ItzXyers/Rocketry/Ejection System T5/Models/check_report_v4.txt

== T5 v4 spring-piston ejector check report ==
Stations (module z -> Phoenix station): bulkhead bottom z -3.5 -> 174.5, aft face z 0 -> 171.0, flange top z 14 -> 157.0, piston top cocked z 61.0 -> 110.0, RBF pin z 64.5 -> 106.5
PASS all printed solids and hardware valid
PASS rod/base overlap is only the M5 self-tap engagement (6.6 mm3, z 9.7-11.0)
PASS interference, flight cocked (pin in): none
PASS interference, flight fired: none
PASS interference, bench cocking (stand, tool held by lock pin): none
PASS interference, bench cocked (stand, RBF pin): none
PASS install tool slides through piston notches at the fired position: yes
PASS tool prongs reach the flange key notches when the face is on the cocked piston (31.4 mm3 in notches)
PASS piston running radius 19.25 <= 19.50
PASS static radii: bulkhead 19.85, flange 18.25 <= 19.85
PASS piston skirt L/D = 0.47 (>= 0.45, anti-cocking; v4 lowered from 0.5 for the 10 mm skirt)
PASS spring length cocked 45.00 (= 45), end of stroke 85.00 (<= free 85)
NOTE spring guidance: the M5 rod does NOT guide a 15.5 OD spring (its ID is far larger than 5); only the seats capture the ends (3 + 3 mm). L/D free 5.5, cocked 2.9: stable for ground ends clamped in seats below ~5.2 free. Bench-check for bowing; a printed guide sleeve over the rod is the fix.
PASS rod top clears piston underside when cocked by 3.5 mm
Stroke stop: Kevlar tether, taut at 41.5 mm (stroke 40 + 1.5). Cut to length on the bench (README).
PASS line loop path (base holes, piston through-holes, face groove) is open: clear
PASS all four line holes are straight Ø3.0 through-holes (a stiff leader goes straight through each): yes
PASS face groove 1.5 deep x 3.0 wide joins the two piston holes; the line stays 1.00 mm below the face (RBF pin / tool face never touch it): open
PASS line to spring coils (spring OD 15.5), line against the inboard hole edge: 2.25 mm (>= 2.0)
PASS line to spring coils (spring OD 16.0), line against the inboard hole edge: 2.00 mm (>= 2.0)
PASS spring pocket in the base: Ø16.5 x 3.0 deep (piston: Ø16.5 x 3.0); floor over the M5 head pocket 1.30 mm (>= 1.2)
PASS plastic web between line hole (incl. 0.6 edge round) and spring seat/counterbore: 1.15 mm (>= 1.0)
PASS coil on run +1's straight part (hole -> knot), 5.8 mm from the hole, ends clear of the hole mouth and the knot: the nichrome carries no line load
PASS chamber run +1 clears the M2 heads by 0.90 mm (>= 0.5, nearest nterm2)
PASS chamber run -1 clears the M2 heads by 5.26 mm (>= 0.5, nearest nterm2)
PASS coil (OD 2.0 x 5.0 along the line) to nearest plastic: 2.10 mm (>= 2.0)
PASS coil to nearest steel: 1.07 mm (>= 0.5, nearest nterm2)
PASS coil to the nichrome terminal heads: 1.11, 1.07 mm (>= 1.0: a turn touching a head would short part of the coil)
PASS pole 1 to pole 2 (terminal heads + 0.5 mm wrap allowance, tails): 4.21 mm (>= 2.0, the full burn voltage sits across it)
PASS M2 x 6 nterm1: pilot open 0.5 mm past the tip (z 12.0), so the head seats (0.000 mm3 in the way)
PASS M2 x 6 nterm2: pilot open 0.5 mm past the tip (z 12.0), so the head seats (0.000 mm3 in the way)
PASS M2 x 8 eterm1: pilot open 0.5 mm past the tip (z 10.0), so the head seats (0.000 mm3 in the way)
PASS M2 x 8 eterm2: pilot open 0.5 mm past the tip (z 10.0), so the head seats (0.000 mm3 in the way)
PASS nichrome tail 1 (1.6 mm, from 0.5 mm past its head) to plastic 1.81 mm (>= 1.0), to other steel 3.63 mm (>= 0.5, nearest rod)
PASS nichrome tail 2 (1.3 mm, from 0.5 mm past its head) to plastic 1.28 mm (>= 1.0), to other steel 3.74 mm (>= 0.5, nearest rod)
Coil centre (7.40, -4.10); pocket 9.2 x 6.2 mm, 2.8 mm deep into the ceiling; nichrome terminals at (6.55, 0.71) and (6.20, -9.55)
PASS nichrome terminal heads bear on solid ceiling beside the pocket (62%, 64%; >= 50%)
PASS cut at the coil: the free end pays out 41.3 mm more than a full stroke needs before it even leaves the piston (>= 10)
PASS knot room at (0.0, -11.5): to M2 heads 3.10 mm (>= 0.5), to the coil 6.47 mm (>= 2.0), to the chamber wall 0.70 mm (>= 0.3)
Line tension (each leg of the loop): 26.4 N at F_max 52.7 N, 105 N at 4x proof. A knot keeps ~50% of line strength, so the line must break at >= 211 N (21 kg): 0.4-0.5 mm Dyneema; 0.3 mm only if 7.3 measures F_max < ~30 N.
PASS all M2 heads inside the chamber wall
PASS M2 heads clear of each other (>= 0.3 mm): yes
PASS M2 heads clear of the line holes: yes
PASS e-bay terminal heads end at z 0.0 (flush with the aft face, station 171.0), nothing aft of them (0.000 mm3): lugs go on from the e-bay side
PASS e-bay terminal heads bear fully on their pillars (100%, 100%)
PASS chamber open to r 6.25 round the axis (8 mm socket reaches the M5 head): 0.000 mm3 in the way
PASS tether knot room: pillars 3.0 mm from the tether hole edge (>= 2.0)
PASS tether hole open through base and piston
PASS RBF pin clears the cocked piston by 1.50 mm and sits in its path (blocks within 1.5 mm of travel)
PASS after the line takes load (piston +0.7 mm) the RBF pin still goes in with 0.80 mm clear (>= 0.5)
PASS bench lock pin holds the tool face at 0.04 mm from the nominal cocked piston top (|d| <= 0.2)
PASS harness passes the piston flat with 2.35 mm radial gap even 25 deg off the +/-y groove (>= harness 1.5 + 0.3)
PASS RBF pin bending at proof (211 N, span 40): 419 MPa vs 1000 MPa yield (need 1.5x)
PASS T1 coupon engagement at mid-flank: male 35%, female 49%, both 0.0%
PASS T1 base/bulkhead engagement at mid-flank: male 35%, female 49%, both 0.0%
PASS T1 base/stand engagement at mid-flank: male 35%, female 49%, both 0.0%
PASS nothing crosses the e-bay plane: aft-most part at station 174.5 (e-bay / bench joint at 181)
NOTE stack bulkhead-bottom -> piston top = 64.5 mm vs DESIGN 7.8 budget 61 mm (8 bulkhead + 45 spring + 8 piston): +3.5 mm
Masses (PETG solid): base 9.9 g, piston 11.7 g, flight bulkhead 6.8 g; + M5x40 bolt ~7 g, spring (15.5 OD, weigh it), 4x M2 ~1 g
RESULT: ALL PASS (0 FAIL)
