ItzXyers/Rocketry/Ejection System T4/Models/check_report.txt

== T4 CO2 ejector check report ==
Key stations (module frame, z=0 aft face): cartridge base 11.00, seat 63.77, tip 77.00, stop 80.00, cap underside 125.00, cap top 137.00
Needle protrusion below striker face: 5.50 mm (set with the M3 set screw)
PASS all 25 solids valid
PASS interference, stroke 4, cocked: none
PASS interference, stroke 4, fired: none
PASS needle penetrates cartridge at end of stroke (overlap 5.53 mm3)
PASS stroke 4: free run before contact 1.5 mm, cross-hole u=52.50
PASS interference, stroke 7, cocked: none
PASS interference, stroke 7, fired: none
PASS stroke 7: free run before contact 4.5 mm, cross-hole u=49.50
PASS interference, stroke 10, cocked: none
PASS interference, stroke 10, fired: none
PASS stroke 10: free run before contact 7.5 mm, cross-hole u=46.50
PASS thread coupon T1 male/female mesh without overlap (0.000 mm3)
PASS thread coupon T2 male/female mesh without overlap (0.000 mm3)
PASS thread coupon T3 male/female mesh without overlap (0.000 mm3)
PASS T1 coupon thread engagement at mid-flank: male 35%, female 49%, both 0.0%
PASS T2 coupon thread engagement at mid-flank: male 35%, female 45%, both 0.0%
PASS T3 coupon thread engagement at mid-flank: male 35%, female 45%, both 0.0%
PASS T1 body/base thread engagement at mid-flank: male 35%, female 48%, both 0.0%
PASS T1 body/bulkhead thread engagement at mid-flank: male 35%, female 48%, both 0.0%
PASS T2 body/head thread engagement at mid-flank: male 35%, female 46%, both 0.0%
PASS T3 cap/head thread engagement at mid-flank: male 35%, female 45%, both 0.0%
PASS install_tool clears module: yes
PASS cocking_tool clears module: yes
PASS flight bulkhead clears module: yes
PASS install tool fits airframe bore (OD 38.6 < ID 40.0)
PASS module max OD 36.5 fits airframe ID 40.0
PASS install-tool tabs reach into flange notches (tab volume below flange top 33.6 mm3)
PASS line clamp at x=+9.2 has solid material under its washer (98% of annulus)
PASS line clamp at x=-9.2 has solid material under its washer (98% of annulus)
PASS jam nut clears cartridge tip at end of stroke (1.22 mm)
PASS hex-key path from tail top to needle socket is open
PASS release relief slots open through the cap
PASS tail passage through cap is open
PASS needle path head plenum open
PASS cross-hole for stroke 4 is through
PASS cross-hole for stroke 7 is through
PASS cross-hole for stroke 10 is through
PASS vent port open from plenum to outside
PASS cartridge seats on head seat edge (gap 0.009 mm, modelled 0.02 low)
PASS cartridge body radial clearance 0.40 mm
PASS vent area 245 mm2 = 35x a 3.0 mm pierce hole (need >= 20x)
Spring envelope: OD <= 16.0, ID >= 6.6, cavity fired 35.0, cocked 31@s=4, 28@s=7, 25@s=10 (minus spacers/washers)
PASS spring bore (16.6) > spring OD max (16.0) + 0.4
PASS body wall at T2 root = 3.10 mm
PASS head skirt over T2 tap = 2.20 mm
PASS head wall over T3 tap = 2.20 mm
PASS head wall at striker bore = 4.70 mm
PASS body floor under nut = 2.80 mm
PASS tail web between cross-holes = 1.40 mm
Printed masses (PETG, solid): body 23.6 g, head 36.8 g, cap 5.2 g, striker 3.9 g
Module length (aft face -> cap top 137.0, -> tail top cocked 149.0)
Module loaded mass est: printed 69 g + cartridge 28 g + hardware ~6 g + spring ~3-8 g = ~108 g
Cocking screw: M3 x 24 (or longer)
RESULT: ALL PASS (0 FAIL)
