ItzXyers/Rocketry/Electronics/Avionics/avionics_bay_schematic_phoenix40.html

Phoenix ABS 40-43 · Avionics bay

# E-bay schematic, rev G

Date

2026-10-19

Matches

harness as soldered 2026-10-19 · D9aft v11

Firmware

0.2.3+ (internal-flash log, no SW2, no deploy)

Replaces

avionics_wiring.md (2026-08-08)

This is every electrical part on the e-bay harness as soldered on 2026-10-19, and how it connects. The bay is a logging altimeter and fires nothing, because D9aft deploys on the motor ejection charge (no burn wire). There is no power switch: the bay is on whenever the battery's JST-PH lead (J1) is plugged in. The log is written to the Nano's internal flash, so there is no microSD reader, and the Wi-Fi AP comes up at boot, so there is no SW2 button. A divider on A7 reads the battery voltage (only while Wi-Fi is off: A7 is on ADC2, which the radio shares), and the firmware logs it, prints it, and shows it on the pad's Wi-Fi page. The battery charges off the vehicle through J1. Numbered markers point to seven open items, listed below the drawing.

battery and 5 V power path signal / local supply Qwiic cable (4 wires) through the airframe wall resistor with its real 5-band colours, read from the bunched end 1open item, see below

Every ground symbol is the same net: board GND is the battery's negative lead. Nothing switches the battery: the bay runs whenever J1 is plugged in, and the R11/R12 divider alone draws about 0.2 mA, so unplug J1 for transport and storage. The 3V3 rail comes from the Nano's on-board regulator and feeds U4 and U5.

## Open items before first power-up

1. 1

### Buzzer type must match the firmware

  buzzer.cpp holds D9 high or low with no tone generation, so it needs an active buzzer that oscillates on its own. The sled v7/v8 notes describe the module as "KY-006-style", and a KY-006 is usually a passive transducer. Driven with DC it only clicks.
  Check: put 5 V across the module's + and − pins. A steady tone means it is active and fine. A single click means it is passive. In that case, swap in an active module or change buzzer.cpp to drive a 2–4 kHz LEDC tone on D9. If you go the tone route with a plain piezo, also fit a ~1 kΩ resistor across BZ1 (+ to −): otherwise the piezo can't discharge when Q1 turns off, and it plays quietly. Confirm the module pinout too: some KY boards leave the middle pin unconnected.
2. 2

### VIN is 1 V under the Nano's spec

  Carried over as BOM item O1. U2's fixed 5 V feeds VIN, which is rated 6–21 V. Community testing says it runs, but there is no margin. C1 covers the brownout case the August notes required before using the Wi-Fi interface near a loaded vehicle, and with the AP up from every boot that case is now routine.
  If the board resets on flash writes or Wi-Fi bursts, suspect this before the sensor wiring.
3. 3

### The BMP388's first reading after power-up is stale

  On the real board (2026-10-19 bench), the first pressure read after sensors_init() came back as 77 945 Pa and every later read was about 103 556 Pa. Averaged into the 50-sample pad baseline, one such value would shift AGL altitude by about 40 m. In the flight firmware the boot self-test happens to take that first read before the baseline is captured, so it is masked today, but nothing guarantees it.
  In sensors.cpp: discard one read at the start of sensors_capturePadBaseline(), and make sensors_selfTest() fail on a pressure outside about 30–110 kPa. D6 (the old deploy pin) is free; the deploy code was removed in firmware 0.2.3.
4. 4

### Calibrate the battery reading once

  The ESP32-S3 ADC is factory-calibrated, but 1 % resistors and the ADC's gain error can still leave the reading 1–3 % off. That is about 0.1 V, or 10–20 % on the charge estimate near the flat middle of a LiPo curve.
  Flash chips_bench, run BATT, and measure the cell with a multimeter at about 3.9 V. Set BATT_CAL_GAIN in config.h to meter volts ÷ reported volts. The percentage comes from a generic LiPo curve, so trust the voltage more. BATT_LOW_V (3.70 V, about 12 %) flags LOW in the log, on serial and on the pad page. It never touches flight logic.
5. 5

### Check that C1 fits its slot

  Sled v8 had a slot for a ⌀8 × 12 mm capacitor (14 mm with leads), standing in the aft deck. A 470 µF 16 V can is usually ⌀8 × 11.5 mm, but some makers use ⌀10 × 12.5 mm, which won't fit.
  Measure it and give the dimensions to the sled v11 design. Respect the polarity: the stripe marks the − lead, which goes to board GND.
6. 6

### The battery plug is the power switch

  The reed switch, Q3 and R6 are gone. Plugging J1 in starts the bay, and unplugging it is the only way to turn it off, so the bay can't be switched off once sealed unless J1 is reachable. Every boot opens a new log file, logs the pad at 5 Hz, and brings the Wi-Fi AP up.
  Plug J1 in as late as practical before closing the bay, and unplug it after recovery. Keep it unplugged for transport and storage: the divider alone drains about 0.2 mA.
7. 7

### Format the internal flash once, and keep it clear

  The log is FLIGHTnnn.CSV in the Nano's ~9.4 MB FFat partition: about 1.6 MB per hour on the pad and up to about 1.2 MB per flight (including the 200 Hz ascent rows). A brand-new board's partition is unformatted, so its first boot fails self-test. Self-test also fails on purpose when less than 5 MB is free.
  On the USB serial console, send FORMAT YES once on a new board and power-cycle. Before each flight day, run LOGS, pull the files with DUMP n or Wi-Fi GET /log?n=, then DEL n. A normal firmware upload keeps the logs; pio run -t erase wipes them.

## Pin map

Nano pin | Net | Goes to | Notes
VIN | SYS_5V | U2 OUT, C1 +, BZ1 + | No switch: on whenever J1 is plugged in
3V3 | 3V3 | U4, U5 (via Qwiic) | Nano on-board regulator output
GND | GND | Common bus | BT1 −, U2, C1, R12, U4, U5, Q1 E, R2
A7 | PIN_BATT_SENSE | R11/R12 midpoint | ½ × cell voltage. GPIO14 = ADC2, shared with Wi-Fi: read at boot and just before the AP comes up, held while it is up, live again once the radio is off (arm / launch)
A4 / A5 | SDA / SCL | U4 BMP388 0x76, U5 ADXL375 0x53 | Star at the Nano, one Qwiic cable to each board's forward plug (the aft plugs have no room)
D10–D13 | — | free | Was the microSD reader's SPI bus; the log is on internal flash since rev G
D9 | PIN_BUZZER | R1 1 kΩ → Q1 base | R2 10 kΩ base pulldown keeps the buzzer quiet during boot
D7 | — | free | Was SW2; the Wi-Fi AP comes up at boot since rev G
D6 | — | free | Was PIN_DEPLOY; the deploy channel was removed in firmware 0.2.3 (D9aft fires nothing)
D2 / D3 | Serial1 RX / TX | not connected | Reserved for a future GPS
D4 / D5 | — | free

## Resistors from your stock

All four are 1 % metal-film, 5-band parts. Photo numbers refer to your set of resistor photos. Measure each one before soldering. 10 kΩ and 100 kΩ differ only in the fourth band (red vs orange). You need three 10 kΩ (R2, R11, R12). R1 is 1 kΩ, which you don't have yet. R3 and R6 left with SW2 and the reed switch in rev G.

Ref | Value | Bands | Photo | Job
R1 | 1 kΩ | brown · black · black · brown · brown | — | Q1 base resistor (D9). Not in your stock (photo 3 is 110 Ω): buy one, or use the 330 Ω (photo 7) meanwhile, about 8 mA from D9
R2 | 10 kΩ | brown · black · black · red · brown | 6 | Q1 base pulldown
R11 | 10 kΩ | brown · black · black · red · brown | 6 | Battery divider, top
R12 | 10 kΩ | brown · black · black · red · brown | 6 | Battery divider, bottom

Not used in this bay: photos 1 & 5 (56 kΩ, measure to confirm), 2 (100 Ω), 3 (110 Ω), 8 (220 Ω, the old R1). Photo 7 (330 Ω) is only R1's stand-in. Its bands also read as 100 kΩ from the other end, so measure it.

## Parts on the sled

Ref | Part | Sled v8 location
BT1 | EEMB LP852040 1S LiPo, 620 mAh | Battery tray, opens outboard, one zip tie
J1 | JST-PH 2-pin (battery lead) | Forward end of the tray
R11, R12 | 2 × 10 kΩ 1 % (photo 6) | Inline on the A7 lead in heat-shrink
U2 | Pololu S7V8F5 | Aft deck, central bay floor
C1 | 470 µF 16 V electrolytic (from your stock) | Aft deck, central bay south. Measure it for sled v11 (item 5)
U1 | Arduino Nano ESP32 (no headers) | Rails + snap catch, USB-C forward
U4 | BMP388 Qwiic | West lane on edge, 2 × M2.5
U5 | ADXL375 (Adafruit 5374) | Grooved rails, inboard of the Nano
BZ1 | Piezo module: S → SYS_5V, − → Q1 collector, middle pin not connected. The element sits between S and − | Aft deck pocket, can facing the sound port
Q1, R1, R2 | BC337-40 NPN (usually C–B–E, check the datasheet), 1 kΩ, 10 kΩ (photo 6) | Aft deck, central bay south

## What changed in rev G (2026-10-19, harness as soldered)

### Removed

- SW1 reed module, Q3 G75P04T and R6, and the ARM magnet. BATT+ now goes straight from J1 to U2 and the R11/R12 divider. Plugging the battery in is the power switch.
- U6 microSD reader and its card. D10–D13 are free.
- SW2 push button and R3. D7 is free.
- Rev F (a magnet-toggle power latch, on an unmerged branch) is superseded: there is no reed left to toggle.

### Firmware (0.2.1+)

- The log goes to the Nano's internal flash (~9.4 MB FFat partition): one FLIGHTnnn.CSV per boot, 5 Hz on the pad, full rate in flight.
- Logs come off over USB serial (LOGS, DUMP n, DEL n, FORMAT YES) or Wi-Fi (GET /logs, GET /log?n=).
- The Wi-Fi AP comes up at boot and still latches off after /arm or confirmed BOOST.

## What changed in rev C, D and E

### Power switch

- Rev D: Q3 is an AO3401A P-FET on the battery's positive side. R6 holds its gate at BATT+, and the reed pulls it to GND. Board GND is the battery's negative lead again, and the KY-021 wires up with its normal pin labels.
- The battery divider is tapped after Q3 (SW_BATT), so it still draws nothing while the bay is off.
- Rev E: Q3 is a G75P04T (TO-220) instead of the AO3401A. Q1 is a BC337-40 NPN instead of the 2N7000, with R1 raised to 1 kΩ. The KY-021 uses only S and −, with R6 as the pull-up.

### Battery monitor and SW2

- R11/R12 10 kΩ divider into A7 (new firmware module battery.cpp). At 10 kΩ the ADC needs no filter capacitor, and the divider draws about 0.2 mA, only while armed.
- C1 is your 470 µF 16 V part instead of 220 µF. More bulk capacitance only helps against brownouts.
- SW2 is a momentary push button, latched in firmware (hold 1–5 s and release to toggle). No latching switches are needed anywhere in the bay.
- Logged as batt_v in every FLIGHTnnn.CSV row. On /status as batt_voltage_v, batt_percent and batt_low. Shown in the serial STATE output, the bench BATT command, and a Battery row on the LaunchControl pad page.

## What changed since the August diagram

### Removed

- BQ25302 USB-C charger (U3). Sled v8 deleted it and its wall slot. Charge at J1, off the vehicle.
- GPS and its Serial1 link. D2/D3 stay reserved.
- Servo and burn-wire channels. D9aft deploys on the motor charge.

### Added or now drawn

- SW1 reed arming through the wall, switching Q3 + R6 as a load switch (BOM item O2). Removed in rev G.
- SW2 + R3 interlock on D7, which config.h marked "not yet in the schematic" (a button since rev C). Removed in rev G.
- Qwiic wired as a star at the Nano, not a daisy chain.
- Airframe interfaces: static port to U4, sound port to BZ1. The ARM mark over SW1 went with it in rev G.

Sources: PhoenixABS40-43/Avionics/avbay_sled_build_report_v8.txt, …_sled_v8.py, Models/AFT_DEPLOY_D9_DESIGN.md, Electronics/BOM.md, Electronics/Avionics/avionics_wiring.md, firmware/src/config.h, buzzer.cpp, battery.cpp. Two docs still describe the older bay: BOM.md §4 lists the servo as Config B for Phoenix, and avionics_bom.md lists the charger.
