ItzXyers/Rocketry/Ejection System T4/Models/section_cocked.png

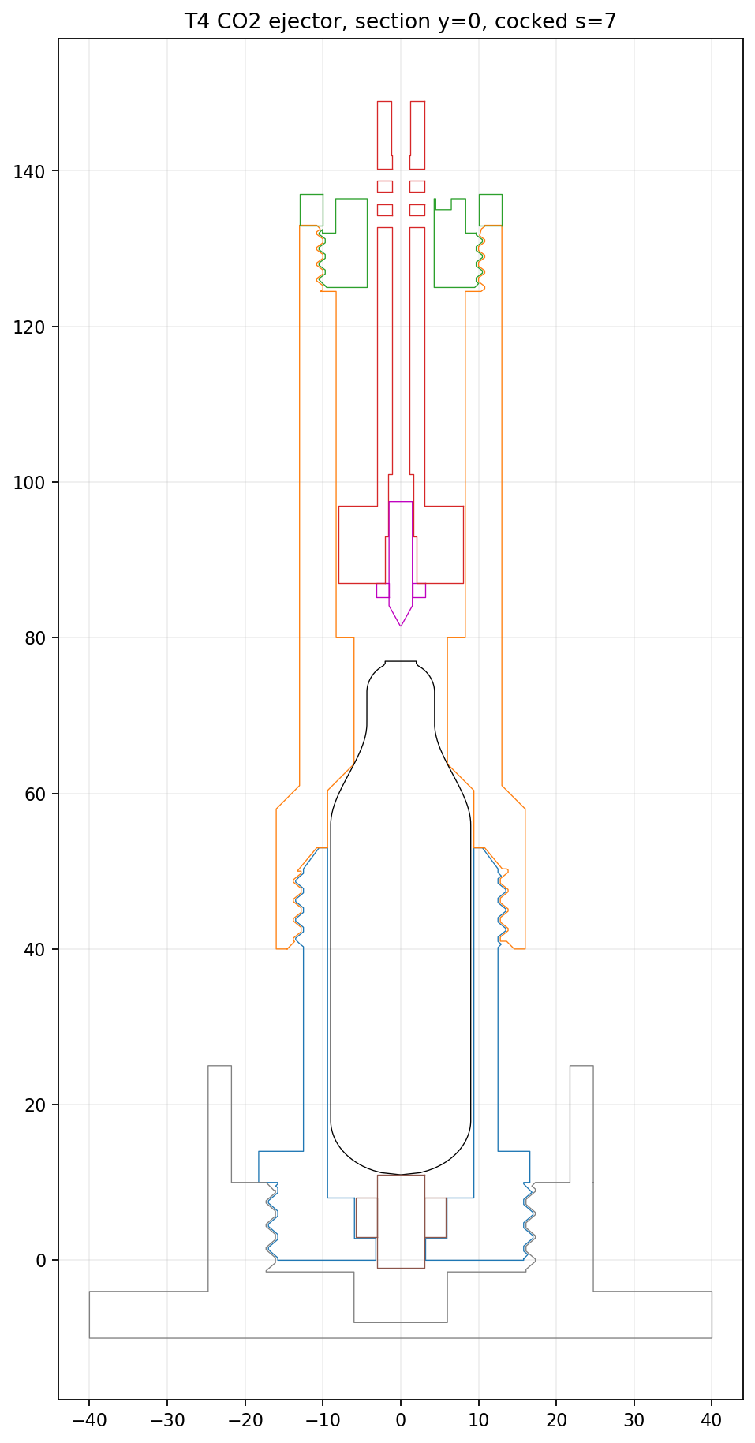
Ejection System T4/Models/section_cocked.png
