ItzXyers/Rocketry/Ejection System T5/Models/section_chamber_plan_v2.png

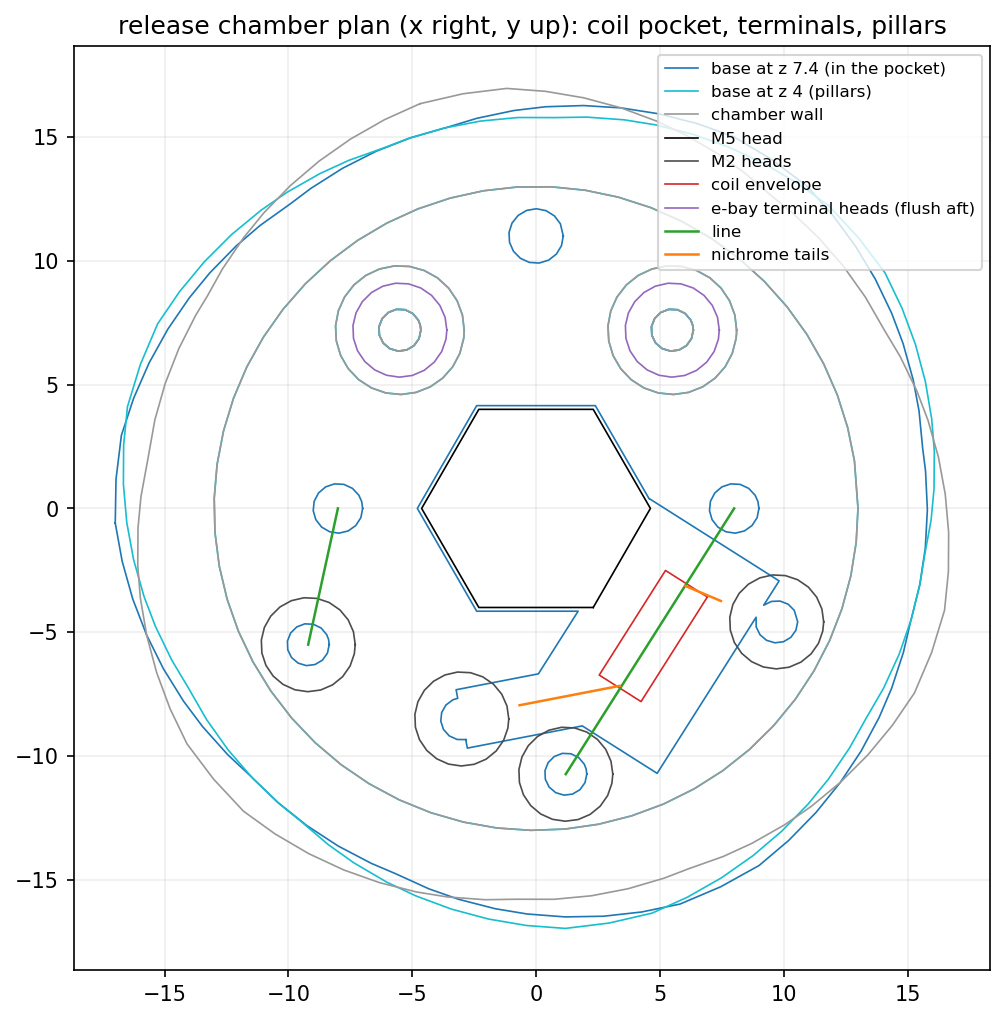
Ejection System T5/Models/section_chamber_plan_v2.png
