ItzXyers/Rocketry/Ejection System T5/Models/section_cocked.png

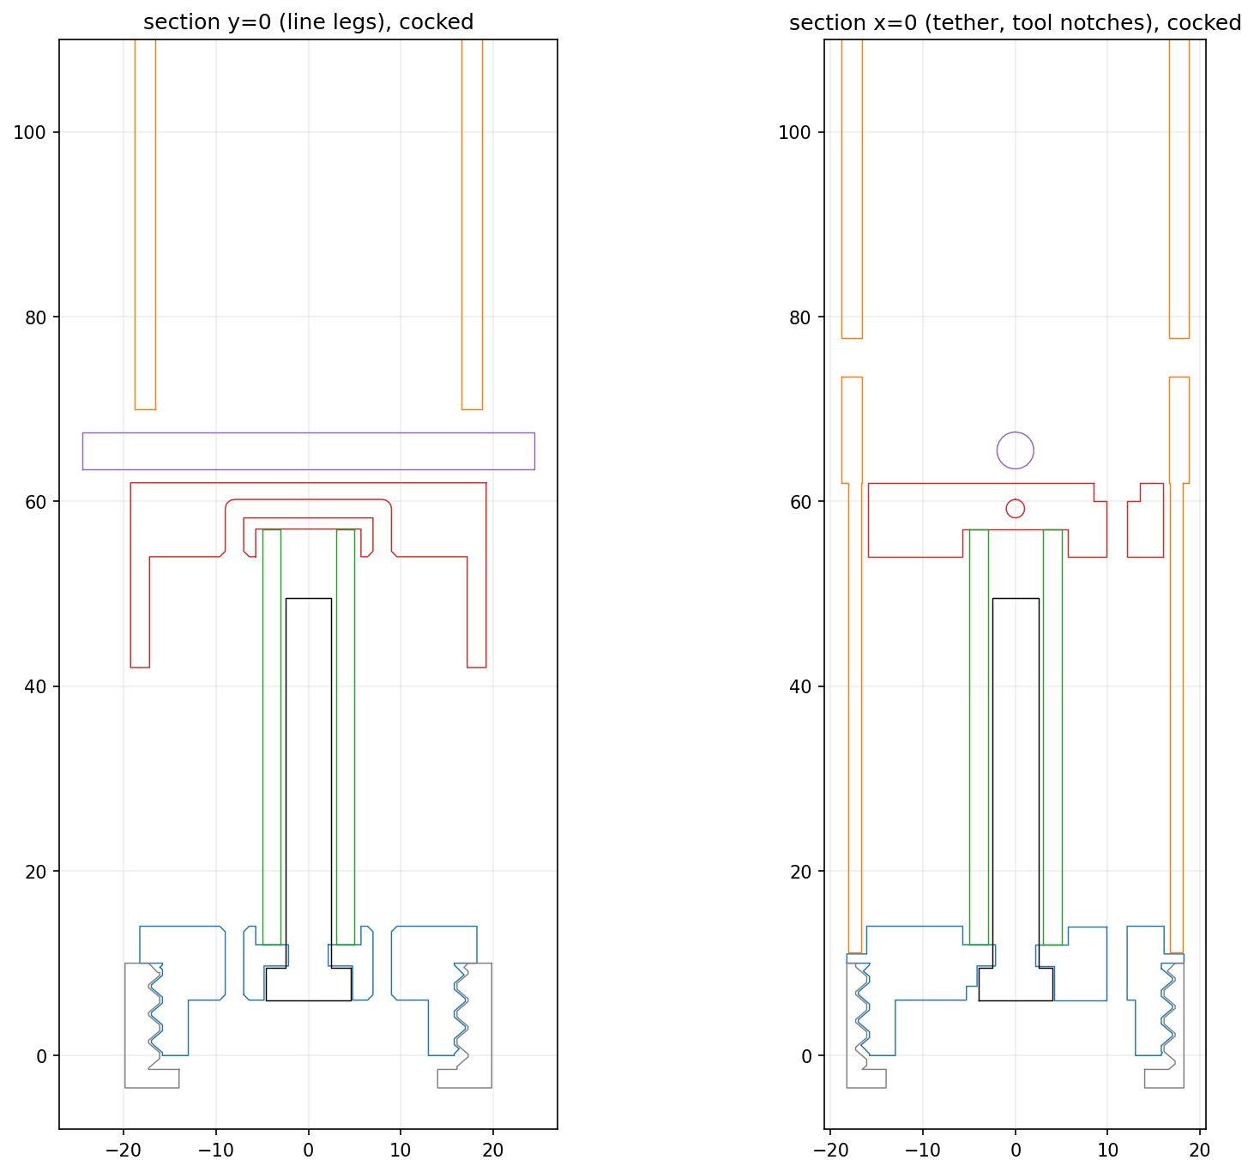
Ejection System T5/Models/section_cocked.png
