ItzXyers/Rocketry/Ejection System T5/Models/t5_integration_section.png

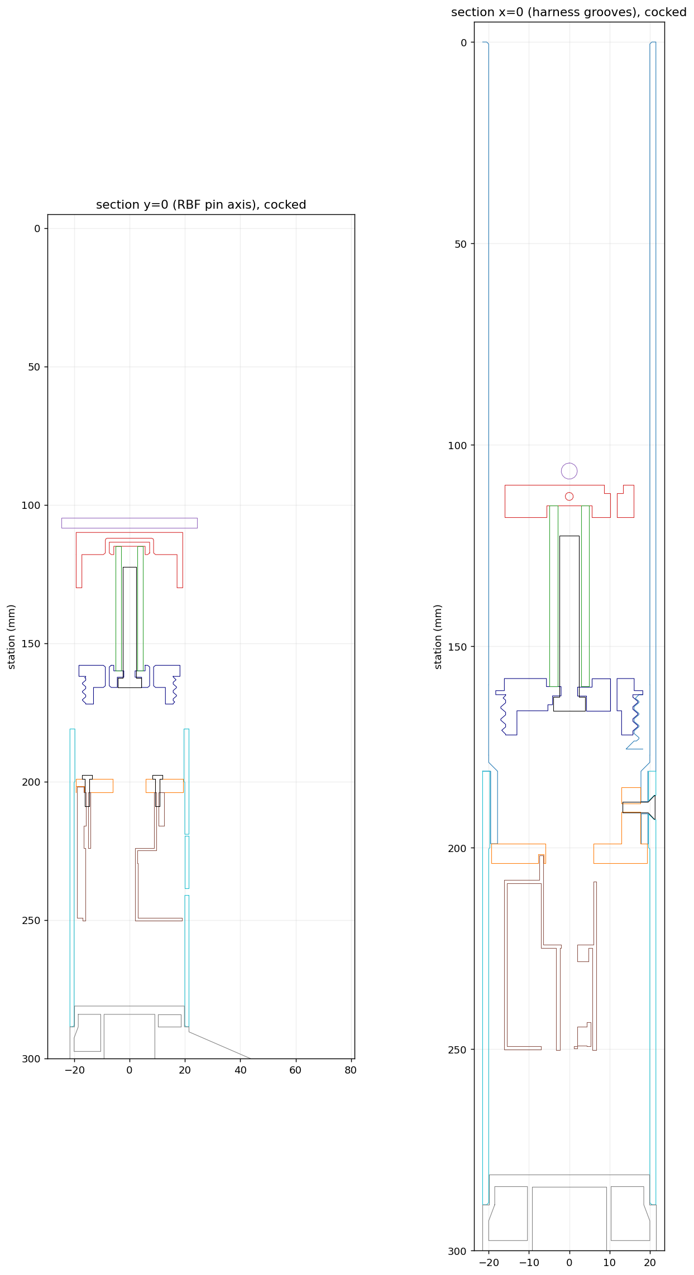
Ejection System T5/Models/t5_integration_section.png
