ItzXyers/Rocketry/Electronics/CO2 Deployment/co2_cartridge_8g_preview.png

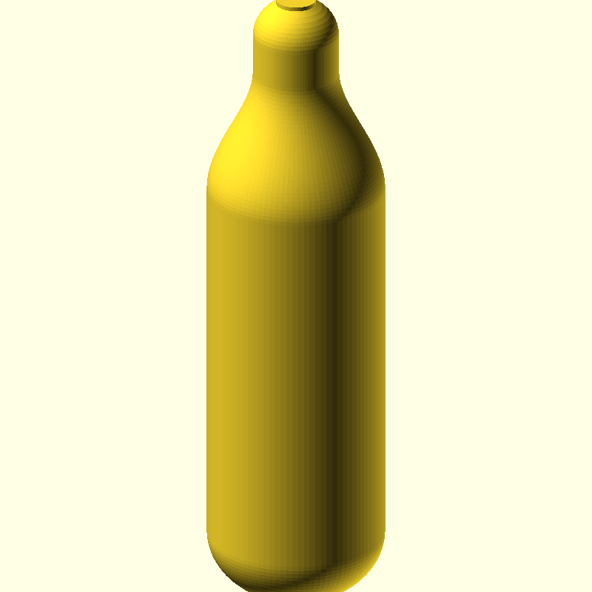
Electronics/CO2 Deployment/co2_cartridge_8g_preview.png
