ItzXyers/Rocketry/PhoenixABS40-43/Avionics/avbay_packing_v1_front.png

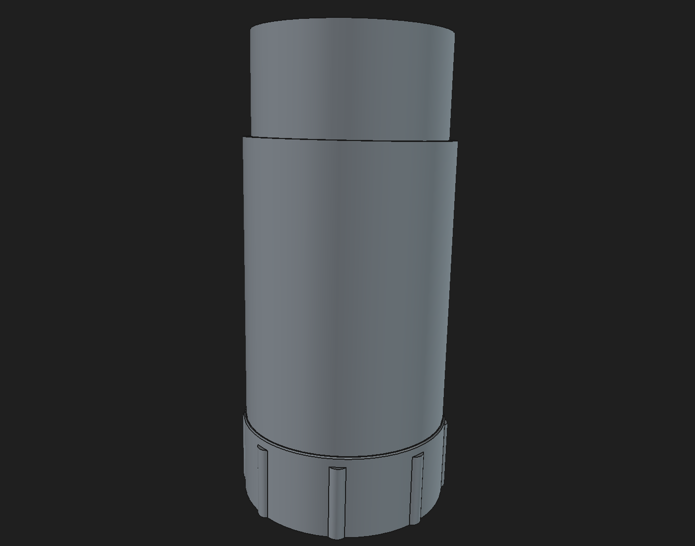
PhoenixABS40-43/Avionics/avbay_packing_v1_front.png
