ItzXyers/Rocketry/PhoenixABS40-43/Avionics/avbay_packing_v1_iso.png

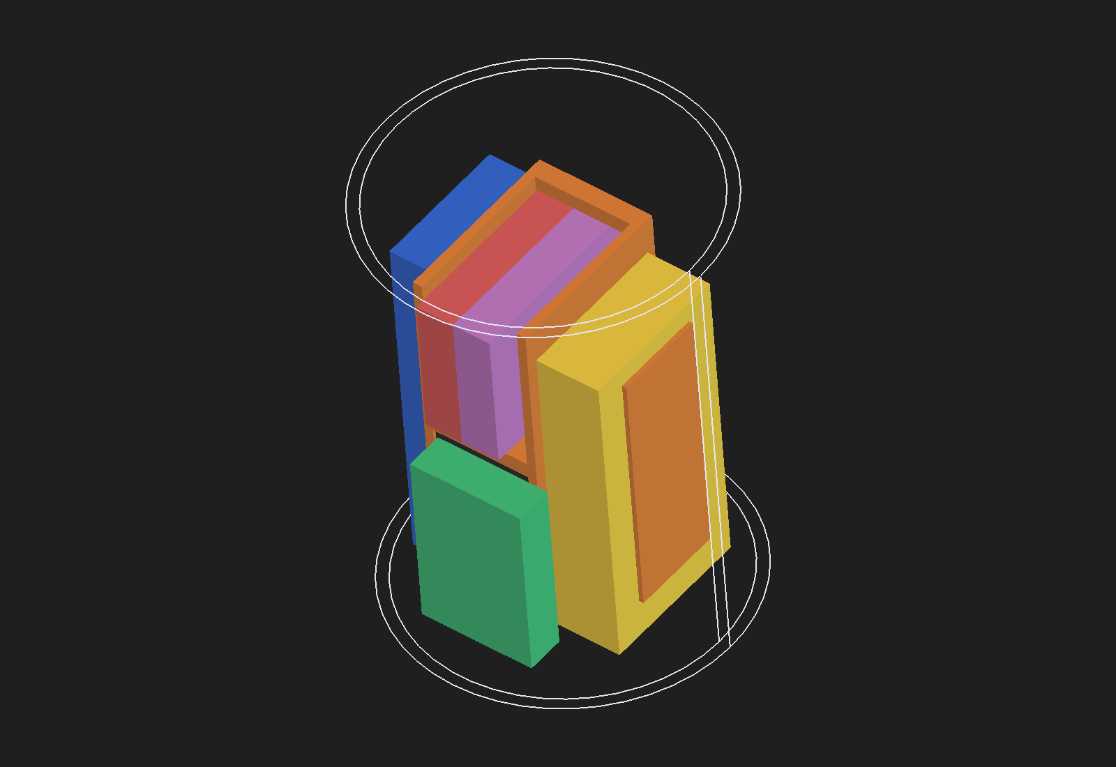
PhoenixABS40-43/Avionics/avbay_packing_v1_iso.png
