ItzXyers/Rocketry/PhoenixABS40-43/Avionics/avbay_packing_v1_side.png

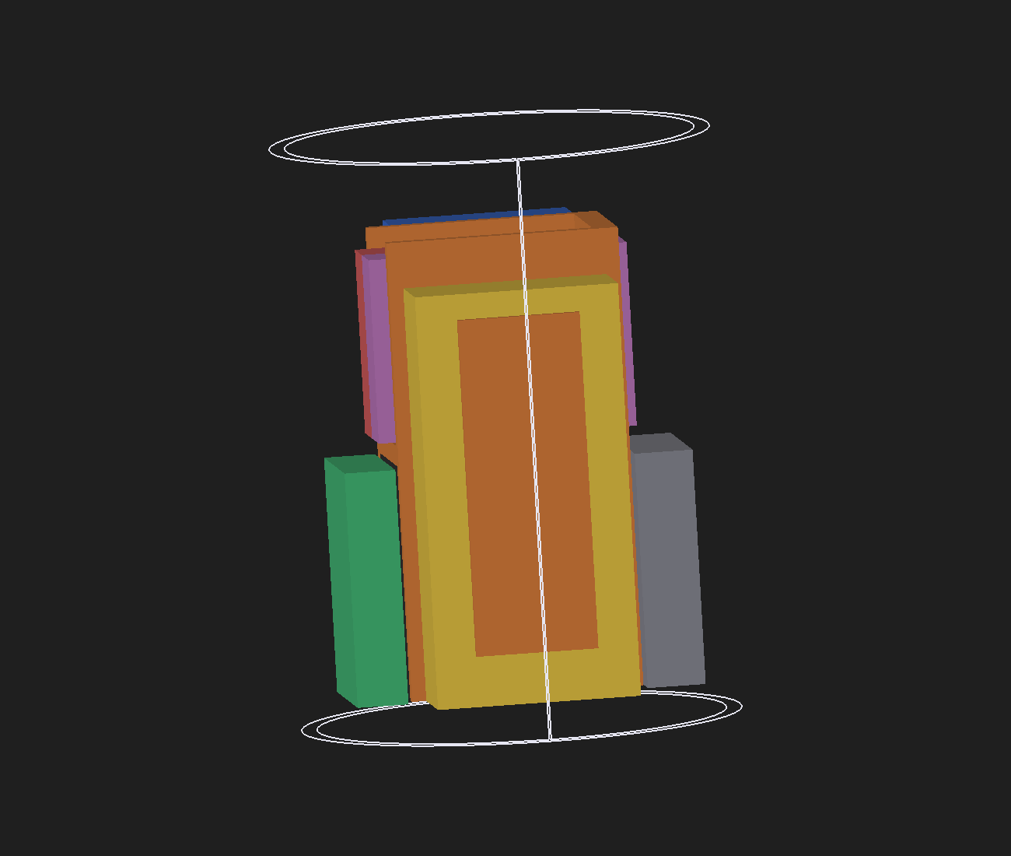
PhoenixABS40-43/Avionics/avbay_packing_v1_side.png
