ItzXyers/Rocketry/PhoenixABS40-43/Avionics/avbay_packing_v2_front.png

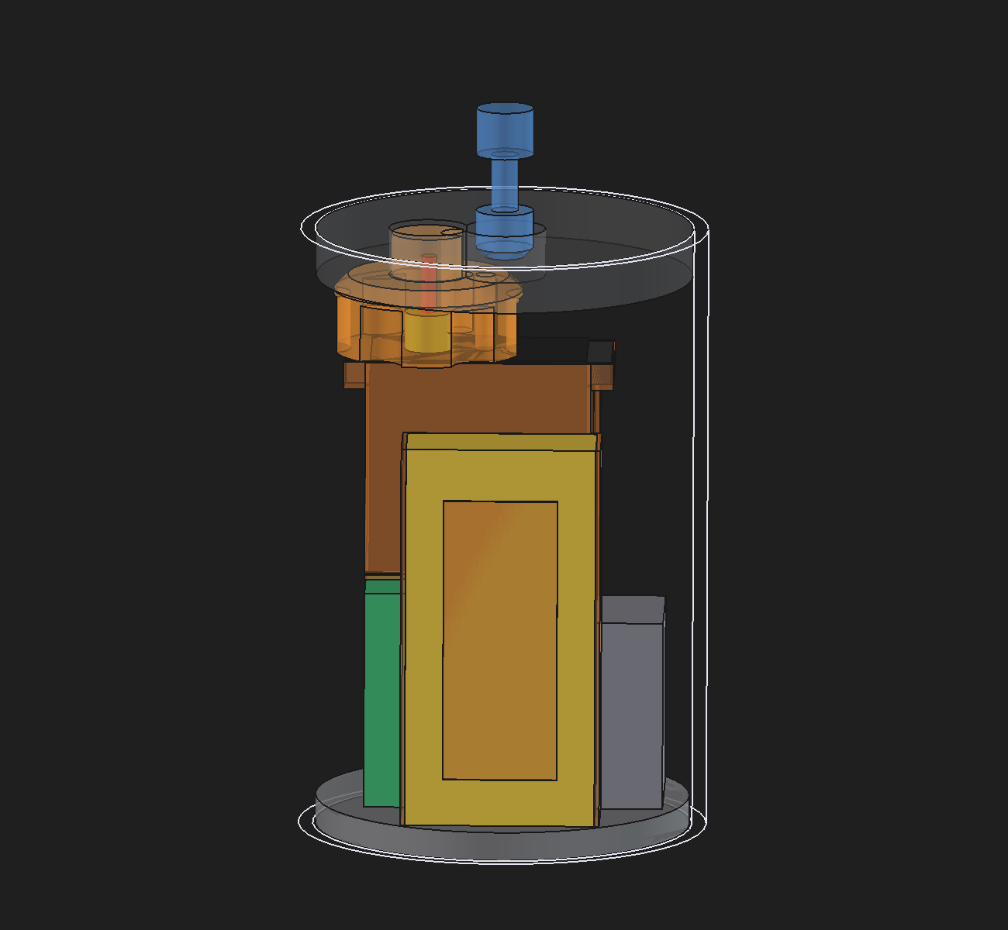
PhoenixABS40-43/Avionics/avbay_packing_v2_front.png
