ItzXyers/Rocketry/PhoenixABS40-43/Avionics/avbay_packing_v2_iso.png

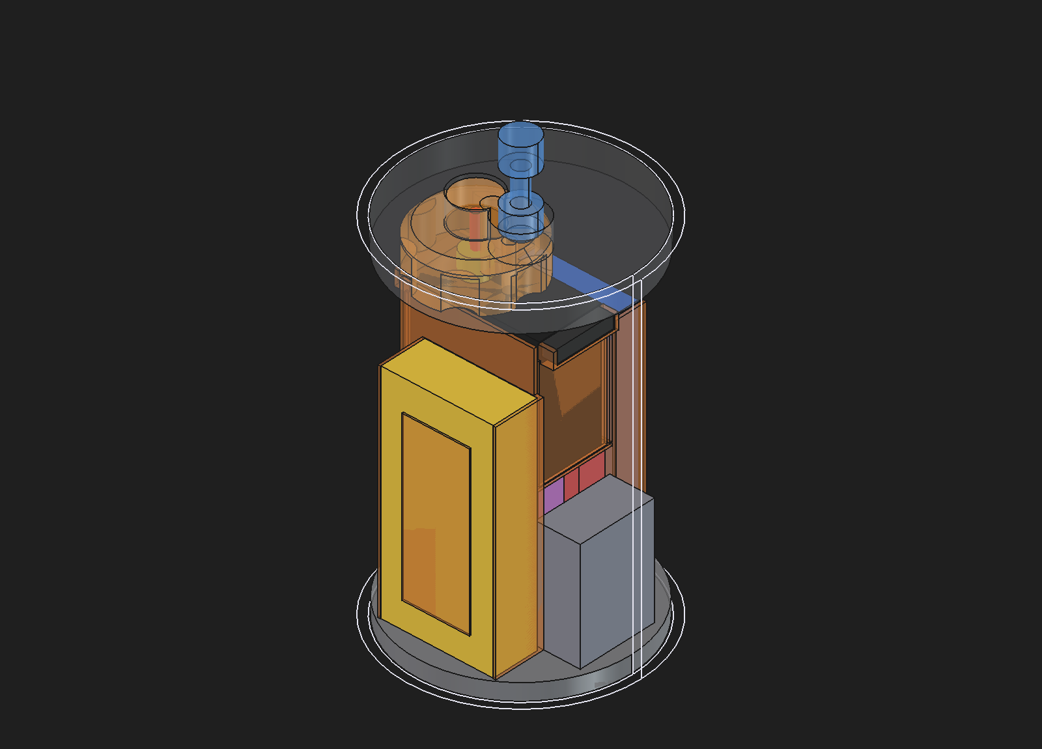
PhoenixABS40-43/Avionics/avbay_packing_v2_iso.png
