ItzXyers/Rocketry/PhoenixABS40-43/Avionics/avbay_packing_v2_side.png

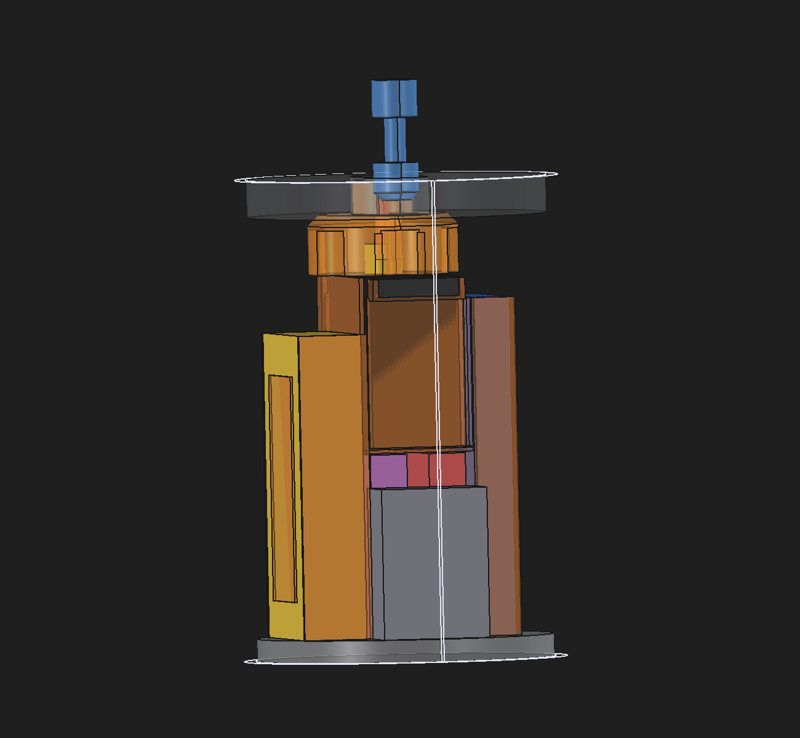
PhoenixABS40-43/Avionics/avbay_packing_v2_side.png
