ItzXyers/Rocketry/PhoenixABS40-43/Avionics/avbay_sled_v3_sections.png

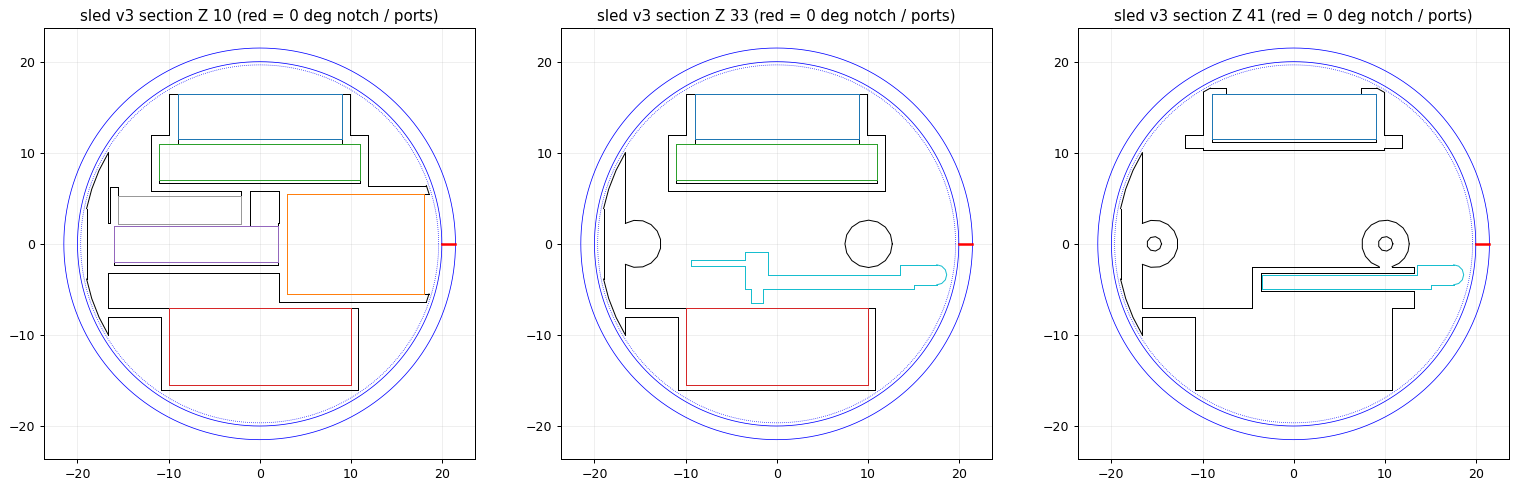
PhoenixABS40-43/Avionics/avbay_sled_v3_sections.png
