ItzXyers/Rocketry/PhoenixABS40-43/Avionics/avbay_sled_v4_sections.png

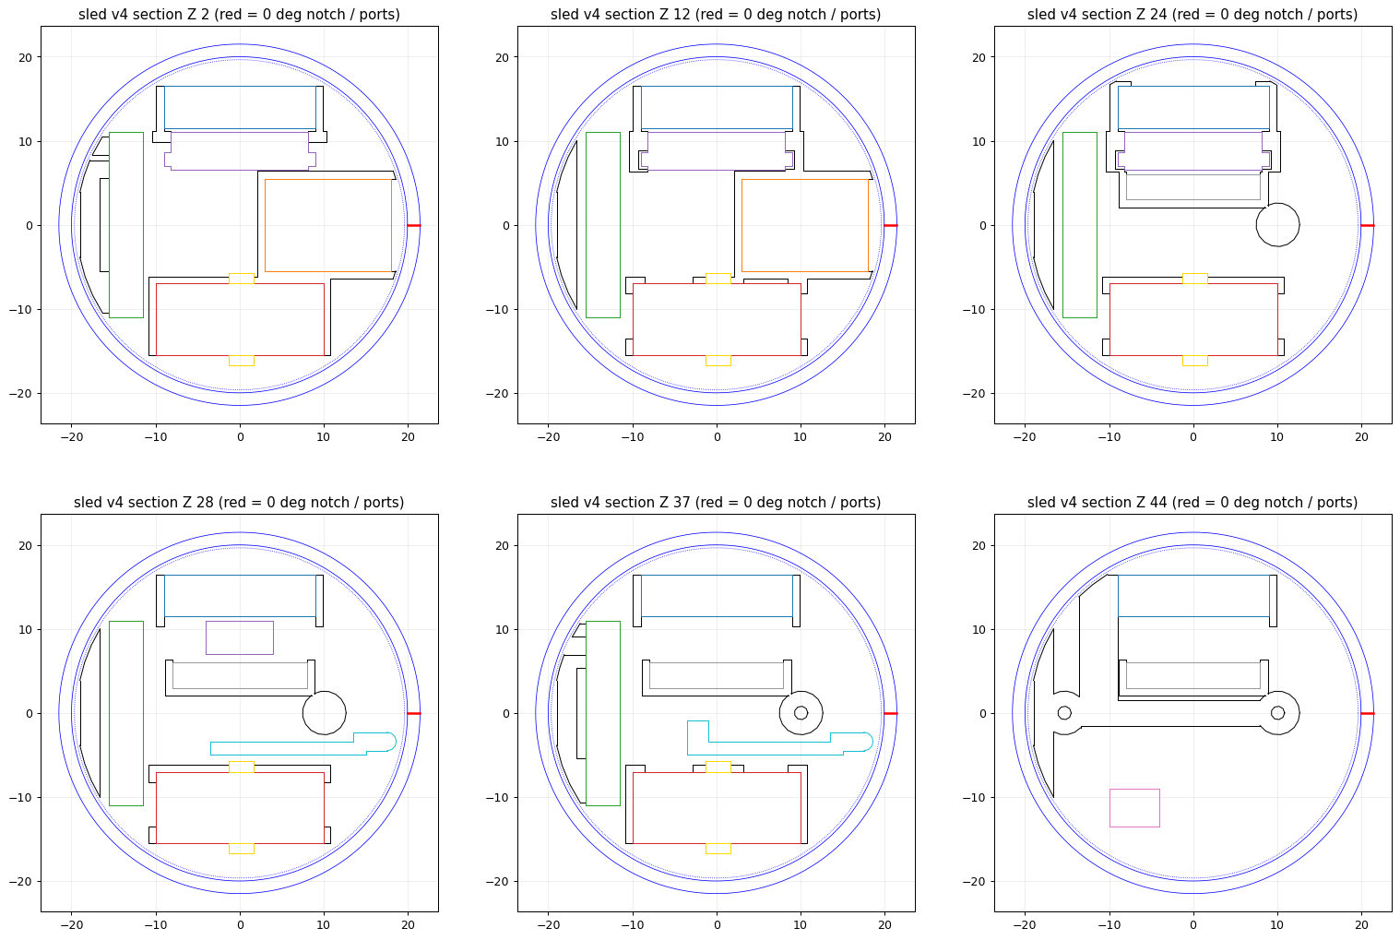
PhoenixABS40-43/Avionics/avbay_sled_v4_sections.png
