ItzXyers/Rocketry/PhoenixABS40-43/brag-output/brag.jpg

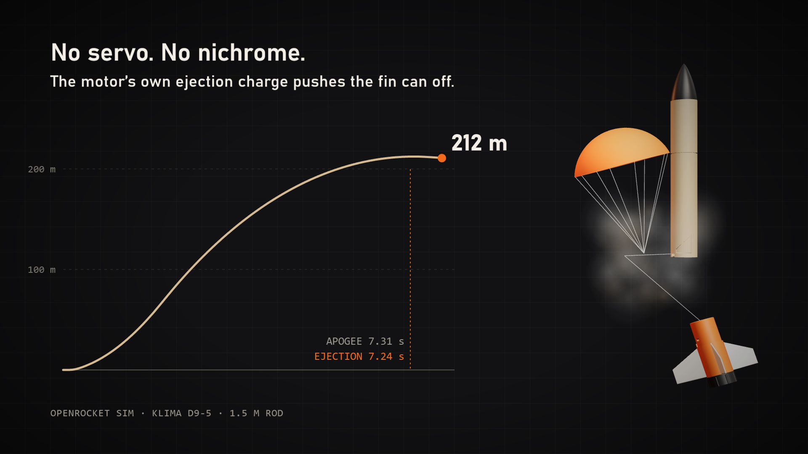
PhoenixABS40-43/brag-output/brag.jpg
