ItzXyers/Rocketry/PhoenixABS40-43/brag-output/work/stills/ang.png

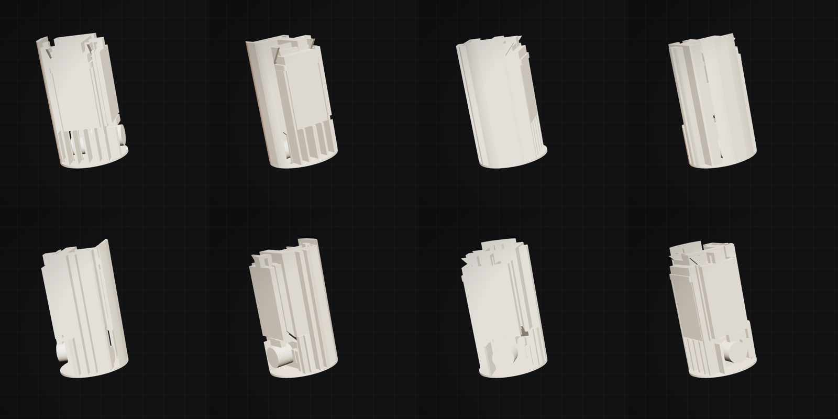
PhoenixABS40-43/brag-output/work/stills/ang.png
