ItzXyers/Rocketry/PhoenixABS40-43/brag-output/work/stills/ang_0.png

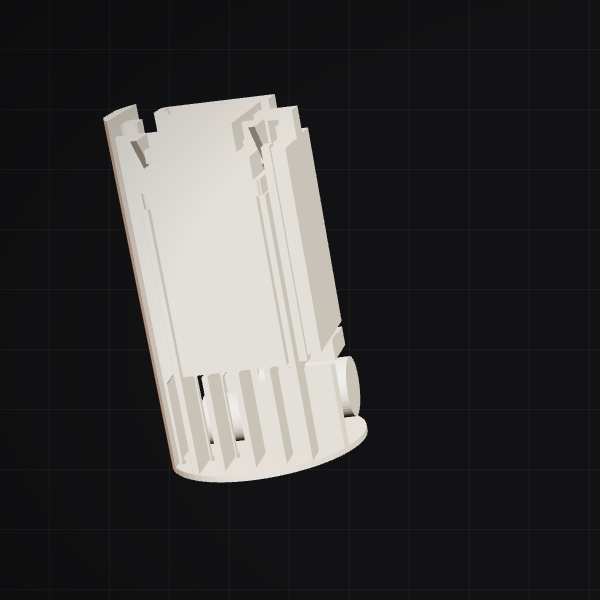
PhoenixABS40-43/brag-output/work/stills/ang_0.png
