ItzXyers/Rocketry/PhoenixABS40-43/brag-output/work/stills/check.png

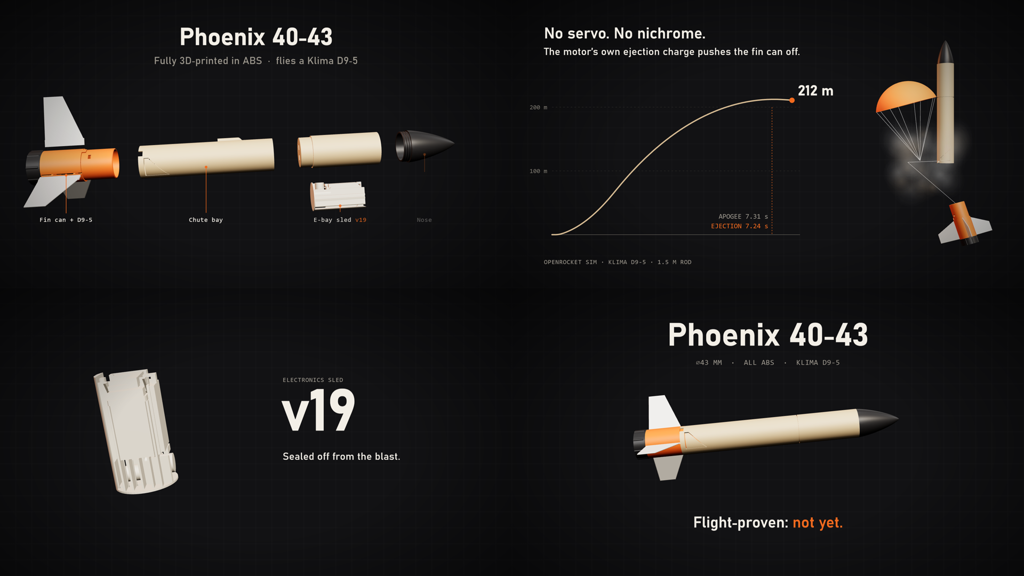
PhoenixABS40-43/brag-output/work/stills/check.png
