ItzXyers/Rocketry/PhoenixABS40-43/brag-output/work/stills/f.png

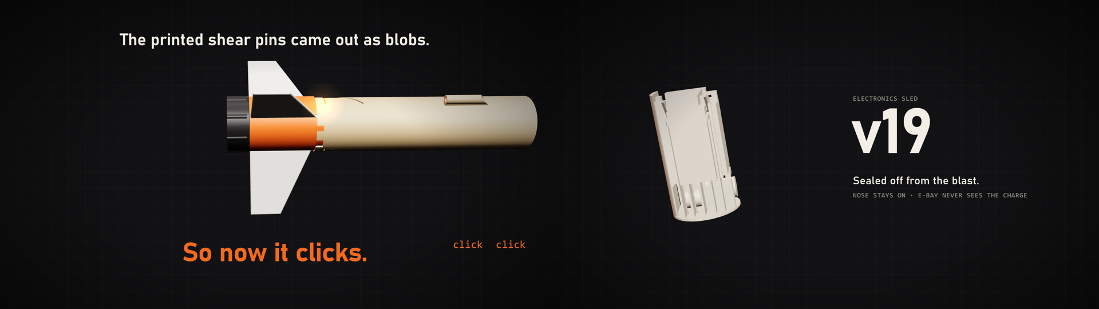
PhoenixABS40-43/brag-output/work/stills/f.png
