ItzXyers/Rocketry/PhoenixABS40-43/brag-output/work/stills/f_13.6.png

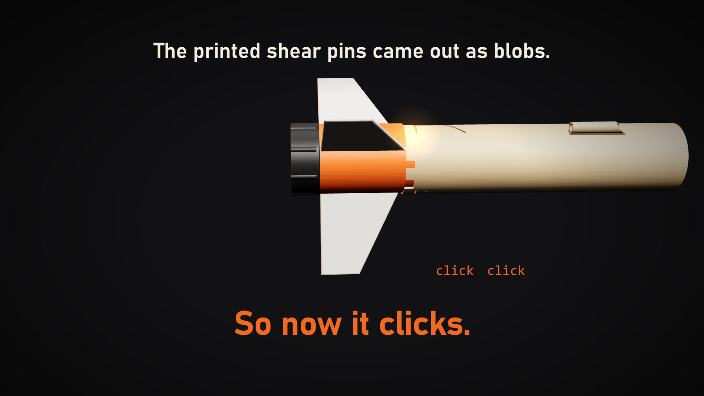
PhoenixABS40-43/brag-output/work/stills/f_13.6.png
