ItzXyers/Rocketry/PhoenixABS40-43/brag-output/work/stills/f_16.8.png

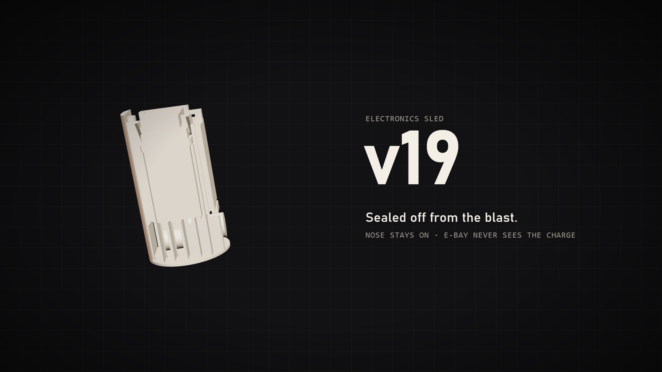
PhoenixABS40-43/brag-output/work/stills/f_16.8.png
