ItzXyers/Rocketry/PhoenixABS40-43/brag-output/work/stills/orig_f0000.png

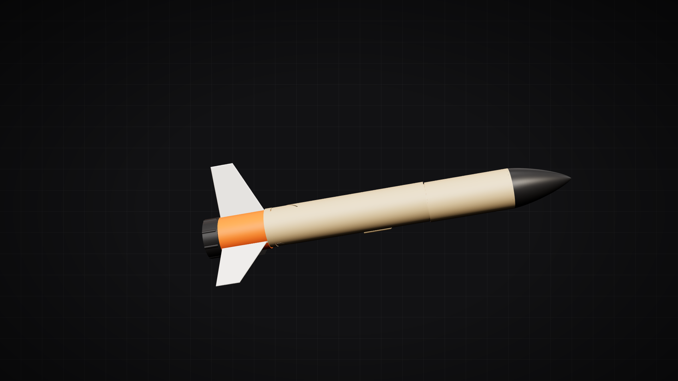
PhoenixABS40-43/brag-output/work/stills/orig_f0000.png
