ItzXyers/Rocketry/PhoenixABS40-43/brag-output/work/stills/s_1.6.png

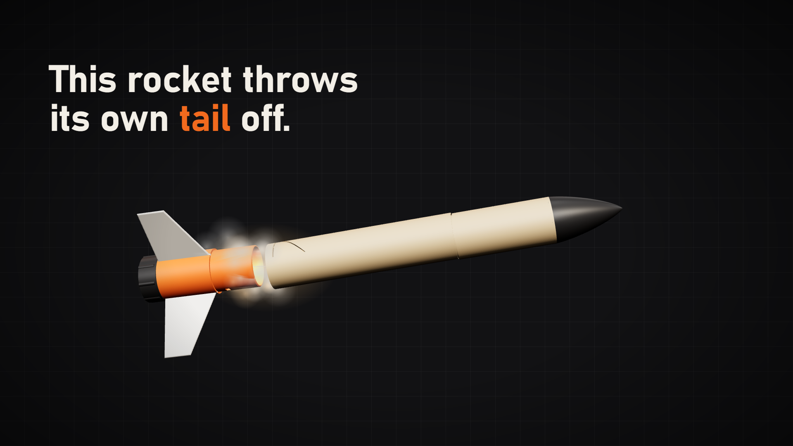
PhoenixABS40-43/brag-output/work/stills/s_1.6.png
