ItzXyers/Rocketry/PhoenixABS40-43/brag-output/work/stills/s_2.0.png

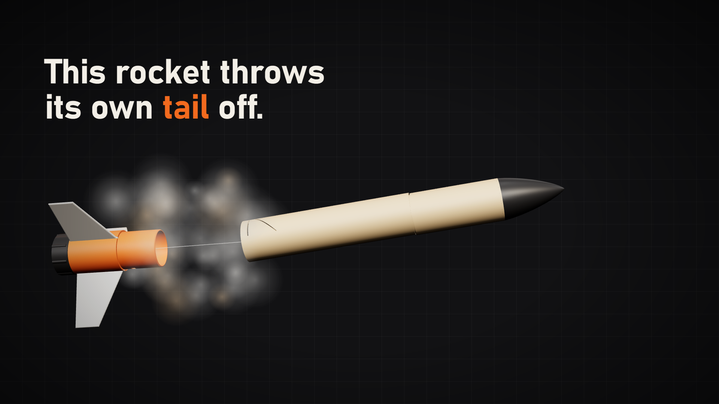
PhoenixABS40-43/brag-output/work/stills/s_2.0.png
