ItzXyers/Rocketry/PhoenixABS40-43/brag-output/work/stills/s_3.1.png

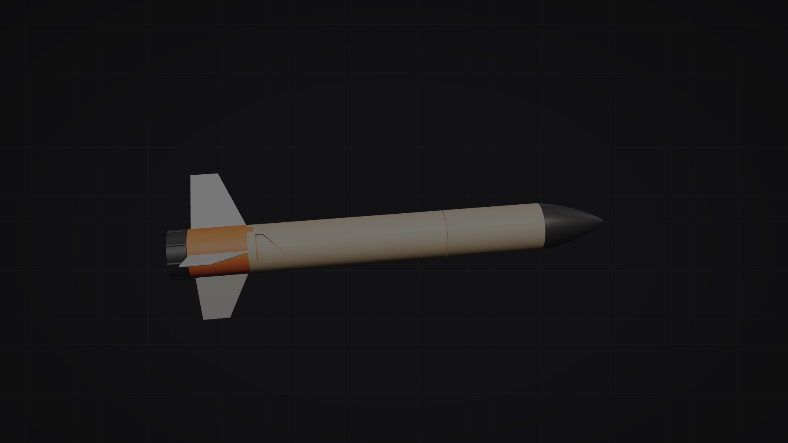
PhoenixABS40-43/brag-output/work/stills/s_3.1.png
