ItzXyers/Rocketry/PhoenixABS40-43/brag-output/work/stills/s_6.8.png

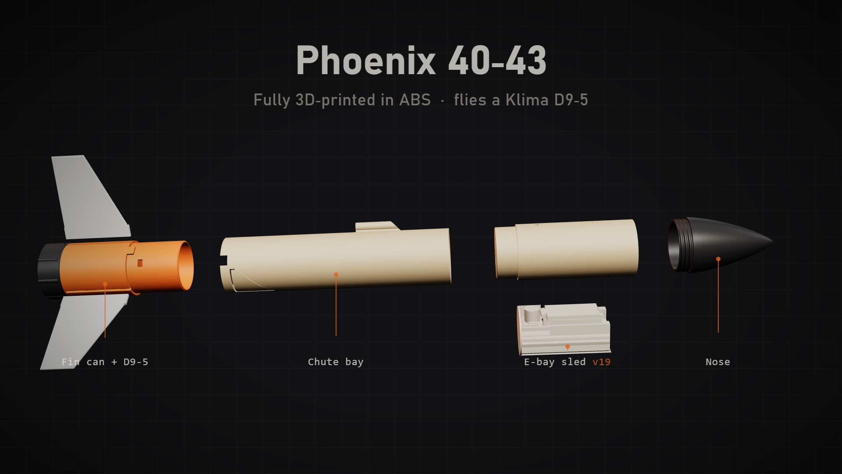
PhoenixABS40-43/brag-output/work/stills/s_6.8.png
