ItzXyers/Rocketry/PhoenixABS40-43/brag-output/work/stills/s_9.0.png

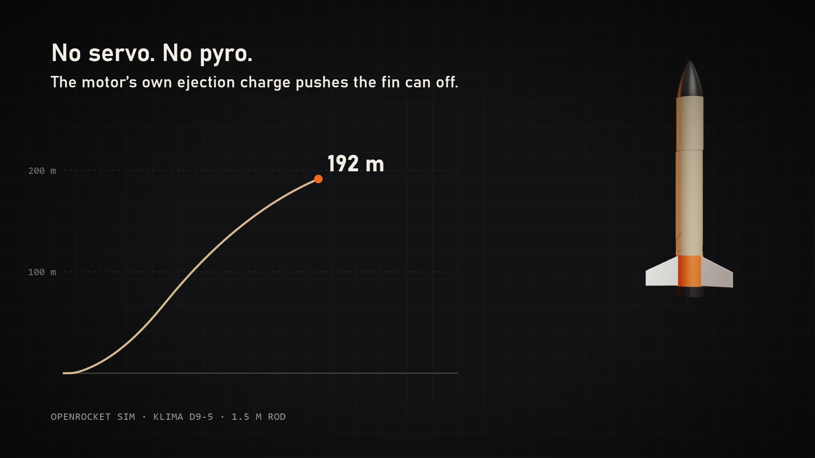
PhoenixABS40-43/brag-output/work/stills/s_9.0.png
