ItzXyers/Rocketry/PhoenixABS40-43/brag-output/work/stills/s_12.3.png

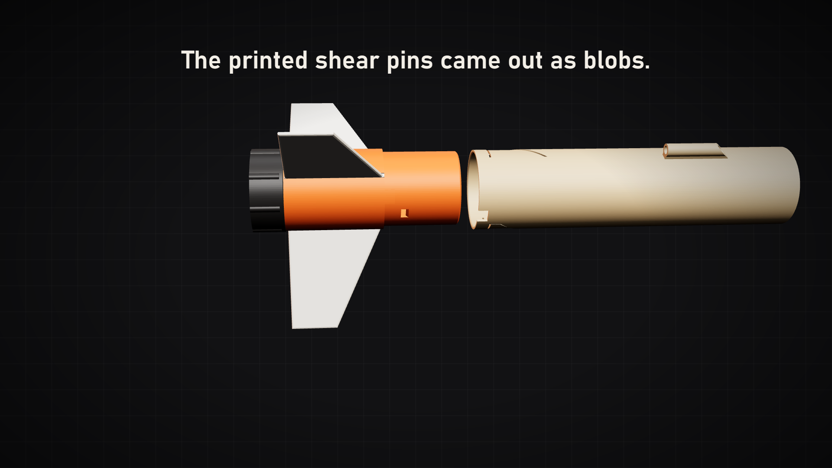
PhoenixABS40-43/brag-output/work/stills/s_12.3.png
