ItzXyers/Rocketry/PhoenixABS40-43/brag-output/work/stills/s_20.5.png

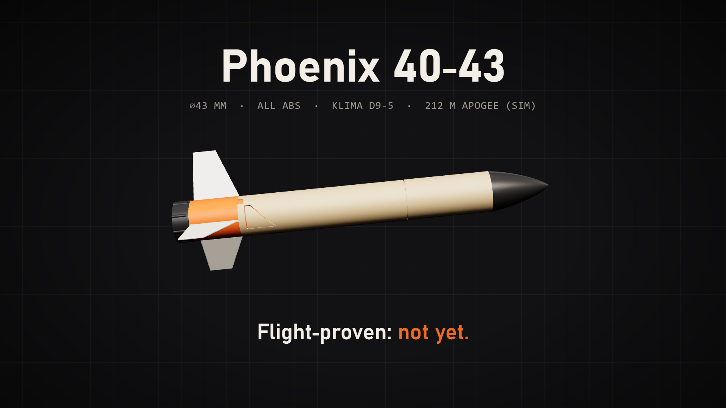
PhoenixABS40-43/brag-output/work/stills/s_20.5.png
