ItzXyers/Rocketry/PhoenixABS40-43/brag-output/work/stills/sheet.png

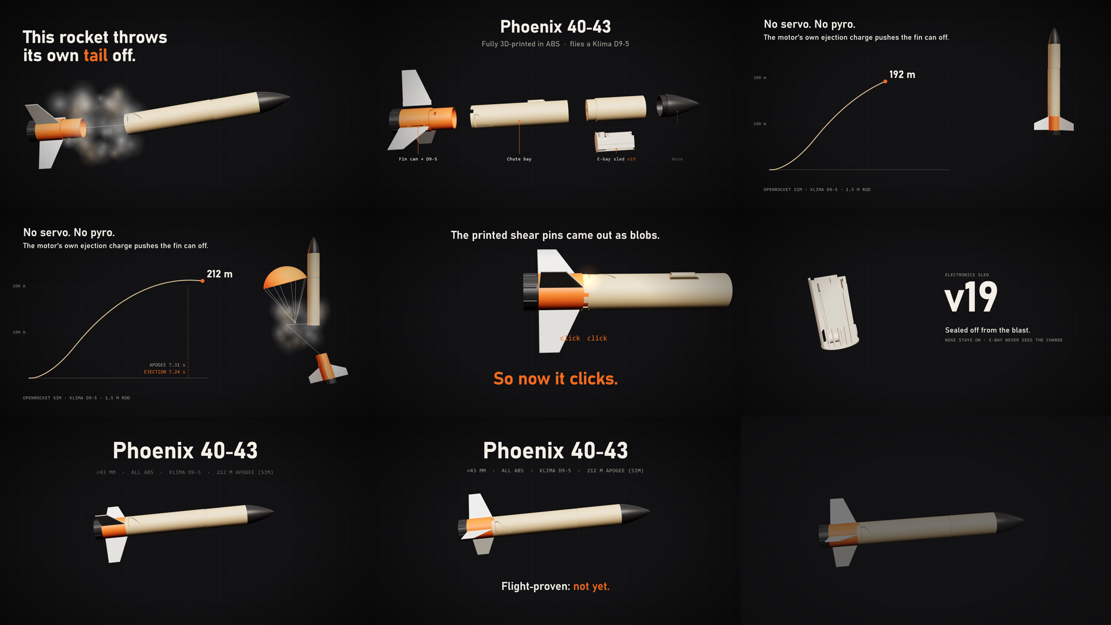
PhoenixABS40-43/brag-output/work/stills/sheet.png
