ItzXyers/Rocketry/PhoenixABS40-43/Models/_render/aft_internals_section.png

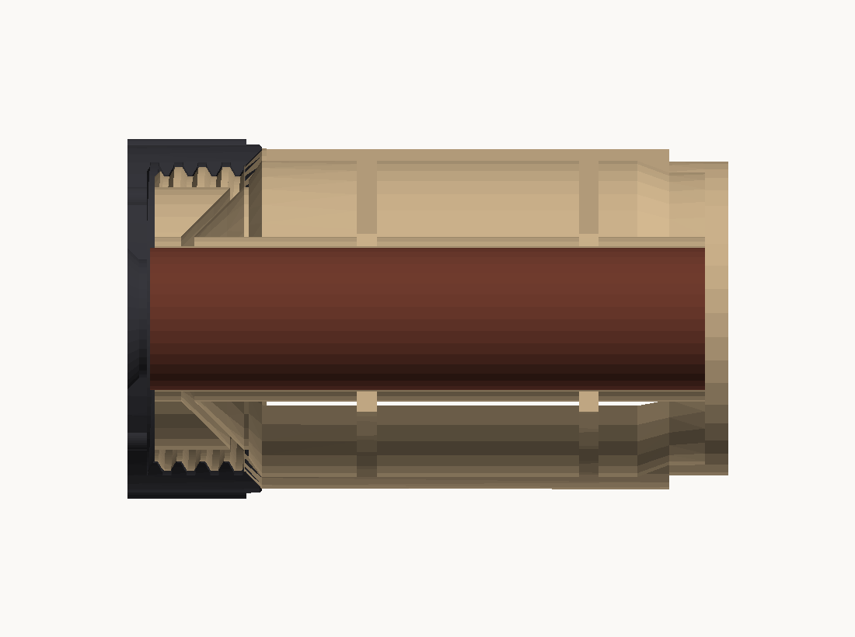
PhoenixABS40-43/Models/_render/aft_internals_section.png
