ItzXyers/Rocketry/PhoenixABS40-43/Models/PhoenixABS40-43_D9aft_v6_section.png

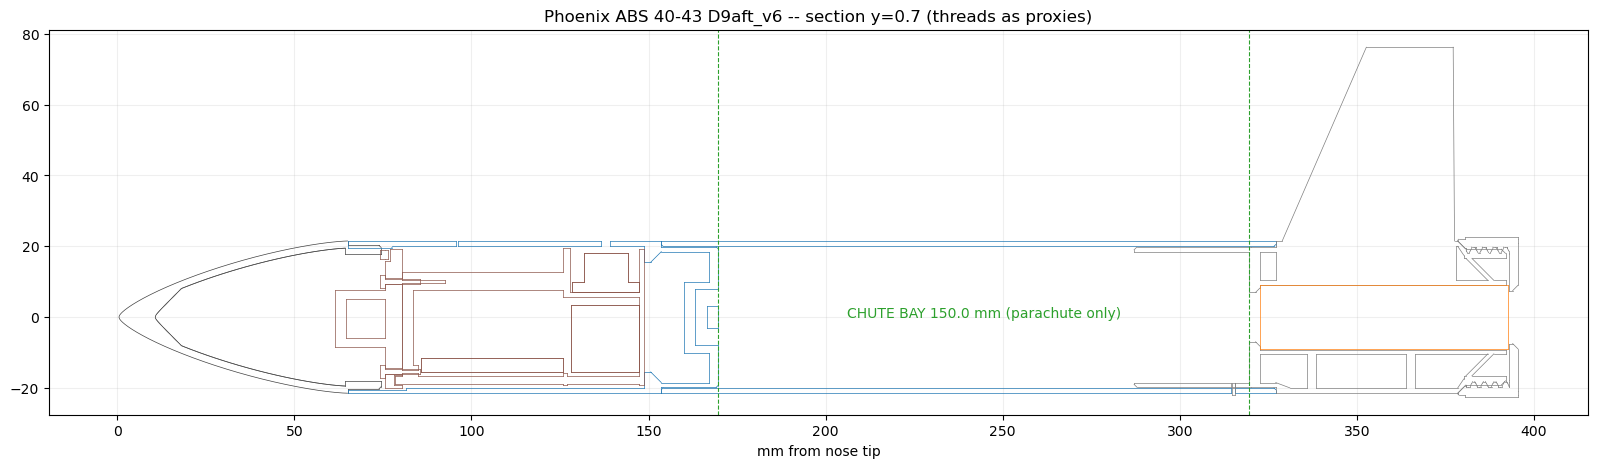
PhoenixABS40-43/Models/PhoenixABS40-43_D9aft_v6_section.png
