ItzXyers/Rocketry/PhoenixABS40-43/Nosecone/Models/PhoenixABS40-43_nose_VonKarman_v5_section.png

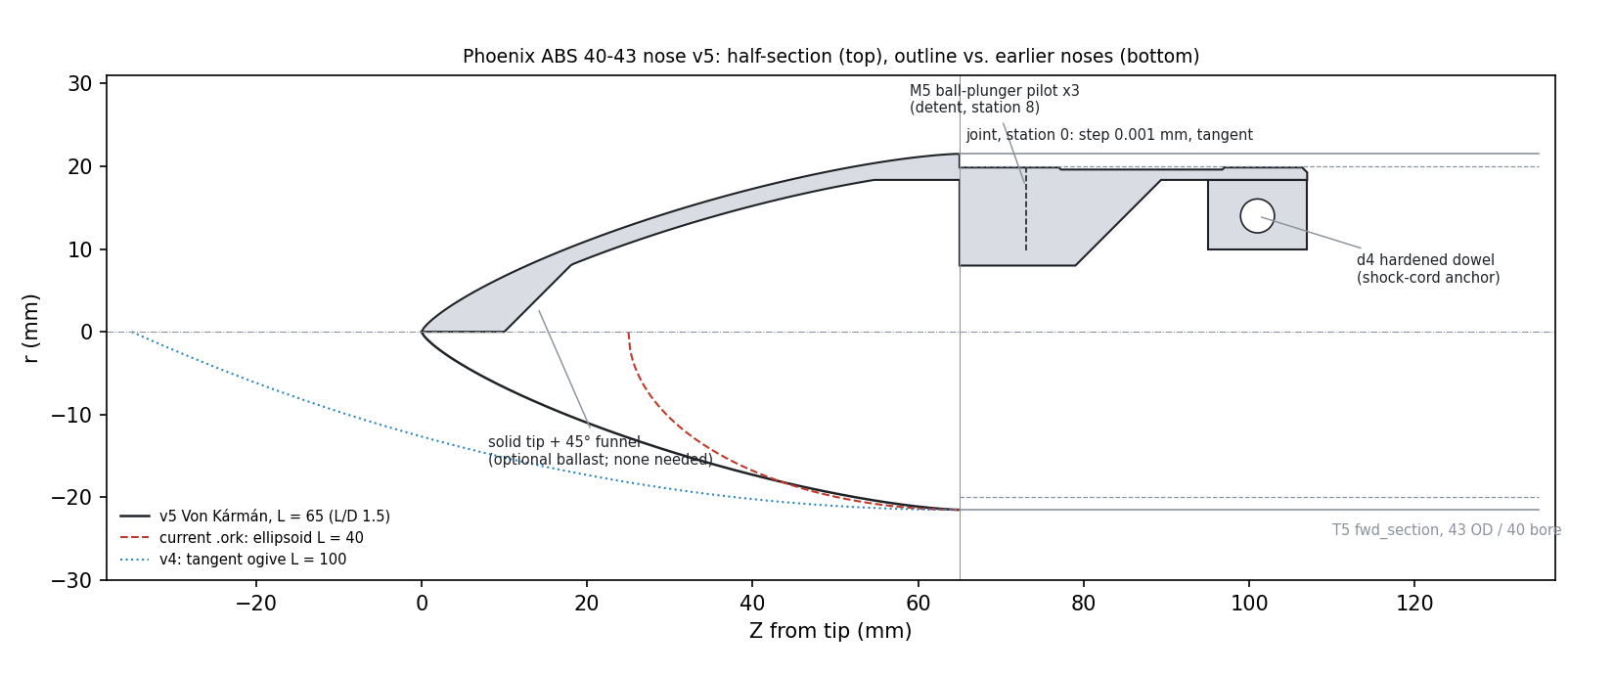
PhoenixABS40-43/Nosecone/Models/PhoenixABS40-43_nose_VonKarman_v5_section.png
