ItzXyers/Rocketry/PhoenixABS40-43/PhoenixABS40-43_D9aft_v6_D9-5_sim.png

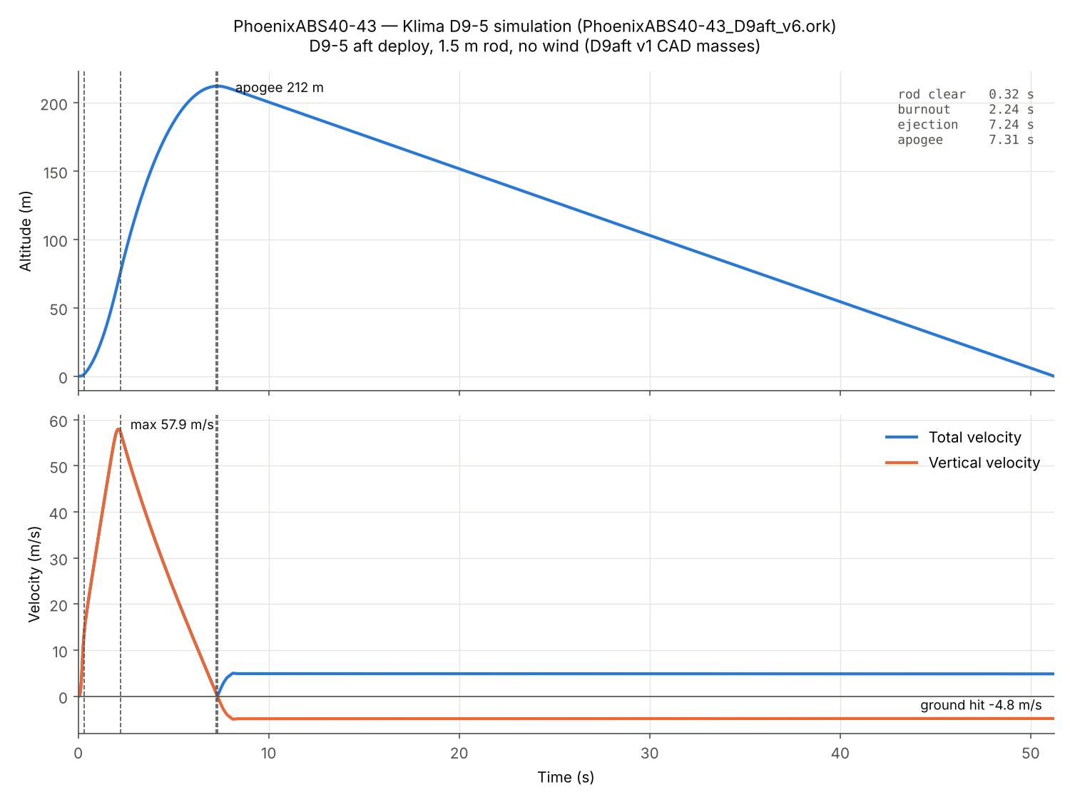
PhoenixABS40-43/PhoenixABS40-43_D9aft_v6_D9-5_sim.png
