ItzXyers/Rocketry/SampleRocketABS33-36/BOM.md

# Bill of Materials — SampleRocketABS33-36

Generated by inspecting the mesh geometry directly (bounding box + enclosed volume) since the project has no FreeCAD assembly, drawings, or notes on disk. Dimensions are envelope (bounding-box) sizes, not toleranced call-outs.

**2026-08-19: avionics bay integrated into this airframe**, along with four
independent airframe fixes (motor bore blockage, tube joint, nosecone
shoulder, open fin slots) found while doing it. Full design rationale,
gas-path routing, static-port sizing, and the mass/CG/stability table are
in [`Design-Notes-AvBayIntegration.md`](Design-Notes-AvBayIntegration.md).

**2026-08-26: dedicated parachute bay added**, 100mm of clear bore sized
for a Ø300mm chute, plus a resize of the reserved CO2 envelope and a
thrust ring re-bore in the motor mount (separate, same-day change). Full
rationale, joint design, and the recomputed mass/CG/stability table (which
now supersedes the one in `Design-Notes-AvBayIntegration.md`) are in
[`Design-Notes-ParachuteBay.md`](Design-Notes-ParachuteBay.md) — **read
that first**; this file only tracks per-part dimensions/mass.

## 3D-Printed Parts (ABS)

| # | Part | Source file | Qty | Envelope (mm) | Solid volume | Est. mass\* | Notes |
|---|---|---|-----|---|---|---|---|
| 1 | Nose Cone | `Print Files/SampleRocketABSNosecone33-36.stl/.obj` | 1 | ⌀35.0 × 70.0 L (shoulder ⌀30.6 × 21.5 L + ogive) | 20.25 cm³ | ~21.1 g | **Hollowed and repositioned 2026-08-19** as part of the avbay integration — see `Design-Notes-AvBayIntegration.md`. Shoulder grown ⌀23→⌀30.6 (was 4mm-under the ⌀31 ID; now 0.2mm radial clearance) and the whole part shifted −21.5mm so the shoulder actually sits inside the tube (Z238.5–260) instead of protruding past it — this is also why overall rocket length dropped from 359.5mm to 308.5mm. Hollowed to a 2mm wall via a plain r13.3 cylindrical cavity (Z238.5–272.5 world), **not a true constant-offset shell all the way to the tip** — FreeCAD's shell operation fails at the ogive's point (OCC offset singularity at sharp apexes), so the last 36mm to the tip (Z272.5–308.5) stays solid by design. That solid tip mass (vs. a naive uniform-shell estimate) turns out to matter for stability — see the design notes' mass/CG table. A separate `Nose_BallastCup` part (below) sits at the top of the cavity for tunable ballast. 4176 facets, 0 open edges, re-verified watertight. **STL added 2026-08-18** (superseded by this pass) — previously only the display `.obj` existed. **Repositioned again 2026-08-26** (see `Design-Notes-ParachuteBay.md`): shifted a further +125mm (Placement.z −21.5→+103.5) to sit forward of the new dedicated parachute bay — shoulder now Z363.5–385, tip Z433.5. Geometry itself is unchanged (still 4176-facet original / re-tessellated to 3488 facets on this pass's re-export, same solid). |
| 2 | Forward Body Tube | `Print Files/SampleRocketABSBody33-36_Fwd.stl` | 1 | ⌀35.0 × 163.5 L (+ launch lug, protrudes ~5 mm past OD) | 31.25 cm³ | ~32.5 g | Mates to Aft Body Tube. Integrated launch lug printed into the tube wall, TTW-bonded into the outer wall, not a separate glued part — see Design Notes. **Lug resized 2026-08-18 at user request: ID ⌀4→⌀7mm (rail rod clearance), OD ⌀6→⌀9mm to keep the 1mm wall thickness, same 25mm length/position.** (Went through an intermediate ⌀5mm-ID step first.) This resolves the "unverified geometry change" previously flagged here — the 33672 mm³/11-face solid on disk is exactly this, confirmed by direct mesh measurement (lug outer radius 4.498mm ≈ 4.5mm). **Modified again 2026-08-19 for avbay integration** (see `Design-Notes-AvBayIntegration.md`): the aft 14mm (Z100–114) is now counterbored to ID ⌀33.2 (0.9mm wall) — a flush-fit socket for the matching external rebate now cut into `Body_Aft`, replacing the previously-unmodeled straight overlap between the two tubes. Added 4× ⌀1.0mm barometer static ports at Z=140 (θ45/135/225/315°) and 2× ⌀3.4mm M3 clearance holes at Z=185 (θ0/180°) for the avbay's forward collar retaining screws. 2132 facets, 0 open edges, re-verified watertight and 0mm³ interference against every neighboring part. **Extended + fwd rebate spigot added 2026-08-26** (see `Design-Notes-ParachuteBay.md`): grew 160.0→163.5mm at the fwd tip (Z260→263.5) and picked up an OD-stepped spigot (⌀35→⌀33.0, 1.0mm wall) over its last 14mm (Z249.5–263.5), mating a new socket in `ParachuteBay` — same joint style as the existing Fwd/Aft rebate. ID unchanged (⌀31 straight through, including the spigot span). Mass **dropped slightly** (33.4g→32.5g) despite the length increase — the spigot cut removes more wall material than the 3.5mm extension adds. Re-exported (mesh re-tessellated at 0.1mm/0.3° deflection), watertight, 0mm³ overlap against `ParachuteBay` and all unchanged neighbors. |
| 3 | Aft Body Tube | `Print Files/SampleRocketABSBody33-36_Aft.stl` | 1 | ⌀35–38 × 114.0 L | 29.11 cm³ | ~30.3 g | Threaded aft closure; houses the Motor Retainer Cap. **Not re-exported 2026-08-18 — deliberately skipped.** This file represents the tube *without* the retention boss (a separate build option from part #5). The current FreeCAD document no longer has that variant as an independent object: the boss is fused into the same solid as the motor-mount tube, so producing a true tube-only export now means a new boolean to trim the boss off — a design decision, not a re-export. The file on disk is unchanged (and stale relative to the fin-slot/lug work done since 2026-08-17); regenerate deliberately if this variant is still wanted. |
| 4 | Fin | `Print Files/SampleRocketABSBody33-36_Fin_x3.stl` | 3 | 36.5 span × 50.8 root × 2.0 thick | 2.87 cm³ ea. | ~2.98 g ea. (~8.94 g set) | Single fin pattern — file name denotes print quantity, not a 3-fin merged mesh. **Not modeled flat — needs a rotation before slicing, see Print Orientation Notes.** **Root tab deepened 2026-08-19** (avbay integration pass, see `Design-Notes-AvBayIntegration.md`): the tab reached only 0.44mm into the 2mm wall (r17.06 vs the wall's r15.5 inner face), leaving the fin-root slots open into the airframe. Extended to r15.5 (full depth, flush with the tube ID) — +109mm³ per fin, verified 0mm³ overlap with the tube (the tab exactly fills what was open slot). **File is now in world/theta=0 coordinates (root at X15.5–17.5), not the old shifted local-X=0 convention** — the previous −17.5mm shift wasn't reapplied since the root geometry changed anyway; adjust slicer origin accordingly if that convention mattered to your workflow. 244 facets, 0 open edges. Slot itself measures ~2.88mm wide against the 2mm-thick fin — the ~0.2mm/side gap is normal TTW glue clearance, close with an epoxy fillet on assembly. |
| 5 | Aft Retention Screw *(see correction)* | `Print Files/SampleRocketABSBody33-36_Aft_ScrewCap.stl` | 1 | Whole file: ⌀35.2 × 139.0 L. Unique screw-tip content only: ⌀~28–30 × ~25–28 L | 35.58 cm³ whole file | ~37.0 g whole file | **Modified 2026-08-19 for avbay integration** (see `Design-Notes-AvBayIntegration.md`) — three changes to this solid, each healed (STEP round-trip + `fixTolerance`/`removeSplitter`) and re-verified watertight (0 open edges) individually before the next: (1) the thrust bulkhead described below was **relocated** from Z37–40 to **Z64–67** and bored to ⌀18 on-axis, so it now closes the motor-tube/airframe annulus (like a centering ring) instead of blocking the bore outright — no 18mm motor could be loaded past Z37 before this fix; (2) an external rebate cut over Z100–114, OD ⌀35→⌀33.0 (1.0mm wall), forming a flush socket with the matching counterbore now in `Body_Fwd` (part #2) — replaces the previously-unmodeled straight overlap between the two tubes; (3) one ⌀2mm vent hole added through the outer wall at Z≈20, θ=30°, so the annulus below the (now-relocated) bulkhead isn't a sealed dead volume once the fin slots close (part #4). 6060 facets, re-verified watertight and confirmed 0mm³ overlap against `Body_Fwd`, all three fins, and the new avbay parts. **Thrust ring added 2026-08-26** (see the Motor Bulkhead / Thrust Ring row below for full detail): the Z64–67 ring's bore was reduced from a clear ⌀18 to ⌀14mm, giving it an actual motor-stop function instead of just closing the outer annulus. +301.6mm³ (~0.31g). Re-exported (17446 facets), re-verified watertight (0 open edges, mesh volume within 0.04% of the CAD solid) and re-confirmed 0mm³ new overlap against `Body_Fwd`, all three fins, and `AvBay_AftBulkhead`/etc. (the only nonzero `.common()` result, 521.9mm³ against `MotorRetainerCap`, is the pre-existing threaded-joint engagement at Z≈−26.8–2.5, unrelated to this change and present before it too). |**Corrected 2026-08-18, by directly cross-sectioning the mesh in FreeCAD (not the Blender scene) every 0.5–2 mm along its axis:** this file is **not** a standalone screw. It's the Aft Body Tube's shell (#3) boolean-unioned with the retention screw's exposed tail-tip. From z≈3 mm to z=114 mm it is geometrically identical to `Aft.stl` — same 2 mm-wall airframe tube, same fin-root slot pattern, same reduced-wall Fwd-tube socket — meaning that entire span is the tube, not the screw. The only genuinely unique material is a short ~25–28 mm extension (protruding past the Aft tube's own tail tip) reaching a max radius of ~14–15 mm (⌀28–30 mm), well short of the ⌀35.2 mm envelope previously attributed to "the screw." The earlier "flanged head... at fwd end" description couldn't be confirmed, and the "internal ⌀31×2 mm bulkhead partway down the bore" was specifically **not found** — the motor-tube bore reads as continuously hollow (⌀18 mm ID) everywhere the motor tube is present in this file. That said, the bore was only sampled at 2 mm steps outside z=0–12 mm, so a thin bulkhead elsewhere isn't fully ruled out — treat the original bulkhead claim as unverified, not confirmed absent. **A true standalone, print-ready screw STL does not appear to exist in this project** — confirm with the designer whether one exists elsewhere before slicing part #5 on its own; slicing this file as-is would reprint the entire Aft Body Tube a second time. **Retention-screw boss removed 2026-08-18 (predates this correction):** a small raised, open-topped boss (~12×10mm footprint, ~1.2mm proud of the 17.5mm nominal OD, centered z≈20–30mm from the aft tip) was removed at the user's request, along with the internal wedge of material that bridged it to the inner motor-mount tube (that bridge existed only at this one angular position, unlike the full-circumference bulkheads elsewhere in the part, so it read as built specifically to seat this boss rather than as general structure). The through-holes this left in the outer wall (r=17.5mm), inner wall (r=15.5mm), and inner tube (r≈9.6–9.7mm, was 9.5–10.4mm natural variance there) were all patched back to plain, continuous cylindrical surface; minimum inner-tube radius elsewhere is unchanged at ~9.0mm. STL/OBJ re-exported to match; the `.3mf` in Print Files (dated 2026-08-17) is now the only remaining pre-removal copy of this part — keep it until you've confirmed the new geometry prints/fits correctly. **Real thread modeled and exported 2026-08-18:** the aft boss (was a plain ⌀28mm cylinder, Z −26→0) now carries an actual single-start trapezoidal external thread — major ⌀28.0mm / minor ⌀25.6mm (1.2mm radial depth), 3mm pitch, 30° flank, ~8.5 turns over the full 26mm engagement length, right-hand. Mates with the internal thread now cut into part #6 (see its note). STL re-exported to this file (8196 facets). The boolean-cut thread left tiny degenerate sliver faces at the root seam (a known FreeCAD/OCCT artifact on swept-thread cuts) — **fixed**, not just tolerated: a STEP round-trip + `fixTolerance`/`removeSplitter` heal pass removed them from the solid before meshing. The exported STL is now **fully watertight** (0 open edges, mesh volume within 0.03% of the CAD solid) — no slicer repair needed. Re-exported again 2026-08-18 as part of a full-project re-export pass (geometry unchanged from the healed version, same 8196 facets, still 0 open edges). **Centering rings + thrust bulkhead merged in 2026-08-18 (later same day):** at user request, this file now also contains a forward centering ring (new) and a solid thrust bulkhead (new), alongside the aft centering ring (previously a separate FCStd object, now folded in here too — see the new row below). Positions were derived from `Models/SampleRocketABSBody33-36.obj`'s original reference groups (`6_Centering ring`/`7_Centering ring`/`11_Bulkhead`, apparently from the source OpenRocket design and never previously mined), scaled proportionally onto this model's actual motor-tube span since the reference tube (75mm) and this model's tube (80mm) differ slightly: forward ring at Z=54–57mm, bulkhead at Z=37–40mm (world frame, tail tip=Z0). The reference file also has a separate "Engine block" ring (Z≈68–73, inside the motor tube's own bore) — **not included**, per user's choice of "bulkhead" specifically; the design still lacks a dedicated thrust-transfer ring if one is wanted later. 9800 facets, fully watertight (0 open edges), volume within 0.03% of the CAD solid. **Note:** unlike every other change in this file's history, this specific re-export was not backed up before overwriting (the pre-merge STL/OBJ were lost) — the FCStd itself was re-saved too, so the prior state isn't recoverable from a file, only by re-running the removal of the 3 new solids from the current compound. **Fixed 2026-08-18 (later same day) — "not solid" report:** the first version added the 3 new parts as separate touching solids in a compound alongside the existing tube/boss solids. Two of those contacts were exactly coincident (ring/bulkhead OD = airframe ID = 15.5mm, over the same Z-span) rather than merged, which is a textbook z-fighting/degenerate-surface setup — almost certainly what looked "not solid" in the FreeCAD viewport. Separately, the bulkhead (a full ⌀31 disc) genuinely volume-overlapped the motor-tube wall by 87mm³ at its Z position, since both occupied material there. Fixed by boolean-fusing all 5 pieces (boss/motor-tube, airframe, both rings, bulkhead) into **one single solid** instead of a 5-solid compound — this is also more correct functionally, since the rings/bulkhead are what's supposed to structurally bond the motor tube to the airframe at those 3 points, so one connected solid reflects the design intent better than touching-but-separate solids anyway. Re-verified: 0 sliver faces, volume matches the additive total minus the 87mm³ overlap removed exactly once, mesh re-exported (10380 facets) and re-confirmed fully watertight (0 open edges). |
| — | Aft Centering Ring | `Print Files/SampleRocketABSBody33-36_AftCenteringRing.stl` (standalone) **+ merged into `Aft_ScrewCap.stl`** (2026-08-18) | 1 | ⌀31 OD × ⌀19 ID × 3.0 L | 1.41 cm³ | ~1.5 g | **Added 2026-08-18.** Closes the open annulus between the motor-mount tube (OD ⌀19mm) and airframe tube (ID ⌀31mm) at the aft end, bonded to both. Positioned z=5–8mm (in the Aft Body Tube's own coordinate frame, tail tip = z0) — the only clean, unobstructed span of open annulus at the aft end, found by cross-sectioning the mesh every 0.5mm: bounded aft by the threaded closure/screw tail-tip (material below z≈3mm) and forward by where the fin-root slots begin cutting through the wall (z≈9.5mm). **STL/OBJ exported 2026-08-18** as its own file, then **folded directly into the `Body_Aft` solid (and thus `Aft_ScrewCap.stl`) later the same day** at user request, so it now prints as one integrated piece rather than a separately-bonded part. The standalone FCStd object still exists (geometry unchanged) but is hidden to avoid double-rendering the now-duplicated geometry; its own STL file on disk is unchanged and still valid to print separately if ever wanted. |
| — | Forward Centering Ring | merged into `Aft_ScrewCap.stl` only (no standalone file) | 1 | ⌀31 OD × ⌀19 ID × 3.0 L | 1.41 cm³ | ~1.5 g | **Added 2026-08-18.** Same profile as the Aft Centering Ring, positioned at Z=54–57mm (world frame) near the forward end of the motor-mount tube — mirrors the reference design's `7_Centering ring` group in `Models/SampleRocketABSBody33-36.obj`, proportionally rescaled onto this model's tube length. No fin-slot conflict (sits forward of the Z=9.5–45.5 slot region). Exists only inside `Body_Aft`'s shape / the merged STL, not as its own FreeCAD object or file. |
| — | Motor Bulkhead / Thrust Ring *(was "Thrust Bulkhead")* | merged into `Aft_ScrewCap.stl` only (no standalone file) | 1 | ⌀31 OD × ⌀14 bore × 3.0 L (bored, not solid) | ~1.95 cm³ | ~2.03 g | **Re-bored to a true thrust ring 2026-08-26**, closing the gap this row itself had flagged since 2026-08-18 ("the design still lacks a dedicated thrust-transfer ring"). The ring's bore was reduced from a clear ⌀18mm (flush with the motor tube ID — no stop function, just closed the outer annulus) to **⌀14mm** — a 2mm radial shoulder the motor's forward rim seats against, so thrust now transfers into this ring (and from there into the airframe at Z64–67, already fused solid bore-to-OD) instead of relying solely on the fin-tab/motor-tube bond. Station unchanged (Z64–67, the motor tube's own forward-most 3mm, confirmed by cross-section: the r≈9.0mm bore ends at Z≈67.25). Verified: available straight motor bay from the retainer cap's aft opening (Z≈−29.5) to this new stop (Z64) is **≈93.5mm** clear at ⌀18mm — comfortably fits typical 18mm-class A–E motors; re-confirm against your specific motor before flying. ⌀14mm bore was sized purely as a printable mechanical stop shoulder — **this build fires a plugged motor (no motor ejection charge)**, so there is no ejection-gas flow through this bore to size for at all; recovery deployment is handled entirely by the AvBay (see `Design-Notes-AvBayIntegration.md`), independent of and unaffected by this ring. Given that, a fully solid disc (closing the bore to r0) was considered as an alternative — the user opted to keep the open ⌀14mm bore ring instead, matching the standard engine-block convention and keeping the option open for a non-plugged motor later; its ≈100mm² annular contact patch (r7–9mm) is already far stronger than the thrust involved requires. +301.6mm³ / ~0.31g, verified via `.fuse()` + `.removeSplitter()` (single valid solid, 61 faces) and a manual mesh open-edge count (0 open edges out of 26169 edges on the 17446-facet re-export) — **not** via `Part.Shape.check(True)`, which pegged FreeCAD's GUI thread at 100% CPU for 10+ minutes and required killing and restarting the app; the pre-check shape was already valid, so that step was skipped on retry. **Prior history:** relocated and bored (bore left fully open at ⌀18) 2026-08-19 during avbay integration — see `Design-Notes-AvBayIntegration.md` — from an original **solid** ⌀31 disc at Z37–40 that fully plugged the bore (confirmed by direct probe that an 18mm motor couldn't load past Z37); mirrors the reference design's `11_Bulkhead` group, proportionally rescaled. The reference file's separate "Engine block" ring (⌀18 OD, seated inside the motor-tube bore near Z≈68–73) — the traditional thrust-transfer role — was deliberately not added in 2026-08-18 or 2026-08-19; this 2026-08-26 pass folds that function into this ring instead of adding a new part. Exists only inside `Body_Aft`'s shape / the merged STL. |
| 6 | Motor Retainer Cap | `Print Files/SampleRocketABSBody33-36_MotorRetainerCap.stl` | 1 | ⌀36.0 × 32.0 L | 12.52 cm³ | ~13.0 g | Internally threaded nut; mates with part #5. No separate screw/hardware needed for motor retention — it's an all-printed pair. **Exhaust hole added 2026-08-18:** the aft-most base (the true tail-tip of the rocket, sitting outboard of the internal threads) was a full solid disc, blocking the motor's nozzle exhaust entirely. Bored a ⌀18mm through-hole on-axis (matches the motor mount tube ID) — leaves an annular retaining lip against the ⌀36 OD, well clear of the internal threads. Confirm this diameter isn't undersized for the actual motor's nozzle exit before flying. **Real thread modeled and exported 2026-08-18:** the counterbore (was a plain ⌀29mm bore) now carries an actual internal thread matching part #5 — crest ⌀28.4mm / root ⌀30.8mm, same 3mm pitch/30° flank, phase-matched to the boss thread (0.2mm radial clearance all around, uniform diametral fit for FDM printing). While doing this, found and fixed a pre-existing ~0.5mm bottoming interference between the boss tip and the counterbore's bottom step — the counterbore was deepened from Z −25.5 to Z −26.2 (in the cap's own frame) to clear it, which thins the exhaust-hole base plug from 4mm to **3.3mm** (still well clear of the ⌀18mm bore, but note the reduced base thickness above). STL re-exported to this file (7026 facets) after the same STEP-round-trip heal pass used on part #5 (see its note); the internal thread's tighter concave geometry couldn't be healed 100% (1 sliver face remains, vs. 0 for the boss) but mesh volume is within 0.06% of the CAD solid and open edges dropped to 0.19% of the mesh — good enough that a slicer's standard auto-repair will close the rest without any real-geometry ambiguity. Re-exported again 2026-08-18 as part of a full-project re-export pass (geometry unchanged, same 7026 facets / 20 open edges). **Untouched 2026-08-19** — the avbay integration pass didn't modify this part; its 31 pre-existing open edges (noted above) are unrelated to that work. |
| 7 | AvBay Aft Bulkhead | `Print Files/AvBay_AftBulkhead.stl/.obj` | 1 | ⌀30.8 × 3.0 L | 2.00 cm³ | ~2.16 g | **New 2026-08-19.** Pressure boundary sealing the battery/charger zone from the plenum below; O-ring groove (⌀27.6–28.8 ID, 1.8mm deep, ~2mm-CS nitrile cord) sealing to the ⌀31 tube ID; off-axis ⌀5 gas port at (0,−11) for the interim motor-ejection path. Sits at Z82–85. 684 facets, 0 open edges. See `Design-Notes-AvBayIntegration.md`. |
| 8 | AvBay Battery Cradle | `Print Files/AvBay_BatteryCradle.stl/.obj` | 1 | ⌀30.6 × 40.5 L | 18.36 cm³ | ~19.86 g | **New 2026-08-19.** Full-length pocket (20×8.5×40.5mm) for the battery, offset toward +Y; USB charger shares the same pocket. Off-axis ⌀6 gas duct at (0,−11) aligned with the aft bulkhead's port. 4× ⌀4mm axial equalization holes (r11, θ30/150/210/330) connect the battery-zone air to the ring-zone annulus for barometer venting. Sits at Z85–125.5. 1008 facets, 0 open edges. |
| 9 | AvBay Mandrel | `Print Files/AvBay_Mandrel.stl/.obj` | 1 | ⌀20.5 OD × ⌀18 ID × 58.0 L | 4.22 cm³ | ~4.56 g | **New 2026-08-19.** Plain tube; the 8-board electronics ring (unchanged from `integrated_ring_av_co2_bay_30mm`'s tier layout) standoff-mounts to the OD. Sits at Z125.5–183.5. Checked against the launch-lug's r14.5 intrusion (Z167.5–192.5) — clear by 4.25mm, no relief cut needed. 336 facets, 0 open edges. |
| 10 | AvBay Fwd Collar | `Print Files/AvBay_FwdCollar.stl/.obj` | 1 | ⌀30.8 OD × ⌀20.5 ID × 3.0 L | 0.84 cm³ | ~0.91 g | **New 2026-08-19.** Second pressure boundary; O-ring groove; 2× ⌀2mm potted lead feedthroughs (θ80/100°, for future CO2 nichrome leads); 2× ⌀3.4mm M3 clearance holes (θ0/180°, mate to part #2's new holes); shock-cord anchor tab; off-axis ⌀6 gas-relief hole at (0,−11). **Locally relieved against the launch-lug boss** — the plain OD collided with the lug's r14.5 intrusion (8.3mm³, found during verification), cut clear and re-verified at 0mm³ overlap. Sits at Z183.5–186.5. 1336 facets, 0 open edges. |
| 11 | Nose Ballast Cup | `Print Files/Nose_BallastCup.stl/.obj` | 1 | ⌀26.4 × 15.0 L | 2.31 cm³ | ~2.50 g (empty) | **New 2026-08-19.** Sits at the top of the nosecone's hollow cavity, against the solid tip; open aft for loading shot + epoxy. **Repositioned 2026-08-26** along with the nosecone (world Z257.5–272.5 → Z382.5–397.5, see `Design-Notes-ParachuteBay.md`) — geometry unchanged. Stability margin recomputed at 1.10 cal with 0g ballast (was 0.76 cal) — **the previous 10–15g recommendation no longer applies**; the cup stays installed as optional insurance, not a requirement. 332 facets, 0 open edges. |
| — | AvBay Duct Plug *(spare, not installed)* | `Print Files/AvBay_DuctPlug.stl/.obj` | 1 | ⌀19.5 × 10.0 L | 2.51 cm³ | ~2.72 g | **New 2026-08-19, not part of this build.** Blanks the aft bulkhead's gas port when the CO2 module eventually replaces motor ejection. Excluded from the mass/CG totals below. 668 facets, 0 open edges. |
| 12 | Parachute Bay | `Print Files/SampleRocketABSBody33-36_ParachuteBay.stl/.obj` | 1 | ⌀35.0 OD × ⌀31.0 ID × 135.5 L (100mm clear packing bore + 14mm aft joint + 21.5mm fwd nose-shoulder socket) | 25.50 cm³ | ~27.58 g | **New 2026-08-26**, see `Design-Notes-ParachuteBay.md`. Dedicated section built exclusively for recovery — sized for a Ø300mm (30cm) round canopy, 100mm of clear ⌀31 ID bore (Z263.5–363.5). Aft end (Z249.5–263.5) is an ID-counterbored socket (⌀31→⌀33.2) receiving a new matching spigot on `Body_Fwd`'s fwd tip (⌀35→⌀33.0, 1.0mm wall) — same flush-rebate joint style as the existing Fwd/Aft tube joint, 0.1mm radial clearance, confirmed 0.0000mm³ overlap. Fwd end (Z363.5–385) is a plain, unmodified ⌀31 ID bore — takes over the nosecone-shoulder interface role from `Body_Fwd`'s old fwd tip, unchanged fit (0.2mm radial clearance). This also required resizing the CO2 module's reserved envelope (52mm→77mm, using that module's own doc's "+20-25mm" aft-cap estimate — see `Electronics/Integrated Bay Assemblies/integrated_ring_av_co2_bay_30mm.md`) and shifting the nosecone/ballast cup +125mm; overall rocket length is now 433.5mm (was 308.5mm). 504 facets, 0 open edges, single solid, watertight. No ports/vents/anchor tabs on this part — see the design notes' "Open items" for why a shock-cord anchor was deliberately *not* added here (would block the AvBay's nose-first insertion sweep). |

**Total, printed parts (this build, 0g ballast, excluding the spare duct plug):** structure only ≈ **172.0 g** — Nosecone 21.06 + Body_Fwd 32.50 + Body_Aft/screw-cap 37.31 + Fins×3 8.94 + MotorRetainerCap 12.79 + AftCenteringRing 1.47 (pre-existing, see its own row above) + AvBay parts (Aft Bulkhead 2.16 + Battery Cradle 19.86 + Mandrel 4.56 + Fwd Collar 0.91 + Ballast Cup 2.50, empty) + **Parachute Bay 27.58**. Ballast is now optional insurance, not a recommendation — stability margin is 1.10 cal at 0g ballast, see `Design-Notes-ParachuteBay.md`'s recomputed mass/CG/stability table (supersedes the one in `Design-Notes-AvBayIntegration.md`). This figure is measured directly off the FreeCAD solids (exact, not estimated) and **replaces** the older ~144.9 g figure below, which predates the 2026-08-26 parachute-bay addition and thrust-ring re-bore.

*Superseded 2026-08-18 total, kept for history:* ~160.4 g as originally summed — but that figure double-counts the Aft Body Tube (part #3, ~30.3 g) once directly and again inside part #5's 39.7 g figure, since #5 turned out to be the tube unioned with the screw, not a separate screw part (see correction on #5). Using #5's unique-content mass (~9.5 g) instead: ~130.1 g (solid-volume basis), plus the new centering ring (~1.5 g) → ~131.6 g.

\*Mass = enclosed mesh volume × ABS density (1.04 g/cm³), assuming **100% solid**. Actual FDM print weight will be lower and depends on your slicer's infill %, wall/shell count, and layer height — treat these as upper-bound reference numbers, not scale weights.

## Non-printed materials (not present in project files — typical for this class of build)

| Item | Purpose |
|---|---|
| Motor, sized to the retention system's mount ⌀ | Propulsion (not modeled/specified anywhere in this project) |
| Parachute or streamer + shock cord + swivel/quick link | Recovery |
| Recovery wadding or ejection baffle | Protects recovery gear from ejection charge |
| Plastic-compatible adhesive (epoxy or acetone/ABS slurry weld) | Bonding Fwd↔Aft tube joint and fin roots |

This section is inferred from what a build like this typically needs, not sourced from the project — flag/adjust as needed.

## Print Orientation Notes

**Fin (`Print Files/SampleRocketABSBody33-36_Fin_x3.stl`) — print flat, not on edge.**

Orient the fin with its flat face down on the bed: the 2.0 mm thickness builds up vertically in Z, and both the 50.8 mm root chord and 36.5 mm span lie flat in the XY plane. Rationale:

- FDM's weakest bond is between layers (Z). Printing flat keeps that weak plane parallel to the fin's face, so perimeters/raster run continuously along the root-to-tip and leading-to-trailing directions — the axes that carry load from aerodynamic bending, flutter, and landing impact. Standing it on the root edge instead stacks thin layers along the chord, putting the weak interlayer bond directly across the load path.
- Bed adhesion: standing on edge means only a ~2 mm-wide line touches the bed — prone to tipping and, especially with ABS, warping. A full flat face adheres far better.
- No supports needed either way, since it's a simple flat plate — flat orientation has no downside there.

Note: as modeled, the STL is **not** already sitting flat. Its native coordinate system has the root chord (50.8 mm) running along Z, span (36.5 mm) along X, and thickness (2.0 mm) along Y — the opposite of print-ready. Rotate ~90° about the fin's long axis in the slicer (so the Y-thickness axis becomes vertical) before printing all 3 copies.

## Assumptions / gaps

- No FreeCAD assembly, BOM, drawings, or readme existed in the project directory — everything above was measured directly off each mesh (freshly imported into a scratch FreeCAD document).
- Nose cone has no dedicated print-ready STL; verify before adding it to a print queue.
- Launch lug: added 2026-08-17, resized 2026-08-18 to ⌀6 mm OD / ⌀4 mm ID, then later same day to ⌀9 mm OD / ⌀7 mm ID (1 mm wall throughout), 25 mm long, fused into the Forward Body Tube's outer wall. Only one lug — for rail-guided launches (as opposed to a rod through a single lug) a second lug further down the airframe is typically wanted; ask if that's needed.
- The Forward Body Tube mesh (`Print Files/SampleRocketABSBody33-36_Fwd.stl/.obj`) was regenerated from scratch as a clean parametric tube (⌀35 OD / ⌀31 ID, 2 mm wall, 160 mm long, 83-sided) during the lug resize, rather than surgically edited — the original file's mesh had minor circumferential irregularities (adjacent editing tool artifacts, not intentional geometry) that made an in-place resize unreliable to do safely. Dimensionally identical to the original within ~0.02 mm; topology is now uniform/cleaner instead of matching the original file byte-for-byte.
- `SampleRocketABS33-36.FCStd` now contains the **full assembled rocket** (updated 2026-08-18, avbay integrated 2026-08-19): Nosecone, Body_Fwd (with launch lug), Body_Aft (tube + retention screw, formerly the "reference" import — promoted to a real assembly member and made opaque), the three Fins, Motor Retainer Cap, the Aft Centering Ring, and (new 2026-08-19) the six AvBay parts — all as flat `Part::Feature` objects (no formal `Assembly` container was found in the current document; each object's shape carries its final world-frame position directly).
  - World frame: rocket centerline on X=0/Y=0, Z axis = rocket long axis, Z=0 at the aft tail tip (Motor Retainer Cap's base), increasing toward the nose. **Overall assembled length is now ≈433.5 mm** (Z=-29.5 to Z=433.5, ≈463.0mm including the retainer cap's protrusion) — up from ≈308.5mm, because a dedicated 100mm parachute bay plus a 25mm CO2-envelope resize were added 2026-08-26 (see `Design-Notes-ParachuteBay.md`). That 308.5mm figure was itself down from an earlier ≈359.5mm, because the nosecone's shoulder was repositioned −21.5 mm to actually sit inside the airframe rather than protruding past it (see `Design-Notes-AvBayIntegration.md`, Fix 3).
  - The Print Files meshes (`Aft.stl`/`Aft_ScrewCap.stl`, `Fwd.stl`) already shared one internal coordinate frame with the tube's true center at X≈-11.44 mm (found by least-squares circle-fitting the tube's cross-section) — all three were shifted by X+11.442 mm to recenter that axis to world (0,0). `MotorRetainerCap.stl` and `Nosecone....obj` were already centered at local (0,0) and needed no X/Y shift, only Nosecone needed a Z-translate (+260 mm, to sit on Body_Fwd's forward tip).
  - Fin slot location was found by ray-casting the `Aft.stl` mesh from outside the tube radius inward at 0.5 mm Z steps: the through-wall slot opens at Z=9.5 mm and closes at Z=45.5 mm (tail tip = Z0), a 36 mm window — narrower than the fin's 50.8 mm root chord, so each fin's root overhangs the slot by ~7.4 mm on each side, resting on the tube's outer surface. The fin mesh's native local axes mapped directly onto the assembly frame with **no rotation** for the slot at angle 0°: local X = radial (root at local X=0 → r=17.5 mm, i.e. tube OD, with the root's small negative excursion to X=-0.44 reading as a ~0.44 mm embed into the wall), local Y = tangential (thickness), local Z = axial (mapped 1:1, no Z offset). The other two fins are the same mesh rotated +120°/+240° about the tube axis — the file's actual slot angles measured ~0°/116.5°/243.5° (minor asymmetry attributed to measurement/threshold noise around a rounded slot edge); exact 120° spacing was used for the assembly since a 3-fin design is essentially certain to be symmetric.
  - Not yet re-verified: sub-mm fin-tab insertion depth (whether it actually reaches the inner motor-mount tube per the TTW description in the design notes, or just embeds into the 2 mm outer wall) — the flat, untapered fin mesh doesn't have a distinguishable tab feature, so this couldn't be confirmed from geometry alone.
