ItzXyers/Rocketry/Ejection System T5/Models/spring_ejector_t5_v4_assembly_cocked.step

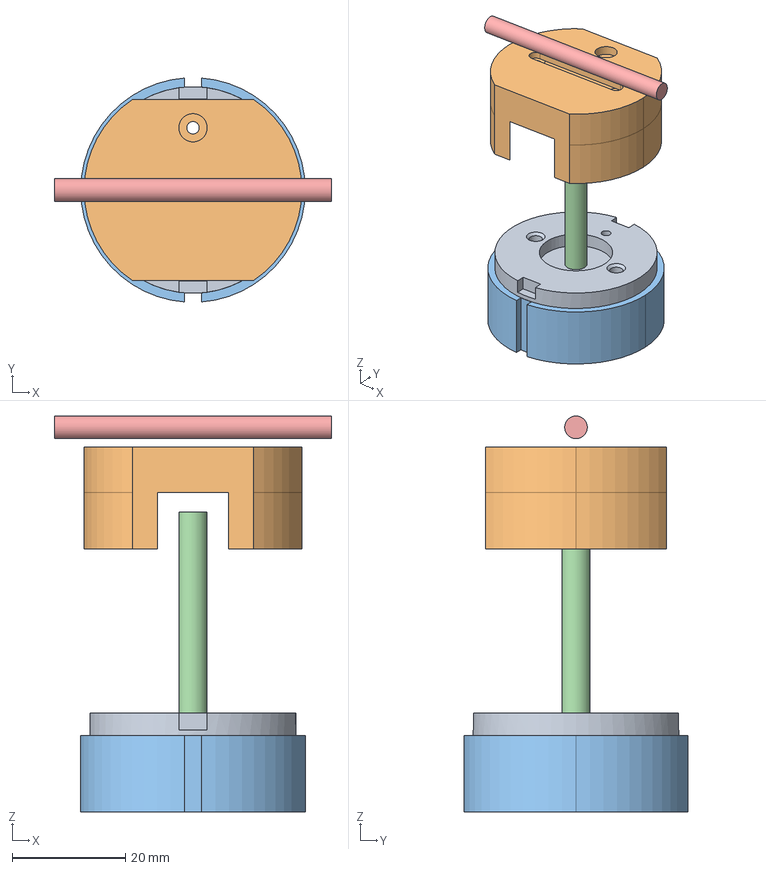
[picture p42: CAD file, 2026-10-01]
Ejection System T5/Models/spring_ejector_t5_v4_assembly_cocked.step
49.0 x 39.6 x 70.0 mm
