ItzXyers/Rocketry/Electronics/Avionics/avionics_sled_reference_assembly.stl

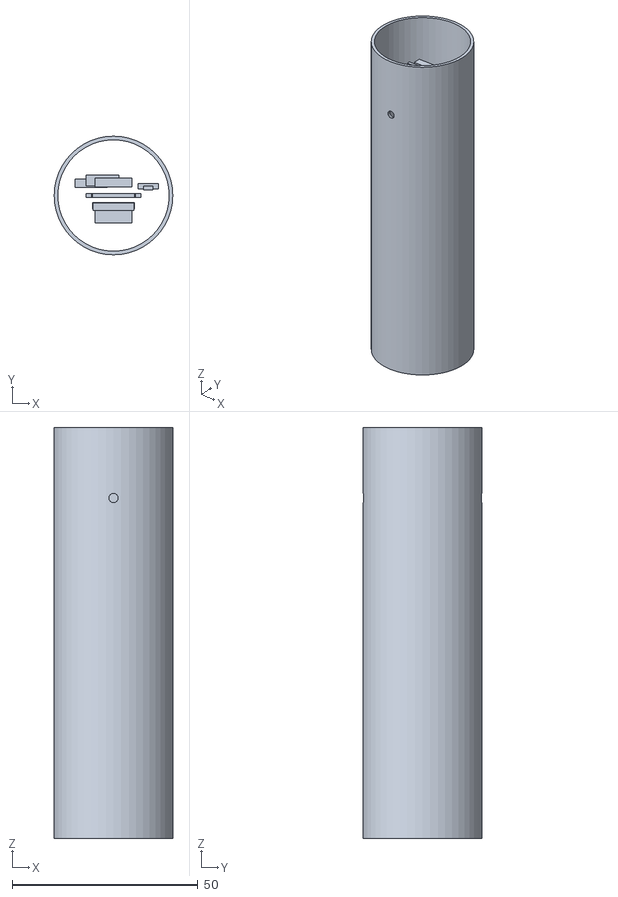
[picture p43: CAD file, 2026-09-17]
Electronics/Avionics/avionics_sled_reference_assembly.stl
32.0 x 32.0 x 110.8
