ItzXyers/Rocketry/Electronics/Integrated Bay Assemblies/combined_av_co2_bay_30mm_reference_assembly.stl

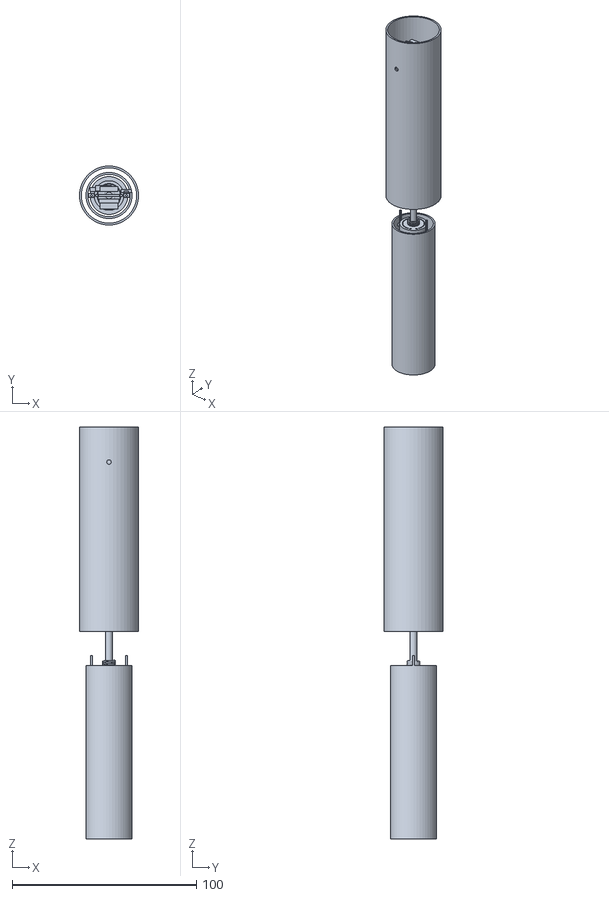
[picture p44: CAD file, 2026-09-17]
Electronics/Integrated Bay Assemblies/combined_av_co2_bay_30mm_reference_assembly.stl
32.0 x 32.0 x 223.4
