ItzXyers/Rocketry/SampleRocketABS33-36/Models/SampleRocketABS33-36_reference_assembly.stl

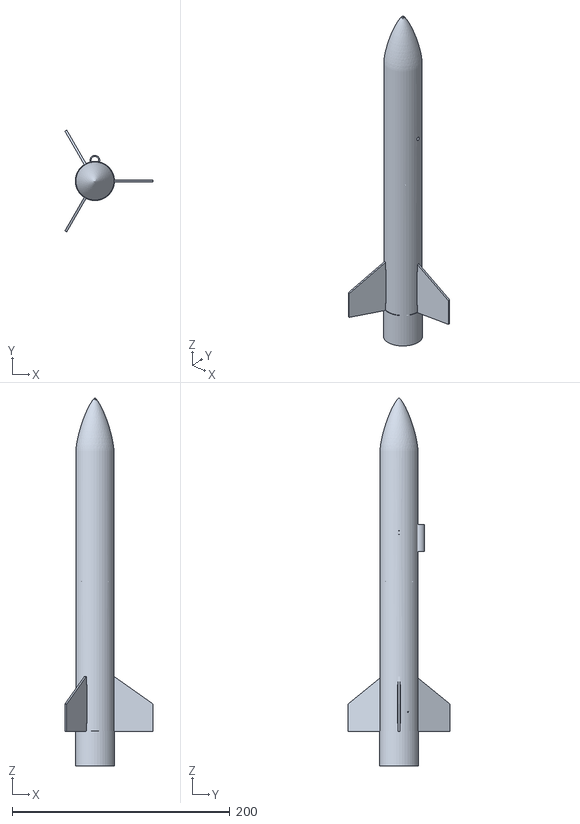
[picture p45: CAD file, 2026-09-17]
SampleRocketABS33-36/Models/SampleRocketABS33-36_reference_assembly.stl
81.1 x 93.7 x 338.0
