ItzXyers/Rocketry/SampleRocketABS33-36/Print Files/Fin_B_assembly_only.stl

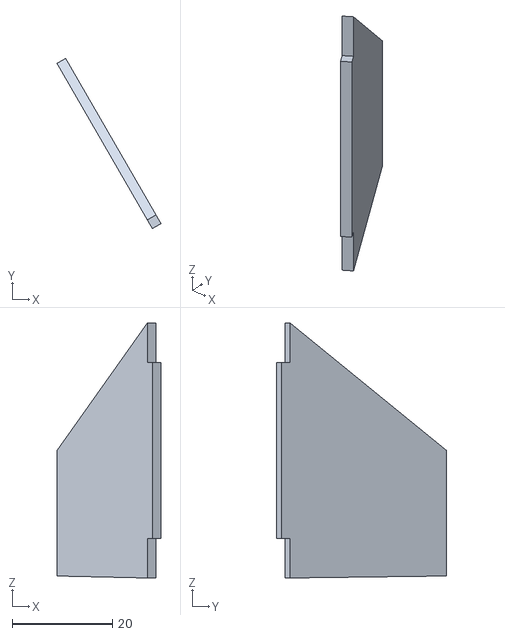
[picture p47: CAD file, 2026-09-17]
SampleRocketABS33-36/Print Files/Fin_B_assembly_only.stl
20.7 x 33.9 x 50.8
