ItzXyers/Rocketry/Ejection System T4/Models/co2_ejector_t4_assembly_cocked.step

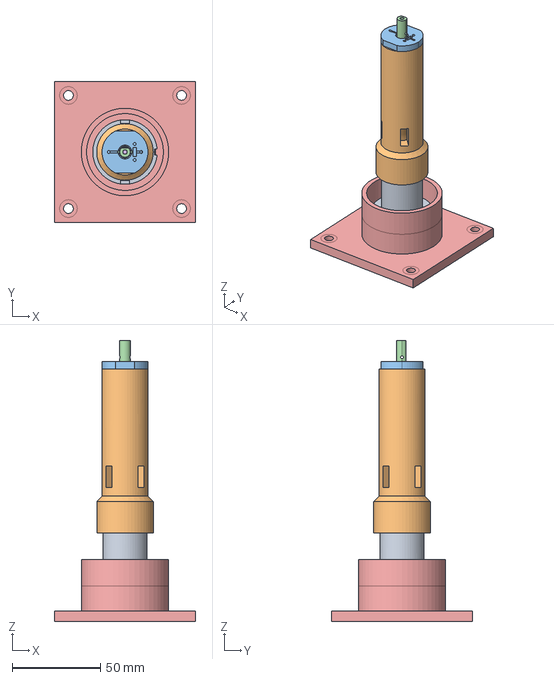
[picture p48: CAD file, 2026-09-24]
Ejection System T4/Models/co2_ejector_t4_assembly_cocked.step
80.0 x 80.0 x 159.0 mm
