ItzXyers/Rocketry/Electronics/Integrated Bay Assemblies/integrated_ring_av_co2_bay_30mm_reference_assembly.stl

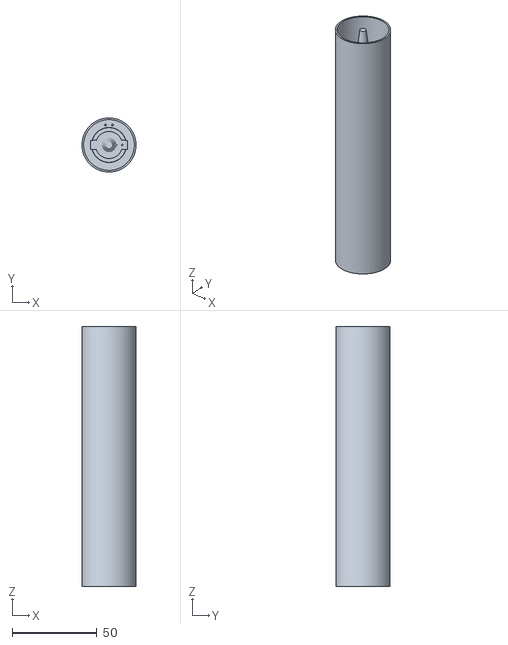
[picture p49: CAD file, 2026-09-17]
Electronics/Integrated Bay Assemblies/integrated_ring_av_co2_bay_30mm_reference_assembly.stl
32.0 x 32.0 x 153.5
