ItzXyers/Rocketry/PhoenixABS40-43/Avionics/Models/PhoenixABS40-43_avbay_sled_ASSEMBLY_v21.stl

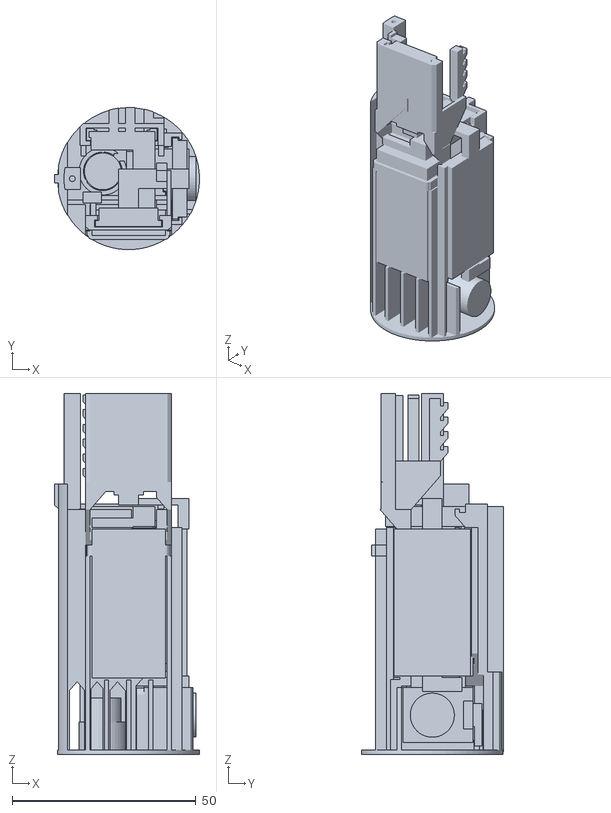
[picture p50: CAD file, 2026-10-29]
PhoenixABS40-43/Avionics/Models/PhoenixABS40-43_avbay_sled_ASSEMBLY_v21.stl
39.4 x 38.7 x 98.2
