ItzXyers/Rocketry/PhoenixABS40-43/brag-output/work/assets/PhoenixABS40-43_avbay_sled_ASSEMBLY_v19.stl

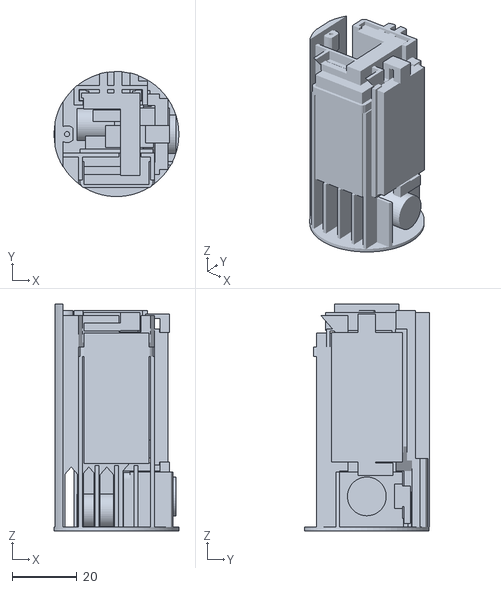
[picture p51: CAD file, 2026-10-21]
PhoenixABS40-43/brag-output/work/assets/PhoenixABS40-43_avbay_sled_ASSEMBLY_v19.stl
38.6 x 38.7 x 70.2
