ItzXyers/Rocketry/Electronics/CO2 Deployment/co2_deployment_module_reference_assembly.stl

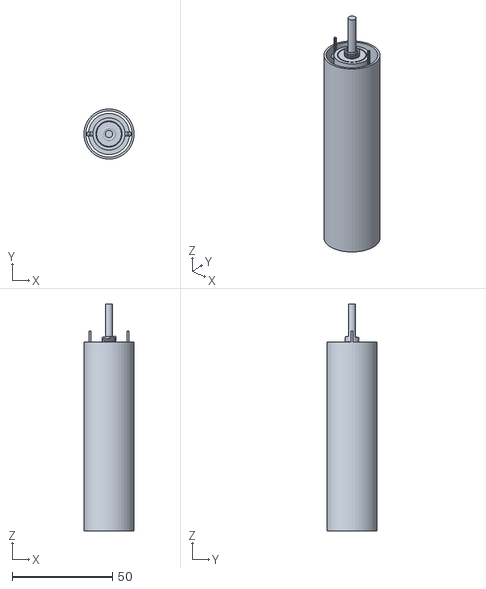
[picture p52: CAD file, 2026-09-17]
Electronics/CO2 Deployment/co2_deployment_module_reference_assembly.stl
25.0 x 25.0 x 113.0
