ItzXyers/Rocketry/PhoenixABS40-43/Models/PhoenixABS40-43_launchpad_ASSEMBLY_v2.stl

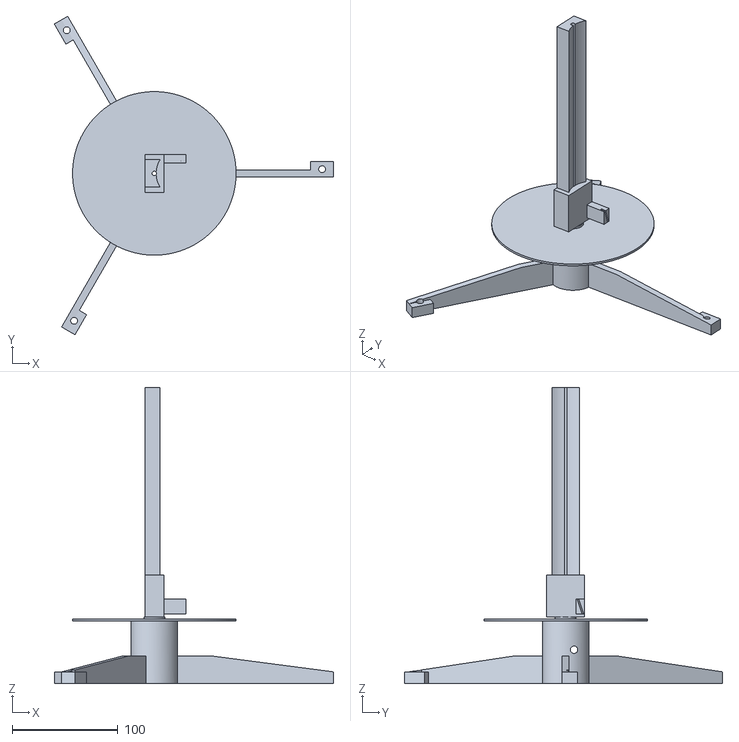
[picture p53: CAD file, 2026-10-29]
PhoenixABS40-43/Models/PhoenixABS40-43_launchpad_ASSEMBLY_v2.stl
264.8 x 301.8 x 280.5
