ItzXyers/Rocketry/Ejection System T5/Models/t5_integration_assembly.step

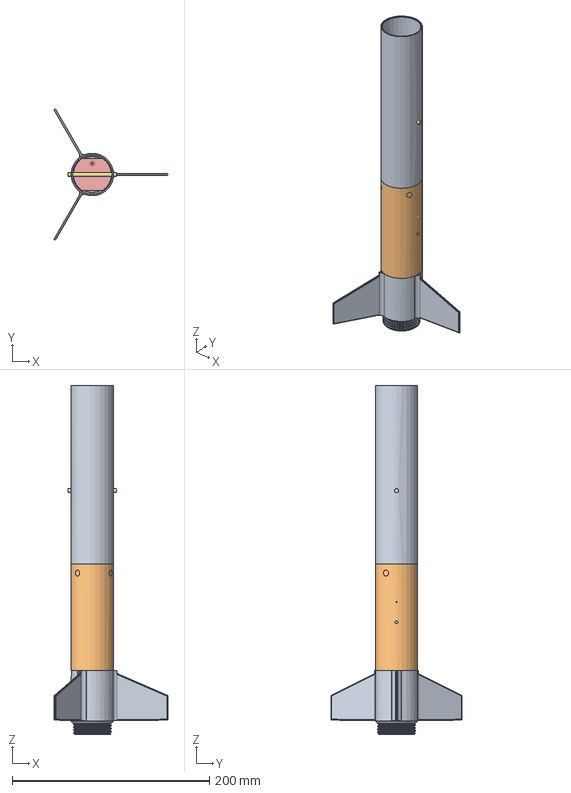
[picture p54: CAD file, 2026-09-24]
Ejection System T5/Models/t5_integration_assembly.step
115.2 x 132.7 x 353.5 mm
