ItzXyers/Rocketry/PhoenixABS40-43/Models/PhoenixABS40-43_D9aft_v2_assembly.step

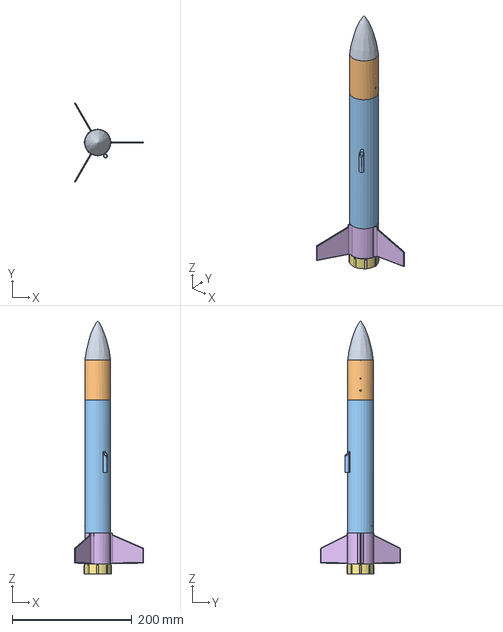
[picture p55: CAD file, 2026-10-01]
PhoenixABS40-43/Models/PhoenixABS40-43_D9aft_v2_assembly.step
115.2 x 132.7 x 422.0 mm
