ItzXyers/Rocketry/PhoenixABS40-43/Avionics/Models/PhoenixABS40-43_avbay_cassette_ASSEMBLY_v1.stl

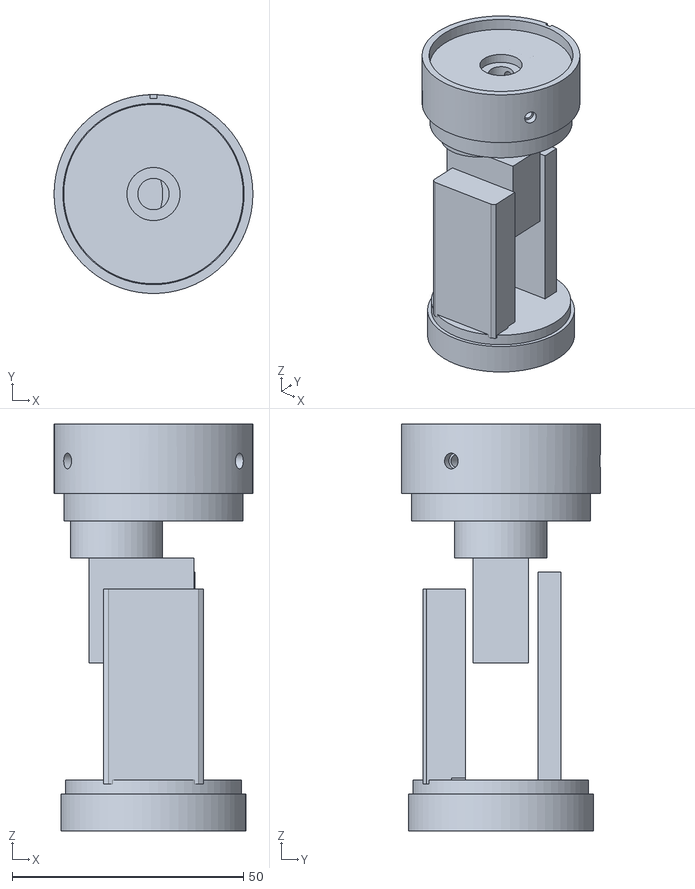
[picture p56: CAD file, 2026-09-17]
PhoenixABS40-43/Avionics/Models/PhoenixABS40-43_avbay_cassette_ASSEMBLY_v1.stl
43.0 x 43.0 x 88.0
