ItzXyers/Rocketry/PhoenixABS40-43/Models/PhoenixABS40-43_full_assembly_T5v2_v2.step

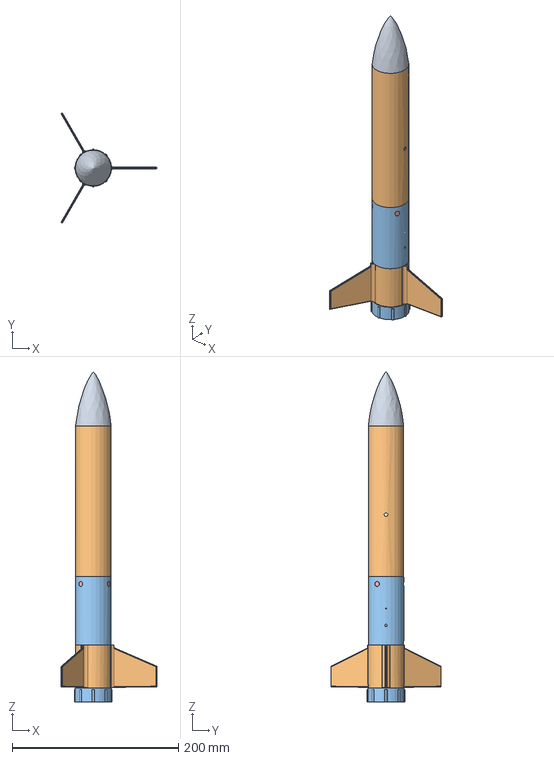
[picture p57: CAD file, 2026-09-24]
PhoenixABS40-43/Models/PhoenixABS40-43_full_assembly_T5v2_v2.step
115.2 x 132.7 x 397.0 mm
