ItzXyers/Rocketry/PhoenixABS40-43/Avionics/Models/PhoenixABS40-43_avbay_cassette_ASSEMBLY_section_v1.stl

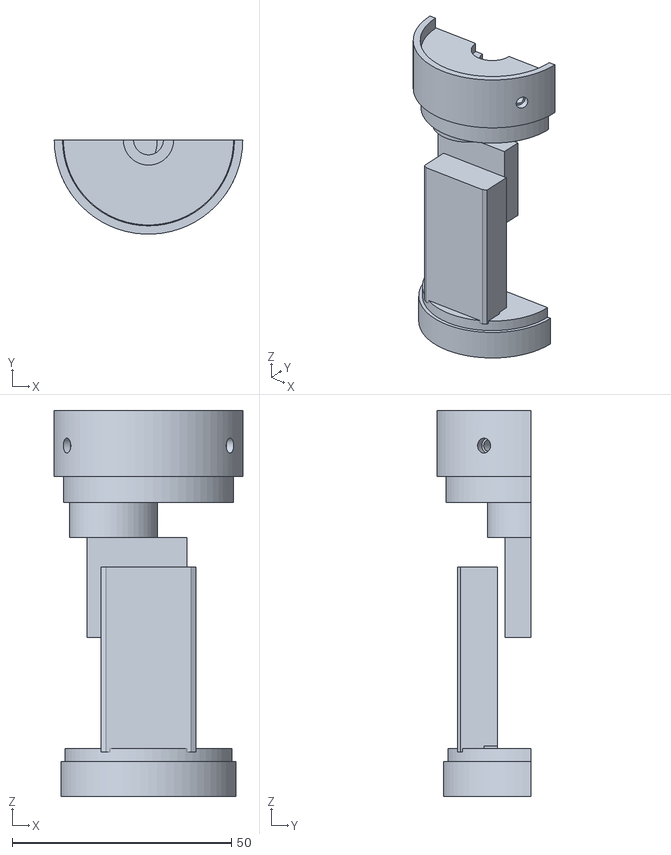
[picture p58: CAD file, 2026-09-17]
PhoenixABS40-43/Avionics/Models/PhoenixABS40-43_avbay_cassette_ASSEMBLY_section_v1.stl
43.0 x 21.5 x 88.0
