ItzXyers/Rocketry/PhoenixABS40-43/Models/PhoenixABS40-43_aft_assembly_v1.FCStd

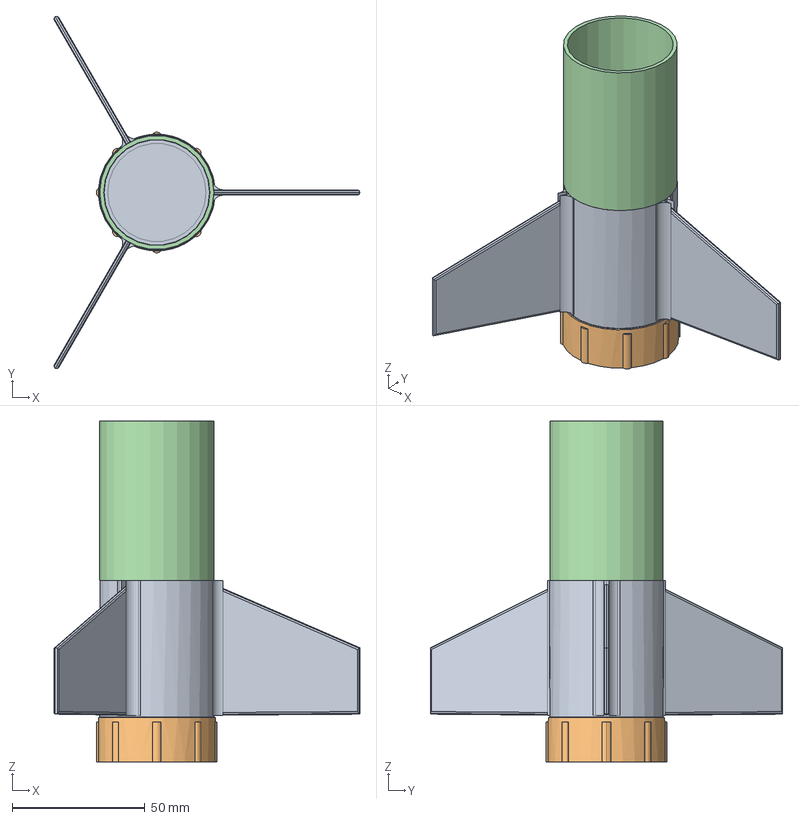
[picture p59: CAD file, 2026-09-17]
PhoenixABS40-43/Models/PhoenixABS40-43_aft_assembly_v1.FCStd
115.2 x 132.7 x 128.4 mm
AftFinCan
MotorRetainerCap
DummyMotor
FwdTubeStub
