ItzXyers/Rocketry/Ejection System T3/Phoenix3D_FreeCAD/Phoenix3D_d43_servo.doorfix-severed.20260915.FCStd

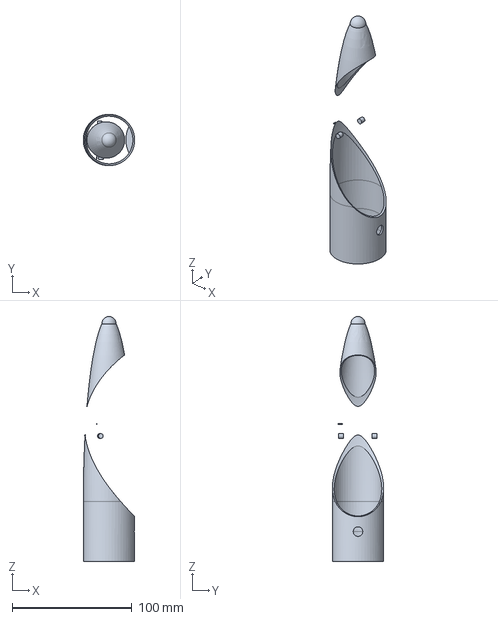
[picture p60: CAD file, 2026-09-17]
Ejection System T3/Phoenix3D_FreeCAD/Phoenix3D_d43_servo.doorfix-severed.20260915.FCStd
43.0 x 43.0 x 205.0 mm
