ItzXyers/Rocketry/Ejection System T4/Models/step_cap.step

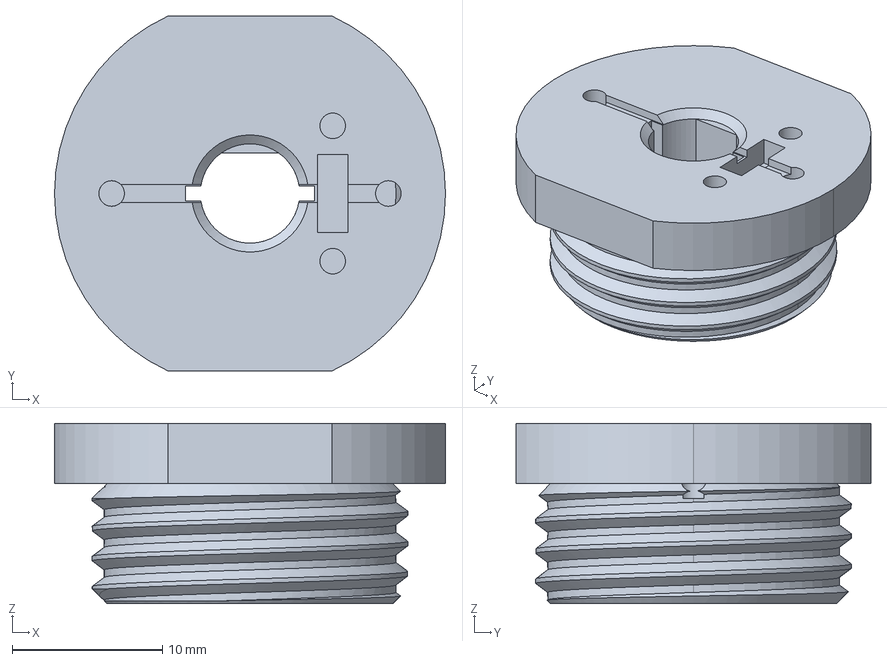
[picture p61: CAD file, 2026-09-24]
Ejection System T4/Models/step_cap.step
26.0 x 23.6 x 12.0 mm
