ItzXyers/Rocketry/Ejection System T4/Print Files/t4_coupon_seat_gauge.stl

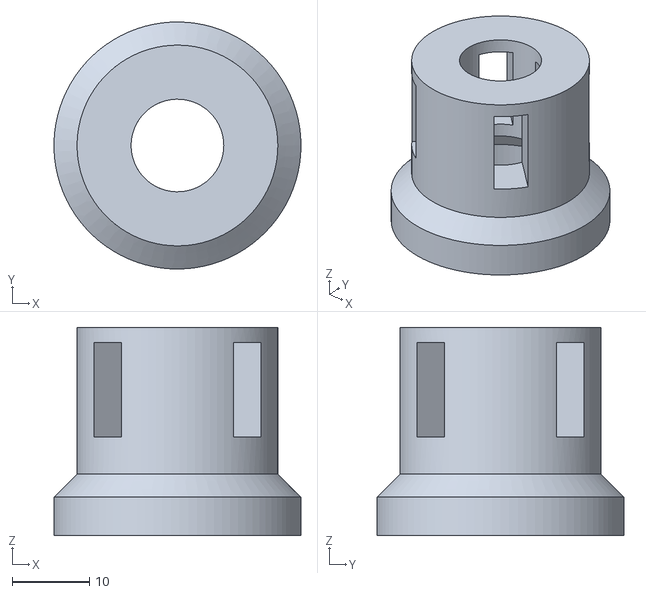
[picture p62: CAD file, 2026-09-24]
Ejection System T4/Print Files/t4_coupon_seat_gauge.stl
32.0 x 32.0 x 27.0
