ItzXyers/Rocketry/Ejection System T4/References/co2_cartridge_8g.stl

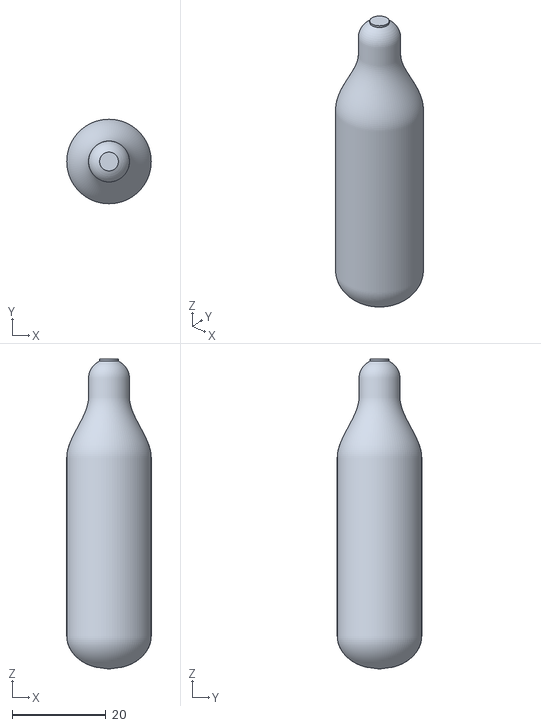
[picture p63: CAD file, 2026-09-17]
Ejection System T4/References/co2_cartridge_8g.stl
18.0 x 18.0 x 66.0
