ItzXyers/Rocketry/Ejection System T5/Print Files/Integrated/t5i_fwd_section.stl

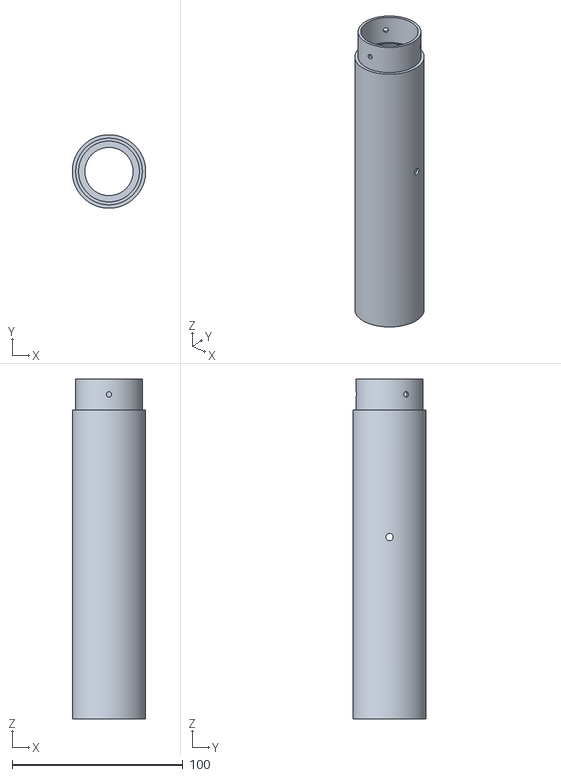
[picture p64: CAD file, 2026-09-24]
Ejection System T5/Print Files/Integrated/t5i_fwd_section.stl
43.0 x 43.0 x 199.0
