ItzXyers/Rocketry/Ejection System T5/Print Files/t5v4_spacer_2mm.stl

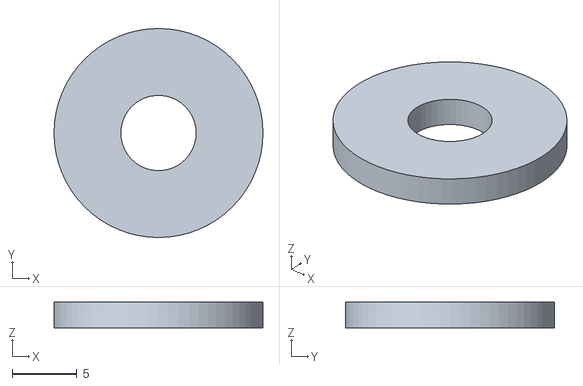
[picture p65: CAD file, 2026-10-01]
Ejection System T5/Print Files/t5v4_spacer_2mm.stl
16.1 x 16.1 x 2.00
