ItzXyers/Rocketry/Electronics/CO2 Deployment/co2_retaining_collar.stl

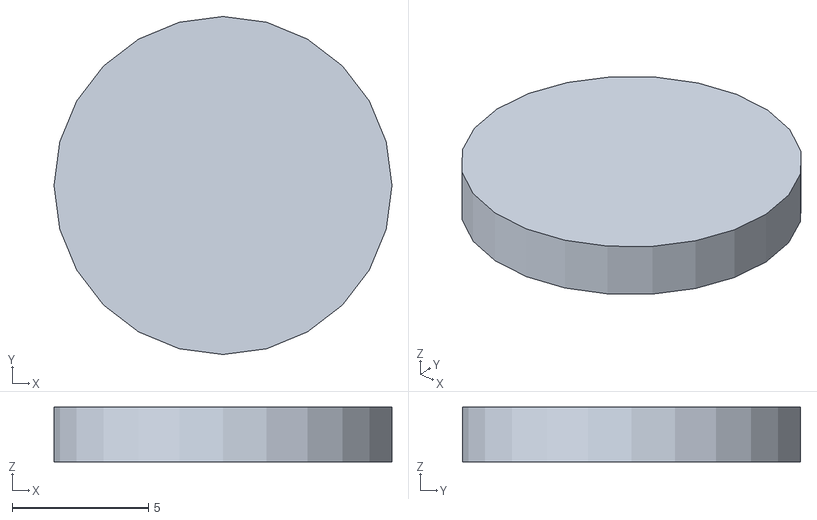
[picture p66: CAD file, 2026-09-17]
Electronics/CO2 Deployment/co2_retaining_collar.stl
12.4 x 12.4 x 2.00
