ItzXyers/Rocketry/Electronics/Unsorted/puncture_cap.stl

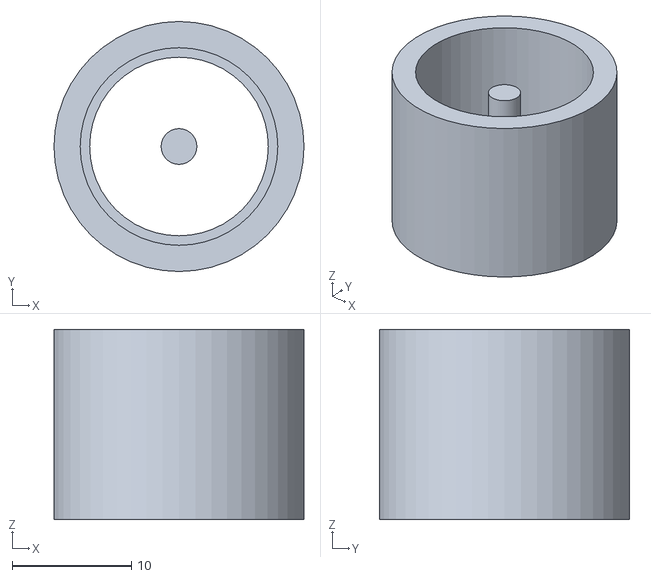
[picture p67: CAD file, 2026-09-17]
Electronics/Unsorted/puncture_cap.stl
21.0 x 21.0 x 16.0
