ItzXyers/Rocketry/LaunchPad/LaunchPad.FCStd

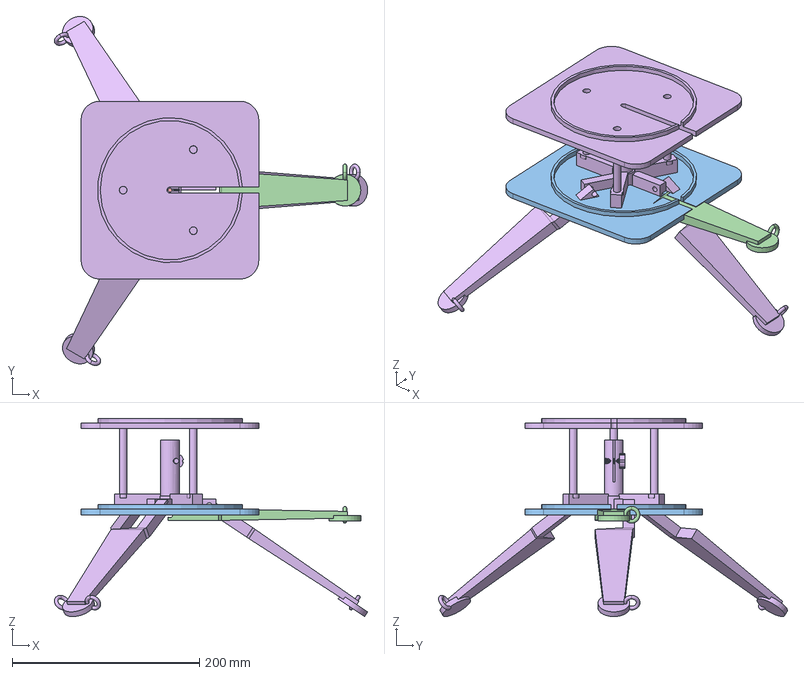
[picture p68: CAD file, 2026-09-17]
LaunchPad/LaunchPad.FCStd
334.9 x 373.0 x 211.8 mm
Hub
Thumbscrew
DeflectorCradle
Leg
HingePin
Assembly
