ItzXyers/Rocketry/LaunchPad/Print Files/LaunchPad_DeflectorCradle.stl

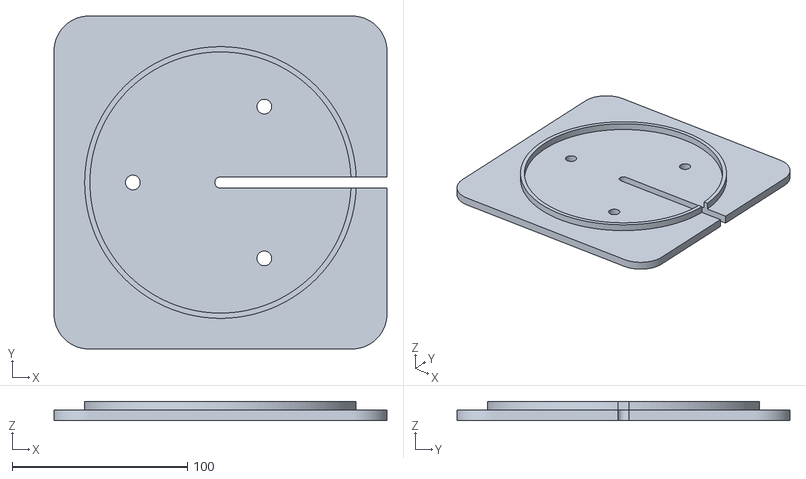
[picture p69: CAD file, 2026-09-17]
LaunchPad/Print Files/LaunchPad_DeflectorCradle.stl
190.0 x 190.0 x 11.0
