ItzXyers/Rocketry/OpenRocket Designs/RocketABS33-36-40mm-nosecone.obj

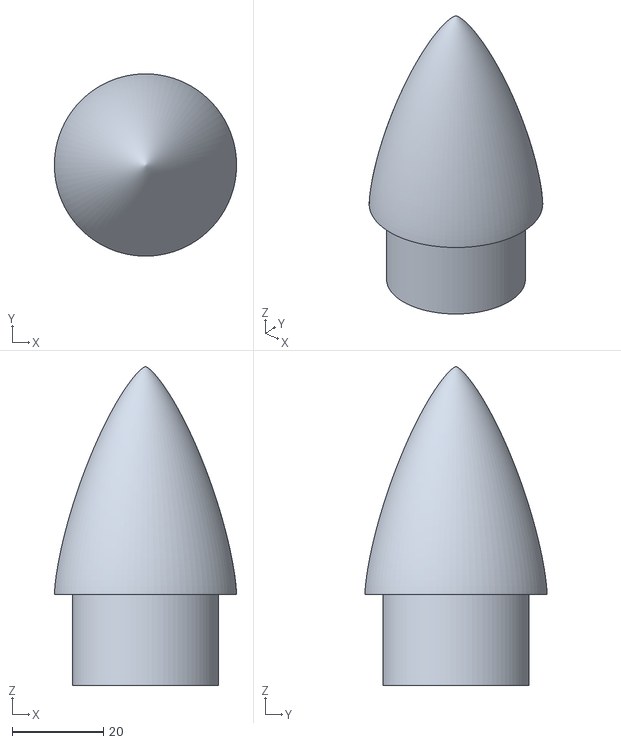
[picture p70: CAD file, 2026-09-17]
OpenRocket Designs/RocketABS33-36-40mm-nosecone.obj
40.0 x 40.0 x 70.0
