ItzXyers/Rocketry/PhoenixABS40-43/Avionics/Models/cassette_assembly_v1/SvcAnchorCoupler.stl

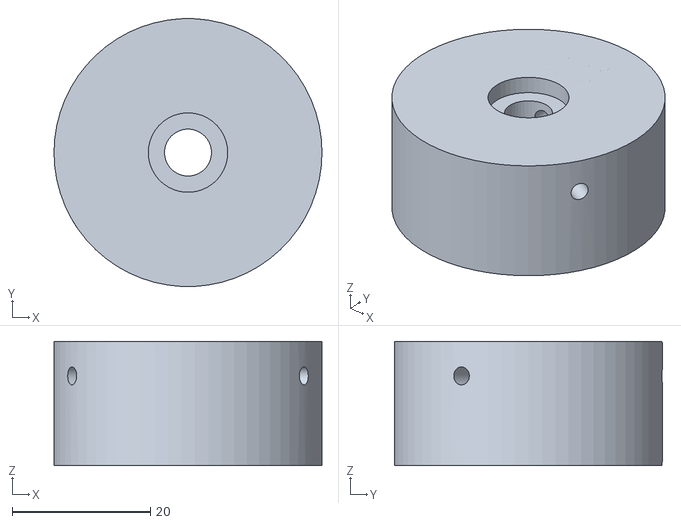
[picture p71: CAD file, 2026-09-17]
PhoenixABS40-43/Avionics/Models/cassette_assembly_v1/SvcAnchorCoupler.stl
38.8 x 38.8 x 18.0
