ItzXyers/Rocketry/PhoenixABS40-43/brag-output/work/assets/PhoenixABS40-43_avbay_ElectronicsSled_v19.stl

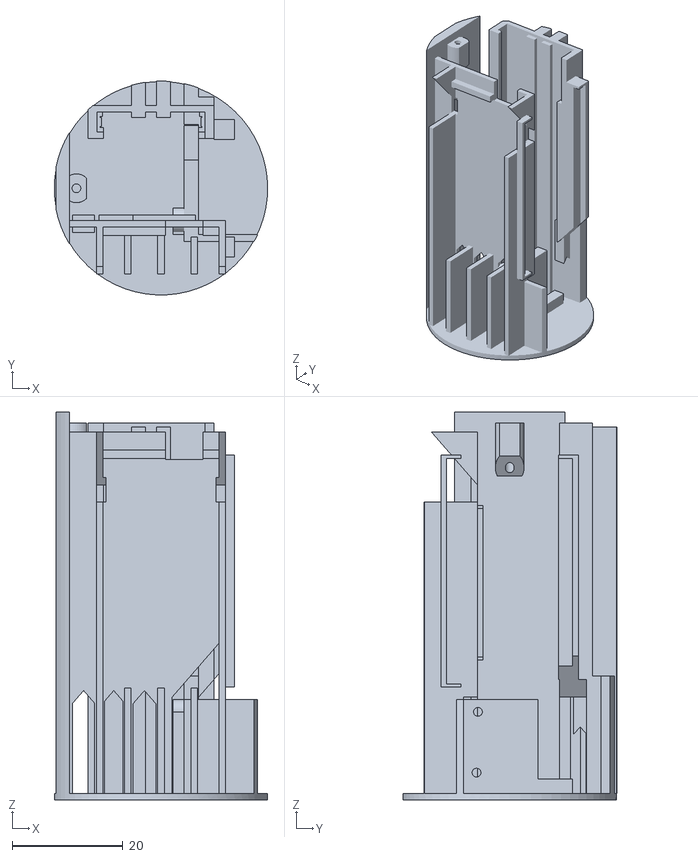
[picture p72: CAD file, 2026-10-21]
PhoenixABS40-43/brag-output/work/assets/PhoenixABS40-43_avbay_ElectronicsSled_v19.stl
38.6 x 38.7 x 70.2
