ItzXyers/Rocketry/PhoenixABS40-43/Models/_render/AftFinCan.stl

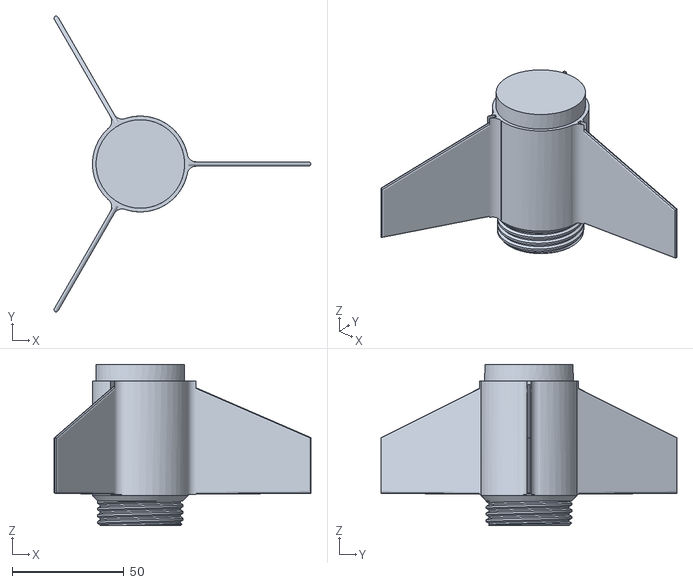
[picture p73: CAD file, 2026-09-17]
PhoenixABS40-43/Models/_render/AftFinCan.stl
115.2 x 132.7 x 72.4
