ItzXyers/Rocketry/PhoenixABS40-43/Nosecone/PhoenixABS40-43_Nosecone_v6.FCStd

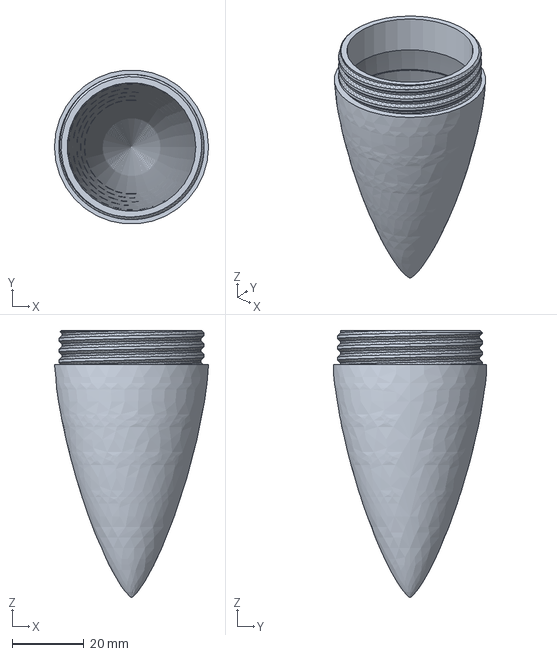
[picture p74: CAD file, 2026-10-01]
PhoenixABS40-43/Nosecone/PhoenixABS40-43_Nosecone_v6.FCStd
43.0 x 42.8 x 74.5 mm
