ItzXyers/Rocketry/PhoenixABS40-43/Print Files/Aft Deploy D9/PhoenixABS40-43_D9aft_v11_AftFinCanSlotted.stl

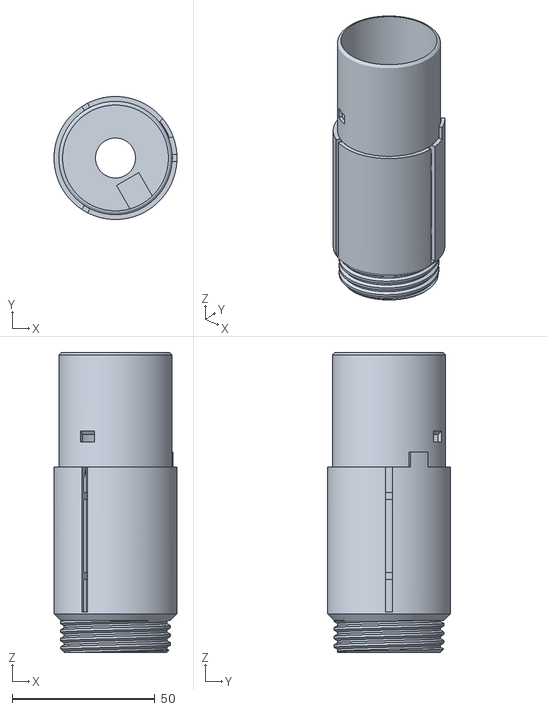
[picture p75: CAD file, 2026-10-21]
PhoenixABS40-43/Print Files/Aft Deploy D9/PhoenixABS40-43_D9aft_v11_AftFinCanSlotted.stl
43.0 x 43.0 x 104.9
