ItzXyers/Rocketry/PhoenixABS40-43/Print Files/Aft Deploy D9/Ready to Print/PhoenixABS40-43_D9aft_v11_AftTube.stl

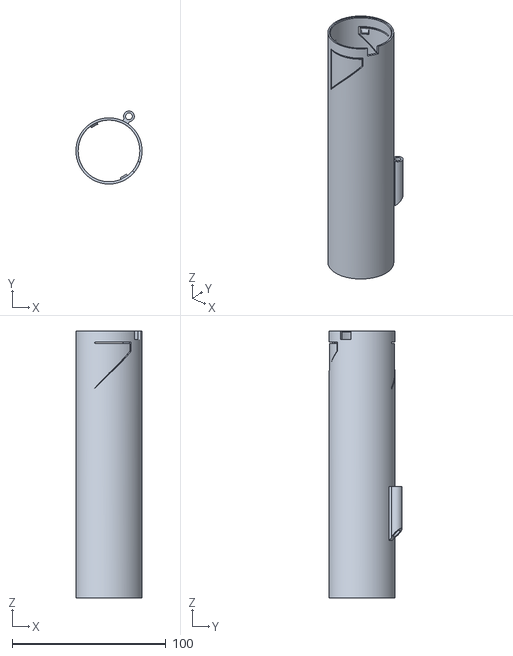
[picture p76: CAD file, 2026-10-21]
PhoenixABS40-43/Print Files/Aft Deploy D9/Ready to Print/PhoenixABS40-43_D9aft_v11_AftTube.stl
43.0 x 47.5 x 173.5
