ItzXyers/Rocketry/PhoenixABS40-43/Print Files/Aft Motor Retention/PhoenixABS40-43_MotorRetainerCap_v1.stl

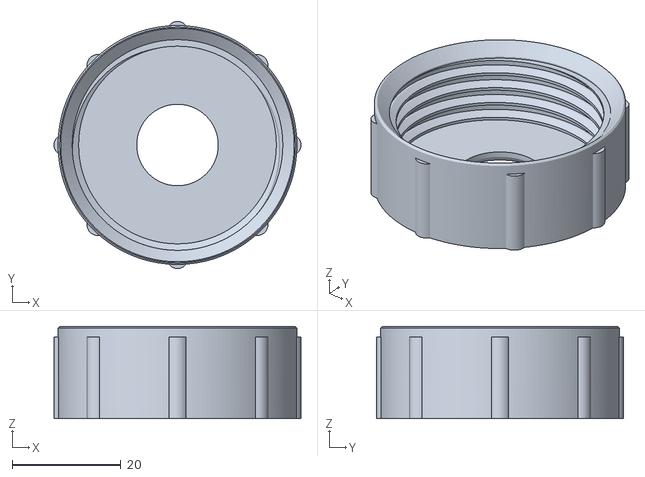
[picture p77: CAD file, 2026-09-17]
PhoenixABS40-43/Print Files/Aft Motor Retention/PhoenixABS40-43_MotorRetainerCap_v1.stl
45.5 x 45.5 x 17.0
