ItzXyers/Rocketry/PhoenixABS40-43/Print Files/Ejection System/PhoenixABS40-43_CatchCollar_v1.stl

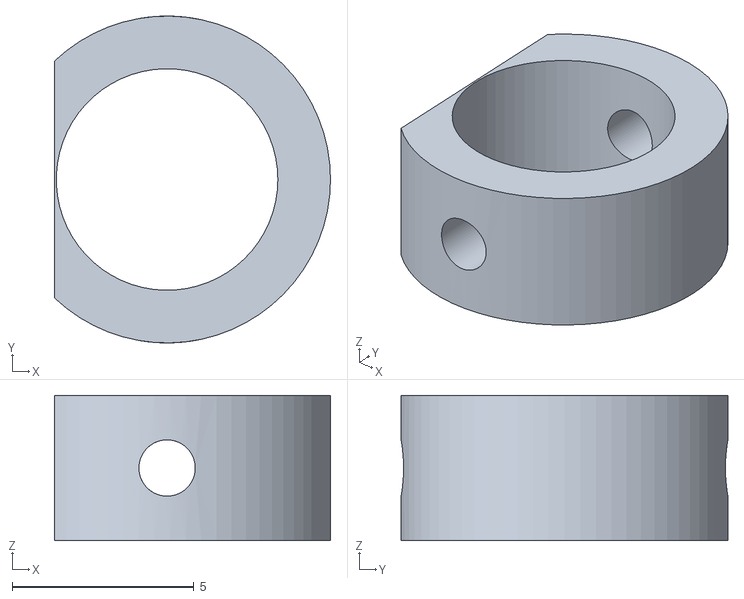
[picture p78: CAD file, 2026-09-17]
PhoenixABS40-43/Print Files/Ejection System/PhoenixABS40-43_CatchCollar_v1.stl
7.60 x 9.00 x 4.00
