ItzXyers/Rocketry/PhoenixABS40-43/Print Files/Ejection System/Print Plate/PhoenixABS40-43_ejection_poc_plate_v1.3mf

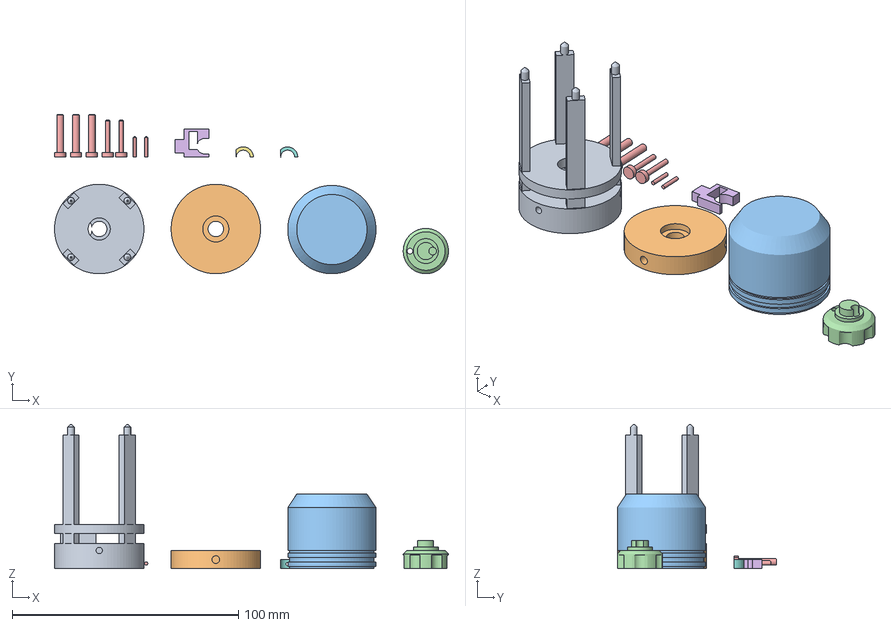
[picture p79: CAD file, 2026-09-17]
PhoenixABS40-43/Print Files/Ejection System/Print Plate/PhoenixABS40-43_ejection_poc_plate_v1.3mf
174.0 x 70.4 x 63.7 mm
Cage
BulkheadDisc
DummyNose
Knob
TestPins
Slider
CatchCollarHalf_B
CatchCollarHalf_A
