ItzXyers/Rocketry/PhoenixABS40-43/Print Files/Ejection System/Ready to Print/PhoenixABS40-43_BulkheadDisc_v1.stl

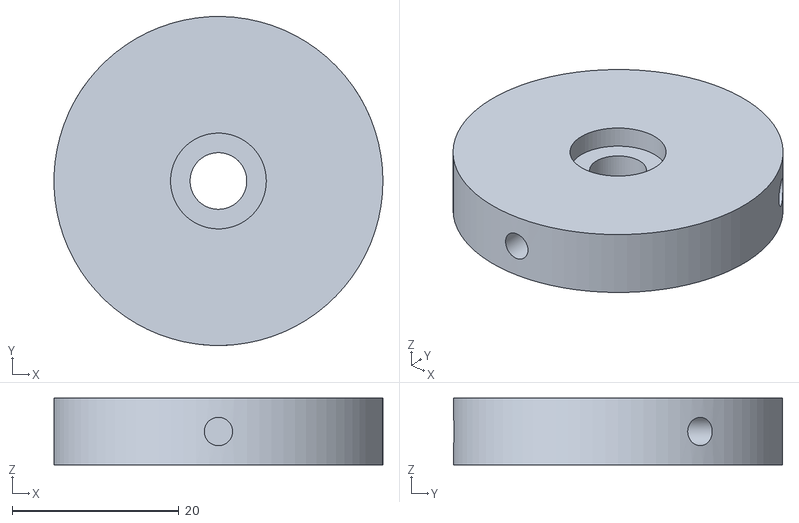
[picture p80: CAD file, 2026-09-17]
PhoenixABS40-43/Print Files/Ejection System/Ready to Print/PhoenixABS40-43_BulkheadDisc_v1.stl
39.5 x 39.5 x 8.00
