ItzXyers/Rocketry/PhoenixABS40-43/Print Files/Launch Pad/Bambu X1C/Phoenix_LaunchPad_plate2_PadHub_v1_PadLeg_x3_v2_0.20mm.3mf

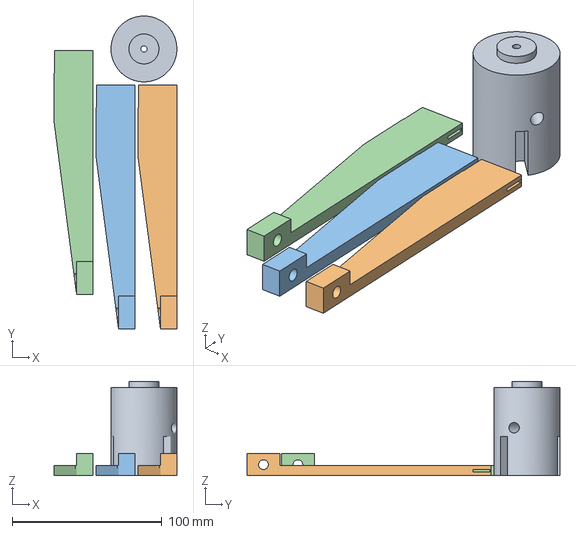
[picture p81: CAD file, 2026-10-29]
PhoenixABS40-43/Print Files/Launch Pad/Bambu X1C/Phoenix_LaunchPad_plate2_PadHub_v1_PadLeg_x3_v2_0.20mm.3mf
82.0 x 209.0 x 63.0 mm
PhoenixABS40-43_PadHub_v1.stl
PhoenixABS40-43_PadLeg_v2.stl x 3
