ItzXyers/Rocketry/PhoenixABS40-43/Print Files/Launch Pad/PhoenixABS40-43_StopPost_v2.stl

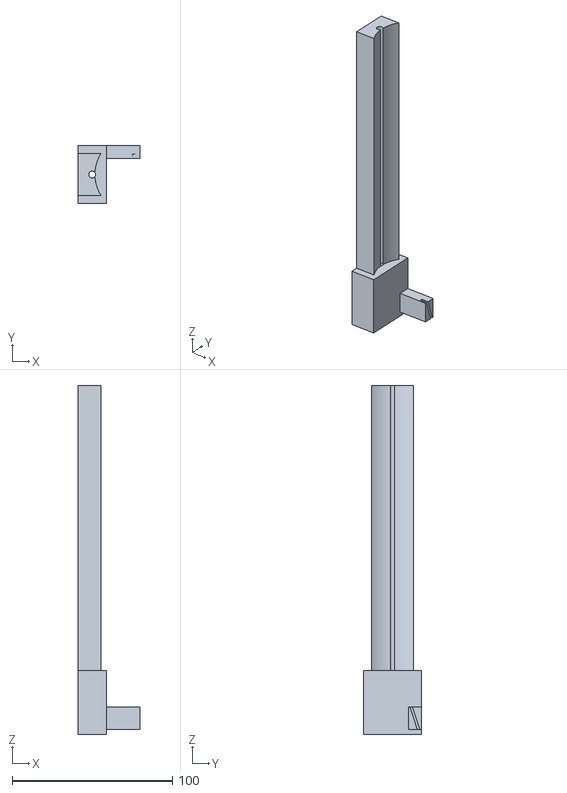
[picture p82: CAD file, 2026-10-29]
PhoenixABS40-43/Print Files/Launch Pad/PhoenixABS40-43_StopPost_v2.stl
39.0 x 36.0 x 217.5
