ItzXyers/Rocketry/PhoenixABS40-43/Print Files/Launch Pad/Ready to Print/PhoenixABS40-43_PadLeg_v2.stl

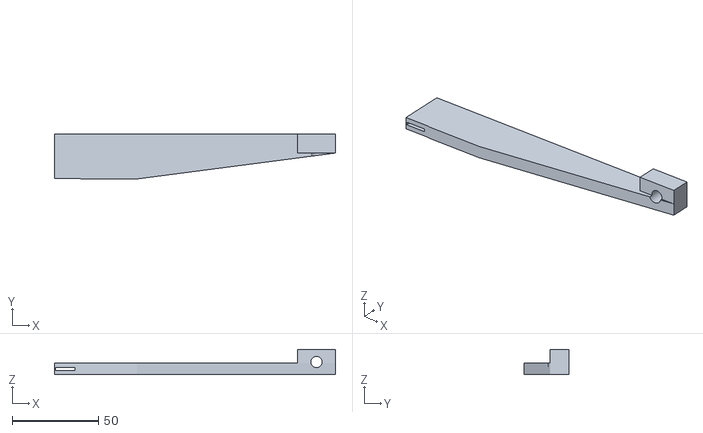
[picture p83: CAD file, 2026-10-29]
PhoenixABS40-43/Print Files/Launch Pad/Ready to Print/PhoenixABS40-43_PadLeg_v2.stl
163.0 x 26.0 x 14.7
