ItzXyers/Rocketry/PhoenixABS40-43/Print Files/Nosecone/Ready to Print/PhoenixABS40-43_nose_VonKarman_v5.stl

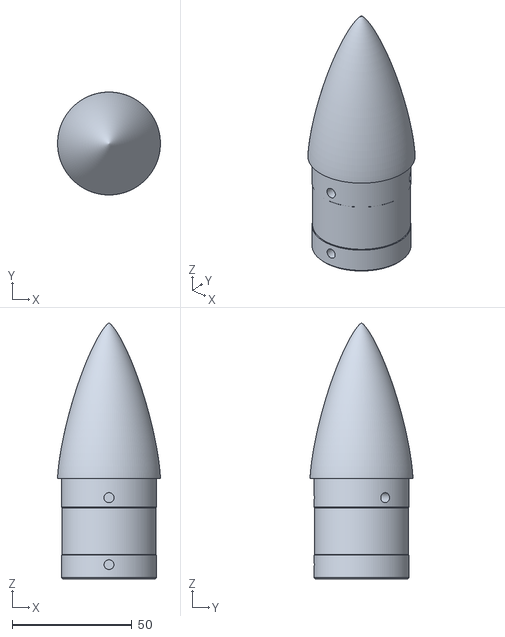
[picture p84: CAD file, 2026-09-24]
PhoenixABS40-43/Print Files/Nosecone/Ready to Print/PhoenixABS40-43_nose_VonKarman_v5.stl
43.0 x 43.0 x 107.0
