ItzXyers/Rocketry/PhoenixABS40-43/Print Files/Ready to Print/D9/Bambu X1C/Phoenix_D9_plate22_ExtensionRing_v13_Sled_v21_TopKeeper_ABSHS_v10.3mf

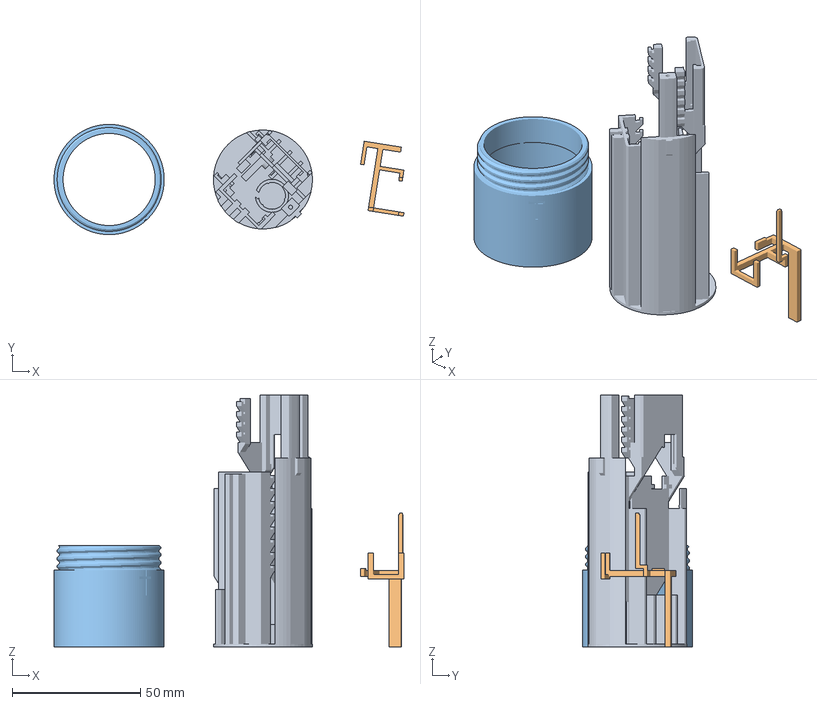
[picture p85: CAD file, 2026-10-29]
PhoenixABS40-43/Print Files/Ready to Print/D9/Bambu X1C/Phoenix_D9_plate22_ExtensionRing_v13_Sled_v21_TopKeeper_ABSHS_v10.3mf
136.5 x 43.0 x 98.2 mm
PhoenixABS40-43_ElectronicsSled_v21.stl
PhoenixABS40-43_TopKeeper_v21.stl
PhoenixABS40-43_D9aft_v13_ExtensionRing.stl
