ItzXyers/Rocketry/SampleRocketABS31-33/Models/SampleRocketABS13.obj

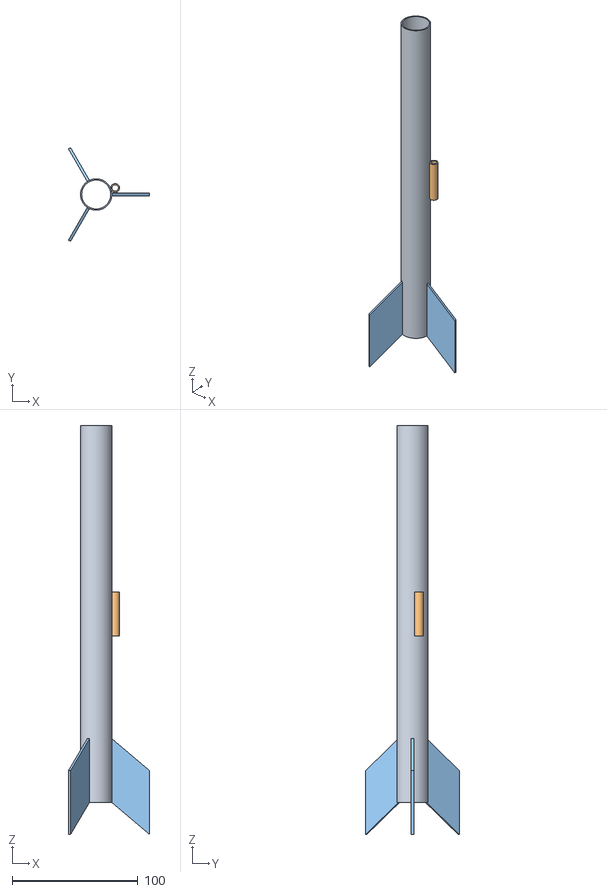
[picture p86: CAD file, 2026-09-17]
SampleRocketABS31-33/Models/SampleRocketABS13.obj
64.6 x 74.6 x 325.4
1_Body tube
2_Launch lug
3_Trapezoidal fin set
