ItzXyers/Rocketry/SampleRocketABS31-33/Print Files/SampleRocketABS13Nose.stl

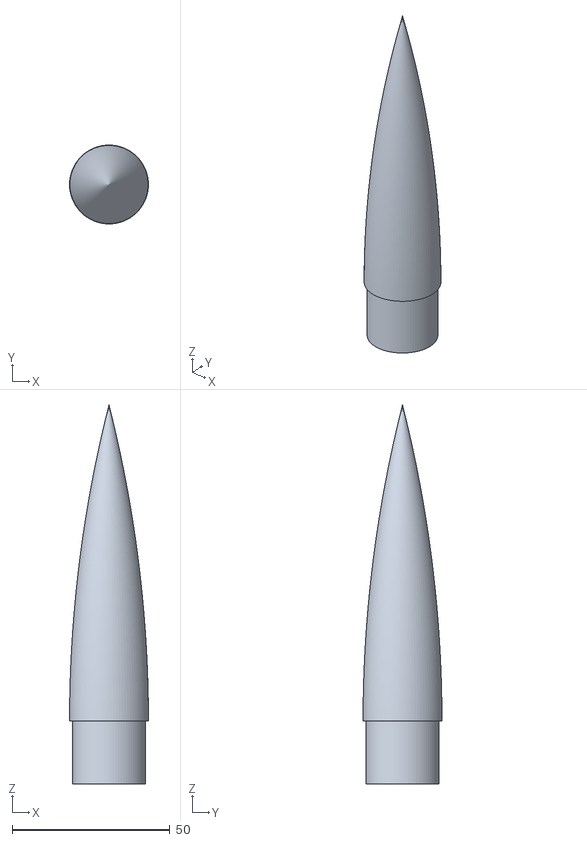
[picture p87: CAD file, 2026-09-17]
SampleRocketABS31-33/Print Files/SampleRocketABS13Nose.stl
25.0 x 25.0 x 120.0
