ItzXyers/Rocketry/SampleRocketABS33-36/.backup-20260818-215039/SampleRocketABSBody33-36_MotorRetainerCap.obj

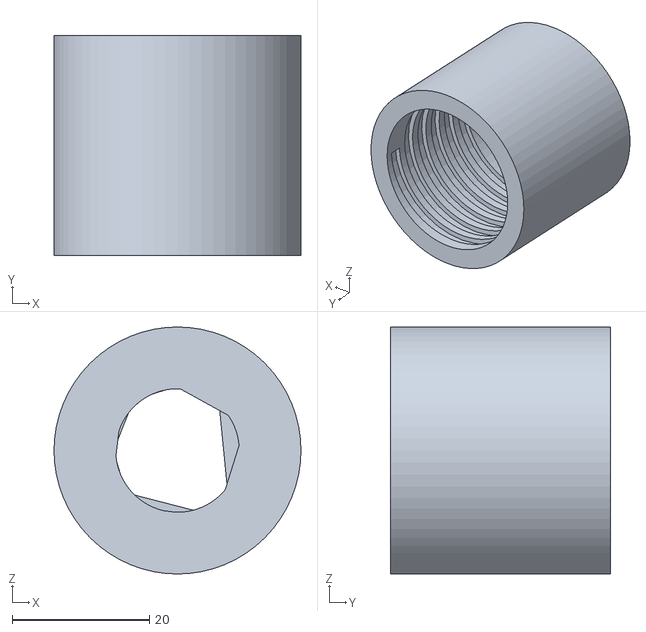
[picture p88: CAD file, 2026-09-17]
SampleRocketABS33-36/.backup-20260818-215039/SampleRocketABSBody33-36_MotorRetainerCap.obj
36.0 x 32.0 x 36.0
