ItzXyers/Rocketry/SampleRocketABS33-36/.backup-avbay-20260819-155709/Print Files/SampleRocketABSBody33-36_Fwd.stl

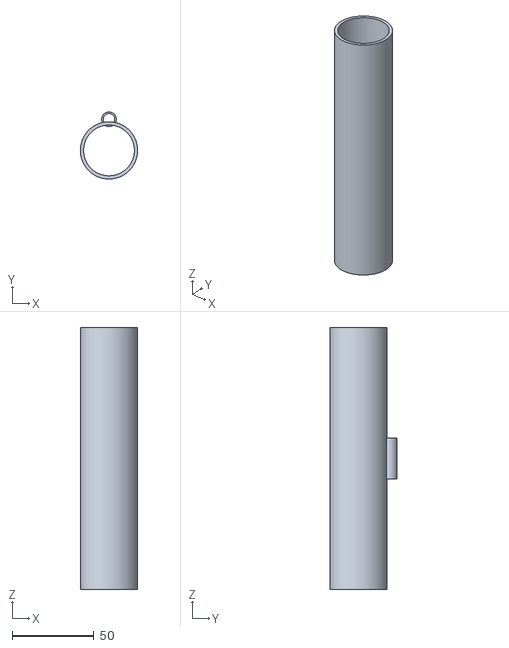
[picture p89: CAD file, 2026-09-17]
SampleRocketABS33-36/.backup-avbay-20260819-155709/Print Files/SampleRocketABSBody33-36_Fwd.stl
35.0 x 41.0 x 160.0
