ItzXyers/Rocketry/SampleRocketABS33-36/.backup-avbay-20260819-155709/SampleRocketABS33-36.FCStd

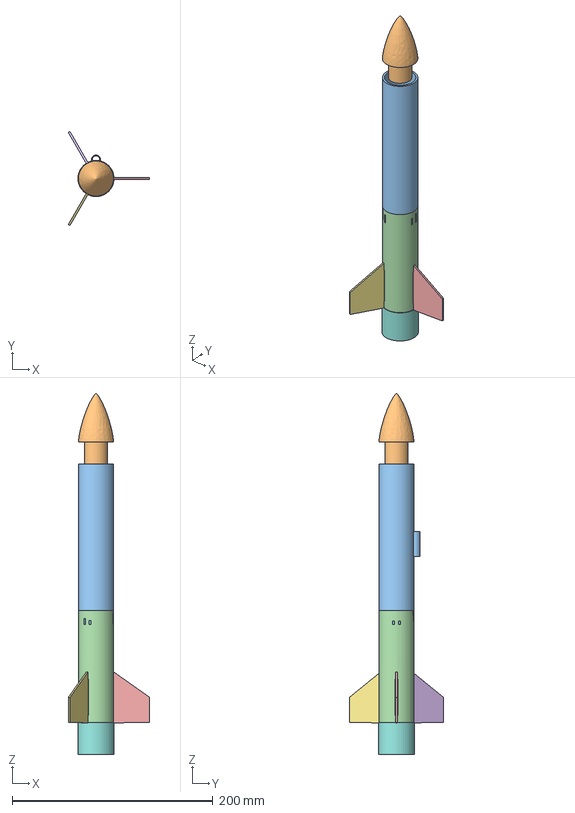
[picture p90: CAD file, 2026-09-17]
SampleRocketABS33-36/.backup-avbay-20260819-155709/SampleRocketABS33-36.FCStd
81.1 x 93.7 x 359.5 mm
Aft Centering Ring - Bulkhead
Nosecone
Body_Fwd (with launch lug)
Body_Aft (tube + retention screw + centering rings + thrust bulkhead)
Fin_A (fin, root at theta=0 deg)
Fin_B (fin, root at theta=120 deg)
Fin_C (fin, root at theta=240 deg)
Motor Retainer Cap
