ItzXyers/Rocketry/SampleRocketABS33-36/.backup-parachutebay-20260826-221240/Print Files/Assembled Sections/SampleRocketABS33-36_FWD.stl

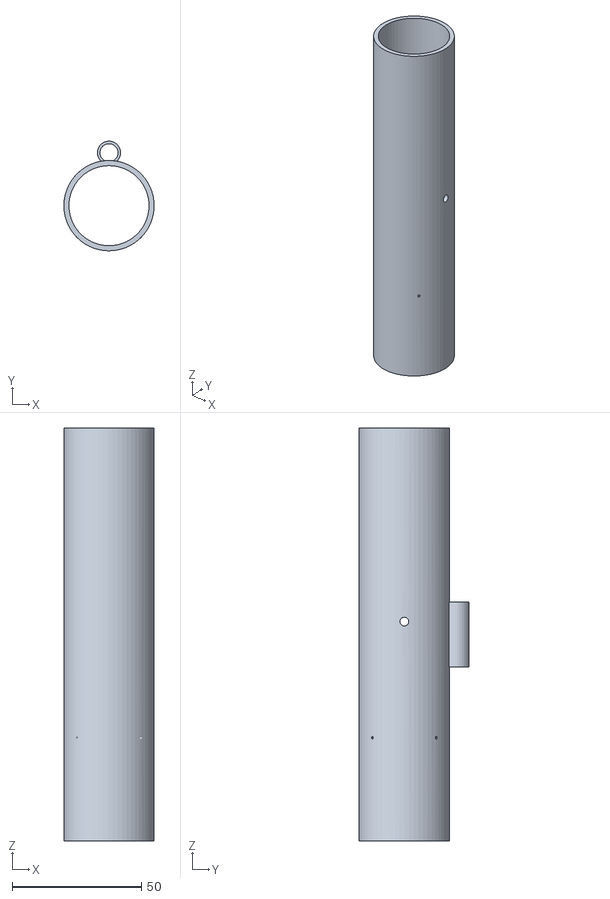
[picture p92: CAD file, 2026-09-17]
SampleRocketABS33-36/.backup-parachutebay-20260826-221240/Print Files/Assembled Sections/SampleRocketABS33-36_FWD.stl
35.0 x 42.5 x 160.0
