ItzXyers/Rocketry/SampleRocketABS33-36/.backup-parachutebay-20260826-221240/Print Files/SampleRocketABSBody33-36_Fin_x3.3mf

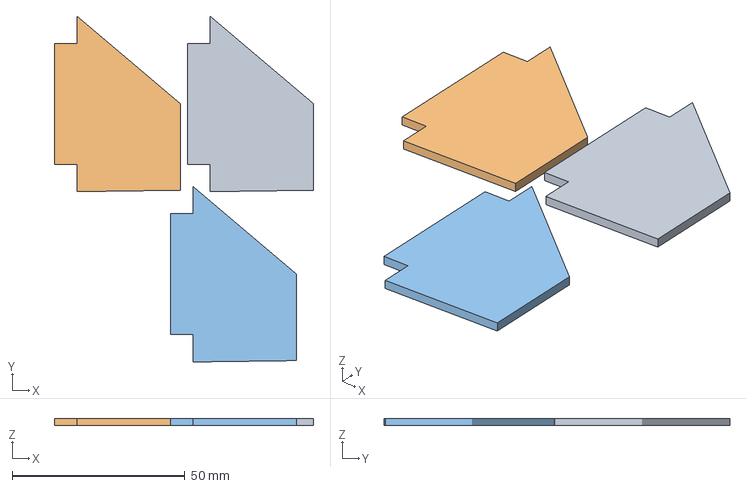
[picture p93: CAD file, 2026-09-17]
SampleRocketABS33-36/.backup-parachutebay-20260826-221240/Print Files/SampleRocketABSBody33-36_Fin_x3.3mf
75.0 x 100.1 x 2.00 mm
SampleRocketABSBody33-36_Fin_x3.stl x 3
