ItzXyers/Rocketry/SampleRocketABS33-36/.backup-thrustring-20260826-221932/Print Files/Assembled Sections/SampleRocketABS33-36_AFT.stl

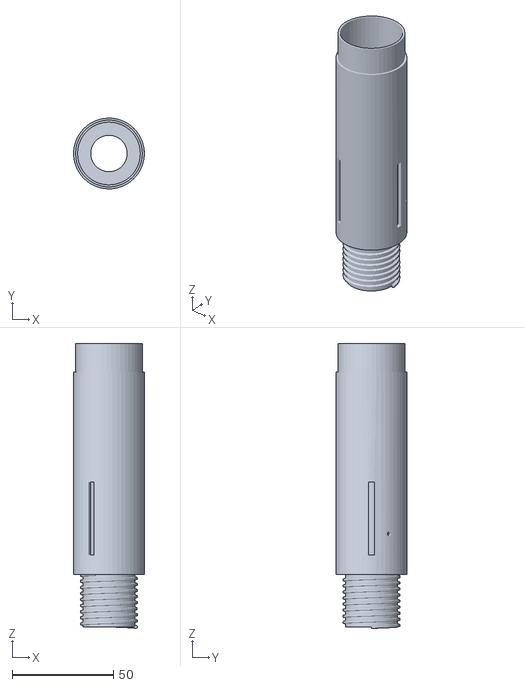
[picture p94: CAD file, 2026-09-17]
SampleRocketABS33-36/.backup-thrustring-20260826-221932/Print Files/Assembled Sections/SampleRocketABS33-36_AFT.stl
35.0 x 35.0 x 140.8
