ItzXyers/Rocketry/SampleRocketABS33-36/LaunchLugMeasure.FCStd

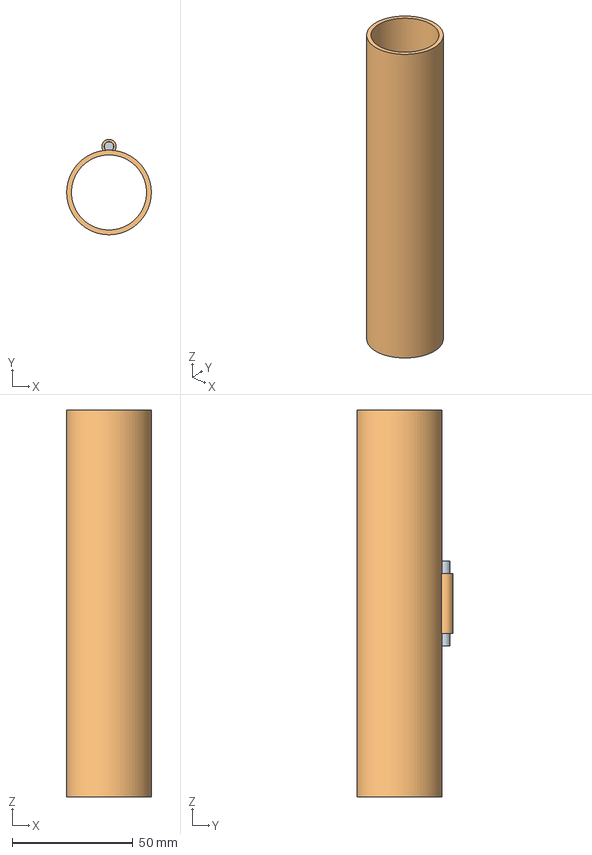
[picture p95: CAD file, 2026-09-17]
SampleRocketABS33-36/LaunchLugMeasure.FCStd
35.0 x 39.5 x 160.0 mm
TestRod
Fwd_Lug
