ItzXyers/Rocketry/SampleRocketABS33-36/Print Files/Nose_BallastCup.stl

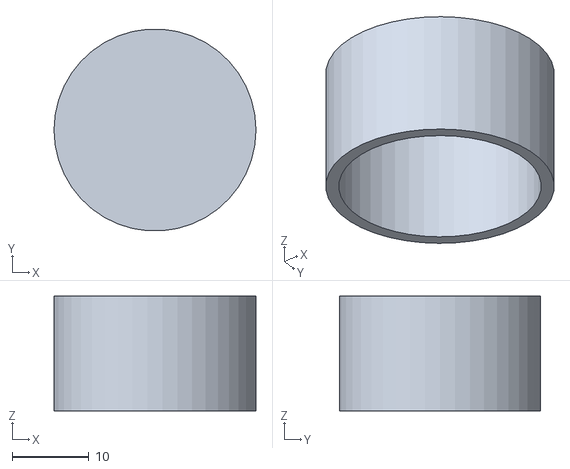
[picture p97: CAD file, 2026-09-17]
SampleRocketABS33-36/Print Files/Nose_BallastCup.stl
26.4 x 26.3 x 15.0
