ItzXyers/Rocketry/Ejection System T3/Phoenix3D_FreeCAD/Phoenix3D_d78_servo.FCStd

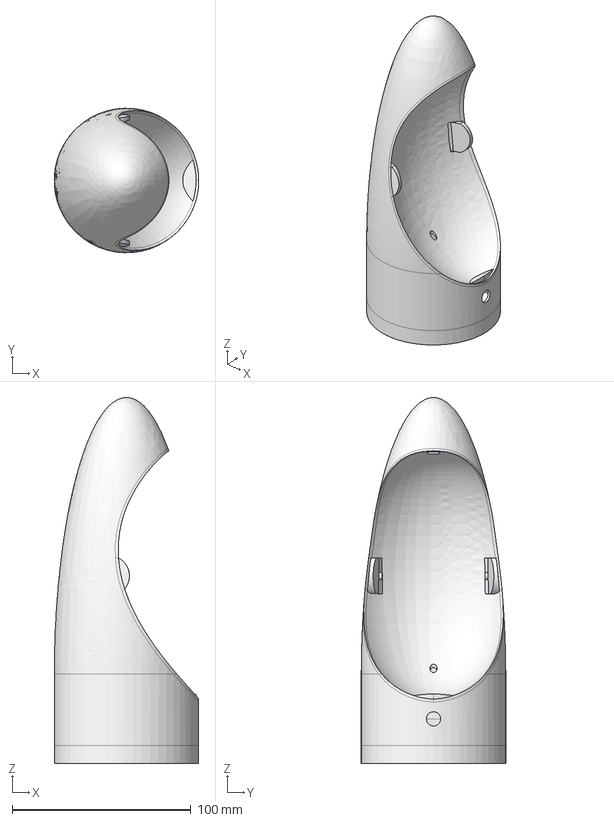
[picture p98: CAD file, 2026-09-17]
Ejection System T3/Phoenix3D_FreeCAD/Phoenix3D_d78_servo.FCStd
80.9 x 81.0 x 205.0 mm
