ItzXyers/Rocketry/Ejection System T4/Models/step_body.step

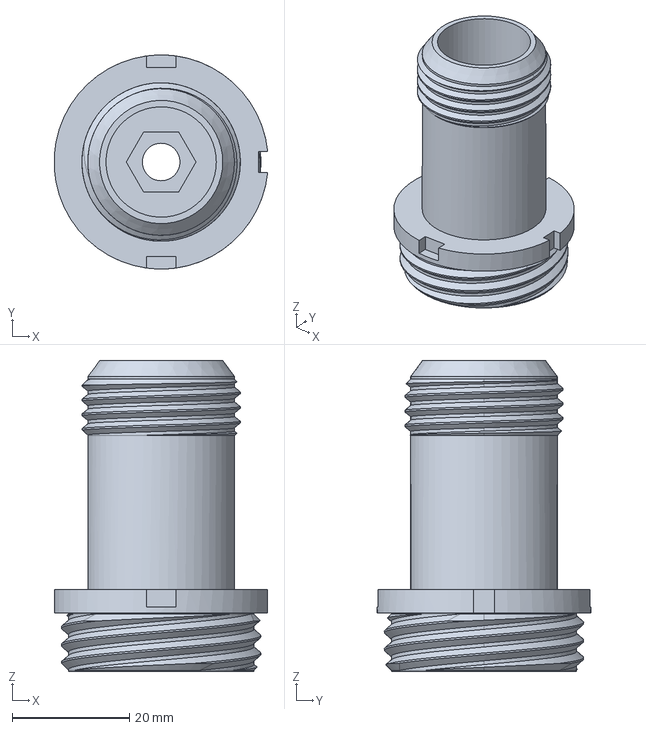
[picture p99: CAD file, 2026-09-24]
Ejection System T4/Models/step_body.step
36.4 x 36.5 x 53.0 mm
