ItzXyers/Rocketry/Ejection System T5/Models/spring_ejector_t5_v4.FCStd

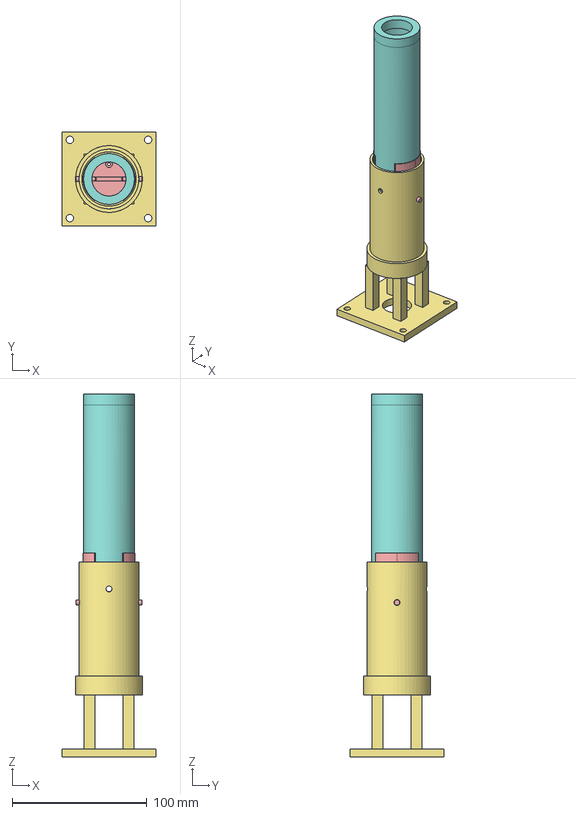
[picture p100: CAD file, 2026-10-01]
Ejection System T5/Models/spring_ejector_t5_v4.FCStd
70.0 x 70.0 x 269.0 mm
base
piston
spacer_2mm
spacer_4mm
spacer_8mm
flight_bulkhead
test_stand
install_tool
coupon_T1_male
coupon_T1_female
HW_rod_M5x40
HW_spring_envelope
HW_rbf_pin
HW_M2_nterm1
HW_M2_nterm2
HW_M2_eterm1
HW_M2_eterm2
HW_nichrome_coil
REF_line_loop
REF_knot
REF_piston_fired
