ItzXyers/Rocketry/Ejection System T5/Print Files/Integrated/t5i_ebay_section.stl

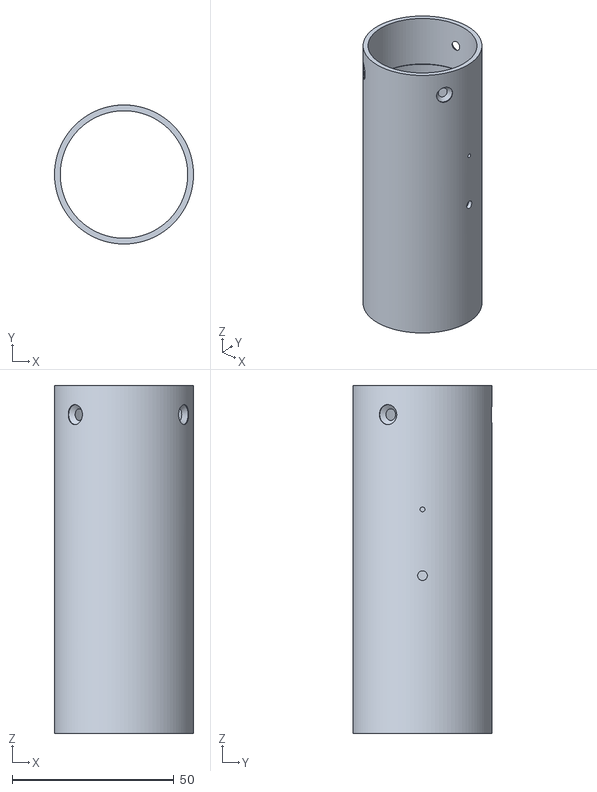
[picture p101: CAD file, 2026-09-24]
Ejection System T5/Print Files/Integrated/t5i_ebay_section.stl
43.0 x 43.0 x 107.6
