ItzXyers/Rocketry/Ejection System T5/Print Files/t5v4_piston.stl

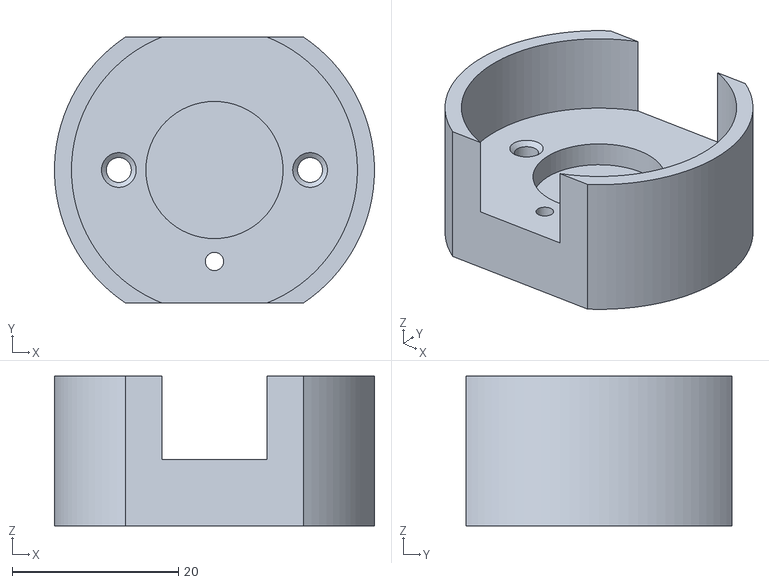
[picture p102: CAD file, 2026-10-01]
Ejection System T5/Print Files/t5v4_piston.stl
38.5 x 32.0 x 18.0
