ItzXyers/Rocketry/Electronics/Avionics/avionics_spine.stl

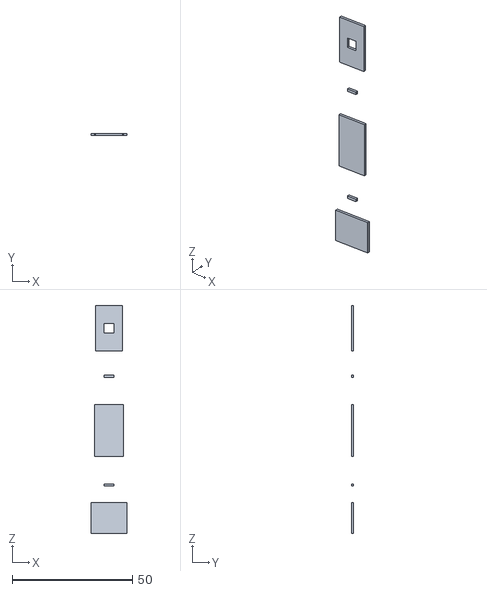
[picture p103: CAD file, 2026-09-17]
Electronics/Avionics/avionics_spine.stl
14.9 x 1.00 x 94.9
