ItzXyers/Rocketry/Electronics/CO2 Deployment/co2_chamber.stl

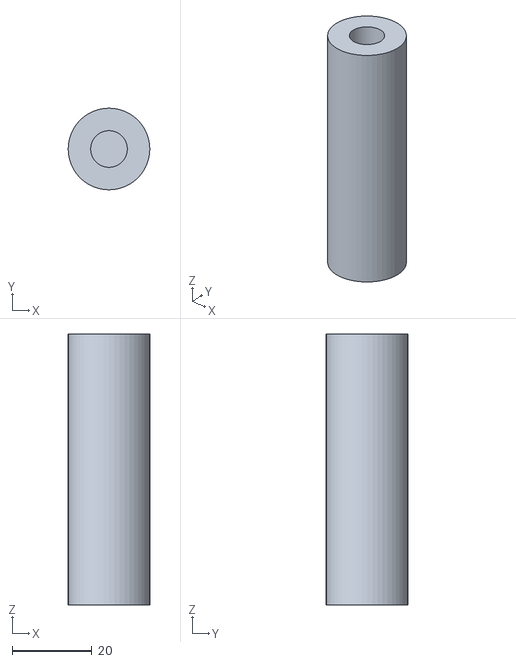
[picture p104: CAD file, 2026-09-17]
Electronics/CO2 Deployment/co2_chamber.stl
20.5 x 20.5 x 68.0
