ItzXyers/Rocketry/Electronics/Unsorted/payload_bay_sled.stl

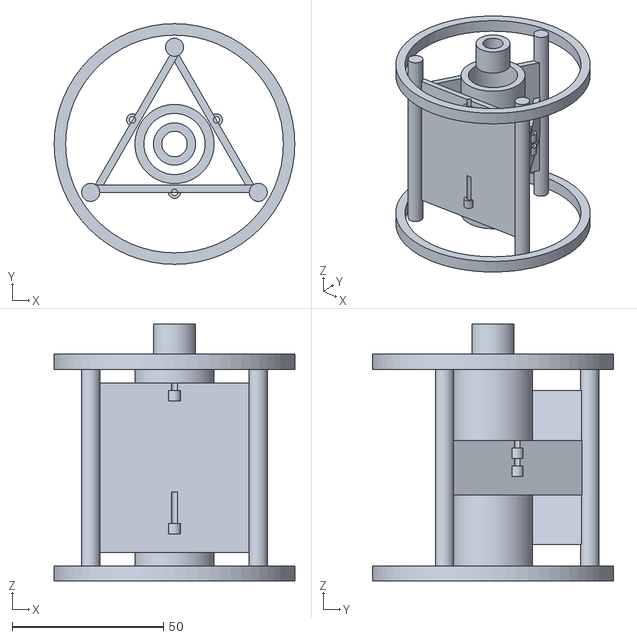
[picture p105: CAD file, 2026-09-17]
Electronics/Unsorted/payload_bay_sled.stl
79.6 x 79.6 x 85.0
