ItzXyers/Rocketry/OpenRocket Designs/RocketABS33-36-38mm-nosecone.obj

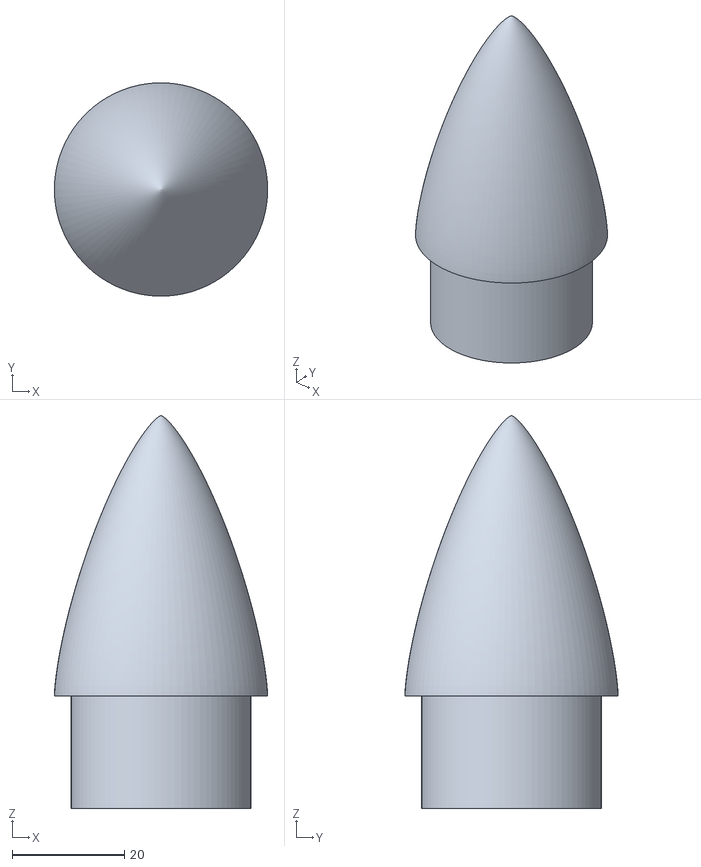
[picture p106: CAD file, 2026-09-17]
OpenRocket Designs/RocketABS33-36-38mm-nosecone.obj
38.0 x 38.0 x 70.0
