ItzXyers/Rocketry/PhoenixABS40-43/Avionics/Models/cassette_assembly_v1/Env_Nano.stl

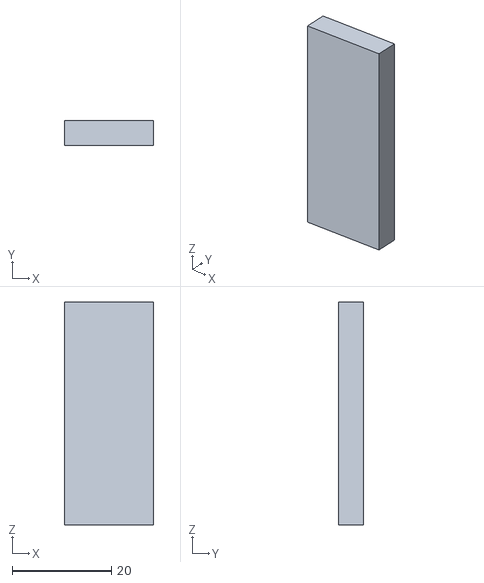
[picture p107: CAD file, 2026-09-17]
PhoenixABS40-43/Avionics/Models/cassette_assembly_v1/Env_Nano.stl
18.0 x 5.00 x 45.0
