ItzXyers/Rocketry/PhoenixABS40-43/Avionics/PhoenixABS40-43_avbay_sled_v21.FCStd

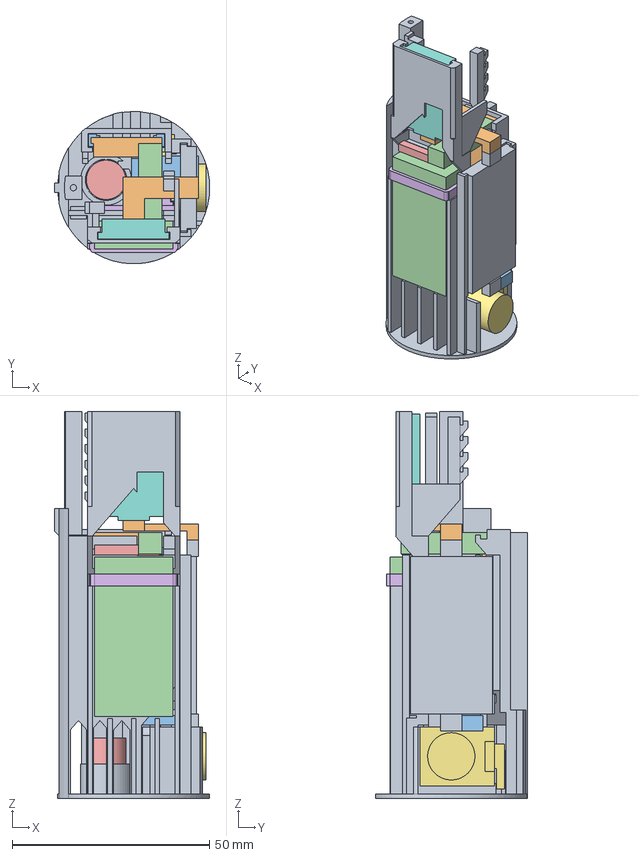
[picture p108: CAD file, 2026-10-29]
PhoenixABS40-43/Avionics/PhoenixABS40-43_avbay_sled_v21.FCStd
39.5 x 38.7 x 98.2 mm
Sled
env_Nano_ESP32
env_Nano_joints
env_JST_power
env_C1_470uF
env_S7V8F5
env_Piezo_Q1
env_ADXL375
env_BMP388
env_Qwiic_ADXL_BMP
env_Qwiic_BMP_Nano
env_Battery
env_Battery_lead
env_ZipTie
