ItzXyers/Rocketry/PhoenixABS40-43/Models/_render/FwdTubeStub.stl

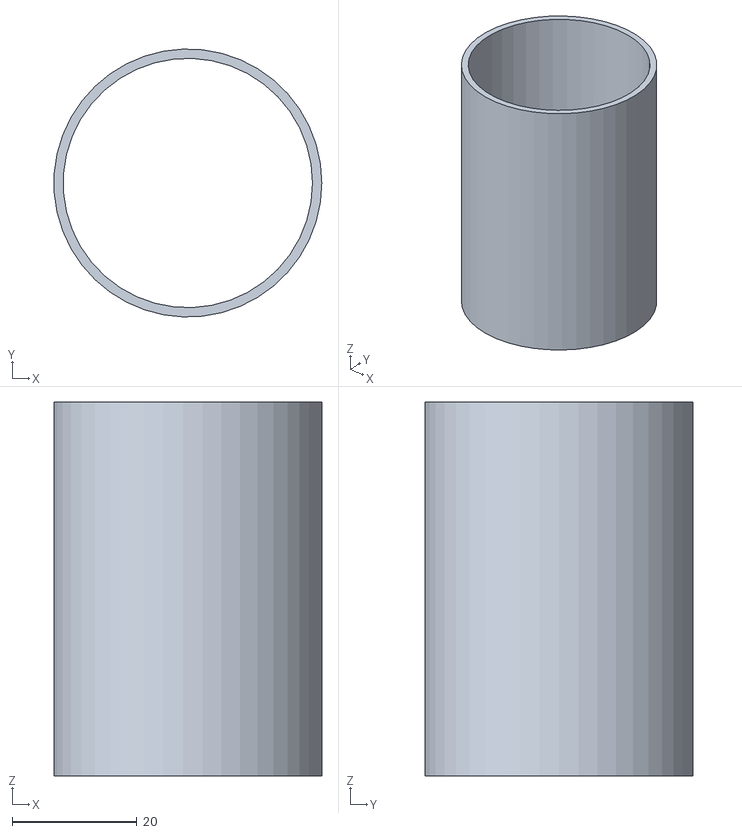
[picture p109: CAD file, 2026-09-17]
PhoenixABS40-43/Models/_render/FwdTubeStub.stl
42.9 x 43.0 x 60.0
