ItzXyers/Rocketry/PhoenixABS40-43/Print Files/Aft Motor Retention/PhoenixABS40-43_AftRetainerBase_v1.stl

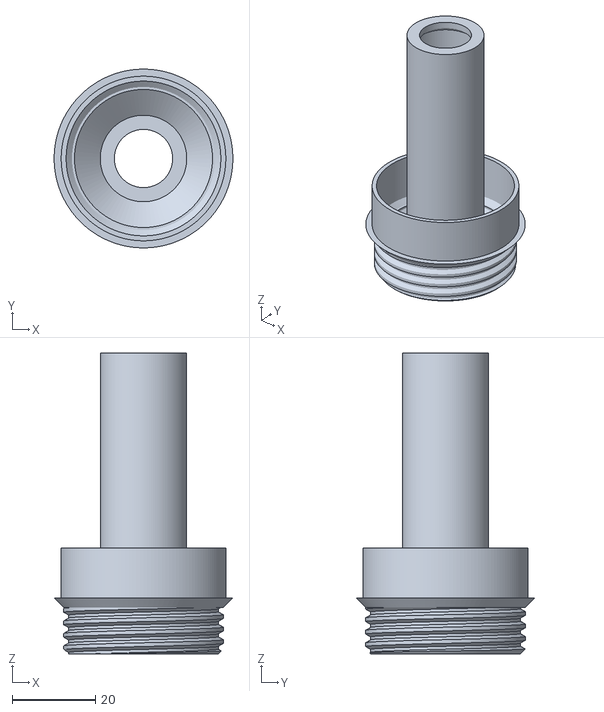
[picture p110: CAD file, 2026-09-17]
PhoenixABS40-43/Print Files/Aft Motor Retention/PhoenixABS40-43_AftRetainerBase_v1.stl
43.0 x 43.0 x 72.4
