ItzXyers/Rocketry/PhoenixABS40-43/Print Files/Ejection System/PhoenixABS40-43_TubeStub_v1.stl

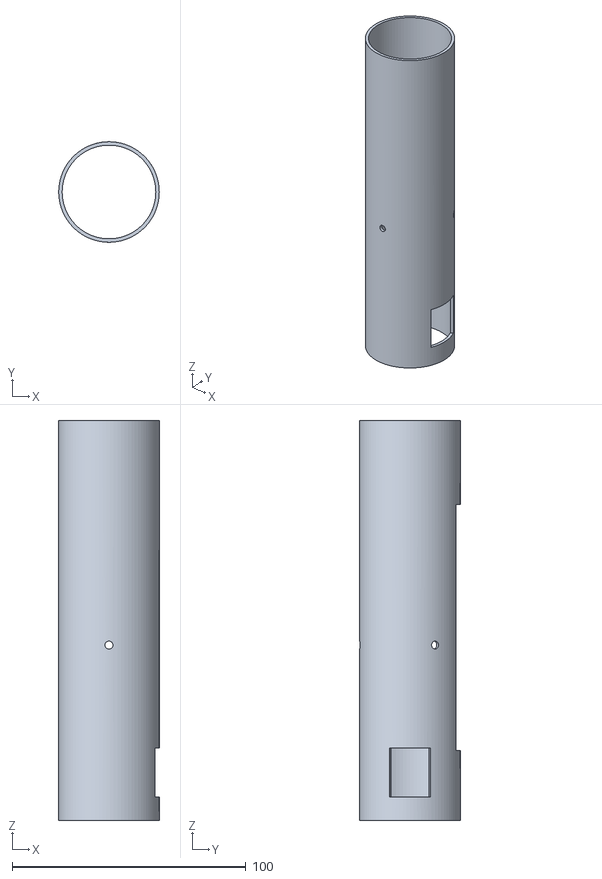
[picture p111: CAD file, 2026-09-17]
PhoenixABS40-43/Print Files/Ejection System/PhoenixABS40-43_TubeStub_v1.stl
43.0 x 43.0 x 171.0
