ItzXyers/Rocketry/PhoenixABS40-43/Print Files/Ejection System/Ready to Print/PhoenixABS40-43_Slider_v1.stl

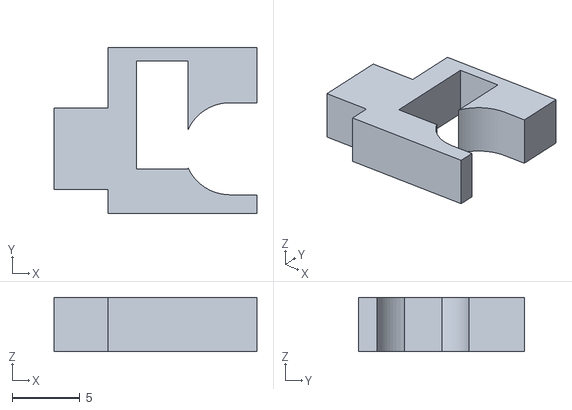
[picture p112: CAD file, 2026-09-17]
PhoenixABS40-43/Print Files/Ejection System/Ready to Print/PhoenixABS40-43_Slider_v1.stl
15.0 x 12.3 x 4.00
