ItzXyers/Rocketry/PhoenixABS40-43/Print Files/Launch Pad/PhoenixABS40-43_BlastDeflector_v1.stl

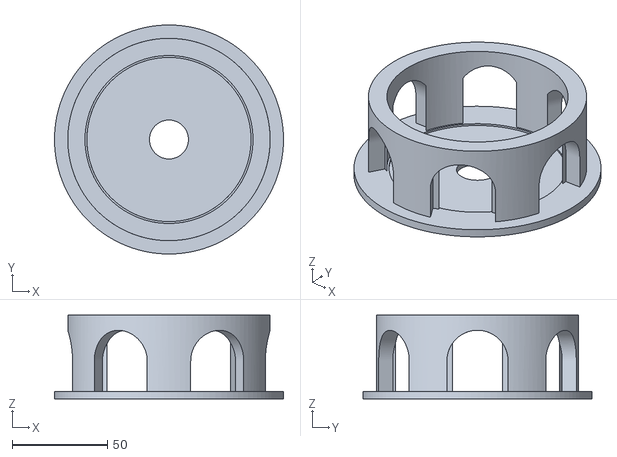
[picture p113: CAD file, 2026-09-17]
PhoenixABS40-43/Print Files/Launch Pad/PhoenixABS40-43_BlastDeflector_v1.stl
120.0 x 120.0 x 44.0
