ItzXyers/Rocketry/PhoenixABS40-43/Print Files/Ready to Print/D9/Bambu X1C/Phoenix_D9_plate16_ExtensionRing_v13_ABSHS_0.16mm.3mf

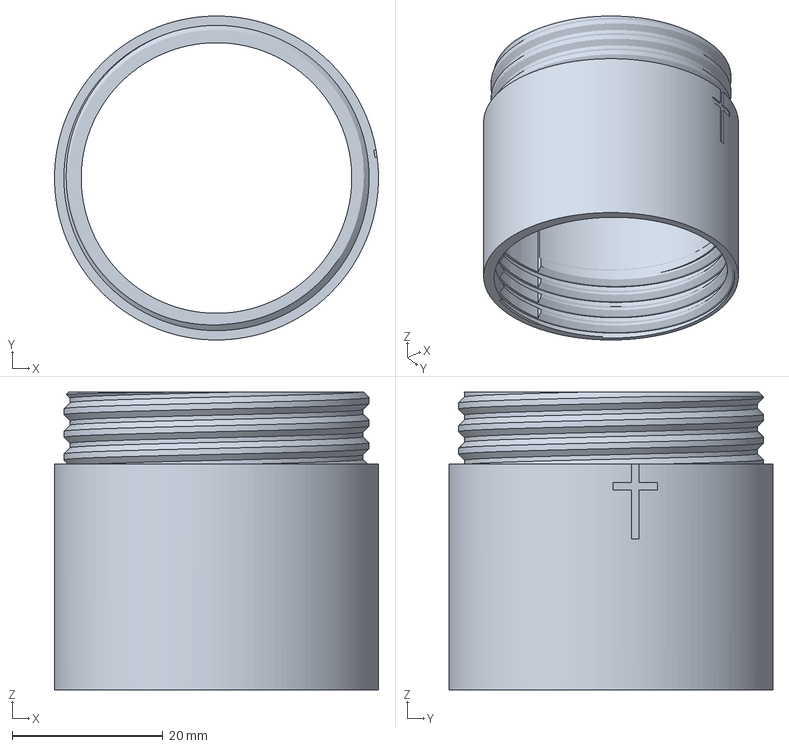
[picture p114: CAD file, 2026-10-29]
PhoenixABS40-43/Print Files/Ready to Print/D9/Bambu X1C/Phoenix_D9_plate16_ExtensionRing_v13_ABSHS_0.16mm.3mf
43.0 x 43.0 x 39.5 mm
