ItzXyers/Rocketry/SampleRocketABS31-33/Print Files/(standalone) SampleRocketABS13_PART_C_launchlug.stl

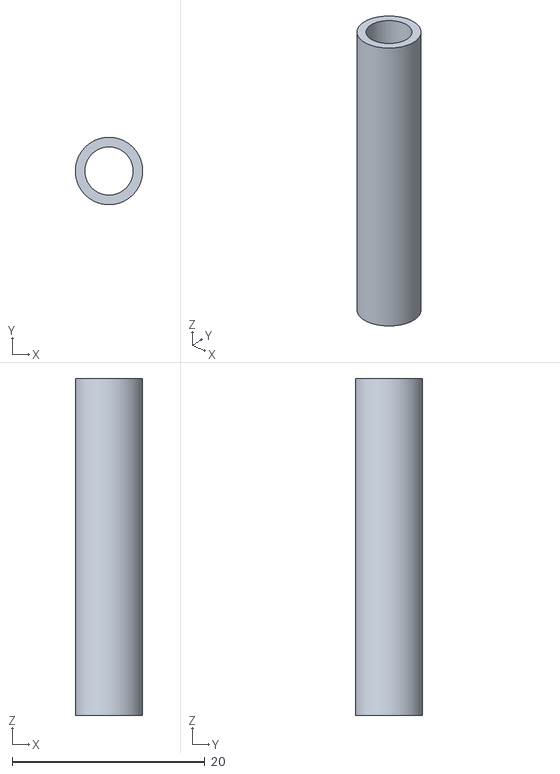
[picture p115: CAD file, 2026-09-17]
SampleRocketABS31-33/Print Files/(standalone) SampleRocketABS13_PART_C_launchlug.stl
7.00 x 7.00 x 35.0
