ItzXyers/Rocketry/SampleRocketABS33-36/.backup-20260818-215039/SampleRocketABSBody33-36_Fin_x3.stl

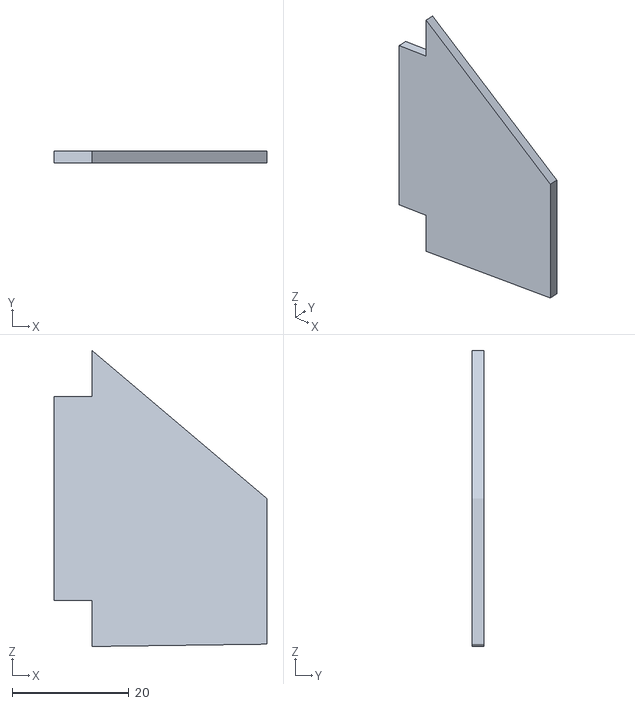
[picture p116: CAD file, 2026-09-17]
SampleRocketABS33-36/.backup-20260818-215039/SampleRocketABSBody33-36_Fin_x3.stl
36.5 x 2.00 x 50.8
