ItzXyers/Rocketry/SampleRocketABS33-36/.backup-parachutebay-20260826-221240/Print Files/Assembled Sections/SampleRocketABS33-36_NOSECONE.stl

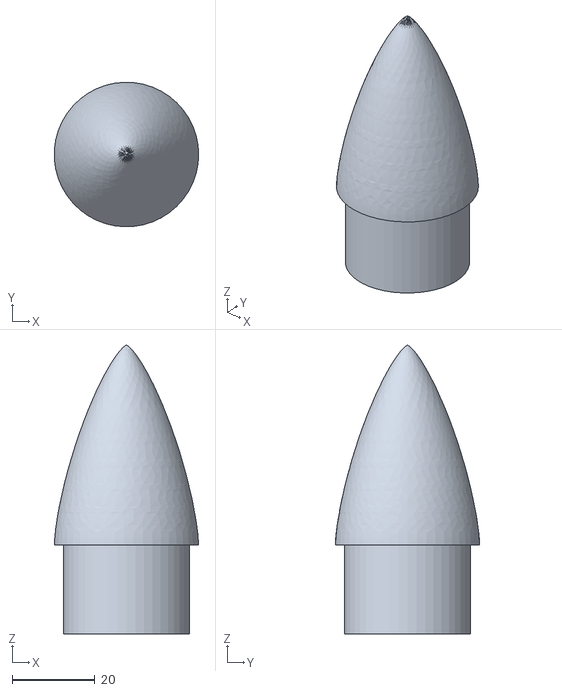
[picture p117: CAD file, 2026-09-17]
SampleRocketABS33-36/.backup-parachutebay-20260826-221240/Print Files/Assembled Sections/SampleRocketABS33-36_NOSECONE.stl
35.0 x 35.0 x 70.0
