ItzXyers/Rocketry/SampleRocketABS33-36/.backup-parachutebay-20260826-221240/Print Files/SampleRocketABSBody33-36_MotorRetainerCap.pre-thread-backup.stl

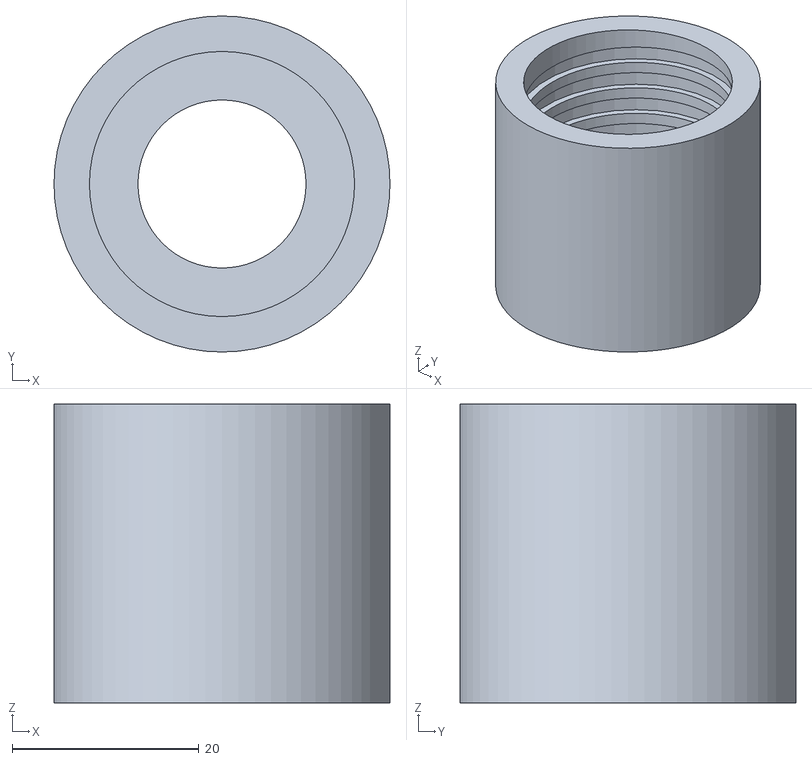
[picture p118: CAD file, 2026-09-17]
SampleRocketABS33-36/.backup-parachutebay-20260826-221240/Print Files/SampleRocketABSBody33-36_MotorRetainerCap.pre-thread-backup.stl
36.0 x 36.0 x 32.0
