ItzXyers/Rocketry/SampleRocketABS33-36/Models/SampleRocketABSBody33-36.3mf

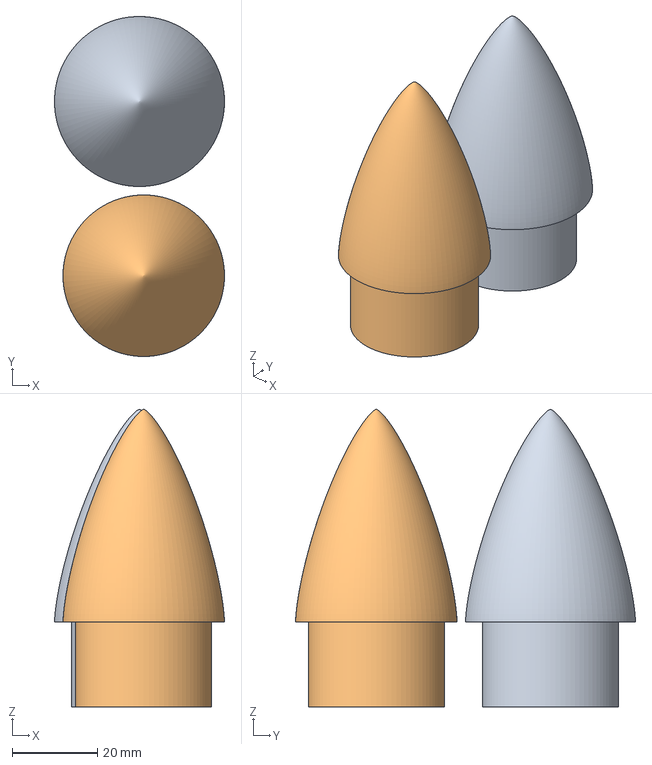
[picture p119: CAD file, 2026-09-17]
SampleRocketABS33-36/Models/SampleRocketABSBody33-36.3mf
40.0 x 80.0 x 70.0 mm
RocketABS33-36-40mm-nosecone.obj
RocketABS33-36-38mm-nosecone.obj
