ItzXyers/Rocketry/SampleRocketABS33-36/SampleRocketABS33-36.FCStd

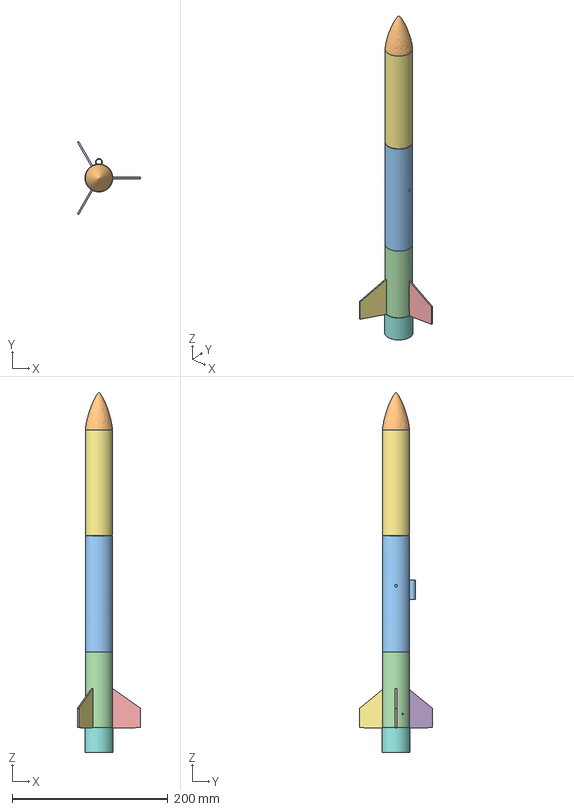
[picture p120: CAD file, 2026-09-17]
SampleRocketABS33-36/SampleRocketABS33-36.FCStd
81.1 x 93.7 x 463.0 mm
Aft Centering Ring - Bulkhead
Nosecone (hollowed 2mm wall, dia30.6 shoulder, ballast cavity, repositioned)
Body_Fwd (launch lug, aft rebate socket, fwd rebate spigot, 4x static ports, 2x M3 collar screws, extended for parachute-bay joint)
Body_Aft (tube + retention screw + centering rings; motor bulkhead at Z64-67 re-bored to dia14 thrust ring)
Fin_A (fin, root at theta=0 deg, full-depth TTW tab)
Fin_B (fin, root at theta=120 deg, full-depth TTW tab)
Fin_C (fin, root at theta=240 deg, full-depth TTW tab)
Motor Retainer Cap
AvBay Aft Bulkhead (Z82-85, pressure boundary)
AvBay Battery Cradle (Z85-125.5)
AvBay Mandrel (Z125.5-183.5, board-ring core)
AvBay Fwd Collar (Z183.5-186.5, pressure boundary)
Nose Ballast Cup (fits nosecone tip cavity)
AvBay Duct Plug (blanks gas port for future CO2 install)
Parachute Bay (dedicated, Z263.5-363.5 clear bore, aft rebate joint to Body_Fwd, fwd nose-shoulder socket)
