ItzXyers/Rocketry/Ejection System T3/Phoenix3D_FreeCAD/Phoenix3D_d78_tommytimer.FCStd

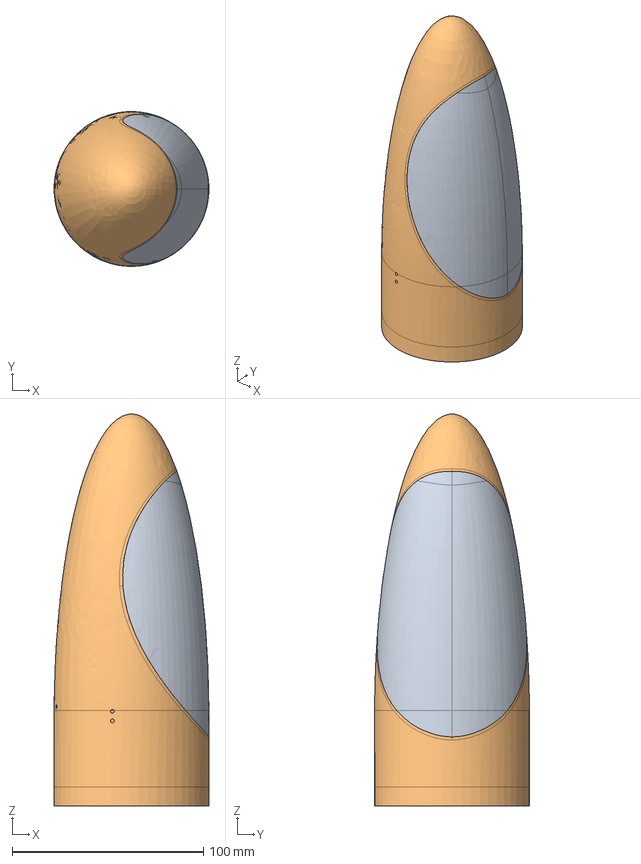
[picture p121: CAD file, 2026-09-17]
Ejection System T3/Phoenix3D_FreeCAD/Phoenix3D_d78_tommytimer.FCStd
81.0 x 81.0 x 205.0 mm
