ItzXyers/Rocketry/Ejection System T4/Print Files/t4_spacer_2mm.stl

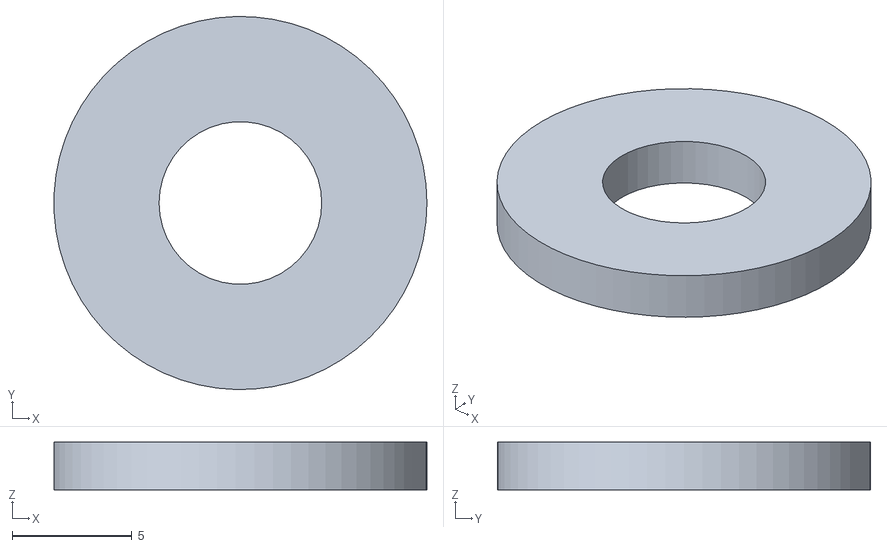
[picture p122: CAD file, 2026-09-24]
Ejection System T4/Print Files/t4_spacer_2mm.stl
15.6 x 15.6 x 2.00
