ItzXyers/Rocketry/Ejection System T5/Print Files/Integrated/t5i_sled_mount.stl

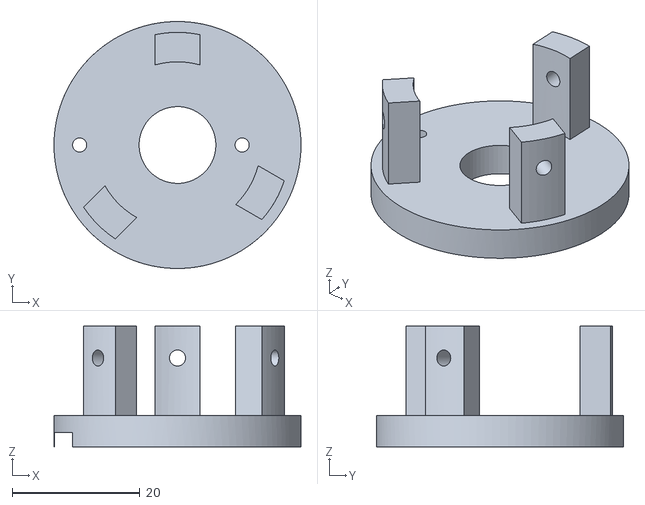
[picture p123: CAD file, 2026-09-24]
Ejection System T5/Print Files/Integrated/t5i_sled_mount.stl
38.6 x 38.6 x 18.9
