ItzXyers/Rocketry/Electronics/CO2 Deployment/co2_striker_housing.stl

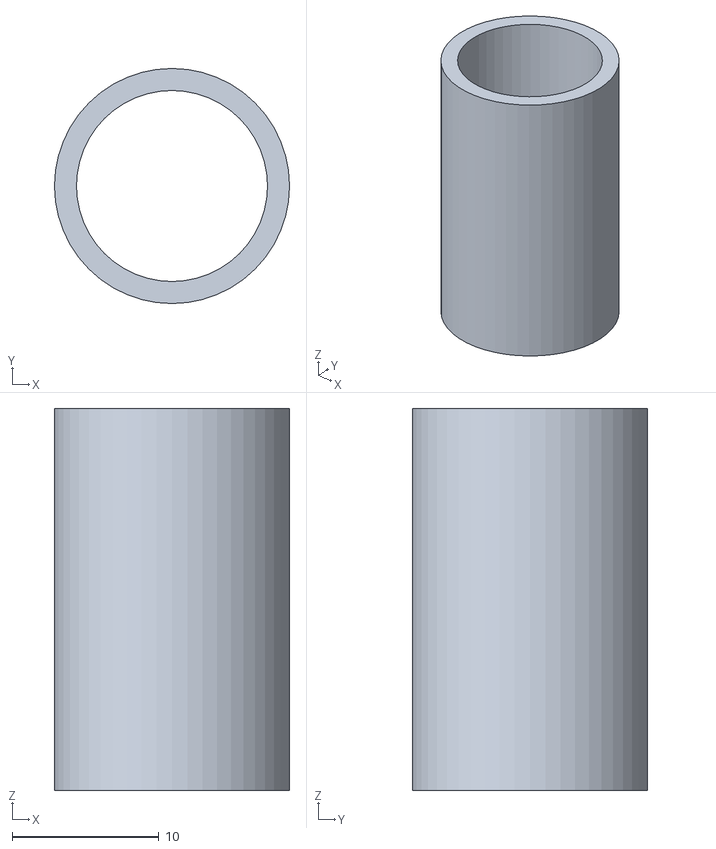
[picture p124: CAD file, 2026-09-17]
Electronics/CO2 Deployment/co2_striker_housing.stl
16.0 x 16.0 x 26.0
