ItzXyers/Rocketry/LaunchPad/Print Files/LaunchPad_Hub.stl

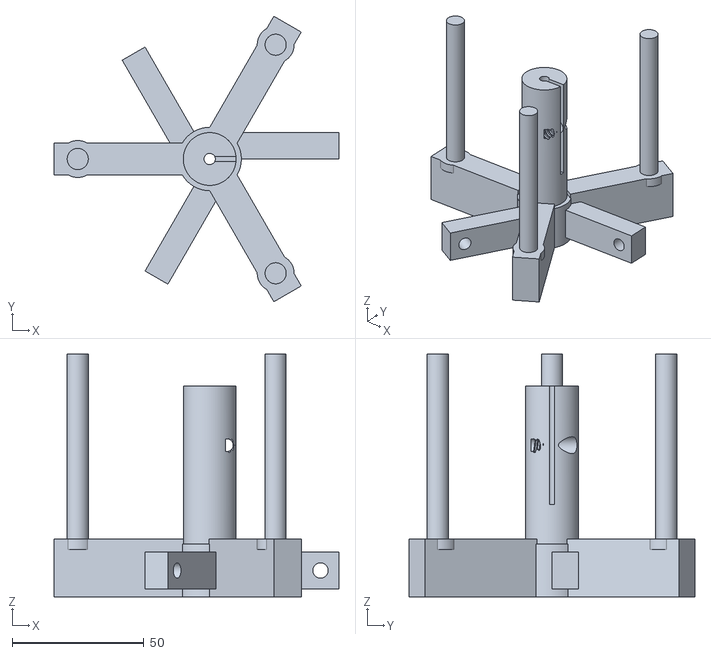
[picture p125: CAD file, 2026-09-17]
LaunchPad/Print Files/LaunchPad_Hub.stl
108.0 x 108.2 x 92.0
