ItzXyers/Rocketry/PhoenixABS40-43/Avionics/Models/cassette_assembly_v1/Env_Battery.stl

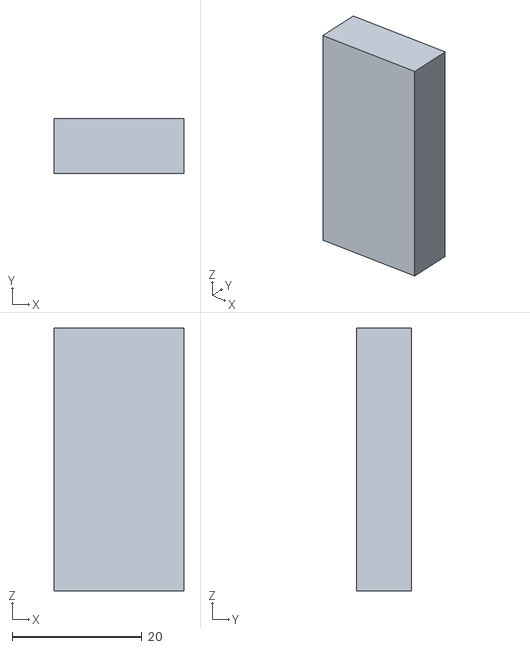
[picture p126: CAD file, 2026-09-17]
PhoenixABS40-43/Avionics/Models/cassette_assembly_v1/Env_Battery.stl
20.0 x 8.50 x 40.5
