ItzXyers/Rocketry/PhoenixABS40-43/Models/_render/DummyMotor.stl

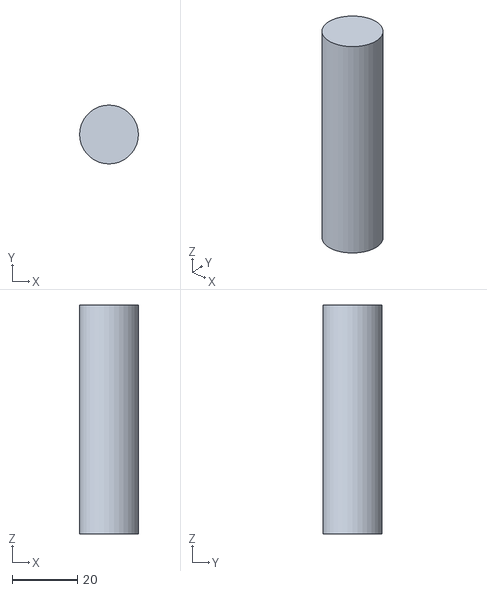
[picture p127: CAD file, 2026-09-17]
PhoenixABS40-43/Models/_render/DummyMotor.stl
18.0 x 18.0 x 70.0
