ItzXyers/Rocketry/PhoenixABS40-43/Print Files/Aft Deploy D9/PhoenixABS40-43_D9aft_v7_EbayCap.stl

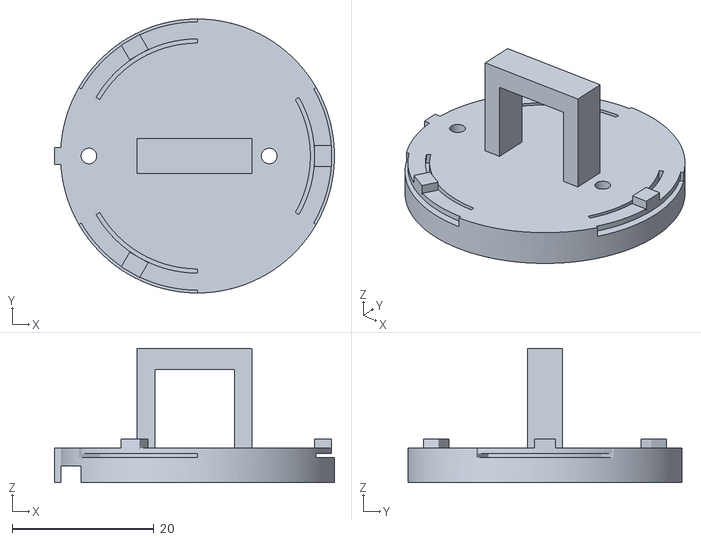
[picture p128: CAD file, 2026-10-07]
PhoenixABS40-43/Print Files/Aft Deploy D9/PhoenixABS40-43_D9aft_v7_EbayCap.stl
39.4 x 38.6 x 18.9
