ItzXyers/Rocketry/PhoenixABS40-43/Print Files/Ejection System/Ready to Print/PhoenixABS40-43_Knob_v1.stl

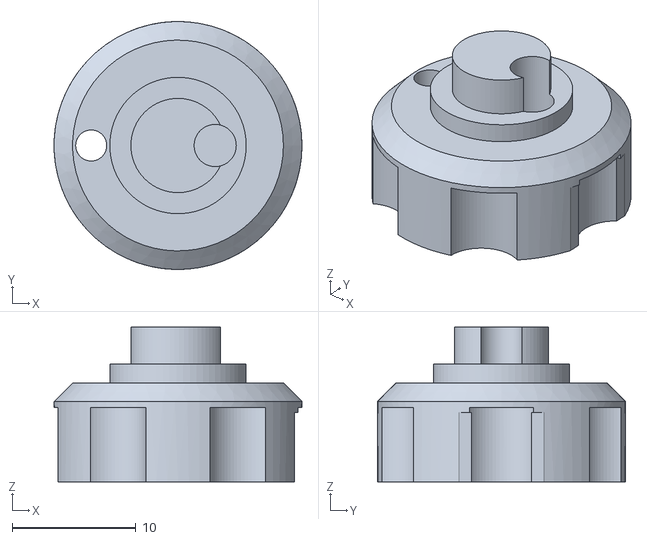
[picture p129: CAD file, 2026-09-17]
PhoenixABS40-43/Print Files/Ejection System/Ready to Print/PhoenixABS40-43_Knob_v1.stl
20.0 x 20.0 x 12.5
