ItzXyers/Rocketry/PhoenixABS40-43/Print Files/Launch Pad/Bambu X1C/Phoenix_LaunchPad_plate3_ALL_StopPost_Hub_Legs_x3_0.20mm.3mf

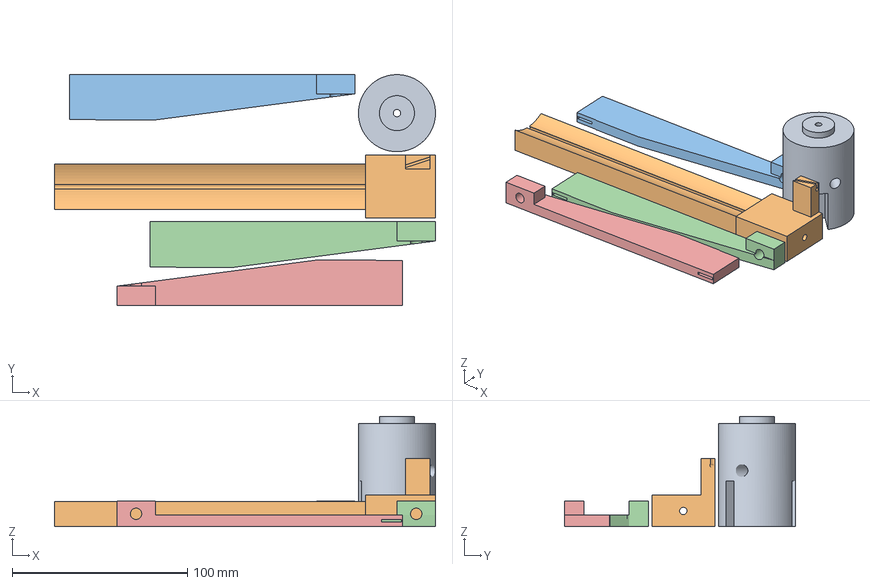
[picture p130: CAD file, 2026-10-29]
PhoenixABS40-43/Print Files/Launch Pad/Bambu X1C/Phoenix_LaunchPad_plate3_ALL_StopPost_Hub_Legs_x3_0.20mm.3mf
217.5 x 131.7 x 63.0 mm
PhoenixABS40-43_PadHub_v1.stl
PhoenixABS40-43_StopPost_v2.stl
PhoenixABS40-43_PadLeg_v2.stl x 3
