ItzXyers/Rocketry/PhoenixABS40-43/Print Files/Launch Pad/PhoenixABS40-43_PadLeg_v1.stl

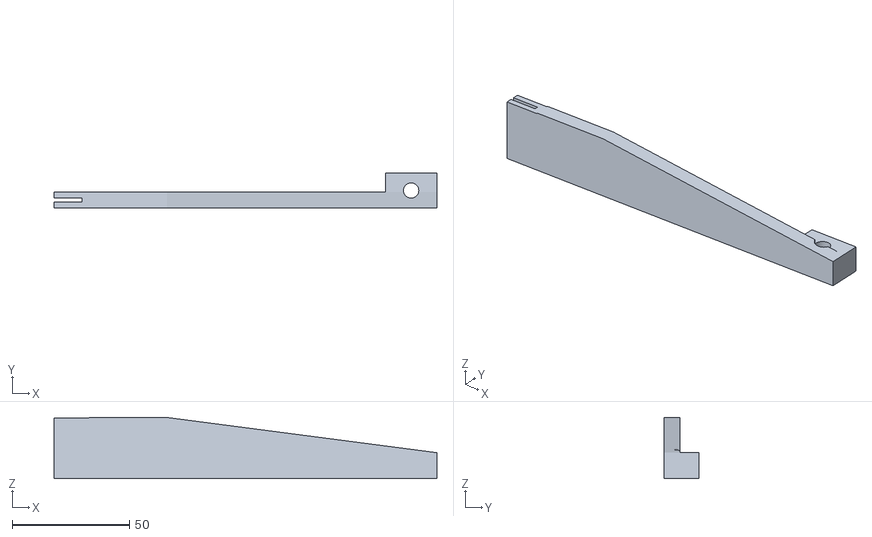
[picture p131: CAD file, 2026-09-17]
PhoenixABS40-43/Print Files/Launch Pad/PhoenixABS40-43_PadLeg_v1.stl
163.0 x 14.7 x 26.0
