ItzXyers/Rocketry/PhoenixABS40-43/Print Files/Ready to Print/D9/PhoenixABS40-43_ElectronicsSled_v21.stl

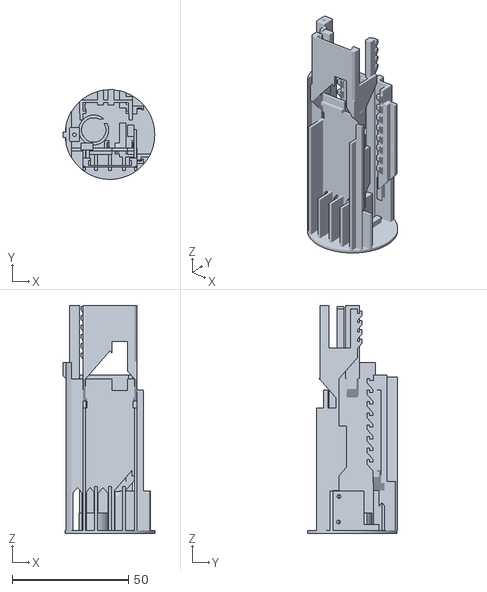
[picture p132: CAD file, 2026-10-29]
PhoenixABS40-43/Print Files/Ready to Print/D9/PhoenixABS40-43_ElectronicsSled_v21.stl
39.4 x 38.7 x 98.2
