ItzXyers/Rocketry/SampleRocketABS31-33/Print Files/SampleRocketABS13_PART_B_top.stl

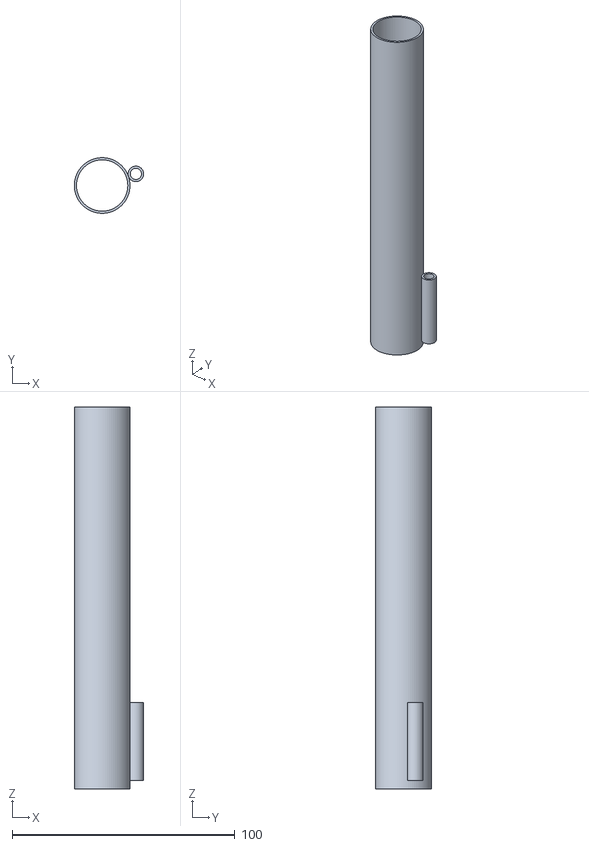
[picture p133: CAD file, 2026-09-17]
SampleRocketABS31-33/Print Files/SampleRocketABS13_PART_B_top.stl
31.1 x 25.0 x 171.4
