ItzXyers/Rocketry/SampleRocketABS33-36/.backup-20260818-215039/SampleRocketABSBody33-36_Fwd.stl

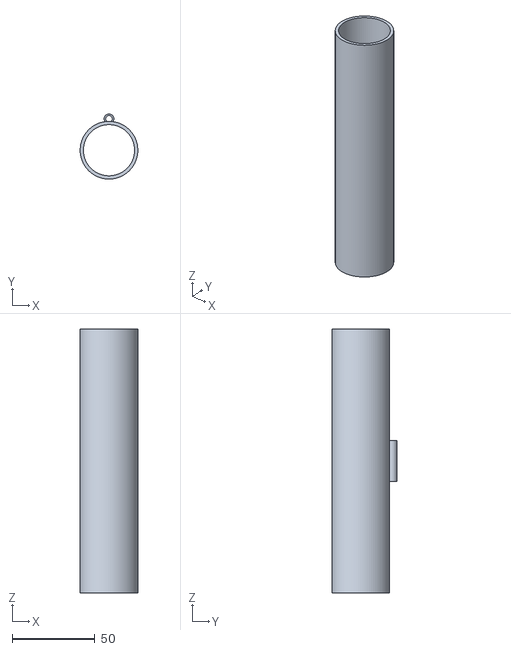
[picture p134: CAD file, 2026-09-17]
SampleRocketABS33-36/.backup-20260818-215039/SampleRocketABSBody33-36_Fwd.stl
35.0 x 39.5 x 160.0
