ItzXyers/Rocketry/SampleRocketABS33-36/.backup-avbay-20260819-155709/Print Files/SampleRocketABSNosecone33-36.stl

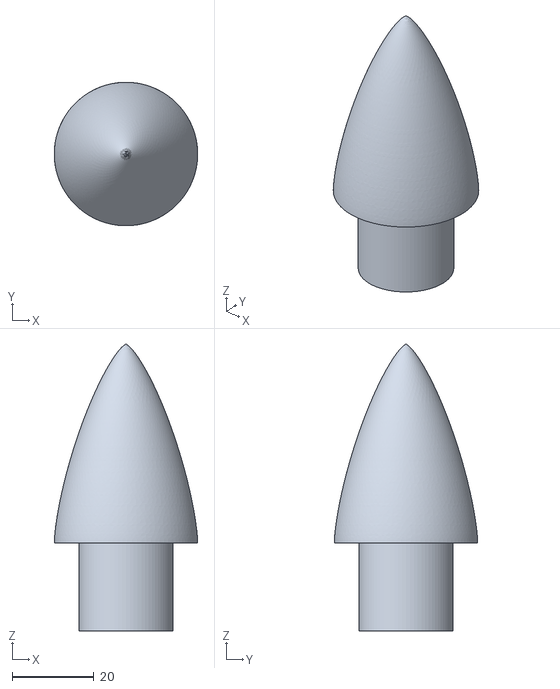
[picture p135: CAD file, 2026-09-17]
SampleRocketABS33-36/.backup-avbay-20260819-155709/Print Files/SampleRocketABSNosecone33-36.stl
35.0 x 35.0 x 70.0
