ItzXyers/Rocketry/SampleRocketABS33-36/.backup-parachutebay-20260826-221240/Print Files/Assembled Sections/SampleRocketABS33-36_AVBAY.stl

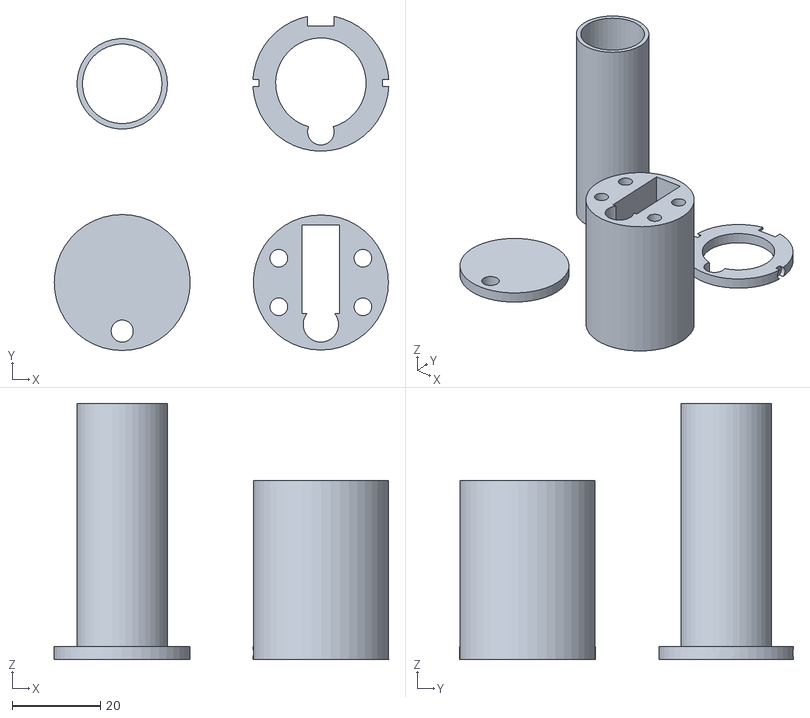
[picture p136: CAD file, 2026-09-17]
SampleRocketABS33-36/.backup-parachutebay-20260826-221240/Print Files/Assembled Sections/SampleRocketABS33-36_AVBAY.stl
75.8 x 75.7 x 58.0
