ItzXyers/Rocketry/SampleRocketABS33-36/Print Files/SampleRocketABSBody33-36_Aft.stl

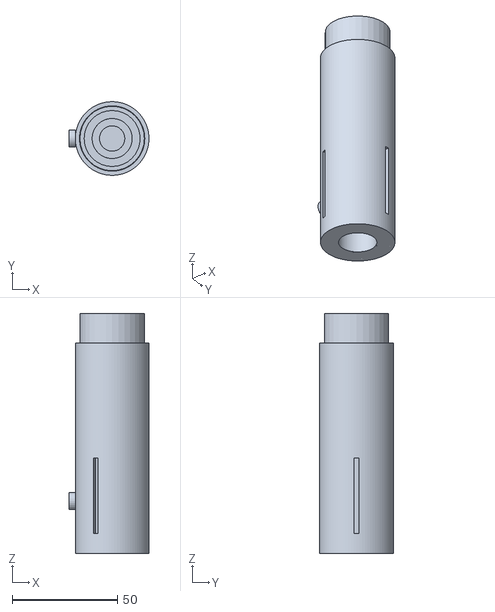
[picture p137: CAD file, 2026-09-17]
SampleRocketABS33-36/Print Files/SampleRocketABSBody33-36_Aft.stl
38.0 x 35.0 x 114.0
