ItzXyers/Rocketry/Ejection System T3/Phoenix3D_FreeCAD/Phoenix3D_d68.FCStd

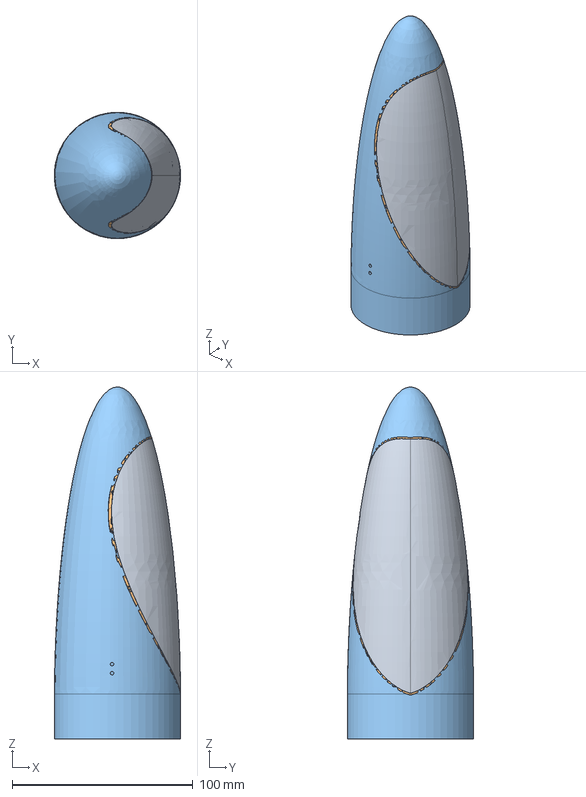
[picture p138: CAD file, 2026-09-17]
Ejection System T3/Phoenix3D_FreeCAD/Phoenix3D_d68.FCStd
69.9 x 70.0 x 195.0 mm
I-Türe
K-Kammer
Casing
