ItzXyers/Rocketry/Ejection System T4/Models/step_striker.step

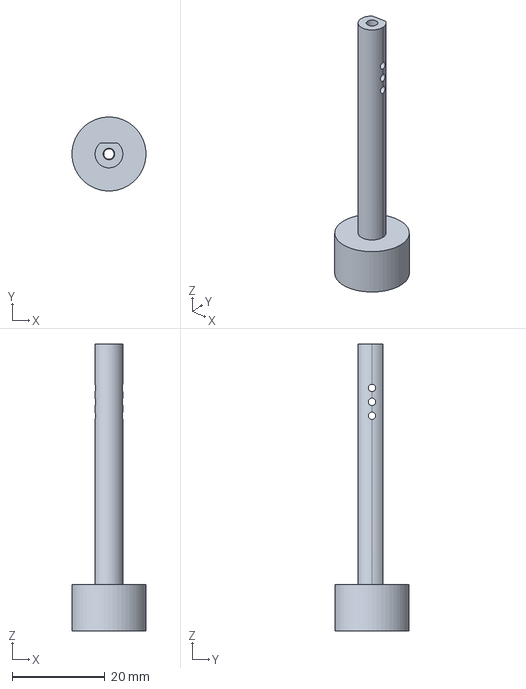
[picture p139: CAD file, 2026-09-24]
Ejection System T4/Models/step_striker.step
16.0 x 16.0 x 62.0 mm
