ItzXyers/Rocketry/Ejection System T5/Print Files/t5v4_spacer_8mm.stl

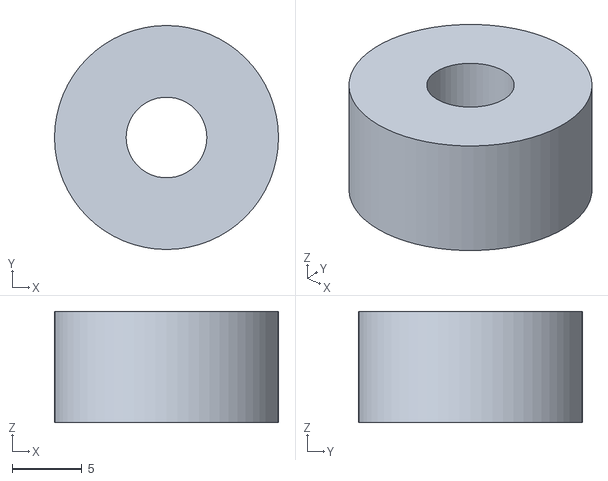
[picture p140: CAD file, 2026-10-01]
Ejection System T5/Print Files/t5v4_spacer_8mm.stl
16.1 x 16.1 x 8.00
