ItzXyers/Rocketry/LaunchPad/Print Files/LaunchPad_Leg_x3.stl

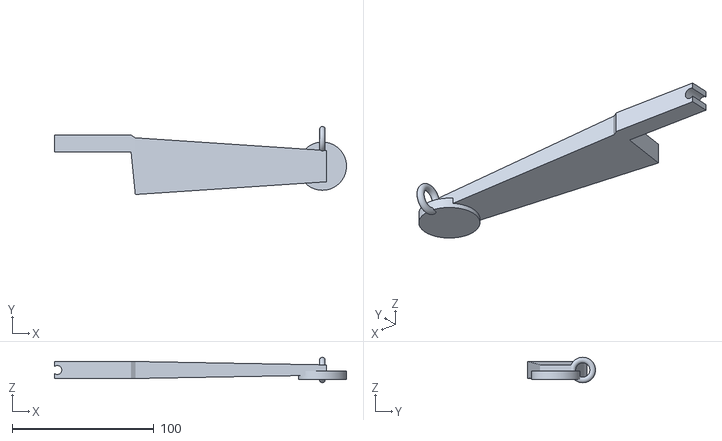
[picture p141: CAD file, 2026-09-17]
LaunchPad/Print Files/LaunchPad_Leg_x3.stl
206.0 x 48.0 x 18.0
