ItzXyers/Rocketry/PhoenixABS40-43/Avionics/Models/cassette_assembly_v1/Env_Servo.stl

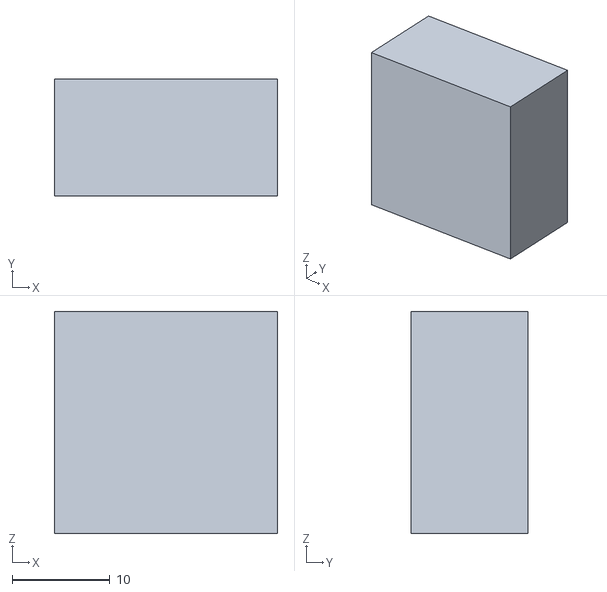
[picture p142: CAD file, 2026-09-17]
PhoenixABS40-43/Avionics/Models/cassette_assembly_v1/Env_Servo.stl
22.8 x 12.0 x 22.7
