ItzXyers/Rocketry/PhoenixABS40-43/Models/_render/MotorRetainerCap.stl

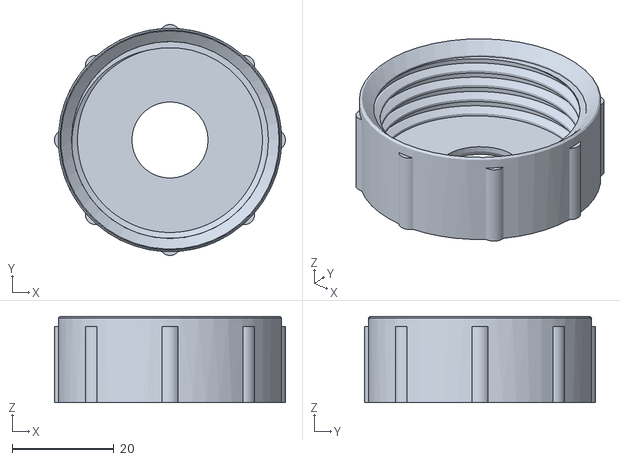
[picture p143: CAD file, 2026-09-17]
PhoenixABS40-43/Models/_render/MotorRetainerCap.stl
45.5 x 45.5 x 17.0
