ItzXyers/Rocketry/PhoenixABS40-43/Nosecone/Models/PhoenixABS40-43_nose_ServoHorn_v4.step

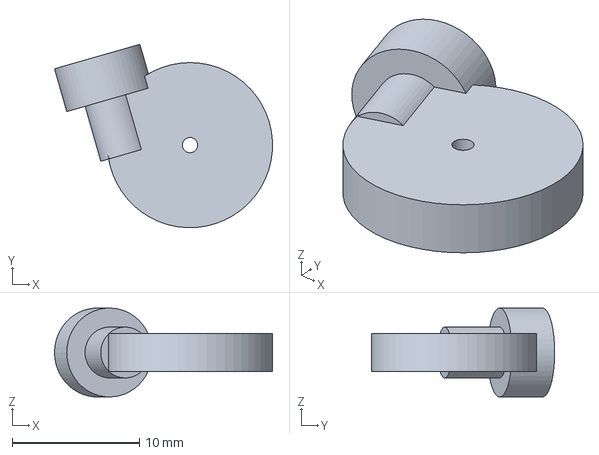
[picture p144: CAD file, 2026-09-17]
PhoenixABS40-43/Nosecone/Models/PhoenixABS40-43_nose_ServoHorn_v4.step
17.2 x 14.4 x 7.00 mm
