ItzXyers/Rocketry/PhoenixABS40-43/Print Files/Aft Deploy D9/Ready to Print/PhoenixABS40-43_D9aft_v7_FwdTube.stl

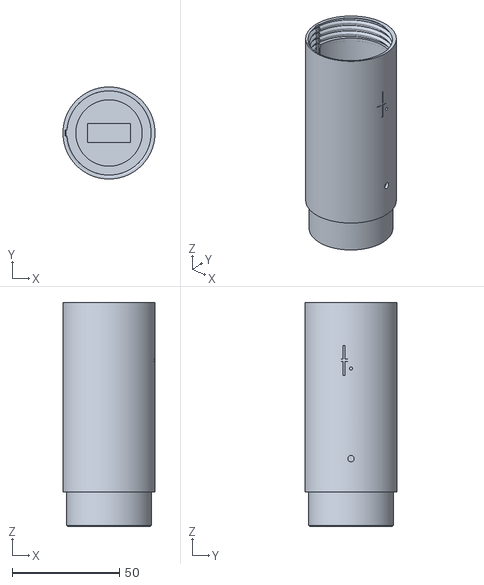
[picture p145: CAD file, 2026-10-07]
PhoenixABS40-43/Print Files/Aft Deploy D9/Ready to Print/PhoenixABS40-43_D9aft_v7_FwdTube.stl
43.0 x 43.0 x 104.6
