ItzXyers/Rocketry/PhoenixABS40-43/Print Files/Ejection System/PhoenixABS40-43_Cage_v1.stl

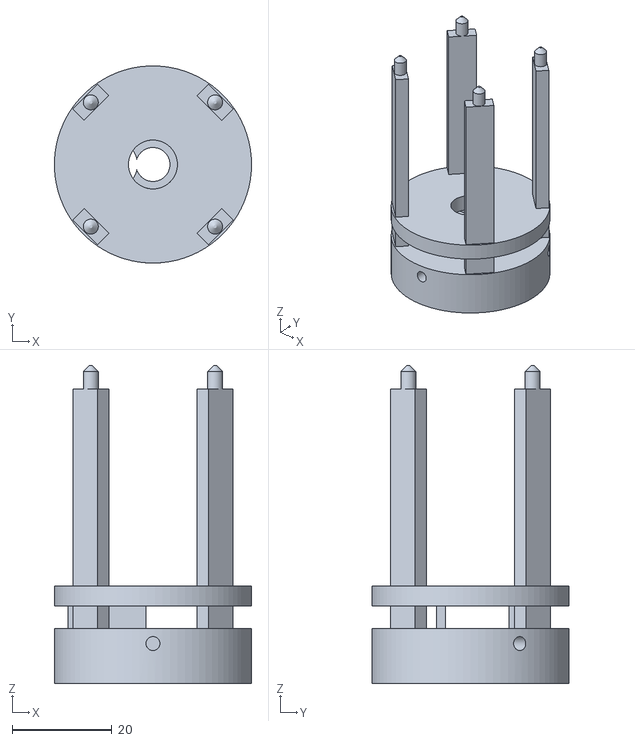
[picture p147: CAD file, 2026-09-17]
PhoenixABS40-43/Print Files/Ejection System/PhoenixABS40-43_Cage_v1.stl
39.5 x 39.5 x 63.7
