ItzXyers/Rocketry/PhoenixABS40-43/Print Files/Launch Pad/PhoenixABS40-43_PadHub_v1.stl

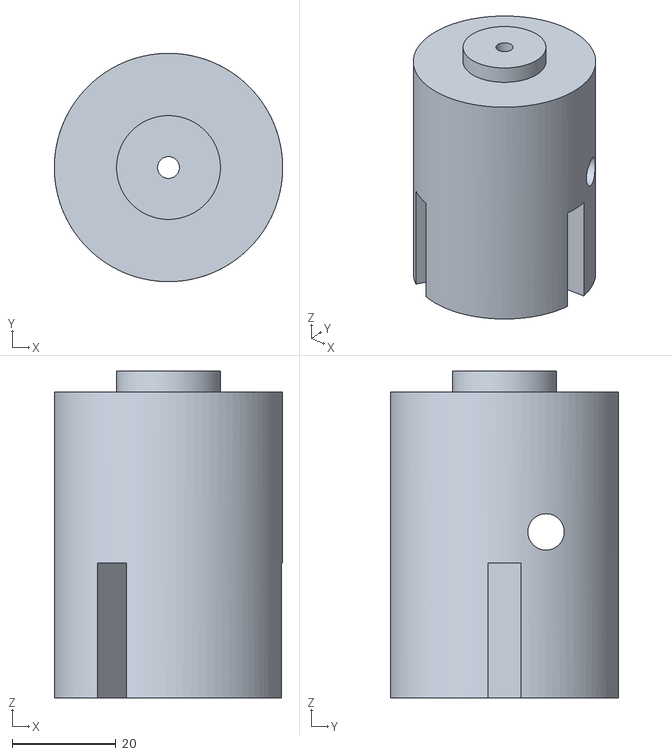
[picture p148: CAD file, 2026-09-17]
PhoenixABS40-43/Print Files/Launch Pad/PhoenixABS40-43_PadHub_v1.stl
44.0 x 44.0 x 63.0
