ItzXyers/Rocketry/PhoenixABS40-43/Print Files/Ready to Print/D9/Bambu X1C/Phoenix_D9_plate14_ExtensionRing_v12_0.16mm.3mf

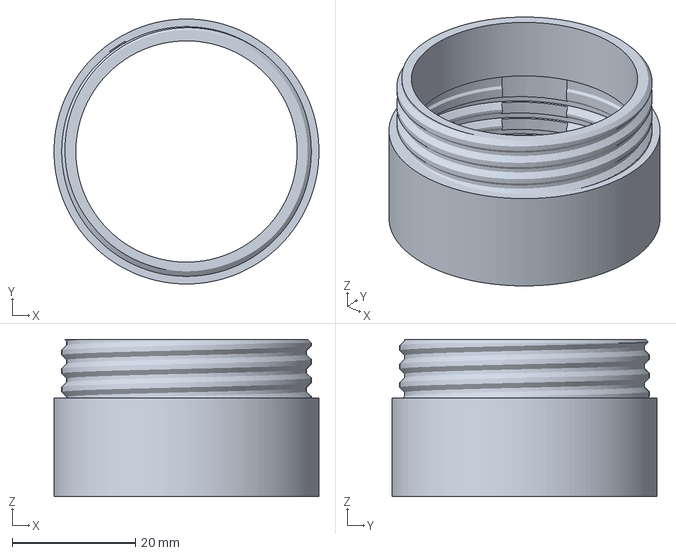
[picture p149: CAD file, 2026-10-29]
PhoenixABS40-43/Print Files/Ready to Print/D9/Bambu X1C/Phoenix_D9_plate14_ExtensionRing_v12_0.16mm.3mf
43.0 x 43.0 x 25.5 mm
