ItzXyers/Rocketry/PhoenixABS40-43/Print Files/Ready to Print/D9/PhoenixABS40-43_TopKeeper_v21.stl

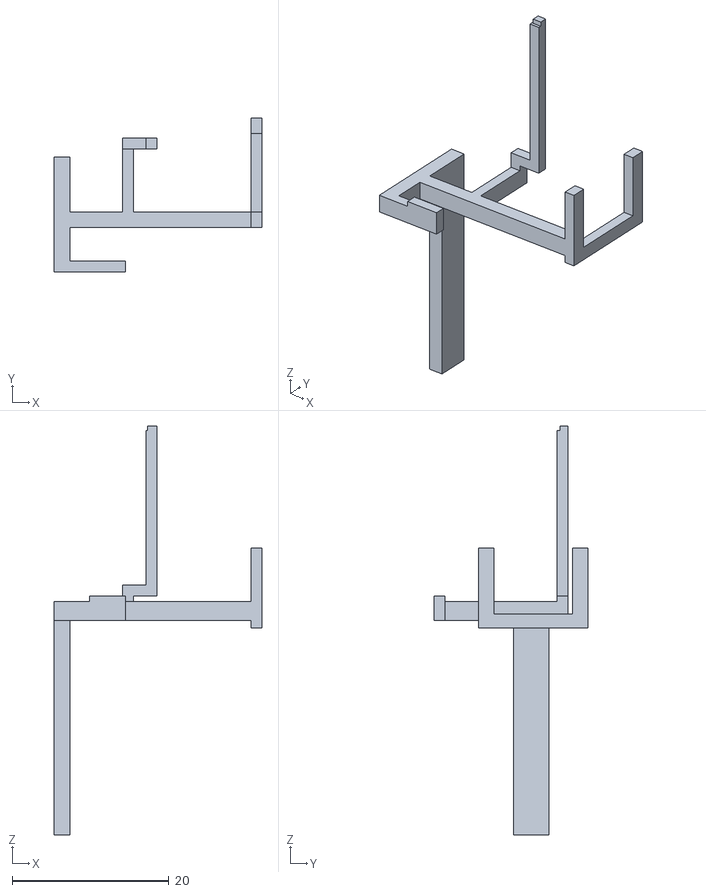
[picture p150: CAD file, 2026-10-29]
PhoenixABS40-43/Print Files/Ready to Print/D9/PhoenixABS40-43_TopKeeper_v21.stl
26.5 x 19.7 x 52.2
