ItzXyers/Rocketry/SampleRocketABS33-36/.backup-parachutebay-20260826-221240/Print Files/AvBay_Mandrel.stl

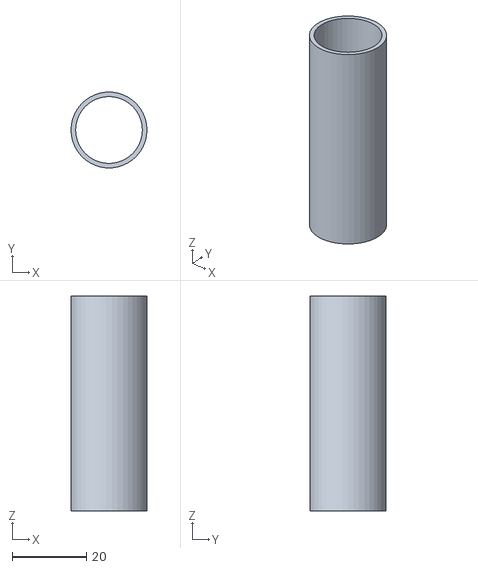
[picture p151: CAD file, 2026-09-17]
SampleRocketABS33-36/.backup-parachutebay-20260826-221240/Print Files/AvBay_Mandrel.stl
20.5 x 20.4 x 58.0
