ItzXyers/Rocketry/SampleRocketABS33-36/Print Files/Assembled Sections/SampleRocketABS33-36_PARACHUTEBAY.stl

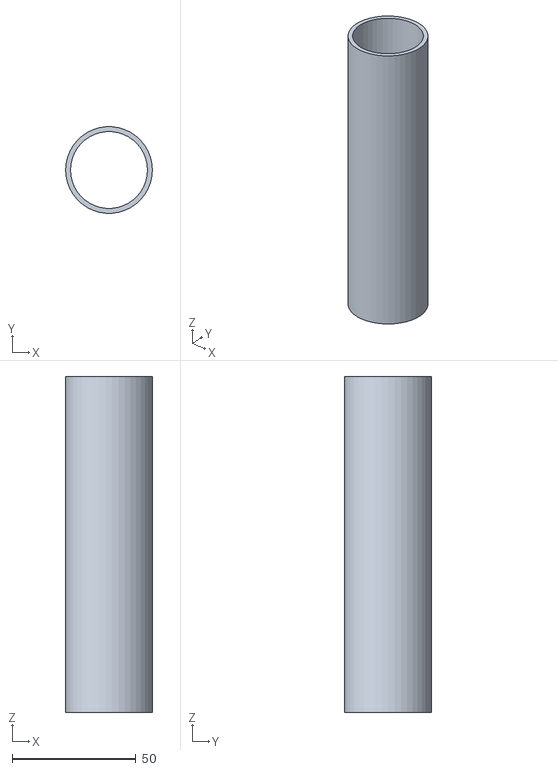
[picture p152: CAD file, 2026-09-17]
SampleRocketABS33-36/Print Files/Assembled Sections/SampleRocketABS33-36_PARACHUTEBAY.stl
35.0 x 34.9 x 135.5
