ItzXyers/Rocketry/SampleRocketABS33-36/Print Files/AvBay_DuctPlug.stl

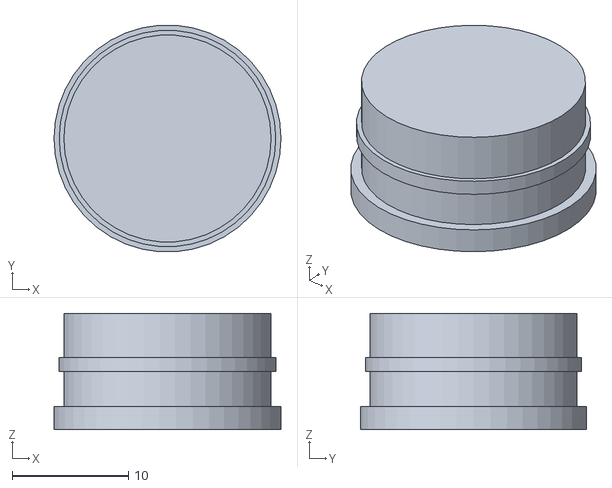
[picture p153: CAD file, 2026-09-17]
SampleRocketABS33-36/Print Files/AvBay_DuctPlug.stl
19.5 x 19.4 x 10.0
