ItzXyers/Rocketry/Ejection System T3/Phoenix3D_FreeCAD/Phoenix3D_d68m.FCStd

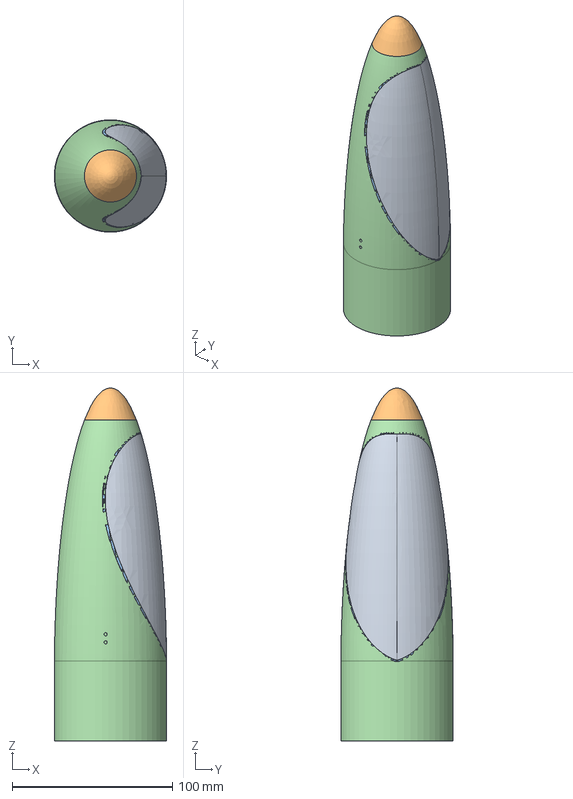
[picture p154: CAD file, 2026-09-17]
Ejection System T3/Phoenix3D_FreeCAD/Phoenix3D_d68m.FCStd
69.9 x 70.0 x 220.0 mm
I-Türe
H-Spitze
K-Kammer
Casing
