ItzXyers/Rocketry/Ejection System T4/Models/co2_ejector_t4.FCStd

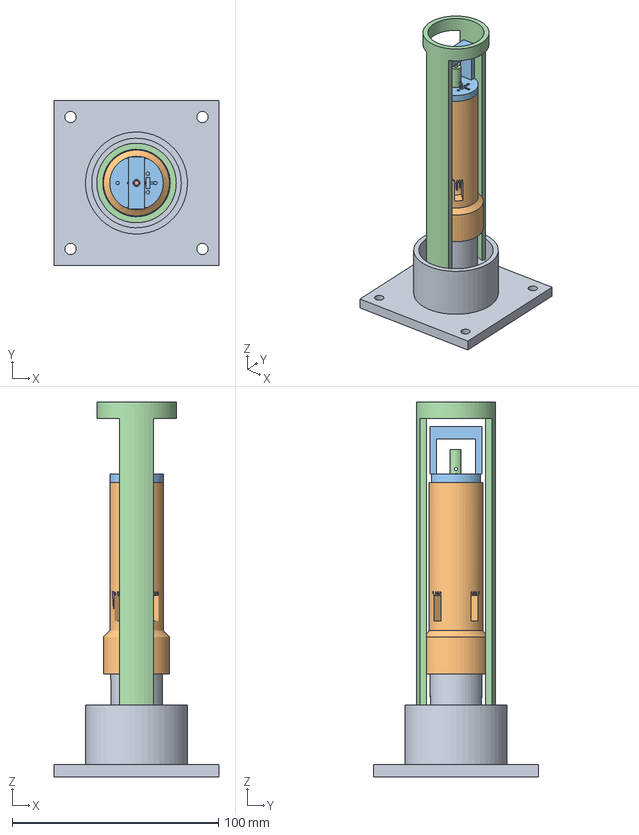
[picture p155: CAD file, 2026-09-24]
Ejection System T4/Models/co2_ejector_t4.FCStd
80.0 x 80.0 x 182.0 mm
head
cap
striker
spacer_1mm
spacer_2mm
spacer_4mm
spacer_8mm
test_base
flight_bulkhead
cocking_tool
install_tool
coupon_seat_gauge
coupon_T1_male
coupon_T1_female
coupon_T2_male
coupon_T2_female
coupon_T3_male
coupon_T3_female
HW_cartridge
HW_needle
HW_jam_nut
HW_grub_M6x12
HW_nut_M6
HW_spring_envelope
REF_cartridge_stl
