ItzXyers/Rocketry/Ejection System T4/Print Files/t4_coupon_T3_male.stl

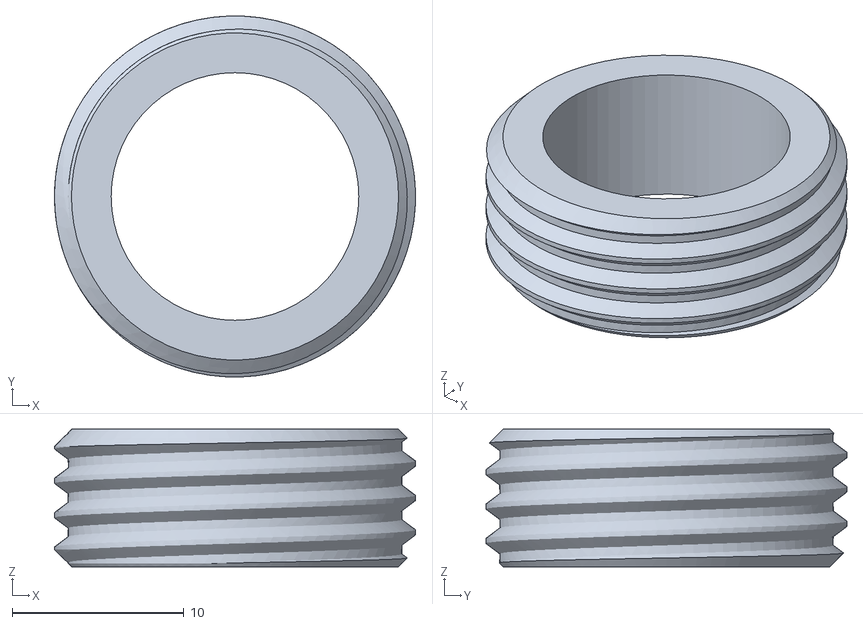
[picture p156: CAD file, 2026-09-24]
Ejection System T4/Print Files/t4_coupon_T3_male.stl
21.0 x 21.0 x 8.00
