ItzXyers/Rocketry/Ejection System T5/Print Files/t5v4_install_tool.stl

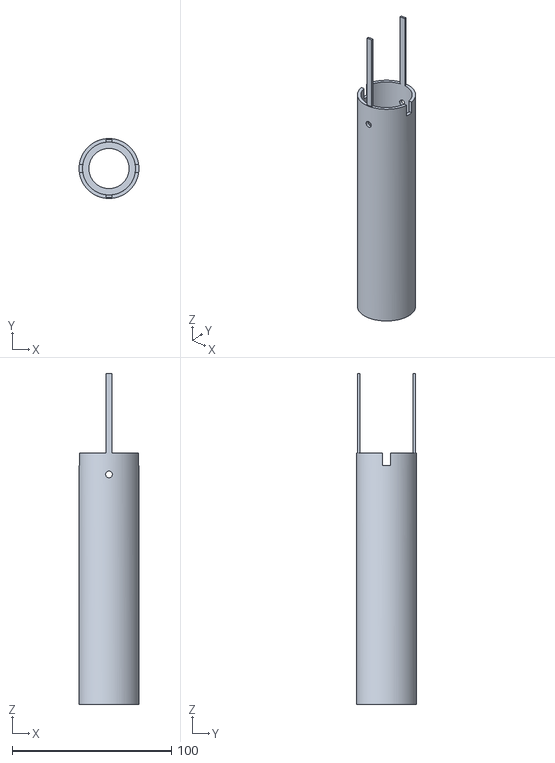
[picture p157: CAD file, 2026-10-01]
Ejection System T5/Print Files/t5v4_install_tool.stl
37.6 x 37.6 x 207.8
