ItzXyers/Rocketry/Electronics/CO2 Deployment/co2_striker_pin.stl

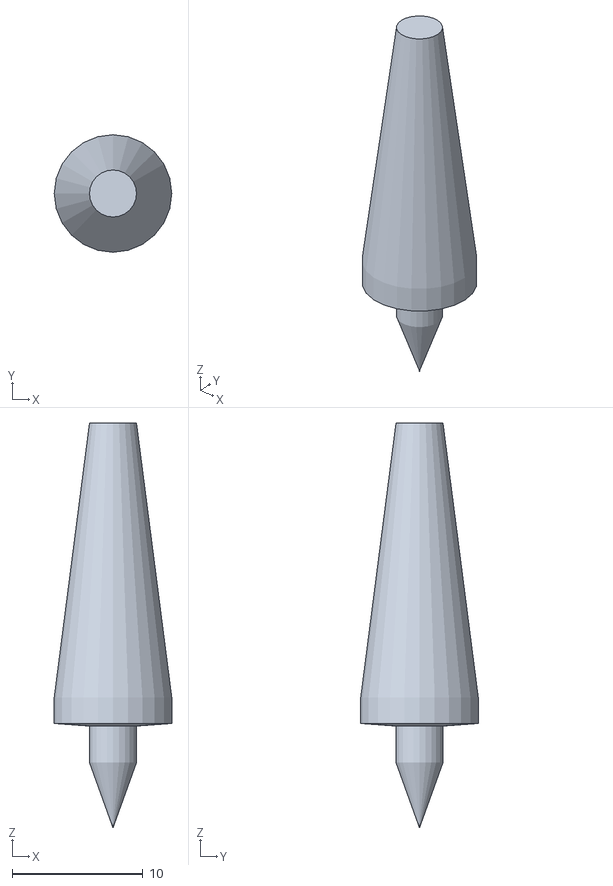
[picture p158: CAD file, 2026-09-17]
Electronics/CO2 Deployment/co2_striker_pin.stl
9.00 x 9.00 x 31.0
