ItzXyers/Rocketry/LaunchPad/Print Files/LaunchPad_HingePin_x3.stl

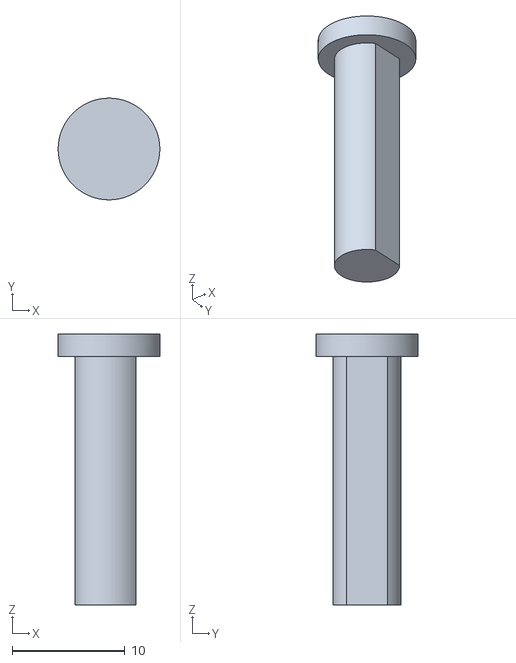
[picture p159: CAD file, 2026-09-17]
LaunchPad/Print Files/LaunchPad_HingePin_x3.stl
9.00 x 9.00 x 24.0
