ItzXyers/Rocketry/PhoenixABS40-43/Avionics/Models/cassette_assembly_v1/SvcBatteryTray.stl

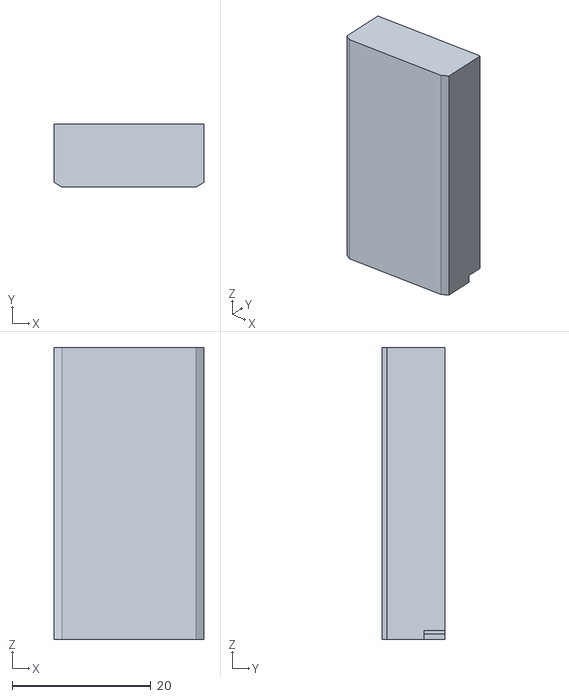
[picture p160: CAD file, 2026-09-17]
PhoenixABS40-43/Avionics/Models/cassette_assembly_v1/SvcBatteryTray.stl
21.6 x 9.11 x 42.1
