ItzXyers/Rocketry/(list of files, cad)

Other CAD files:
SampleRocketABS33-36/.backup-parachutebay-20260826-221240/Print Files/Fin_C_assembly_only.stl
SampleRocketABS33-36/Print Files/Fin_C_assembly_only.stl
SampleRocketABS33-36/.backup-mergedstl-20260819-205540/SampleRocketABS33-36.FCStd
SampleRocketABS33-36/.backup-parachutebay-20260826-221240/SampleRocketABS33-36.FCStd
SampleRocketABS33-36/.backup-thrustring-20260826-221932/SampleRocketABS33-36.FCStd
Ejection System T4/Print Files/t4_body.stl
PhoenixABS40-43/Models/PhoenixABS40-43_StopPost_v2.step
PhoenixABS40-43/Nosecone/Models/PhoenixABS40-43_nose_VonKarman_v5.step
PhoenixABS40-43/Print Files/Aft Deploy D9/PhoenixABS40-43_D9aft_v11_AftTube.stl
PhoenixABS40-43/Print Files/Aft Deploy D9/Ready to Print/PhoenixABS40-43_D9aft_v11_AftFinCanSlotted.stl
PhoenixABS40-43/Print Files/Launch Pad/Bambu X1C/Phoenix_LaunchPad_plate1_StopPost_v2_0.20mm.3mf
PhoenixABS40-43/Print Files/Launch Pad/Ready to Print/PhoenixABS40-43_StopPost_v2.stl
SampleRocketABS33-36/Print Files/Assembled Sections/SampleRocketABS33-36_NOSECONE.stl
PhoenixABS40-43/Print Files/Aft Motor Retention/PhoenixABS40-43_AftFinCan_v1.stl
PhoenixABS40-43/Print Files/Ejection System/PhoenixABS40-43_Slider_v1.stl
PhoenixABS40-43/Print Files/Ready to Print/D9/Bambu X1C/Phoenix_D9_plate19_ExtensionRing_v13_Sled_v21_TopKeeper_ABSHS_FAST.3mf
SampleRocketABS33-36/Print Files/Assembled Sections/SampleRocketABS33-36_FWD.stl
Ejection System T4/Print Files/t4_cap.stl
PhoenixABS40-43/Avionics/Models/PhoenixABS40-43_avbay_ElectronicsSled_v21.step
PhoenixABS40-43/brag-output/work/assets/PhoenixABS40-43_D9aft_v11_AftFinCanSlotted.stl
PhoenixABS40-43/Models/PhoenixABS40-43_D9aft_v13_ExtensionRing.step
PhoenixABS40-43/Print Files/Ejection System/Ready to Print/PhoenixABS40-43_TubeStub_v1.stl
PhoenixABS40-43/Print Files/Launch Pad/Ready to Print/PhoenixABS40-43_PadHub_v1.stl
SampleRocketABS31-33/Print Files/SampleRocketABS13_PART_C_launchlug_horizontal.stl
PhoenixABS40-43/Avionics/Models/PhoenixABS40-43_avbay_TopKeeper_v21.step
Ejection System T3 (LEGACY)/LEGACY/Sideways_Ejection_NoseCone_v1.FCStd
Ejection System T3 (LEGACY)/Phoenix3D_FreeCAD/Phoenix3D_d43_servo.FCStd
Ejection System T3 (LEGACY)/Phoenix3D_FreeCAD/Phoenix3D_d43_servo.doorscaled-stillblocked.20260915.FCStd
Ejection System T3 (LEGACY)/Phoenix3D_FreeCAD/Phoenix3D_d43_servo.preFix.20260915.FCStd
Ejection System T3 (LEGACY)/Phoenix3D_FreeCAD/Phoenix3D_d78m.FCStd
Ejection System T3/Phoenix3D_FreeCAD/Phoenix3D_d43_servo.FCStd
Ejection System T3/Phoenix3D_FreeCAD/Phoenix3D_d43_servo.doorscaled-stillblocked.20260915.FCStd
Ejection System T3/Phoenix3D_FreeCAD/Phoenix3D_d43_servo.preFix.20260915.FCStd
Ejection System T3/Phoenix3D_FreeCAD/Phoenix3D_d78m.FCStd
Ejection System T4/Models/step_head.step
Ejection System T4/Print Files/t4_cocking_tool.stl
Ejection System T4/Print Files/t4_coupon_T2_female.stl
Ejection System T4/Print Files/t4_coupon_T2_male.stl
Ejection System T4/Print Files/t4_coupon_T3_female.stl
Ejection System T4/Print Files/t4_flight_bulkhead.stl
Ejection System T4/Print Files/t4_head.stl
Ejection System T4/Print Files/t4_install_tool.stl
Ejection System T4/Print Files/t4_spacer_1mm.stl
Ejection System T4/Print Files/t4_spacer_4mm.stl
Ejection System T4/Print Files/t4_spacer_8mm.stl
Ejection System T4/Print Files/t4_striker.stl
Ejection System T4/Print Files/t4_test_base.stl
Ejection System T5/Models/spring_ejector_t5.FCStd
Ejection System T5/Models/spring_ejector_t5_assembly_cocked.step
Ejection System T5/Models/spring_ejector_t5_v2.FCStd
Ejection System T5/Models/spring_ejector_t5_v2_assembly_cocked.step
Ejection System T5/Models/spring_ejector_t5_v3.FCStd
Ejection System T5/Models/spring_ejector_t5_v3_assembly_cocked.step
Ejection System T5/Models/t5_integration.FCStd
Ejection System T5/Print Files/t5_base.stl
Ejection System T5/Print Files/t5_install_tool.stl
Ejection System T5/Print Files/t5_piston.stl
Ejection System T5/Print Files/t5_spacer_2mm.stl
Ejection System T5/Print Files/t5_spacer_4mm.stl
Ejection System T5/Print Files/t5_spacer_8mm.stl
Ejection System T5/Print Files/t5_test_stand.stl
Ejection System T5/Print Files/t5v2_base.stl
Ejection System T5/Print Files/t5v2_install_tool.stl
Ejection System T5/Print Files/t5v2_piston.stl
Ejection System T5/Print Files/t5v2_spacer_2mm.stl
Ejection System T5/Print Files/t5v2_spacer_4mm.stl
Ejection System T5/Print Files/t5v2_spacer_8mm.stl
Ejection System T5/Print Files/t5v2_test_stand.stl
Ejection System T5/Print Files/t5v3_base.stl
Ejection System T5/Print Files/t5v3_coupon_T1_female.stl
Ejection System T5/Print Files/t5v3_coupon_T1_male.stl
Ejection System T5/Print Files/t5v3_flight_bulkhead.stl
Ejection System T5/Print Files/t5v3_piston.stl
Ejection System T5/Print Files/t5v3_spacer_4mm.stl
Ejection System T5/Print Files/t5v3_test_stand.stl
Ejection System T5/Print Files/t5v4_base.stl
Ejection System T5/Print Files/t5v4_coupon_T1_female.stl
Ejection System T5/Print Files/t5v4_coupon_T1_male.stl
Ejection System T5/Print Files/t5v4_flight_bulkhead.stl
Ejection System T5/Print Files/t5v4_spacer_4mm.stl
Ejection System T5/Print Files/t5v4_test_stand.stl
Electronics/Avionics/avionics_sled.blend
Electronics/CO2 Deployment/co2_deployment_module.blend
Electronics/CO2 Deployment/co2_trigger_release_mechanism.blend
Electronics/Integrated Bay Assemblies/combined_av_co2_bay_30mm.blend
Electronics/Integrated Bay Assemblies/integrated_av_co2_bay_30mm.blend
Electronics/Integrated Bay Assemblies/integrated_ring_av_co2_bay_30mm.blend
LaunchPad/Print Files/LaunchPad_DeflectorCradle.obj
LaunchPad/Print Files/LaunchPad_HingePin_x3.obj
LaunchPad/Print Files/LaunchPad_Hub.obj
LaunchPad/Print Files/LaunchPad_Leg_x3.obj
LaunchPad/Print Files/LaunchPad_Thumbscrew.obj
LaunchPad/Print Files/LaunchPad_Thumbscrew.stl
PhoenixABS40-43/Avionics/Models/PhoenixABS40-43_avbay_ADXL375_accel_v1.step
PhoenixABS40-43/Avionics/Models/PhoenixABS40-43_avbay_ADXL375_accel_v1.stl
PhoenixABS40-43/Avionics/Models/PhoenixABS40-43_avbay_ADXL375_accel_v2.step
PhoenixABS40-43/Avionics/Models/PhoenixABS40-43_avbay_ADXL375_accel_v2.stl
PhoenixABS40-43/Avionics/Models/PhoenixABS40-43_avbay_AftClosure_v1.step
PhoenixABS40-43/Avionics/Models/PhoenixABS40-43_avbay_AftClosure_v1.stl
PhoenixABS40-43/Avionics/Models/PhoenixABS40-43_avbay_AftClosure_v2.step
PhoenixABS40-43/Avionics/Models/PhoenixABS40-43_avbay_AftClosure_v2.stl
PhoenixABS40-43/Avionics/Models/PhoenixABS40-43_avbay_BMP388_baro_v1.step
PhoenixABS40-43/Avionics/Models/PhoenixABS40-43_avbay_BMP388_baro_v1.stl
PhoenixABS40-43/Avionics/Models/PhoenixABS40-43_avbay_BMP388_baro_v2.step
PhoenixABS40-43/Avionics/Models/PhoenixABS40-43_avbay_BMP388_baro_v2.stl
PhoenixABS40-43/Avionics/Models/PhoenixABS40-43_avbay_Battery_1S_620mAh_v1.step
PhoenixABS40-43/Avionics/Models/PhoenixABS40-43_avbay_Battery_1S_620mAh_v1.stl
PhoenixABS40-43/Avionics/Models/PhoenixABS40-43_avbay_Battery_1S_620mAh_v2.step
PhoenixABS40-43/Avionics/Models/PhoenixABS40-43_avbay_Battery_1S_620mAh_v2.stl
PhoenixABS40-43/Avionics/Models/PhoenixABS40-43_avbay_ElectronicsSled_v1.step
PhoenixABS40-43/Avionics/Models/PhoenixABS40-43_avbay_ElectronicsSled_v1.stl
PhoenixABS40-43/Avionics/Models/PhoenixABS40-43_avbay_ElectronicsSled_v10.step
PhoenixABS40-43/Avionics/Models/PhoenixABS40-43_avbay_ElectronicsSled_v10.stl
PhoenixABS40-43/Avionics/Models/PhoenixABS40-43_avbay_ElectronicsSled_v11.step
PhoenixABS40-43/Avionics/Models/PhoenixABS40-43_avbay_ElectronicsSled_v11.stl
PhoenixABS40-43/Avionics/Models/PhoenixABS40-43_avbay_ElectronicsSled_v12.step
PhoenixABS40-43/Avionics/Models/PhoenixABS40-43_avbay_ElectronicsSled_v12.stl
PhoenixABS40-43/Avionics/Models/PhoenixABS40-43_avbay_ElectronicsSled_v13.step
PhoenixABS40-43/Avionics/Models/PhoenixABS40-43_avbay_ElectronicsSled_v13.stl
PhoenixABS40-43/Avionics/Models/PhoenixABS40-43_avbay_ElectronicsSled_v14.step
PhoenixABS40-43/Avionics/Models/PhoenixABS40-43_avbay_ElectronicsSled_v14.stl
PhoenixABS40-43/Avionics/Models/PhoenixABS40-43_avbay_ElectronicsSled_v15.step
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
