ItzXyers/Rocketry/PhoenixABS40-43/Avionics/avbay_sled_build_report_v21.txt

==============================================================================
Phoenix ABS 40-43 -- avionics bay ELECTRONICS SLED  v21   (30 mm ring D9aft v13, one slot per card, figure-8 cleats)
==============================================================================
SUMMARY: 0 FAIL / clash lines, 1 WARN lines
  WARN  piezo M2 (y -5.75, Z -6.85): thread 4.6 mm PASS; plate under the hole 100 % PASS; M2 head to can -0.11 WARN (as v10: file a flat on that pan head)
  ASSUMED dims (not measured):
    - TO-92 (bent flat on the piezo back) sits at the PIN end inside a 5.5 x 4.4 pocket, Z anywhere on the board (user: 'at pin end'; position + footprint not measured)
    - ESP32 edge solder bulges (user: 'some'): <= 0.6 past the edge, <= 0.8 proud of either face, only at the 15 pad positions per edge (none in the aft 3.9 mm)
    - the last E-edge pad's bulge envelope overlaps the JST footprint (both assumed) -- the JST's own solder there
    - ESP32 JST-PH in the last 5.5 mm at the USB-C end, 6 wide, on the +x edge (left of the USB-C); header alone 8 tall, 24 with the plug
    - ESP32 wires on the pad rows stay inside r 0.85 of the pad centre at the parts face (front lips 0.13 from the pad edge)
    - piezo pins bent ~1.5 past the board end and down 5.5, heat-shrunk (v13); leads exit west under the buttress arch
    - C1 470 uF 16 V: d10 x 12.5 body + 1.5 bent leads, STANDING in its cup (v21), leads up
    - S7V8F5 17 x 11 x 3 incl. PCB 1.6 + 0.5 back joints; its two 17 mm edges free for 0.6 (slot lips 0.5 over them)
    - jumpers 100 mm pad to pad (user: 'not sure: assume'), all from the ESP32 pin rows; R11/R12 divider inline in heat shrink
    - Qwiic ADXL <-> BMP cable >= 50 mm (v21 route ~36 mm + plugs); BMP388 N edge band free like the S edge (groove lips 0.4)
    - ESP32 PCB 18.0 wide: the crush ribs sit at exactly 18.0 -- file them if it is too tight
    - Qwiic plug 2.95 deep x 4.25 long x 5.4 wide; cables bend 1.5 past the plug
    - ESP32 USB-C <= 0.3 past the PCB end; parts 3.4 tall, 0.6 edge bands free; back joints 0.5
    - ADXL375 Qwiic plug centred on its 'top' (short) end, 8 wide, now AFT; PCB edges free for 1 mm (groove lips 0.6)
    - BMP388 PCB 1.6, parts 2.4 incl. plugs; plugs centred on both short ends; S edge band free for the corner rail

[1] build + heal
  removeSplitter after fuse: kept
  connectivity: 1 solid(s)  17181.0
  heal Sled           faces 571 -> 534, solids 1,    17181.0 mm3
  valid solid after heal: True

[2] pack -- component list  (dx.dy.dz  Zmin  Zmax  Rmax)
  Nano_ESP32       18.0. 5.0.45.0    -0.3   44.7   16.75
  Nano_joints      19.2. 3.2.37.3     3.6   40.8   17.75
  JST_power         6.0.24.0. 5.5    39.2   44.7   14.69
  C1_470uF         10.0.10.0.14.0   -21.4   -7.4   12.28
  S7V8F5           11.0. 3.5.17.0     6.0   23.0   11.27
  Piezo_Q1         16.0.21.5.15.9   -20.5   -4.6   19.35
  ADXL375          18.0. 5.0.27.0    47.8   74.8   15.81
  BMP388            4.6.22.0.48.5    -5.7   42.8   19.00
  Qwiic_ADXL_BMP   19.2.14.1. 5.0    42.8   47.8   16.67
  Qwiic_BMP_Nano   17.1. 5.4. 7.4    -5.7    1.7   18.34
  Battery          20.0. 8.5.40.5    -2.0   38.5   18.45
  Battery_lead     11.2. 2.5. 2.5    39.0   41.5   16.01
  ZipTie           22.5.11.9. 3.0    31.1   34.2   19.45
  Sled             39.4.38.7.98.2   -22.8   75.4   20.19   <- the sled

[0] CONTAINMENT  (Rmax vs 19.5 moving / 20.0 ID)
  Nano_ESP32      Rmax  16.75  toID  3.25   PASS
  Nano_joints     Rmax  17.75  toID  2.25   PASS
  JST_power       Rmax  14.69  toID  5.31   PASS
  C1_470uF        Rmax  12.28  toID  7.72   PASS
  S7V8F5          Rmax  11.27  toID  8.73   PASS
  Piezo_Q1        Rmax  19.35  toID  0.65   PASS
  ADXL375         Rmax  15.81  toID  4.19   PASS
  BMP388          Rmax  19.00  toID  1.00   PASS
  Qwiic_ADXL_BMP  Rmax  16.67  toID  3.33   PASS
  Qwiic_BMP_Nano  Rmax  18.34  toID  1.66   PASS
  Battery         Rmax  18.45  toID  1.55   PASS
  Battery_lead    Rmax  16.01  toID  3.99   PASS
  ZipTie          Rmax  19.45  toID  0.55   PASS
  Sled            Rmax  19.39  toID  0.61   PASS   (sled key exempt, below)
  sled key at 180 deg: Rmax 20.19 vs groove floor 20.45 (0.26); half-width 1.21 vs 1.50 (0.29); Z 43.50..50.80;
    part beyond R 19.95 below the groove end Z 44.4 + 0.3: 0.000 mm3; top 50.80 under the spigot 51.3   PASS
  ring spigot band Z 51.3..75.4: everything inside R 17.55 (bore 17.95 - 0.4; the ring screws down over it): clear   PASS
  component tops Z .. 74.8 vs EbayCap face 75.4   PASS
  above EbayCap face: 0.00 mm3 (v20: no spine key into the cap)   PASS
  EbayCap W M2 boss (-15.3, 0) seated at Z 75.4: 100 % of the head footprint backed   PASS
  EbayCap E M2 boss (10.1, 0): DELETED -- leave the cap's east screw OUT, tape the hole (W screw + spine key hold it)

[F] LOADING -- every part along its path in ASSEMBLY ORDER (sled in hand, out of the tube) until it is clear;
    it must not touch the sled or any part already in (touching = 0 mm3 allowed: crush ribs).
    v21: the ESP32 (the hub: S7V8F5, piezo, C1, divider, BMP pigtail are soldered to it) goes in FIRST, axially
    from the cap end with its JST HEADER only (battery plug out); C1, S7V8F5, BMP and ADXL slide in axially too
    (tested as +Z extraction, 1 mm steps), the piezo from the open face (+x), the battery into its tray from -y.
  Nano_ESP32      (+0,+0,+1) 80.0                    clear   PASS
  C1_470uF        (+0,+0,+1) 98.8                    clear   PASS
  S7V8F5          (+0,+0,+1) 71.4                    clear   PASS
  Piezo_Q1        (+1,+0,+0) out                     clear   PASS
  BMP388          (+0,+0,+1) 83.1                    clear   PASS
  ADXL375         (+0,+0,+1) 29.6                    clear   PASS
  Battery         (+0,-1,+0) out                     clear   PASS
  then laid in: Qwiic cables, zip tie round the pack, and LAST the battery plug into the ESP32's JST (= ON).
  Qwiic_ADXL_BMP  laid in after the boards: overlaps nothing   PASS
  Qwiic_BMP_Nano  laid in after the boards: overlaps nothing   PASS
  ZipTie          laid in after the boards: overlaps nothing   PASS
  JST_power       laid in after the boards: overlaps nothing   PASS
  (to take the battery out: unplug it first -- the plug end sits over the pack's fwd end)

[R] ESP32 SLOT (north side)
  W CUP (Z -0.3..3.0, 0.2 clear): PCB moved 0.5 mm out / -y / +y hits 1.9 / 0.4 / 4.4 mm3; crush rib on the edge 1.6 mm2
    relieved slot above: floor 0.8 off the edge, lip faces 1.0 off the faces; PCB moved 1.2 -y hits the front lip 3.3 mm3   PASS
  E CUP (Z -0.3..3.0, 0.2 clear): PCB moved 0.5 mm out / -y / +y hits 1.9 / 0.4 / 4.4 mm3; crush rib on the edge 1.6 mm2
    relieved slot above: floor 0.8 off the edge, lip faces 1.0 off the faces; PCB moved 1.2 -y hits the front lip 2.4 mm3   PASS
  front lips 0.4 over both edges: opening 17.2 < board 18.0, even pushed 0.8 sideways the far edge stays under 0.4   PASS
  solder bulges (ASSUMED 0.6 past the edge, 0.8 proud, every pad Z 3.6..40.8) -> sled 0.20 mm; they ride the whole
    slide in [F] with the board; first bulge 0.57 above the cup top   PASS
  E front lip top Z 33.2 vs JST bottom Z 39.2 (ASSUMED 5.5 from the board end): 6.0 margin   PASS
  aft end on printed material 4.0 mm2 within 0.5 (v18: heels removed); back on 2 full-length ribs 225 mm2   PASS
  NEGATIVE CONTROL: the ESP32 pulled out sideways (-y, toward the centre) hits the lips 71.0 mm3 (must be > 0)   PASS

[A] CARD SLOTS (v21: one slot per card; a slot must hold its card on every side but the loading side)
  ADXL375  PCB moved 1 mm: W 33.3, E 33.3, back -y 291.8, front +y 25.0, aft 1.5 mm3 (all > 0 = held); open +Z (slides in from the cap end)   PASS
    back plate behind the ADXL (y -13.2): 63 / 81 grid points (arch over the JST notch leaves the aft centre open)
    ADXL pose v21: long axis = rocket Z, PCB back -y, parts +y (as v20), PLUG AFT = turned 180 deg about its normal vs v20:
    the board's X and Z axes read NEGATED vs v20 (Y unchanged) -- firmware axis map must follow
  BMP388   PCB moved 1 mm: S 40.3, N 36.5, in -x 240.1, out +x 23.8, aft 1.8 mm3 (all > 0 = held); open +Z (slides in from the cap end; v13 glue corners -> grooves, fwd stops gone)   PASS
    BMP388 seat, S half (tray +x wall)  y -10.5..-6.5: 41 / 50 grid points with sled right behind the PCB   PASS
    BMP388 seat, N half (v16 web)       y 9.1..11.1: 45 / 50 grid points with sled right behind the PCB   PASS
  S7V8F5   PCB moved 1 mm: W 22.4, E 22.4, back -y 81.6, front +y 13.6, aft 1.3 mm3 (all > 0 = held); open +Z (slides in from the cap end)   PASS
  C1 cup   PCB moved 1 mm: -x 49.1, +x 41.4, -y 49.9, +y 42.2, aft 78.4 mm3 (all > 0 = held); open +Z (drops in, leads up)   PASS

[I] FIT -- RAW = the as-drawn sled inside each part's keep-out BEFORE the trim; post-cut must be 0.
  Nano_ESP32      RAW     0.0 mm3   post-cut 0.0   
  Nano_joints     RAW     0.0 mm3   post-cut 0.0   
  JST_power       RAW     0.0 mm3   post-cut 0.0   
  C1_470uF        RAW     0.0 mm3   post-cut 0.0   
  S7V8F5          RAW     0.0 mm3   post-cut 0.0   
  Piezo_Q1        RAW     0.0 mm3   post-cut 0.0   
  ADXL375         RAW     0.0 mm3   post-cut 0.0   
  BMP388          RAW     0.0 mm3   post-cut 0.0   
  Qwiic_ADXL_BMP  RAW     0.0 mm3   post-cut 0.0   
  Qwiic_BMP_Nano  RAW     0.0 mm3   post-cut 0.0   
  Battery         RAW     0.0 mm3   post-cut 0.0   
  Battery_lead    RAW     0.0 mm3   post-cut 0.0   
  ZipTie          RAW     0.0 mm3   post-cut 0.0   
    designed: JST_power on Nano_ESP32
    designed: JST_power on Nano_joints
  part-vs-part clashes: 0   PASS
  gaps between neighbours (want >= 0.4):
    Nano_ESP32      - S7V8F5          10.00   PASS
    Nano_ESP32      - ADXL375         16.10   PASS
    Nano_ESP32      - Piezo_Q1         4.30   PASS
    Nano_ESP32      - C1_470uF         7.14   PASS
    Nano_ESP32      - Battery         14.80   PASS
    JST_power       - Battery          0.70   PASS
    JST_power       - BMP388           4.74   PASS
    JST_power       - Qwiic_ADXL_BMP   0.40   PASS
    ADXL375         - BMP388           9.68   PASS
    ADXL375         - Battery          9.30   PASS
    S7V8F5          - ADXL375         24.91   PASS
    Battery         - Piezo_Q1         2.60   PASS
    BMP388          - Piezo_Q1         0.45   PASS
    C1_470uF        - Qwiic_BMP_Nano   3.51   PASS
    Piezo_Q1        - Qwiic_BMP_Nano   0.40   PASS
    C1_470uF        - Piezo_Q1         5.03   PASS
    S7V8F5          - ZipTie           8.15   PASS
    ADXL375         - JST_power        3.10   PASS
    Qwiic_ADXL_BMP  - Battery_lead     3.60   PASS
    Battery_lead    - Battery          0.50   PASS

[S] SCREW ACCESS (d3.0 driver from the head along +x; sees the sled + every part in before that screw)
  piezo M2 d2.5 y-6.0  clear   PASS
  piezo M2 d3.0 y-5.8  clear   PASS
  NEGATIVE CONTROL: same driver pointed INTO the sled (-x) hits it 62.4 mm3 (must be > 0)   PASS

[H] HOLES + SEATS
  piezo M2 (y -6.00, Z -17.85): thread 7.5 mm PASS; plate under the hole 100 % PASS; M2 head to can 0.41 PASS
  piezo M2 (y -5.75, Z -6.85): thread 4.6 mm PASS; plate under the hole 100 % PASS; M2 head to can -0.11 WARN (as v10: file a flat on that pan head)
  EbayCap W M2 x10: boss beside the pilot from the cap face down 10.0 mm (tip at Z 40.3 needs >= 5.1)   PASS

[P] PIEZO SOLID BACK PLATE + Q1 (TO-92 flat on the back, at the pin end)
  board back bears on the plate: 196.0 mm2 (v13 frame 78.0); 2 x M2 clamp the hole end   PASS
  Q1 pocket x 2.4..6.8 y 5.5..11.0 Z -18.6..-5.6 (315 mm3): sled inside 0.00 mm3   PASS
  through-opening behind the board's pin end: y 5.1..11.4 (the 2 mm strip y 9.0..11.0 + the TO-92 pocket), Z -19.0..top:
    9 / 9 sight lines from the board back out to x -3 hit nothing; control line at y 0 hits the plate: True   PASS
  sled in front of the board: 0.00 mm3   PASS
  pin bay x 6.8..12.0 y 11.0..18.0 (v13 size less the v17 E rail column): sled inside 0.00 mm3   PASS

[X] HARNESS ROOM
  ESP32 JST + battery plug x 1.2..7.2 y -12.8..11.2 Z 39.2..44.7: over the pack top by 0.7, tray floor notched;
    sled in its keep-out before the trim 0.00 mm3   PASS
  central column (y -2.2 S7 parts .. y 7.8 ESP32 parts, Z -0.3..44.7): 13976 mm3 free after S7V8F5 + cables
  E pad row (x 5.82), in front of the parts face: Sled from -8.2 mm, JST_power from 0.0 mm, S7V8F5 from 13.4 mm, Battery from 18.2 mm, ZipTie from 15.8 mm
  W pad row (x -9.42), in front of the parts face: Sled from -8.2 mm, Battery from 18.2 mm, Battery_lead from 21.2 mm, ZipTie from 15.8 mm
  piezo pin leads: d2 probe pin bay (8.4, 12.2, -13) -> west under the buttress arch -> up to the ESP32 aft end (2.9, 12.2, -1.5): clear   PASS
  ADXL aft -> BMP fwd    lane x -2.7..16.4 y -11.4..2.7 Z 42.9..47.8; sled in it 0.00 mm3   PASS
  BMP aft -> ESP32       lane x -0.6..16.4 y 2.7..8.1 Z -5.7..1.7; sled in it 0.00 mm3   PASS
  battery lead           lane x -10.0..1.2 y -12.5..-10.0 Z 39.0..41.5; sled in it 0.00 mm3   PASS

[T] separation: ESP32 <-> battery 14.8 mm (opposite sides), ESP32 <-> BMP388 4.7 mm

[B] BATTERY TRAY (v10 style)
  pack slides OUTBOARD (-y) free of the sled: [2.0, 5.0, 9.0, 12.0] mm tested clear   PASS
  W wall  1.20 mm thick at (x -10.5, y -11.0, Z 15.0)   PASS
  E wall  2.00 mm thick at (x 10.5, y -11.0, Z 15.0)   PASS
  floor   4.00 mm thick at (x -2.0, y -7.0, Z 15.0)   PASS
  aft face on 28.4 mm2 of web tops (Z -2.5); fwd face under 19.8 mm2 of the floor lip (split round the JST)   PASS
  SIDEWAYS zip tie (2.5 x 1.0) at Z 31.40..33.90: 4.6 below the pack's fwd end -- it is what holds the fwd end against -y
    (aft end: webs + the tie's lever arm; outboard face 1 mm foam -> the bore once in the tube); Rmax 19.45

[D9] FIT TO THE D9aft E-BAY (proxy + the REAL as-built v10 FwdTube, the v10 EbayCap raised 30 mm, the D9aft v13 ring)
  ring v13 Z 51.30..90.80 (mouth face 60.8, spigot to 51.30)
  FwdTube (proxy)  vs sled + every component: contact only   PASS
  FwdTube v10      vs sled + every component: contact only   PASS
  EbayCap v10 +30  vs sled + every component: contact only   PASS
  Ring v13         vs sled + every component: contact only   PASS
  NEGATIVE CONTROL (real FwdTube v10): sled dropped 0.5 mm -> 206.5 mm3 (must be > 0)   PASS
  zip tie band on the pack corners: R 19.45 -> 0.20 to the crests (soft band, cinched -- as v10)   PASS
  lift-out through the thread crests: largest R 19.39 vs crest 19.65 -> 0.26 radial   PASS
  seat: sled Zmin -22.80 vs seat -22.80; bearing on the seat annulus 379 mm2   PASS
  static port d1.5 at Z 30.0: 3 mm behind it clear of everything   PASS
  sound  port d3.0 at Z -12.1: 3 mm behind it clear of everything   PASS
  piezo can face centre (y 0.00, Z -12.10) on the sound port (0, -12.1)   PASS

[KP] TOP KEEPER (separate part; user picked the printed keeper over Kapton)
  keeper: 1 solid, valid True, 620 mm3 = 0.7 g ABS, Z 23.2..75.4
    PASS
  inside the bore: Rmax 18.25 (<= 19.39); in the ring spigot band Rmax 13.34 (<= 17.55)   PASS
  seated vs the sled + every part + cable lane: contact only   PASS
  drops in from the cap end (+Z extraction, 1 mm steps) after every card, the BMP pigtail, the tie and the battery plug
    (the ADXL -> BMP cable is laid AFTER the keeper): clear   PASS
  ESP32   moved toward the cap: 0.15 mm -> 0.00 mm3 (free), 1.0 mm -> 6.66 mm3 (stopped)   PASS
  BMP388  moved toward the cap: 0.15 mm -> 0.00 mm3 (free), 1.0 mm -> 4.48 mm3 (stopped)   PASS
  S7V8F5  moved toward the cap: 0.15 mm -> 0.00 mm3 (free), 1.0 mm -> 0.74 mm3 (stopped)   PASS
  EbayCap +30: seated overlap 0.000 mm3 (contact); keeper lifted 0.3 -> 2.70 mm3 (> 0: the cap clamps the column)   PASS
  ring v13 vs keeper: 0.000 mm3   PASS

[W] SOLDERED HARNESS -- tether while loading + where the dead length goes (jumpers 100 mm pad to pad, ASSUMED)
  ESP32 goes in first; then each soldered part travels its load path.  Worst = its centre to the FARTHEST pad-row end
  (any pad could carry its wire), along the whole path; must stay <= 100 - 10 margin.
  C1_470uF   path +Z 99 mm: worst pad distance 81.5 mm   PASS
  S7V8F5     path +Z 71 mm: worst pad distance 84.0 mm   PASS
  Piezo_Q1   path +x 25 mm: worst pad distance 69.5 mm   PASS
  SLACK STORAGE (all J-hooks: knee underside, saddle, upturned tip; a loop hung on a hook h above its path eats 2 h):
    a) LADDERS on the ESP32 slot's groove walls, facing the central column right beside the pin rows: W x -13.0..-11.6, E x 8.1..9.6,
       hooks out to y 6.2 at Z 8, 13, 18, 23, 28, 33, 38, 43  -> short loops (a few cm) hairpinned next to their own pad
    b) ZONE-C HORNS 18.8 mm apart (W x -8.9 y -5.1: west-face hooks at Z 54, 58, 62, 66, 70, 74; E x 9.0 y 0.7: north-face hooks at Z 60, 64, 68, 72)
       -> long excess: hairpin over a horn hook, or figure-8 round both horns (one turn = 50 mm)
  USER CASE: 30..50 mm dead per wire ('a few cm') -> hairpin h = 15..25 mm off the pad.  Ladder Z 8..43 vs pads Z 4.4..40.0:
    every pad has >= 16.7 mm of ladder on one side (up or down)   PASS for h <= 16.7; longer loops: split over two hooks (zig-zag) or go to the horns
    horns: a hairpin from a pad at Z zp up to the lowest horn hook (Z 54) eats 2 x (54 - zp) -> only the top pads
    (Z >= 29 for 50 mm dead) can reach them; they are for the long-excess case below.
  ASSUMED 100 mm JUMPERS (secondary case): per link (centre of the far part; pads anywhere on the rows):
                                   direct      dead = 100 - direct
    ESP32 -> piezo / Q1           27.. 57 mm    43.. 73 mm
    ESP32 -> S7V8F5               15.. 33 mm    67.. 85 mm
    ESP32 -> C1                   28.. 57 mm    43.. 72 mm
    ESP32 -> R11/R12 (inline)     10.. 21 mm    79.. 90 mm
    ESP32 -> BMP pigtail          13.. 46 mm    54.. 87 mm
    -> that much dead length needs 2 hooks per bundle (zig-zag up the ladder) or a figure-8 turn on the horns.
  -> ladder hooks are 5 mm apart: hairpin each bundle off its pad onto the hook ~h up (or down) the wall.
     Above Z 51.3 keep wires inboard of the hooks (the ring's spigot).

[M] MASS
  sled (ABS, solid-equiv)  17181.0 mm3    18.0 g   (v20 15.0 g -> +3.0 g; v10 17.4 g)
  fasteners: 2 x M2x6 (piezo), 1 x M2x10 (EbayCap W only), 1 mini zip tie (battery); no glue (v21: every card in a slot)
  CG / stability: D9aft v13 (30 mm ring) rolls this sled up and re-runs OpenRocket -- see its report.
  moved vs v20: ADXL ~45 mm fwd (Z 17 -> 62), C1 stands in the aft deck, S7V8F5 off the ESP32 onto the tray face.

[V] STORAGE -- free volume inside R 19.5, deck floor to cap face, minus sled, parts and cable lanes
  v21 total free 76336 mm3
    central column (v21: S7 in its own slot below it)  14180 mm3   (wires, resistors, slack)
    west strip (spine .. slot / ADXL)            2890 mm3   (wire slack)
    aft deck (C1 in it)                          6597 mm3   (d10 can, resistors)
    aft deck under the tray (between the webs)   4952 mm3   (flat parts)
    over the pack's fwd end (JST + lead)         1975 mm3   (battery lead slack)
    v21 ZONE C below the spigot (Z 45.4..51.3, full bore)   6001 mm3   (ADXL plug + cable, JUMPER SLACK)
    v21 ZONE C in the ring spigot band (Z 51.3..75.4)  23087 mm3   (ADXL + horns: JUMPER SLACK (figure-8))
    over the BMP (bore side)                     2211 mm3   (thin)
  (v20 62079 mm3 (16 mm ring), v19 45289 mm3, v18 45048, v15 46250, v13 45667, v10 as built 40941)

[K] SLENDER MEMBERS (slices every 0.5 mm in Z; islands < 8 mm2 or area/longest side < 1.0, >= 6 slices)
  x  -13.0.. -11.6 y    6.2..   7.4  Z    8.4..  44.0 (16 slices)  area min  0.8  t~0.60   review
  x    8.1..   9.6 y    6.2..   7.4  Z    8.4..  44.0 (16 slices)  area min  0.9  t~0.60   review
  x   11.7..  14.5 y  -12.4.. -10.6  Z   31.4..  39.0 (16 slices)  area min  1.7  t~0.61   review
  x  -12.4.. -11.2 y   -6.6..  -3.6  Z   54.5..  75.0 (12 slices)  area min  1.8  t~0.60   review
  x    7.6..  10.4 y    3.0..   4.2  Z   60.5..  73.0 ( 8 slices)  area min  1.7  t~0.60   review
  5 slender groups   (v13: 1)

[O] OVERHANGS  (print +Z up, aft end on the bed; faces steeper than 46 deg from vertical, bed excluded;
    'flat' = the part of it within 14 deg of horizontal, i.e. true bridge / cantilever / pendant)
  area   17.0 mm2 (flat   17.0, reach  1.5 mm)  Z   39.0..  39.0  x  -10.5..   0.8  y   -8.5..  -7.0
  area    6.0 mm2 (flat    6.0, reach  1.1 mm)  Z   44.0..  44.0  x  -16.6.. -13.1  y   -3.0..   3.0
  area    5.5 mm2 (flat    2.2, reach  0.6 mm)  Z  -17.3.. -17.0  x    2.2..   6.8  y   -6.5..  -5.5
  area    5.5 mm2 (flat    2.2, reach  0.6 mm)  Z   -6.3..  -6.1  x    2.2..   6.8  y   -6.3..  -5.2
  area    5.4 mm2 (flat    5.4, reach  2.3 mm)  Z   60.0..  60.0  x    0.8..   7.6  y  -14.0.. -13.2
  area    4.4 mm2 (flat    4.4, reach  1.5 mm)  Z   39.0..  39.0  x    7.6..  10.5  y   -8.5..  -7.0
  area    4.2 mm2 (flat    4.2, reach  1.6 mm)  Z   -2.4..  -2.4  x   11.7..  13.3  y  -11.4..  -8.8
  area    3.8 mm2 (flat    0.0, reach  0.0 mm)  Z   44.0..  45.0  x  -20.1.. -19.0  y   -1.2..   1.2
  area    3.1 mm2 (flat    3.1, reach  2.6 mm)  Z   -4.2..  -4.2  x   10.5..  11.7  y   -8.4..  -5.8
  9 regions >= 2 mm2 (total 55 mm2, flat 44 mm2); 28 small ones (hole crowns etc.) not listed
  'reach' = worst horizontal distance from a flat downward face to material 0.3 mm under it (first layer in air);
  largest reaches: 2.6, 2.3, 1.6, 1.5, 1.5, 1.1 mm
  v13: 9 regions, 70 mm2, reach 2.6;  v10: 31 regions, 389 mm2, reach 7.8;  v9 (spaghetti): 1230 mm2, reach 10.3

[OK] TOP KEEPER print pose (downward faces steeper than 46 deg off vertical, bed excluded; pick the least)
  upright (fingers down)                  121.3 mm2 overhang
  flipped (column top on the bed)         113.5 mm2 overhang
  on its N face (bridge face y 7 down)    182.5 mm2 overhang
  on its S face                           171.7 mm2 overhang
  -> print flipped (column top on the bed); tree supports under whatever is left (small part)

[N] ASSEMBLY (sled in hand)
  1 ESP32 (the soldered package hangs off it), parts toward the centre, USB-C + JST at the cap end, battery plug OUT:
    slide it down its slot from the cap end (loose past the solder bulges) into the tight aft cup, all the way down.
  2 C1: drop it AXIALLY down the centre-west into its cup in the aft deck, leads up (3 crush ribs hold it).
  3 S7V8F5, parts up (+y): slide it down its own slot on the tray floor face until it sits on the slot's aft stop.
  4 piezo (can out), 2 x M2x6; TO-92 in the pin-end pocket; pin leads go west under the buttress arch.
  5 BMP388: PLUG BOTH Qwiic cables in FIRST (aft = the ESP32 pigtail, fwd = the ADXL cable) -- the aft receptacle
    sits 0.45 over the piezo and can't be reached once the board is down.  PCB back on the tray's +x wall, parts
    out: slide it down its grooves from the cap end onto the aft stops, pigtail trailing down beside it, then lay the
    pigtail along over the piezo to the ESP32's aft end (as v20).
  6 ADXL375: plug the cable from the BMP's fwd plug into it FIRST (only ~3 mm over the JST once seated).  PCB back
    on the back plate, parts in (+y), PLUG AFT: slide it down its zone-C slot onto the aft stops.
  7 lay that cable: down from the ADXL plug -> north over the ESP32's JST -> east under the E fin -> to the BMP.
  8 battery: slide it into the tray from the side (-y), 1 mm foam outboard, sideways mini zip tie at Z 31.4.
  8b TOP KEEPER: drop it in from the cap end -- column against the W post's east face, nub into the ESP32 slot mouth,
    fingers over the BMP and down the S7's W edge.  THEN lay the ADXL -> BMP cable (step 7) under its bridge.  The
    EbayCap clamps the column (step 12).  It stops the ESP32 / BMP / S7 0.2 mm above their tops (the ADXL: the cap).
  9 JUMPER SLACK: hairpin each bundle off its pad onto a J-hook of the slot-wall ladder beside the pin rows (hook h
    above / below the pad eats 2 h); long excess goes up the central column to the zone-C horns (hairpin on a hook or
    figure-8 round both).  Kapton dab on each loop.  Above Z 51.3 keep wires inboard of the hooks (the ring's spigot).
 10 battery plug into the ESP32's JST LAST (= ON).  Unplug it before pulling the battery.
    Sled into the tube: KEY into the tube's groove at the old cap-key slot (180 deg, opposite the sound port).
 11 extension ring (D9aft v13, 30 mm): screw it into the tube mouth, hand tight onto the mouth face, holding the sled
    top still so the slack doesn't wind.  Tape over the ring / tube seam for flight.
 12 EbayCap: into the ring, W M2x10 into the post (east hole taped).  Its key tab must drop into the ring's wide slot (+-15 deg):
    if it doesn't, back the ring off (at most ~1/12 turn) until it does.  NEVER trim the tab: it locks the ring.
 13 nose: screw into the ring -- HOLD THE RING while turning the nose (on and off) so the ring doesn't back out.
  REMOVAL: nose off -> M2 out -> cap out -> ring off -> sled out (the cap can't pass the ring's spigot bore).
  ASSUMED (measure / photo before printing):
    - TO-92 (bent flat on the piezo back) sits at the PIN end inside a 5.5 x 4.4 pocket, Z anywhere on the board (user: 'at pin end'; position + footprint not measured)
    - ESP32 edge solder bulges (user: 'some'): <= 0.6 past the edge, <= 0.8 proud of either face, only at the 15 pad positions per edge (none in the aft 3.9 mm)
    - the last E-edge pad's bulge envelope overlaps the JST footprint (both assumed) -- the JST's own solder there
    - ESP32 JST-PH in the last 5.5 mm at the USB-C end, 6 wide, on the +x edge (left of the USB-C); header alone 8 tall, 24 with the plug
    - ESP32 wires on the pad rows stay inside r 0.85 of the pad centre at the parts face (front lips 0.13 from the pad edge)
    - piezo pins bent ~1.5 past the board end and down 5.5, heat-shrunk (v13); leads exit west under the buttress arch
    - C1 470 uF 16 V: d10 x 12.5 body + 1.5 bent leads, STANDING in its cup (v21), leads up
    - S7V8F5 17 x 11 x 3 incl. PCB 1.6 + 0.5 back joints; its two 17 mm edges free for 0.6 (slot lips 0.5 over them)
    - jumpers 100 mm pad to pad (user: 'not sure: assume'), all from the ESP32 pin rows; R11/R12 divider inline in heat shrink
    - Qwiic ADXL <-> BMP cable >= 50 mm (v21 route ~36 mm + plugs); BMP388 N edge band free like the S edge (groove lips 0.4)
    - ESP32 PCB 18.0 wide: the crush ribs sit at exactly 18.0 -- file them if it is too tight
    - Qwiic plug 2.95 deep x 4.25 long x 5.4 wide; cables bend 1.5 past the plug
    - ESP32 USB-C <= 0.3 past the PCB end; parts 3.4 tall, 0.6 edge bands free; back joints 0.5
    - ADXL375 Qwiic plug centred on its 'top' (short) end, 8 wide, now AFT; PCB edges free for 1 mm (groove lips 0.6)
    - BMP388 PCB 1.6, parts 2.4 incl. plugs; plugs centred on both short ends; S edge band free for the corner rail

[E] EXPORT
  PhoenixABS40-43_avbay_ElectronicsSled_v21 .step + .stl
  FCStd -> Avionics/PhoenixABS40-43_avbay_sled_v21.FCStd
  sled_ASSEMBLY_v21.stl
  PhoenixABS40-43_avbay_TopKeeper_v21 .step (sled frame) + .stl (print pose)
