ItzXyers/Rocketry/PhoenixABS40-43/Nosecone/nosecone_build_report_v6.txt

Phoenix ABS 40-43 -- Nosecone v6 (simple screw-on Von Karman, D9aft) -- build report
Generated by PhoenixABS40-43_Nosecone_v6.py via FreeCADCmd. Z = 0 at tip, +Z aft; station = Z - 65.0.

[PASS] solid valid, one solid (1)
[PASS] overall Z 0.00 .. 74.50 (nose 65.0 + threaded shoulder 9.5)
[PASS] max radius 21.500 <= airframe R 21.50 (nothing proud)
[PASS] tangent to the airframe at the base (slope 0.026 at 0.25 mm fwd)
[INFO] min radial shell wall 2.00 mm (normal wall 2.0)
[PASS] thread probes at theta 0: ridge solid at Z 67.40 True, groove open at Z 68.90 True, core solid True
[PASS] thread grooves removed 437 mm3 from the plain shoulder
[PASS] hollow: open shoulder bore d35.9 and cavity
[PASS] solid tip forward of the cavity apex (Z 10)
[INFO] thread: pitch 3.0, 45 deg flanks, depth 0.8, male major d40.50 / minor d38.90; female crest d39.30 / root d40.90 (FwdTube v2)
[INFO] seat: the nose base annulus r 20.25..21.50 bears on the FwdTube mouth face -- hand tight, then a strip of tape across the joint
[NOTE] base ledge 1.25 mm (r 20.25 -> 21.50) prints as a short ring overhang tip-up, like v5's 1.65 mm one; it is the seat face
[NOTE] mate/clash of the thread pair is checked in Models/PhoenixABS40-43_D9aft_v2.py (sampled, with a negative control)

MASS (solid ABS, rho 1.05)
  volume    13910.1 mm3
  mass         14.6 g   (v5: 39.6 g)
  CG           43.8 mm from tip (station -21.2)

RESULT: ALL PASS (0 FAIL)

FILES
  Nosecone/Models/PhoenixABS40-43_nose_VonKarmanScrew_v6.step / .stl
  Print Files/Nosecone/PhoenixABS40-43_nose_VonKarmanScrew_v6.stl (as modeled) + Ready to Print/ (TIP UP, threaded shoulder on the bed, no support)
  Nosecone/PhoenixABS40-43_Nosecone_v6.FCStd
