ItzXyers/Rocketry/PhoenixABS40-43/Avionics/avbay_sled_build_report_v5.txt

==============================================================================
Phoenix ABS 40-43 -- avionics bay ELECTRONICS SLED  v5   (v5: v4 + measured BMP/ADXL/piezo holes)
==============================================================================

frame: avbay_packing_build_report_v2.txt  (Z=0 aft, +Z to nose, +x E, +y N)
constraint: component zone Z 0..48 held -- no length growth
charger BQ25302 + its wall slot deleted; battery charges off-vehicle (JST-PH)

[1] build + heal
  connectivity: 1 solid(s)  6802.6
  heal Sled           faces 316 -> 261, solids 1,     6802.6 mm3

[2] pack -- component list  (dx.dy.dz  Zmin  Zmax  Rmax)
  Nano_ESP32    18.0. 5.0.45.0    0.0  45.0   18.79
  BMP388         4.0.22.0.40.0    0.0  40.0   19.01
  Battery       20.0. 8.5.40.5    0.4  40.9   18.45
  ADXL375       18.0. 4.5.33.0    0.0  33.0   13.72
  Piezo         15.0.11.0.19.0    0.0  19.0   18.82
  ReedModule    28.1. 5.6.17.0   25.3  42.3   19.00
  JST_PH         6.0. 4.5. 4.3   40.9  45.2   16.80
  ZipTie         3.0.11.0.43.0   -0.9  42.2   16.84
  SmallParts    16.0. 3.0.21.9   23.0  44.9   10.00
  Sled          38.6.38.6.48.3   -0.9  47.4   19.39   <- the sled

[0] CONTAINMENT  (Rmax vs 19.5 moving / 20.0 ID)
  Nano_ESP32   Rmax  18.79  toID  1.21   PASS  strap-retained (outboard of the sled skin)
  BMP388       Rmax  19.01  toID  0.99   PASS  
  Battery      Rmax  18.45  toID  1.55   PASS  
  ADXL375      Rmax  13.72  toID  6.28   PASS  
  Piezo        Rmax  18.82  toID  1.18   PASS  strap-retained (outboard of the sled skin)
  ReedModule   Rmax  19.00  toID  1.00   PASS  strap-retained (outboard of the sled skin)
  JST_PH       Rmax  16.80  toID  3.20   PASS  
  ZipTie       Rmax  16.84  toID  3.16   PASS  
  SmallParts   Rmax  10.00  toID 10.00   PASS  
  Sled         Rmax  19.39  toID  0.61   PASS 
  component zone  Z 0.0 .. 45.2   PASS
  above EbayCap face Z 45.4: 71.3 mm3, of which outside the spine key 0.00   PASS
  EbayCap M2 boss (-15.3, 0.0) seated at Z 45.4: 100 % of the boss face present   PASS
  EbayCap M2 boss (10.1, 0.0) seated at Z 45.4: 100 % of the boss face present   PASS

[T] BMP388 vs NANO (heat)
  closest envelope points 2.5 mm (v3: 0.5, stacked face to face); centre-to-centre 19.4 mm (v3 4.5)
  BMP sensor side faces +x (the bay air); nothing covers it.

[S] SCREW ACCESS  (d3.0 driver from the head outward; assembly order piezo -> BMP ->
    ADXL -> Nano -> reed -> small parts -> battery; each sweep sees the sled + parts already in)
  piezo d2.5 y-3.8 driver clear   PASS
  piezo d3.0 y+3.2 driver clear   PASS
  BMP y+9 Z2     driver clear   PASS
  BMP y+9 Z38    driver clear   PASS
  NEGATIVE CONTROL: a BMP y-9 driver hits the sled 11.3 mm3 (must be > 0)   PASS
  BMP y-9 pair: rest pads only (a straight driver would cross the battery tray floor)

[H] MEASURED HOLES  (2026-10-06, approximate; centre = edge distance + d/2)
  BMP388  4 x d3.0, centres 2.0 in -> pitch 18.0 (y) x 36.0 (z); M2.5 screws, boss r 2.8
    boss (y  -9.0, Z  2.0):  83 % of the standoff left after the bore clip   (rest pad)
    boss (y  -9.0, Z 38.0):  83 % of the standoff left after the bore clip   (rest pad)
    boss (y  +9.0, Z  2.0):  68 % of the standoff left after the bore clip   (driven)
    boss (y  +9.0, Z 38.0):  68 % of the standoff left after the bore clip   (driven)
  ADXL375 4 x d3.0, centres 3.0 in -> 12.0 (x) x 20.0 (z); rail-held, holes unused
    groove engagement 0.8 vs hole edge 1.5 from the PCB edge: 0.7 clear   PASS
  Piezo   d2.5 at (y -3.75, Z 17.00), M2
  Piezo   d3.0 at (y +3.25, Z 16.75), M2
    sound hole centre Z 9.5: clear of both bosses (r 2.4)   PASS
  EbayCap M2: driven from the cap top -- always clear

[B] BATTERY ACCESS
  pack slides OUTBOARD (-y) free of the sled: [2.0, 5.0, 9.0, 12.0] mm tested clear   PASS
  zip-tie channel (2.5 x 1.0 band + 0.25): Rmax 16.84, clear of sled + other parts: see [I] ZipTie post-cut / clashes
  outboard face -> ID: 4.5 mm at x 0 (tie head goes here), 1.55 at the corners

[R] REED MODULE -- arming by external magnet   (dims ASSUMED: measure RM_*)
  PCB 18.5 x 15.0 x 1.6 in the x-z plane at y -5.0..-3.4, x -3.4..15.1, Z 26.3..41.3
  header pins point to the axis (tips x -9.4): SOLDER wires, no DuPont housing (+14 mm)
  capsule d2.2 x 14, axis at R 17.90, -10.9 deg (from +x toward -y), Z 26.8..40.8
  glass outer R 19.00 -> 1.00 to ID + 1.5 wall = 2.50 mm magnet-to-glass
  airframe: ARM mark at 11 deg from the witness notch (notch = +x, static port), stations 20.0..34.0

[D9] FIT TO THE D9aft v2 E-BAY  (sled frame = D9 z - 279.2; station = 60.8 - Z)
  EbayCap STEP: Z 45.40..64.30 (expect disc underside at 45.4)   PASS
  FwdTube (proxy)  vs sled + every component: contact only   PASS
  EbayCap          vs sled + every component: contact only   PASS
  NEGATIVE CONTROL: sled dropped 0.5 mm -> 197.2 mm3 into the seat (must be > 0)   PASS
  lift-out through the thread crests: largest R 19.39 vs crest 19.65 -> 0.26 radial   PASS
  seat: sled Zmin -0.90 vs seat top -0.90; bearing on the seat annulus 359 mm2, overhanging the seat hole 386 mm2   PASS
  static port d1.5 at Z 30.0, 0 deg: 3 mm behind it clear of everything   PASS
  sound  port d3.0 at Z 9.5, 0 deg: 3 mm behind it clear of everything   PASS
  piezo sound hole centre Z 9.5 vs sound port Z 9.5   PASS

[I] FIT  --  RAW = the as-drawn sled overlapping each component keep-out,
           BEFORE trim.  RAW>0 is expected: it is pocket walls / rails /
           bosses reaching into the board's space.  For the 8 RIGID parts
           that volume is then cut away (post-cut common -> 0); the risk it
           leaves a wall too thin is flagged in [N], not yet auto-checked.
           SmallParts is a conformable allowance -- it is NOT cut; its RAW is
           how much wiring volume yields to structure.
  Nano_ESP32   RAW      0.0 mm3   (post-cut 0.0)
  BMP388       RAW      0.0 mm3   (post-cut 0.0)
  Battery      RAW      0.4 mm3   (post-cut 0.0)
  ADXL375      RAW      0.0 mm3   (post-cut 0.0)
  Piezo        RAW     74.1 mm3   (post-cut 0.0)
  ReedModule   RAW      2.2 mm3   (post-cut 0.0)
  JST_PH       RAW      0.0 mm3   (post-cut 0.0)
  ZipTie       RAW    163.0 mm3   (post-cut 0.0)
  SmallParts   RAW      0.0 mm3   (allowance yields)
  component-vs-component clashes:
    none

[M] MASS
  sled (ABS, solid-equiv)    6802.6 mm3      7.1 g
  + fasteners: 2x M2.5x4 (BMP388 y+9, d3 board holes, into the spine), 2x M2 (piezo breakout, d2.5 + d3 board holes),
               2x M2x10 (EbayCap, axial); 1 mini zip tie (battery); Nano, ADXL, reed = Kapton
  (v4 sled 6813.8 mm3 / 7.2 g; v3 8850.9 / 9.3)
  electronics: reed module ~1.5 g (est.); SmallParts allowance 13 g

[N] NOTES / OPEN
  * v2/v3 vs v1: servo + cradle + knob ref removed (D9aft: e-bay fires nothing).  The
    EbayCap M2 bosses stay at v1's SG90-ear (x, y), top Z 45.4 -> the D9aft v1/v2
    EbayCap fits unchanged (its pocket has spare voids where the cradle uprights were).
  * v1 EXPORT WAS MISSING THE NANO POCKET (disconnected, dropped by as_solid).  The
    D9aft v1/v2 checks exec'd that same sled, so they never saw it either.
  * RETENTION:
      screw-down  BMP388  -- 2 x M2.5 (y +9) from +x into spine standoffs; y -9 pads + Kapton
                             (pilots break out past R 19.4 beyond 4 mm: use M2.5 x 4 max)
      rails       ADXL375 -- PCB edges in 2 grooves, slide down from the top, Kapton on top
                  Piezo breakout -- 2 bosses, screw from the radial-INBOARD side
                  EbayCap -- 2 axial M2x10 from the cap top into the mount bosses
      strap       Nano (1.21 to ID) -- rails + 0.6 lip + Kapton; rests on the ADXL rail tops
                  Piezo can (1.18) -- nested + strap over the 11 mm can
      rails       Reed module -- PCB edges in aft + fwd slots, radial stop at the
                             header end, Kapton over the reed edge
      tie         Battery -- outboard-open tray, 1 axial mini zip tie (<= 2.5 wide) + Kapton;
                             pad the outboard face with ~1 mm foam so the bore backs it
  * QWIIC: wire the bus as a STAR at the Nano (Nano has no Qwiic port anyway): one
    cable to the ADXL's FWD plug, one to the BMP's FWD plug.  Neither AFT plug has room.
  * ASSEMBLY ORDER (screw access): piezo (driver through the spine holes) -> BMP ->
    ADXL (slide in) -> Nano -> reed module -> small parts -> battery -> EbayCap.
  * ADXL thickness with the plug in is ASSUMED 4.5 mm (slot is 4.7) -- measure it.
  * STIFFNESS NOT ANALYSED: frame loop is ring - spine - W boss - beam - E boss - reed
    rails - tray - ring; the Nano/ADXL column ties in at the ring, the piezo pocket
    and the top bar.  Overhangs / print orientation not checked yet.
  * Battery windows: a soft pouch can bulge into them under load -- 1 layer of Kapton
    or foam on the floor if the pack is a bare pouch.
  * REED MODULE dims are from a photo: measure PCB L x W x T, capsule d + offset from
    the edge, header height and pin length, then edit RM_* and re-run.  Press the lead
    loops flat before fitting (they ship standing ~5 mm proud).  Bend >= 2 mm from the glass.
  * D9aft v2 still exec's sled v1 (its SLED_SRC).  Sled v4 keeps every interface it reads
    (SERVO_TAB_X*, ADXL_CLEAR_Z, COMPONENTS, build_sled); a D9aft v3 pointing here regenerates
    the EbayCap pocket from this sled's top.  Its tie/JST keep-outs are not parts.
  * v5 hole patterns are MEASURED but approximate (BMP / ADXL / piezo, see [H]);
    still ASSUMED: the BMP PCB length (= 40 envelope), which piezo long side has the
    d2.5 hole, and the whole Nano pattern (NANO_HOLE_P*).  Check a test print before
    trusting the BMP boss positions; the y +/-9 bosses are clipped by the bore ([H]).
  * wall thickness after the pocket-clearance cut is not auto-checked -- eyeball the
    thin walls in CAD before printing.
  * free volume left: centre Z 0..24 (x -10..2, y -6..6) -- wiring runs there.
  * small-parts = ~13 g allowance in an open shelf; measure S7V8F5 / microSD rdr /
    C1 / SW1 / SW2 for real before this is frozen.
  * NOT modelled yet: static-port vent path; print orientation / support / split.

[E] EXPORT
  PhoenixABS40-43_avbay_ElectronicsSled_v5 .step + .stl
  FCStd -> Avionics/PhoenixABS40-43_avbay_sled_v5.FCStd  (Sled + env_* envelopes)
  sled_ASSEMBLY_v5.stl  (sled + component envelopes, flight position)
