ItzXyers/Rocketry/PhoenixABS40-43/Nosecone/nosecone_build_report_v5.txt

Phoenix ABS 40-43 -- Nosecone v5 (Von Karman, T5 separating nose) -- build report
Generated by PhoenixABS40-43_Nosecone_v5.py via FreeCADCmd. Z = 0 at tip, +Z aft; station = Z - 65.0.

GEOMETRY CHECKS
[PASS] solid is valid
[PASS] single solid (solids = 1)
[PASS] overall Z 0.00 .. 107.00 (nose 65.0 + shoulder 42.0)
[PASS] max radius 21.500 <= airframe R 21.50 (nothing proud)
[PASS] base OD 42.999 mm vs airframe 43.000 (step 0.001 mm)
[PASS] surface angle 0.25 mm fwd of the joint: 1.49 deg (tangent -> 0)
[PASS] shoulder contact bands dia 39.70 / 39.70 in the 40.00 bore (DESIGN 8.4: 39.6-39.8)
[PASS] relieved middle dia 39.20 (no friction, alignment only)
[PASS] shoulder engagement 42.0 mm >= 42 (DESIGN 9)
[INFO] min normal shell wall 2.00 mm at Z 44.0 (target 2.0; analytic, from the profile that built the solid)
[PASS] solid probe: shell material mid-wall and cavity open at Z 15/25/40/55/62 
[PASS] solid probe: tip solid forward of the funnel apex (Z 9)
[INFO] cavity self-supporting tip-up: steepest wall 45.0 deg from vertical (<= 45; analytic)
[NOTE] base ledge 1.65 mm (r 19.85 -> 21.50) prints as a short overhang tip-up; it must stay a flat seat face
[NOTE] tip is modeled sharp; FDM rounds it to ~0.4 mm radius -- aerodynamically free at M < 0.3
[PASS] detent pilots (station 8.0) sit inside the forward contact band
[PASS] solid probe: 3 detent pilots open at the OD, full 10 mm deep, blind (1.85 mm floor) 
[PASS] detent ring (to Z 89.3) clear of anchor bosses (from Z 95.0)
[PASS] solid probe: anchor pin hole open at +Y OD, blind on -Y (1.0 mm skin), bosses present
[INFO] anchor dowel length: flush at +Y to the blind end = 38.7 mm -> use d4 x 38.5 hardened dowel
[INFO] anchor: d4 dowel, 20 mm span, 250 N snatch placeholder (T5 README) -> 199 MPa bending: needs a HARDENED dowel
[INFO] anchor boss bearing 3.2 MPa per side at 250 N (ABS ~40 MPa)

MASS (solid ABS/ASA, rho 1.05 g/cm3)
  volume         37694.3 mm3
  mass              39.6 g
  CG                66.8 mm from tip (station 1.8)
  ballast fill to Z 20:    986 mm3 ->   6.9 g lead/epoxy, centroid Z 17.4
  ballast fill to Z 25:   2494 mm3 ->  17.5 g lead/epoxy, centroid Z 20.6
  ballast fill to Z 30:   4585 mm3 ->  32.1 g lead/epoxy, centroid Z 23.8

RESULT: ALL PASS (0 FAIL)

FILES
  Models/PhoenixABS40-43_nose_VonKarman_v5.step / .stl / _profile.csv
  Print Files/Nosecone/PhoenixABS40-43_nose_VonKarman_v5.stl (as modeled) + Ready to Print/ (tip up, shoulder on bed)
  PhoenixABS40-43_Nosecone_v5.FCStd
