ItzXyers/Rocketry/PhoenixABS40-43/Nosecone/nosecone_build_report_v1.txt

Phoenix ABS 40-43 -- Nosecone v1 -- build report
Generated by PhoenixABS40-43_Nosecone_v1.py, run via FreeCADCmd headless.
See NOSECONE_DESIGN.md for rationale. This report is geometry-only: it checks
what the CAD produced against the script's own parameters, not against a
physical part.

GEOMETRY CHECKS (all PASS -- every boolean step validated isValid()+Volume+BoundBox)

[PASS] Shell    : 1 solid, valid=True, volume=115017.5 mm^3, bbox matches
                  params (r<=21.5 all Z, Z 0..237)
[PASS] Door     : 1 solid, valid=True, volume=7516.0 mm^3, bbox Z 112.35..181.5
[PASS] LatchArm : 1 solid, valid=True, volume=440.1 mm^3
                  (first pass used Part.makeLoft between two rectangle wires
                  31 deg apart in clocking -- produced a valid-per-isValid()
                  but geometrically WRONG solid, volume -72.6 mm^3, about 16x
                  smaller than expected and negative-signed. isValid() alone
                  did not catch this; a volume sanity bound did. Replaced with
                  a primitive-only construction -- oriented connecting box +
                  hub cylinder + paddle box -- all fused with explicit overlap
                  margins per the OVERLAP note in aft_retention_v1.py.)

DIMENSIONAL CHECKS

[PASS] Airframe shoulder dia 39.7 mm -- within DESIGN.md item 11's 39.6-39.8 target
[PASS] Shoulder engagement 47 mm insertable (3 taper + 44 land) -- exceeds the
       >=43 mm (1 caliber) minimum
[PASS] Chute bay volume ~145,000 mm^3 vs 100x20x20=40,000 mm^3 pack -- 3.6x margin
[PASS] Door opening 66 x 32 mm -- shorter than the 100 mm pack, standard
       practice for soft-goods hatches; not a blocker
[PASS] Bay wall thickened to 3.5 mm (vs 2.0 ogive) around the door opening

MECHANISM -- DESIGN VERIFIED IN CAD, NOT YET BENCH-TESTED

[PASS] Door-swing clearance, peg vs fixed backstop: computed by rotating the
       peg tip about the true hinge axis (NOT each point's own local normal --
       the door is one rigid body on one hinge line) at 0/20/45/70 deg.
       margin: 2.1 / 25.3 / 53.2 / 78.5 mm -- peg swings AWAY from the
       backstop as the door opens, no collision found on this path. Does not
       check clearance against the shell opening edges or servo pad.
[FIXED] Hinge recess was originally cut as a flat 26mm-wide box on a curved
       (R=21.5) surface -- sagitta at that width is 4.4mm against a 0.6mm
       pocket depth, so it would have cut a small lens near the centre
       instead of a uniform pocket across the full width. Rebuilt as a true
       angular wedge cut (follows the cylinder exactly). Re-verified valid.
[OPEN] Latch proof load: does the fixed backstop actually carry the door's
       spring+aero load with the servo unpowered? Geometry supports it
       (backstop boss sits between gate and open direction, paddle engages
       peg over a computed 1.5mm radial depth spanning both the peg and
       backstop's angular positions); requires a physical test once printed.
       See NOSECONE_DESIGN.md item 1.
[OPEN] Servo footprint (34 x 14 mm pad, hole spacing) is generic SG90-class,
       not measured off the actual unit going into this build. Fused pad
       likely has a slightly lens-shaped (not flat-rectangular) contact area
       due to the same flat-box-on-curve effect as the hinge, at a much
       smaller (cosmetic, not structural) scale -- see NOSECONE_DESIGN.md
       item 8.
[OPEN] Hinge spring-steel strip is BOM, not modeled as a solid -- mounting
       recesses/holes exist in Shell and Door; strip itself is a bench part.
[OPEN] Avionics placement (trigger source for the servo) undecided --
       architecture note in NOSECONE_DESIGN.md.

KNOWN SIMPLIFICATIONS (not blockers, flagged for a v2)

[NOTE] Nose tip is a sharp analytic point (tangent ogive r=0 at z=0), not a
       blunted radius. Prints will round slightly from nozzle diameter alone.
[NOTE] Door opening corners are sharp, not filleted.
[NOTE] Shoulder (Z 193-237) is solid ABS, not hollowed -- ~27g of the Shell's
       120.8g @ 100% infill is this section; easy mass-reduction target later.
[NOTE] Print orientation not verified in a slicer (shoulder-down is the
       expected orientation; ogive tip region may need support past ~45 deg
       overhang, unconfirmed).

MASS (100% infill reference, RHO=1.05e-3 g/mm^3; real prints at typical
20-40% infill will be significantly lighter)

  Shell     120.7 g
  Door        7.8 g
  LatchArm    0.5 g
  ---------------
  Total     129.0 g  (printed parts only -- excludes servo ~9g, shim spring,
                       fasteners, chute, shock cord)

FILES

  Models/PhoenixABS40-43_nose_Shell_v1.step / .stl
  Models/PhoenixABS40-43_nose_Door_v1.step / .stl
  Models/PhoenixABS40-43_nose_LatchArm_v1.step / .stl
  PhoenixABS40-43_Nosecone_v1.FCStd
  PhoenixABS40-43_Nosecone_v1.py   (source of truth)
