ItzXyers/Rocketry/PhoenixABS40-43/Nosecone/nosecone_build_report_v2.txt

Phoenix ABS 40-43 -- Nosecone v2 (fairing split) -- build report
Generated by PhoenixABS40-43_Nosecone_v2.py, run via FreeCADCmd headless.
See NOSECONE_DESIGN.md for rationale. Supersedes nosecone_build_report_v1.txt
(v1 kept for history -- small door-window design, since replaced).

WHY V2: user feedback on v1 -- (1) ogive faceted visibly, (2) "the door
should BE the nosecone... at least 1/2 of it should detach... think like a
fairing." V2 rebuilds the ogive as a true circular arc (exact, not a
polyline) and splits the whole nosecone lengthwise into a fixed Spine +
hinged/latched DoorHalf.

GEOMETRY CHECKS (all PASS)

[PASS] outer_solid / inner_solid / full_shell : valid, single solid, smooth
       true-arc ogive (Part.Arc, not a polyline)
[PASS] Spine    : 1 solid, valid=True, volume=96510.6 mm^3
[PASS] DoorHalf : 1 solid, valid=True, volume=25990.3 mm^3
[PASS] LatchArm : 1 solid, valid=True, volume=387.3 mm^3 (same primitive-only
       construction as v1 -- no loft -- volume sanity-bound check passed)

VISUAL CHECK (screenshots pulled after build, both seam sides)

[PASS] Smooth ogive confirmed -- no facet banding visible at the tip in
       either "Left" or "Right" orthographic view (v1's screenshot showed
       clear waviness at the same views; v2 does not).
[PASS] Hinge seam visible running the full length tip-to-bulkhead, 3 hinge
       point recesses with paired screw holes at Z=110/145/172, as specced.
[PASS] Latch seam shows the servo pad, LatchArm gate, and peg in the
       expected closed/engaged position.

DIMENSIONAL CHECKS

[PASS] Airframe shoulder dia 39.7mm, 47mm insertable -- unchanged from v1,
       still within DESIGN.md item 11's target
[PASS] Chute access: entire ogive+barrel cavity exposed when DoorHalf opens
       (vs. a 66x32mm window in v1) -- strictly easier extraction

MECHANISM -- DESIGN VERIFIED IN CAD, NOT YET BENCH-TESTED

[PASS] Door-swing clearance, peg vs fixed backstop: rotated the peg tip about
       the TRUE hinge axis (theta=180 line, parallel to tube axis) at
       0/20/45/70/100 deg. margin: 1.7 (TIGHT, expected -- that's the latched
       engagement) / 5.5 / 24.7 / 42.8 / 61.4 mm.
[PASS] Door free-edge vs Spine-edge, 5 stations along the FULL seam
       (Z=10/50/90/130/170): every station's gap grows monotonically as phi
       increases (e.g. Z=130: 0.375 closed -> 3.4 @5deg -> 32.6mm @45deg).
       No station showed the edge moving toward the Spine.
[PASS] Aft-rim lip (added after review -- see AFT-RIM CAPTURE below) inner-
       radius corner, Z=182.5 and 184.2: same monotonic-growth pattern,
       0.31mm closed -> 6.6mm by 10 deg. Lip does not bind on opening.
[OPEN] Latch proof load (servo unpowered) -- physical test required, same as
       v1's open item 1.
[OPEN] Seam forward of the single latch point (Z=0-128, most of the ogive)
       relies on hinge strips alone -- flutter risk there is unverified. See
       NOSECONE_DESIGN.md item 2.
[OPEN] Hinge points restricted to the barrel (Z 110-172) -- none in the
       100mm ogive region. See NOSECONE_DESIGN.md item 3.
[OPEN] Servo footprint generic, not measured off the actual unit.
[OPEN] DoorHalf open-position stop not modeled -- see NOSECONE_DESIGN.md item 7.

AFT-RIM CAPTURE (added mid-review, after advisor flagged the aft edge as a
free unsupported cantilever right at the nosecone/body-tube joint)

DoorHalf's rim now extends 3mm further aft into a matching socket cut from
the Spine's bulkhead, radial walls at r=18/21.5 with 0.2mm clearance --
converts the aft edge from a flush butt joint (zero radial constraint) to a
captured one. Verified clear of binding on opening (see swing checks above)
before being kept in the model.

MASS (100% infill reference, RHO=1.05e-3 g/mm^3)

  Spine       100.6 g
  DoorHalf     31.2 g
  LatchArm      0.4 g
  ---------------
  Total       132.2 g  (printed parts only; close to v1's 129.0g -- same
                         shell material, now in 2 pieces plus the aft-rim lip)

FILES

  Models/PhoenixABS40-43_nose_Spine_v2.step / .stl
  Models/PhoenixABS40-43_nose_DoorHalf_v2.step / .stl
  Models/PhoenixABS40-43_nose_LatchArm_v2.step / .stl
  PhoenixABS40-43_Nosecone_v2.FCStd
  PhoenixABS40-43_Nosecone_v2.py   (source of truth)
