ItzXyers/Rocketry/PhoenixABS40-43/Nosecone/nosecone_build_report_v3.txt

Phoenix ABS 40-43 -- Nosecone v3 (oval door, radial servo, snap-in cord) -- build report
Generated by PhoenixABS40-43_Nosecone_v3.py, run via FreeCADCmd headless.
See NOSECONE_DESIGN.md for rationale. Supersedes nosecone_build_report_v2.txt
(v2 kept for history -- straight-seam lengthwise fairing split, since replaced).

WHY V3: user feedback on v2 (same session) -- (1) servo should point radially
out of the body, not just have a thin pad; (2) shock cord should thread
through the door and click into place, not just anchor at the bulkhead;
(3) the door should be an oval cut, bigger than a "middle" split, covering
more of the nose. V3 keeps v2's hinge+latch principle but replaces the
straight-seam split with a true oval (ellipse) boundary, sizes the servo
mount to the real measured SG90 envelope, and adds printed snap-in shock
cord clips on the door.

GEOMETRY CHECKS (all PASS, after fixing one bug mid-build -- see below)

[PASS] outer_solid / inner_solid / full_shell : valid, single solid (unchanged from v2)
[PASS] Spine    : 1 solid, valid=True, volume=105622.5 mm^3
[PASS] DoorHalf : 1 solid, valid=True, volume=18902.4 mm^3
[PASS] LatchArm : 1 solid, valid=True, volume=384.3 mm^3
[BUG->FIXED] First build left DoorHalf as 2 disconnected solids (bbox
       reaching to Z=237, the full shoulder land) -- the aft strip-cut that
       clears non-door material only reached Z_BULK1+2=192, not the shoulder
       end. Fixed to strip to Z_SH1+2=239; re-run confirmed DoorHalf is a
       single solid bounded Z 35-178 as intended.

VISUAL CHECK (FreeCAD viewport screenshots, Left/Right views)

[PASS] Oval door boundary reads clearly as a true oval/lens shape on the
       "Left" view, running from well up the ogive to just short of the
       bulkhead -- confirms the ellipse boundary + staircase Boolean
       approach produced the intended shape, not something degenerate.
       (Boundary shows the DZ_SPLIT=1.5mm staircase as very fine faceting --
       cosmetic only; tighten DZ_SPLIT if a smoother line is wanted.)
[PASS] "Right" view shows the servo pad (2 mounting holes), LatchArm (hub +
       gate paddle) in the expected closed/engaged position, proportionate
       to the airframe -- not an oversized external blister.

MECHANISM -- DESIGN VERIFIED IN CAD, NOT YET BENCH-TESTED

[PASS] Door-swing clearance, peg vs fixed backstop, rotated about the
       hinge-cluster axis (approximated as the line through the centre
       hinge point, theta=95.0 deg -- the ellipse's flat peak): margin 1.3
       (TIGHT, expected -- latched engagement) / 5.5 / 24.8 / 42.8 / 61.4 mm
       at 0/20/45/70/100 deg.
[PASS] Door free-edge (latch side) vs Spine-edge, 5 stations spanning the
       oval (Z=50/80/106.5/135/165): every station's gap grows
       monotonically with opening angle, no station moved toward the Spine.
[PASS] Payload extraction (computed post-build, not yet bench-fit): mouth
       chord 2*r(z)*sin(halfwidth(z)) exceeds 20mm continuously from
       Z=45 to Z=170 (125mm run, peak ~42.8mm at centre) -- more than the
       100x20x20mm pack's 100mm length, so it can slide out axially through
       the mid-travel of the oval. Narrows below 20mm only in the last
       ~10mm at each tapered end. 2D mouth-chord check only, not a full 3D
       swept-clearance check, and doesn't know the pack's actual rest
       position in the cavity.
[OPEN] Latch proof load (servo unpowered) -- physical test, same open item
       carried from v1/v2.
[OPEN] Hinge cluster spans only 20mm (Z 96.5-116.5) out of the door's 143mm
       length (Z 35-178) -- a SHORTER fraction of the seam than v2's 3
       points over 62mm of a 182mm door. Flutter risk forward/aft of the
       cluster is unverified and is now a bigger open question than it was
       in v2, not a smaller one -- bench-test before flight.
[OPEN] Servo mount assumes the SG90's tab flange sits ~5mm from the
       shaft/top end of the case (so only that much is proud of the OD,
       17.7mm hangs inboard) -- not confirmed against the actual unit.
       Bench-verify before cutting the through-wall port; if the real
       flange position differs, SERVO_OUT_PROUD/SERVO_IN_DEPTH need
       re-splitting and the port + pad re-run.
[OPEN] Servo's inboard 17.7mm depth is not checked against the folded
       parachute pack's actual position in the bay -- this model has no
       packing diagram for this cavity (unlike the old avbay). Verify the
       servo's Z/theta placement (Z=106.5, on the Spine side) doesn't
       foul the pack before final assembly.
[OPEN] Shock cord clips sized for 6mm cord (typical for this airframe
       class, not the confirmed actual cord) -- re-size CORD_D if different.
[OPEN] DoorHalf open-position stop not modeled (carried from v2).

DESIGN DECISIONS MADE THIS REVISION (flagged for user review, not silently assumed)

1. Hinged doors cannot exceed 180 deg of arc -- a door subtending more than
   that contains two diametrically-opposite points, making its own width
   (2R) exceed the mouth it must pass through at every opening angle: it is
   geometrically trapped, not just hard to hinge. Built to 170 deg (peak),
   as close to that ceiling as GAP_DEG leaves room for. "More than middle"
   is realised as more of the nose's LENGTH (Z 35-178, most of the forward
   nosecone) rather than more arc. Be clear this is a trade: v3's door is
   actually SMALLER than v2's by every measure (19.8g vs 31.2g, tapers to
   points instead of running full width the whole 182mm length) -- v2's
   straight 180/180 split was already the largest a hinged door can be.
   The oval SHAPE was the explicit ask; if maximum open area matters more
   than the oval shape, that's a different trade to make deliberately, not
   something this revision assumed.
2. Servo shaft stays radial (matches the request) but mounted THROUGH the
   wall rather than fully external: the tab flange sits at the outer
   surface, only the short shaft-side of the case (~5mm) is proud outside,
   the long base-side (~17.7mm) hangs in the already-open bay cavity. A
   fully-external mount would have put ~17-23mm of servo case sticking
   straight out of a 43mm-OD tube -- a large, aerodynamically bad blister.
   This is an ASSUMPTION about which side of the SG90's mounting flange is
   closer to the shaft -- flagged above, bench-verify.
3. Shock cord's PRIMARY anchor stays the M4 bulkhead eyebolt (unsplit
   Spine, unchanged from v2) -- this still carries the actual parachute
   snatch load. The door's new snap clips are routing/dressing features
   only (un-proven cantilever geometry), not a load path. If flight loads
   are meant to run through the door instead, that is a bigger, separate
   change (the hinge + latch would need to be sized for snatch load, not
   just holding the door shut) -- flag if that's actually what's wanted.

MASS (100% infill reference, RHO=1.05e-3 g/mm^3)

  Spine       110.9 g
  DoorHalf     19.8 g
  LatchArm      0.4 g
  ---------------
  Total       131.1 g  (printed parts only -- close to v2's 132.2g: Spine
                         gained the servo port/pad/backstop and lost less to
                         the smaller oval cut; DoorHalf lost significant
                         mass vs v2's half-shell, 19.8g vs 31.2g, since the
                         oval tapers to points instead of running full width
                         the whole length)

FILES

  Models/PhoenixABS40-43_nose_Spine_v3.step / .stl
  Models/PhoenixABS40-43_nose_DoorHalf_v3.step / .stl
  Models/PhoenixABS40-43_nose_LatchArm_v3.step / .stl
  PhoenixABS40-43_Nosecone_v3.FCStd
  PhoenixABS40-43_Nosecone_v3.py   (source of truth)
