ItzXyers/Rocketry/PhoenixABS40-43/Nosecone/nosecone_build_report_v4.txt

Phoenix ABS 40-43 -- Nosecone v4 (keel + bow-door, no hinge) -- build report
Generated by PhoenixABS40-43_Nosecone_v4.py, run via FreeCADCmd headless.

UPDATE HISTORY (same session), oldest first: (1) grew the keel 50%, then
"widen more" -> 70deg -> 105deg -> 158deg total. (2) Servo re-mounted
axially, latch simplified to a bare hub+pin (no gate/arm/backstop) -- a
purely axial escape force produces zero torque about an axial shaft. (3)
BUG FOUND BY THE USER: axial servo port overshot the OD by 1mm, gouging
the skin -- fixed to OVERLAP=0.5mm margin + a hard assertion. (4) Added a
light ejection spring (Keel pocket + Door pusher tab), pushing the Door
axially forward. (5) v4.4: three linked changes -- (a) latch hub moved
fully INBOARD (was proud of the OD, a visible 16mm bump), (b) tip
ownership INVERTED from Door to Keel + keel widened again to 200deg
total, (c) spring reoriented to push the Door OPEN (tangential-at-the-
seam) with a captured-pin "battery door" mechanism: fixed pins/sockets at
the Door's fore (tip) end, servo-released keyhole latch at the aft end
only, plus a backstop (reintroduced -- the radial load DOES torque the
axial shaft, unlike the pure-axial case). (6) v4.5 (CURRENT, this
report): two follow-ups after the user reviewed a v4.4 render -- (a) "why
do we still have a giant rectangular hole" -- v4.4's hub fix only moved
the LATCH pin inboard, it never touched the SERVO BODY's own mount, which
had been flush with the OD (a ~26x18.5mm through-wall port) since (2)
above -- fixed by moving the servo's flange to the INNER wall instead, no
wall cut needed at all now. (b) "why do we have the latch arm still" --
a naming complaint, not a design one: the part had been called `LatchArm`
since before this session (a holdover from an older arm/gate/backstop
design); renamed to `ServoHorn` throughout. Numbers below reflect ALL SIX
updates. See NOSECONE_DESIGN.md for full rationale.

WHY V4.4/4.5: user feedback (2026-09-15, same session as v4/v4.2/v4.3):
"The bulk of the servo should be kept inside the rocket, only the tip
should point out (a 4mm D hole). Also, the nose point should be with the
keel not the door, and I want more of the rocket to be keel, less door.
Also nr 3; I want the spring to press against the thing from an 'upward'
perspective. I.e. it should try to open the door and the servo should
stop it. We should have a pin and socket mechanism that makes the door
only openable from the bottom (towards the ground when standing). Like
however they do some battery doors." Then, reviewing the v4.4 render:
"Where is the spring etc? And why do we still have a giant rectangular
hole?" and "why do we have the latch arm still?"

GEOMETRY CHECKS (all PASS, clean build -- no errors on this run)

[PASS] outer_solid / inner_solid / full_shell : valid, single solid (unchanged)
[PASS] Spine (keel, 200deg + bulkhead/shoulder + owns the tip + servo mounting bosses) :
       1 solid, valid=True, volume=100,011.6 mm^3
[PASS] DoorHalf (160deg, Z 25-178, no longer reaches the tip) : 1 solid, valid=True, volume=23,001.5 mm^3
[PASS] ServoHorn (hub+shaft+head, inboard; renamed from LatchArm) : 1 solid, valid=True, volume=551.3 mm^3

BUG CAUGHT THIS PASS, fixing the servo mount (not present in the shipped v4.4 build)

[BUG->FIXED] First attempt at moving the servo's mounting bosses inboard
       fused them at `SERVO_THETA +/- PAD_HOLE_THETA` with the old 20deg
       offset -- one boss landed outside the Keel's own angular span
       (KEEL_HALFW=100deg from centre), in territory already cut away for
       the Door, where the Keel has no material to fuse to. Came out as a
       disconnected floating solid (`spine` reported `solids=2`, not 1),
       caught immediately by inspecting the solid count rather than
       assuming the fuse worked. Fixed by shrinking `PAD_HOLE_THETA` to
       6deg (well inside the Keel's span) and adding a hard
       `len(spine.Solids) != 1` assertion so this can't silently recur.

VISUAL CHECK (FreeCAD viewport screenshots, isometric + exploded + close-up + half-section)

[PASS] Assembled isometric + Right-side view: NO rectangular hole visible
       anywhere on the exterior now -- confirms the servo-mount fix.
       Previously the servo case's port was visible as a large rectangular
       cutout even after the v4.3 depth fix, since that fix only corrected
       how DEEP the cut went, not the fact that it was a through-wall cut
       at all.
[PASS] Exploded view (DoorHalf +60mm X): Spine (keel) runs all the way to
       the tip and tapers to the true point; DoorHalf starts partway down
       (Z=25) and no longer includes the tip -- matches "the nose point
       should be with the keel."
[PASS] Close-up on ServoHorn: hub disk (with pilot hole) + a visibly
       stepped shaft-to-head transition (the keyhole "mushroom" profile);
       small enough that from outside only a small pin is visible poking
       through the wall into the Door's lug boss. Two new mounting-boss
       "eyelets" visible fused to the Spine immediately behind the hub,
       confirming the servo's own anchor points, post-fix.
[PASS] Half-section cutaway (temporary, not saved): used to locate the
       spring pocket precisely for the user, since it sits at r=17.75mm
       inside the ~3.5mm wall and is not visible from any exterior angle
       by design (same reason it wasn't obvious from a render -- it's a
       captive internal feature, not a surface one, unlike the snap-clicks
       and fore-capture pins which sit near the OD and do show as small
       exterior marks).

MECHANISM -- DESIGN VERIFIED IN CAD, NOT YET BENCH-TESTED

[PASS] [9.5] Axial-load torque check (still applies, e.g. handling loads):
       hub=(0.0,18.5,150.0), pin tip=(-7.4,26.0,150.0), torque from a 250N
       purely-axial test load = -0.000000 N*mm. Reverified against the
       inboard hub/pin geometry -- still holds, a property of any
       purely-axial force (zero X/Y components), independent of hub position.
[PASS] [9.5b] Radial-load torque check (the spring's ACTUAL load, since
       v4.4): torque from a 15N radial test load = -76.489 N*mm --
       nonzero, as expected (why a backstop is back). Backstop placed at
       theta=82.0 (side=-): confirmed on the CORRECT side by the sign
       check, not just assumed -- the build raises a RuntimeError if a
       future parameter edit flips it to the wrong side.
[OPEN] Backstop sized by inspection against a representative 15N spring
       force (4x6x2mm boss) -- not a margin/strength calculation.
[OPEN] Wall pass-through for the latch pin is honestly a short SLOT, not a
       perfect 4mm circle -- the pin sweeps a small tangential arc as the
       hub rotates between latched/released (closed-position snapshot
       only, not a swept-motion sim).
[OPEN] Fore-capture pins' disengagement (how far the Door's aft edge must
       swing before the fore pins clear their pockets) is asserted by
       construction, not verified by any swept-motion check.
[OPEN] Latch proof load, servo unpowered -- physical test, carried from
       v1-v4.3, now testing a DIFFERENT load path: radial pull on the
       keyhole lug resisted by the pin's head against the neck shoulder,
       reacted through a fixed backstop -- not axial pin bending anymore.
[OPEN] Snap-click mechanics (assembly force / scratching over the ~150mm
       slide-in) -- unchanged open item from v4.2/4.3.
[ADDRESSED, NOT CLOSED] Separation energy source: spring pushes the Door
       radially/tangentially OPEN (5deg of modeled angular travel),
       reacted against the fore-capture pivot -- matches "battery door"
       mechanically, but the actual spring (rate/force) is still
       unselected. Bench-test with a real spring before flight.
[OPEN] Keel section-loss at the latch/servo/backstop cluster (Z~146.5-
       173) -- sole structural path forward of the bulkhead, though the
       keel itself is now much wider (200deg) than v2/v3's spine.
[OPEN] Servo mount's flange-to-shaft split (5mm out / 17.7mm in) and
       mounting-hole spacing -- unconfirmed assumptions, unchanged from
       v3/v4.2-v4.4; the RADIAL mount position (v4.5's fix) is new and
       geometrically checked (case fits inboard of R_BAY_IN with margin),
       but not bench-verified against a real unit yet.

MASS (100% infill reference, RHO=1.05e-3 g/mm^3)

  Spine (keel)  105.0 g
  DoorHalf       24.2 g
  ServoHorn       0.6 g
  ---------------
  Total         129.8 g (essentially unchanged from v4.3's 128.1g -- the
                          keel grew wider, gained the tip, and picked up
                          the small mounting bosses; the door shrank
                          correspondingly, net mass barely moves)

FILES

  Models/PhoenixABS40-43_nose_Spine_v4.step / .stl
  Models/PhoenixABS40-43_nose_DoorHalf_v4.step / .stl
  Models/PhoenixABS40-43_nose_ServoHorn_v4.step / .stl   (was LatchArm_v4 -- old files removed)
  PhoenixABS40-43_Nosecone_v4.FCStd
  PhoenixABS40-43_Nosecone_v4.py   (source of truth)
