ItzXyers/Rocketry/PhoenixABS40-43/Models/_render/aft_assembly_iso.png

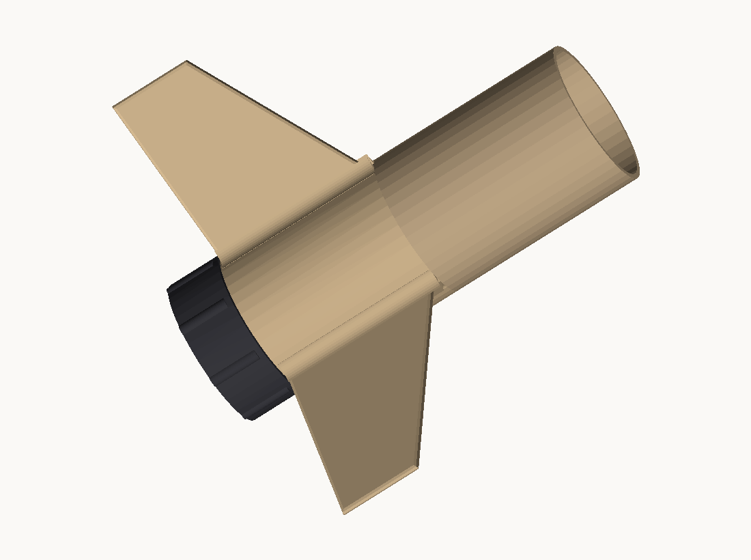
PhoenixABS40-43/Models/_render/aft_assembly_iso.png
