ItzXyers/Rocketry/PhoenixABS40-43/Models/PhoenixABS40-43_full_assembly_T5v2_v1_section.png

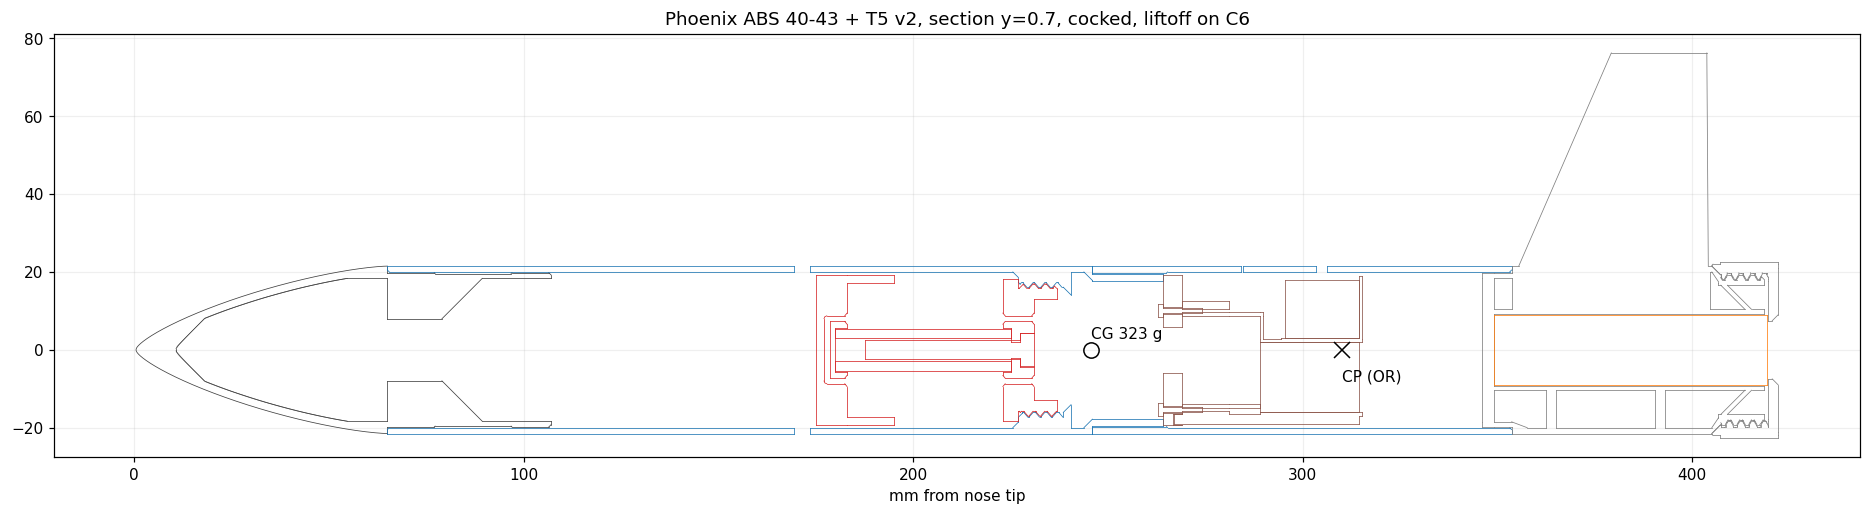
PhoenixABS40-43/Models/PhoenixABS40-43_full_assembly_T5v2_v1_section.png
