ItzXyers/Rocketry/PhoenixABS40-43/Nosecone/aero/verify_v5_openrocket.txt

## non-nose dry mass 245 g
ballast= 0.0g nose= 39.6g cg= 66.8mm | A8 liftoff=301g CP=310 CG=239 margin=1.65 apogee=1.1m vmax=4.5 rail=1.5 | B4 liftoff=304g CP=310 CG=240 margin=1.62 apogee=4.6m vmax=7.7 rail=3.9 | C6 liftoff=308g CP=310 CG=242 margin=1.58 apogee=19.0m vmax=11.3 rail=4.8  <-- meets 1.5
ballast= 2.5g nose= 42.1g cg= 64.1mm | A8 liftoff=303g CP=310 CG=237 margin=1.69 apogee=1.1m vmax=4.4 rail=1.3 | B4 liftoff=306g CP=310 CG=238 margin=1.67 apogee=4.5m vmax=7.6 rail=3.8 | C6 liftoff=310g CP=310 CG=240 margin=1.62 apogee=18.5m vmax=11.1 rail=4.8  <-- meets 1.5
ballast= 5.0g nose= 44.6g cg= 61.6mm | A8 liftoff=306g CP=310 CG=235 margin=1.73 apogee=1.1m vmax=4.4 rail=1.1 | B4 liftoff=309g CP=310 CG=236 margin=1.71 apogee=4.4m vmax=7.6 rail=3.7 | C6 liftoff=313g CP=310 CG=238 margin=1.66 apogee=18.0m vmax=10.9 rail=4.7  <-- meets 1.5
ballast= 7.5g nose= 47.1g cg= 59.4mm | A8 liftoff=308g CP=310 CG=234 margin=1.77 apogee=1.0m vmax=4.3 rail=0.8 | B4 liftoff=311g CP=310 CG=235 margin=1.75 apogee=4.3m vmax=7.6 rail=3.7 | C6 liftoff=315g CP=310 CG=237 margin=1.70 apogee=17.6m vmax=10.6 rail=4.6  <-- meets 1.5
ballast=10.0g nose= 49.6g cg= 57.5mm | A8 liftoff=311g CP=310 CG=232 margin=1.81 apogee=1.0m vmax=4.3 rail=0.3 | B4 liftoff=314g CP=310 CG=233 margin=1.79 apogee=4.1m vmax=7.5 rail=3.6 | C6 liftoff=318g CP=310 CG=235 margin=1.74 apogee=17.1m vmax=10.4 rail=4.6  <-- meets 1.5
ballast=12.5g nose= 52.1g cg= 55.7mm | A8 liftoff=313g CP=310 CG=230 margin=1.85 apogee=1.0m vmax=4.2 rail=NaN | B4 liftoff=316g CP=310 CG=231 margin=1.83 apogee=4.0m vmax=7.5 rail=3.6 | C6 liftoff=320g CP=310 CG=233 margin=1.78 apogee=16.7m vmax=10.2 rail=4.5  <-- meets 1.5
ballast=15.0g nose= 54.6g cg= 54.1mm | A8 liftoff=316g CP=310 CG=228 margin=1.89 apogee=0.9m vmax=4.1 rail=NaN | B4 liftoff=319g CP=310 CG=230 margin=1.86 apogee=3.9m vmax=7.4 rail=3.5 | C6 liftoff=323g CP=310 CG=232 margin=1.82 apogee=16.3m vmax=10.0 rail=4.5  <-- meets 1.5
ballast=17.5g nose= 57.1g cg= 52.6mm | A8 liftoff=318g CP=310 CG=227 margin=1.93 apogee=0.9m vmax=4.1 rail=NaN | B4 liftoff=321g CP=310 CG=228 margin=1.90 apogee=3.8m vmax=7.3 rail=3.5 | C6 liftoff=325g CP=310 CG=230 margin=1.86 apogee=15.8m vmax=9.8 rail=4.4  <-- meets 1.5
ballast=20.0g nose= 59.6g cg= 51.3mm | A8 liftoff=321g CP=310 CG=225 margin=1.97 apogee=0.9m vmax=4.0 rail=NaN | B4 liftoff=324g CP=310 CG=226 margin=1.94 apogee=3.7m vmax=7.3 rail=3.4 | C6 liftoff=328g CP=310 CG=228 margin=1.90 apogee=15.4m vmax=9.6 rail=4.4  <-- meets 1.5
ballast=22.5g nose= 62.1g cg= 50.1mm | A8 liftoff=323g CP=310 CG=224 margin=2.00 apogee=0.9m vmax=4.0 rail=NaN | B4 liftoff=326g CP=310 CG=225 margin=1.98 apogee=3.6m vmax=7.2 rail=3.4 | C6 liftoff=330g CP=310 CG=227 margin=1.93 apogee=15.0m vmax=9.5 rail=4.4  <-- meets 1.5
ballast=25.0g nose= 64.6g cg= 48.9mm | A8 liftoff=326g CP=310 CG=222 margin=2.04 apogee=0.8m vmax=3.9 rail=NaN | B4 liftoff=329g CP=310 CG=223 margin=2.01 apogee=3.5m vmax=7.2 rail=3.3 | C6 liftoff=333g CP=310 CG=225 margin=1.97 apogee=14.7m vmax=9.5 rail=4.3  <-- meets 1.5
ballast=27.5g nose= 67.1g cg= 47.9mm | A8 liftoff=328g CP=310 CG=221 margin=2.08 apogee=0.8m vmax=3.9 rail=NaN | B4 liftoff=331g CP=310 CG=222 margin=2.05 apogee=3.5m vmax=7.1 rail=3.3 | C6 liftoff=335g CP=310 CG=224 margin=2.00 apogee=14.3m vmax=9.6 rail=4.3  <-- meets 1.5
ballast=30.0g nose= 69.6g cg= 46.9mm | A8 liftoff=331g CP=310 CG=219 margin=2.11 apogee=0.8m vmax=3.8 rail=NaN | B4 liftoff=334g CP=310 CG=220 margin=2.08 apogee=3.4m vmax=7.0 rail=3.2 | C6 liftoff=338g CP=310 CG=222 margin=2.04 apogee=13.9m vmax=9.6 rail=4.2  <-- meets 1.5
## non-nose dry mass 180 g
ballast= 0.0g nose= 39.6g cg= 66.8mm | A8 liftoff=236g CP=310 CG=234 margin=1.77 apogee=2.4m vmax=6.0 rail=3.7 | B4 liftoff=239g CP=310 CG=235 margin=1.74 apogee=9.4m vmax=8.5 rail=5.5 | C6 liftoff=243g CP=310 CG=238 margin=1.68 apogee=37.9m vmax=19.0 rail=6.4  <-- meets 1.5
ballast= 2.5g nose= 42.1g cg= 64.1mm | A8 liftoff=238g CP=310 CG=231 margin=1.82 apogee=2.4m vmax=5.9 rail=3.6 | B4 liftoff=241g CP=310 CG=233 margin=1.79 apogee=9.1m vmax=8.3 rail=5.4 | C6 liftoff=245g CP=310 CG=235 margin=1.73 apogee=36.9m vmax=18.6 rail=6.3  <-- meets 1.5
ballast= 5.0g nose= 44.6g cg= 61.6mm | A8 liftoff=241g CP=310 CG=229 margin=1.87 apogee=2.3m vmax=5.9 rail=3.5 | B4 liftoff=244g CP=310 CG=231 margin=1.84 apogee=8.9m vmax=8.3 rail=5.3 | C6 liftoff=248g CP=310 CG=233 margin=1.78 apogee=35.9m vmax=18.2 rail=6.2  <-- meets 1.5
ballast= 7.5g nose= 47.1g cg= 59.4mm | A8 liftoff=243g CP=310 CG=227 margin=1.92 apogee=2.2m vmax=5.8 rail=3.4 | B4 liftoff=246g CP=310 CG=229 margin=1.89 apogee=8.6m vmax=8.3 rail=5.3 | C6 liftoff=250g CP=310 CG=231 margin=1.83 apogee=35.0m vmax=17.9 rail=6.2  <-- meets 1.5
ballast=10.0g nose= 49.6g cg= 57.5mm | A8 liftoff=246g CP=310 CG=225 margin=1.97 apogee=2.2m vmax=5.8 rail=3.4 | B4 liftoff=249g CP=310 CG=227 margin=1.94 apogee=8.4m vmax=8.3 rail=5.2 | C6 liftoff=253g CP=310 CG=229 margin=1.88 apogee=34.0m vmax=17.5 rail=6.1  <-- meets 1.5
ballast=12.5g nose= 52.1g cg= 55.7mm | A8 liftoff=248g CP=310 CG=223 margin=2.02 apogee=2.1m vmax=5.7 rail=3.3 | B4 liftoff=251g CP=310 CG=224 margin=1.98 apogee=8.1m vmax=8.3 rail=5.1 | C6 liftoff=255g CP=310 CG=227 margin=1.93 apogee=33.1m vmax=17.2 rail=6.0  <-- meets 1.5
ballast=15.0g nose= 54.6g cg= 54.1mm | A8 liftoff=251g CP=310 CG=221 margin=2.07 apogee=2.0m vmax=5.7 rail=3.2 | B4 liftoff=254g CP=310 CG=222 margin=2.03 apogee=7.9m vmax=8.3 rail=5.1 | C6 liftoff=258g CP=310 CG=225 margin=1.97 apogee=32.2m vmax=16.9 rail=6.0  <-- meets 1.5
ballast=17.5g nose= 57.1g cg= 52.6mm | A8 liftoff=253g CP=310 CG=219 margin=2.11 apogee=2.0m vmax=5.6 rail=3.1 | B4 liftoff=256g CP=310 CG=220 margin=2.08 apogee=7.7m vmax=8.3 rail=5.0 | C6 liftoff=260g CP=310 CG=223 margin=2.02 apogee=31.4m vmax=16.5 rail=5.9  <-- meets 1.5
ballast=20.0g nose= 59.6g cg= 51.3mm | A8 liftoff=256g CP=310 CG=217 margin=2.16 apogee=1.9m vmax=5.5 rail=3.1 | B4 liftoff=258g CP=310 CG=219 margin=2.12 apogee=7.5m vmax=8.2 rail=4.9 | C6 liftoff=263g CP=310 CG=221 margin=2.06 apogee=30.5m vmax=16.2 rail=5.8  <-- meets 1.5
ballast=22.5g nose= 62.1g cg= 50.1mm | A8 liftoff=258g CP=310 CG=215 margin=2.20 apogee=1.9m vmax=5.5 rail=3.0 | B4 liftoff=261g CP=310 CG=217 margin=2.17 apogee=7.3m vmax=8.2 rail=4.9 | C6 liftoff=265g CP=310 CG=219 margin=2.11 apogee=29.7m vmax=15.9 rail=5.8  <-- meets 1.5
ballast=25.0g nose= 64.6g cg= 48.9mm | A8 liftoff=261g CP=310 CG=213 margin=2.25 apogee=1.8m vmax=5.4 rail=2.9 | B4 liftoff=263g CP=310 CG=215 margin=2.21 apogee=7.1m vmax=8.2 rail=4.8 | C6 liftoff=268g CP=310 CG=217 margin=2.15 apogee=28.9m vmax=15.6 rail=5.7  <-- meets 1.5
ballast=27.5g nose= 67.1g cg= 47.9mm | A8 liftoff=263g CP=310 CG=211 margin=2.29 apogee=1.7m vmax=5.4 rail=2.8 | B4 liftoff=266g CP=310 CG=213 margin=2.25 apogee=6.9m vmax=8.2 rail=4.7 | C6 liftoff=270g CP=310 CG=215 margin=2.19 apogee=28.2m vmax=15.3 rail=5.7  <-- meets 1.5
ballast=30.0g nose= 69.6g cg= 46.9mm | A8 liftoff=266g CP=310 CG=210 margin=2.33 apogee=1.7m vmax=5.3 rail=2.8 | B4 liftoff=268g CP=310 CG=211 margin=2.29 apogee=6.7m vmax=8.2 rail=4.7 | C6 liftoff=273g CP=310 CG=214 margin=2.24 apogee=27.4m vmax=15.0 rail=5.6  <-- meets 1.5
