ItzXyers/Rocketry/PhoenixABS40-43/Models/aero_D9aft/verify_D9aft_v5_openrocket.txt

== OpenRocket 24.12 check for D9aft v5 (sled v4 + reed module; slotted fin can v4; else v3) ==
NOSE_G=14.6 NOSE_CG=43.8 NS_BODY_G=204.7 NS_BODY_LEN=340 NS_BODY_CGX=165.0; 'rod' = guided travel (physical = guided + ~0.29 m)
STAB liftoff 246.4 g CG 235.9 | burnout 230.3 g CG 225.6 | CP(M0.1) 312.6 | margin liftoff 1.78 burnout 2.02 cal
SIM D9-3 rod 2.0 m | apogee 193.6 m @ 5.86 s | vmax 57.8 m/s | rail exit 15.3 m/s | eject t=5.24 alt 190.3 m v 20.5 m/s | optimum delay 5.05 s | ground hit 4.84 m/s | flight 46.0 s
SIM D9-5 rod 2.0 m | apogee 211.1 m @ 7.29 s | vmax 57.8 m/s | rail exit 15.3 m/s | eject t=7.24 alt 211.1 m v 0.5 m/s | optimum delay 5.05 s | ground hit 4.84 m/s | flight 51.0 s
SIM D9-7 rod 2.0 m | apogee 211.1 m @ 7.29 s | vmax 57.8 m/s | rail exit 15.3 m/s | eject t=9.24 alt 194.5 m v 15.5 m/s | optimum delay 5.09 s | ground hit 4.84 m/s | flight 48.9 s
SAVED C:/Users/dick_/Documents/Rocketry/PhoenixABS40-43/PhoenixABS40-43_D9aft_v5.ork
