ItzXyers/Rocketry/PhoenixABS40-43/Models/PhoenixABS40-43_D9aft_SNAPLATCH_DRAFT.py

# -*- coding: utf-8 -*-
"""
Phoenix ABS 40-43 -- D9aft v7: PRINTED SNAP LATCH replaces the printed shear pins.

Why: the v1 shear pins (0.8 mm thick, 0.6 mm neck) do not print -- they come out as blobs (user, 2026-10-07).
The snap-latch coupon (Models/PhoenixABS40-43_SnapLatchCoupon_v1.py / _v2.py) was printed: L24 held
873 g = 8.6 N per pair on its first pull (model 12.1 N). The user asked to implement it without further
tests ("we can't afford to test right now").

Changes from v6 (v6 is exec'd read-only up to its checks; no earlier file is edited):
  AftTube   the 2 pin slots are FILLED (the exact slot volumes, clipped to the wall, are fused back) and
            2 L24 tongues are cut at 60 / 180 deg (= the old pin angles), with coupon v2's geometry
            (7 mm aft band, 1.0 aft gap, 0.8 end slot, 45 deg slanted forward edge, 1.2 mm tongue,
            bump 1.2 x 5 x 4.08, release 45 deg / entry 30 deg). Printed forward end down, as v6.
  fin can   the v4 slotted fin can (cfg B section + v1 make_fincan features) with its pin slots FILLED and
            2 coupler windows at 60 / 180 deg, matched 45 deg forward face (coupon v2 geometry, in the
            fin-can frame: tube aft face = the coupler shoulder, Zf %SHOULDER_Z).
  pins      gone (no ShearPin, no card, no pin coupon).
  unchanged nose v6, FwdTube v6, EbayCap v6, sled v6, fins v4, cap v1, body length, bay length.
  The latch angles are uneven (120 / 240 deg apart), so only one clocking of the fin can clicks in --
  the same one the pins allowed (fins clear of the launch-rod line).

Run headless:
  "C:\\Users\\dick_\\AppData\\Local\\Programs\\FreeCAD 1.1\\bin\\freecadcmd.exe" -c "exec(open(r'<this file>').read())"
Frame z = BODY_LEN - station (z = 0 is the fin-can aft face, as v1). Any FAIL line means do not print.
"""
import os, math, time
t7 = time.time()
_M = r"C:\Users\dick_\Documents\Rocketry\PhoenixABS40-43\Models"
V6_SRC = os.path.join(_M, "PhoenixABS40-43_D9aft_v6.py")
CPN1_SRC = os.path.join(_M, "PhoenixABS40-43_SnapLatchCoupon_v1.py")
CPN2_PATCH = [("BAND_AFT = 4.0 ", "BAND_AFT = 7.0 ")]          # = coupon v2 (the geometry the user printed last)

# ---------------- v6 geometry (chain v1 -> v2 -> v3 -> v5 -> v6), stopped before v6's checks
_v6 = open(V6_SRC, encoding="utf-8").read()
_c6 = _v6.index("\n# CHECKS\n"); _c6 = _v6.rfind("# ====", 0, _c6)
exec(_v6[:_c6])
print("v6 geometry in %.1f s" % (time.time() - t7), flush=True)

# ---------------- coupon latch geometry, in its own namespace (it redefines pol/rev/report/... )
_cs = open(CPN1_SRC, encoding="utf-8").read()
for _a, _b in CPN2_PATCH:
    assert _cs.count(_a) == 1, _a
    _cs = _cs.replace(_a, _b)
_cb = _cs.index("\n# BUILD\n"); _cb = _cs.rfind("# ====", 0, _cb)
CPN = {}
exec(compile(_cs[:_cb], CPN1_SRC + " [coupon v2 params]", "exec"), CPN)
assert CPN['BAND_AFT'] == 7.0
for k in ('R_OD', 'R_ID', 'CPL_R_O', 'CPL_R_I'):
    assert abs(CPN[k] - globals()[k]) < 1e-9, "coupon wall %s differs from the flight wall" % k

def _beam(L, E, n=800):
    """coupon v1 beam(): curved, tapered cantilever, radial tip load at the bump (same formula)."""
    sb = L - CPN['S_B_OFF']; ds = sb / n; J = 0.0; arr = []
    for i in range(n):
        s_ = (i + 0.5) * ds
        I = (CPN['W_TIP'] + (L - s_) * CPN['TAPER']) * CPN['T_TONGUE'] ** 3 / 12
        m = CPN['R_T'] * math.sin((sb - s_) / CPN['R_T'])
        J += m * m / (E * I) * ds; arr.append((m, I))
    Pn = CPN['DELTA'] / J
    return Pn, max(Pn * m * (CPN['T_TONGUE'] / 2) / (E * I) for m, I in arr)
def _fac(a, mu):
    ta = math.tan(math.radians(a)); return (ta + mu) / (1 - mu * ta)
CPN['beam'], CPN['fac'] = _beam, _fac
def oriented6(s, flip):
    s = s.copy()
    if flip: s.rotate(V(0, 0, 0), V(1, 0, 0), 180)
    bb = s.BoundBox; s.translate(V(-(bb.XMin + bb.XMax) / 2, -(bb.YMin + bb.YMax) / 2, -bb.ZMin)); return s

NAME7, REV7 = "PhoenixABS40-43_D9aft_v7", "D9aft_v7"
report = []
L_LATCH = 24.0
LATCH_ANG = tuple(PIN_ANG)                            # 60 / 180: the old pin angles (fin gaps, one clocking)
Z_TUBE_AFT = zs(ST_BODY_AFT)                          # tube aft face = coupon frame z 0
assert abs(Z_TUBE_AFT - SHOULDER_Z) < 1e-6, (Z_TUBE_AFT, SHOULDER_Z)
DZ = V(0, 0, Z_TUBE_AFT)
COUPON_PULL = dict(g=873.0, N=873.0 * 9.81e-3, model=12.1)     # v1 L24, first pull (aft band curled: may include rub)
SECTION_STEP = os.path.join(MODELS, "PhoenixABS40-43_AftSectionSealed_v1.step")

def pin_fill(r0, r1, a):
    """Exactly the material a pin slot removed from a wall r0..r1 (fused back = slot gone)."""
    return pin_slot(a, Z_PIN).common(cyl(r1, Z_PIN - 5, Z_PIN + 5).cut(cyl(r0, Z_PIN - 6, Z_PIN + 6)))

# ---------------- AftTube v7
LG = [CPN['latch_geom'](L_LATCH, a) for a in LATCH_ANG]
for g in LG:
    for k in ('tongue', 'cut', 'bump'): g[k] = g[k].translated(DZ)
at7 = P3['AftTube']
for a in PIN_ANG: at7 = at7.fuse(pin_fill(R_ID, R_OD, a))
for g in LG: at7 = at7.cut(g['cut'])
for g in LG: at7 = at7.fuse(g['tongue'])
at7_nb = at7.removeSplitter()
for g in LG: at7 = at7.fuse(g['bump'])
at7 = at7.removeSplitter()

# ---------------- fin can v7 (v4 slotted, pins filled, windows)
def window(a):
    hw = CPN['deg'](CPN['BUMP_S'] / 2 / CPN['R_ID']) + CPN['deg'](CPN['CLR_TAN'] / CPN['CPL_R_O'])
    r0, r1 = CPL_R_I - 0.3, R_ID
    zf, za = CPN['z_win_fwd'], CPN['Z_WIN_AFT']
    return CPN['rev']([(r0, za + Z_TUBE_AFT), (r1, za + Z_TUBE_AFT), (r1, zf(r1) + Z_TUBE_AFT), (r0, zf(r0) + Z_TUBE_AFT)], a - hw, a + hw)
WIN = [window(a) for a in LATCH_ANG]
def make_fincan7(base):
    s = make_fincan(base)                             # v1 features incl. the pin slots ...
    for a in PIN_ANG: s = s.fuse(pin_fill(CPL_R_I, CPL_R_O, a))   # ... which are filled again
    for w in WIN: s = s.cut(w)
    return AR['as_solid'](s)
sec_v1 = Part.Shape(); sec_v1.read(SECTION_STEP)
sec_v1 = sec_v1.Solids[0] if len(sec_v1.Solids) == 1 else sec_v1
fc7 = make_fincan7(sec_v1)
fc7_px = make_fincan7(AR['build_sealed_section'](slots=True))
fc4_px = make_fincan(AR['build_sealed_section'](slots=True))   # v4 proxy, for the mass delta
print("v7 parts in %.1f s" % (time.time() - t7), flush=True)

# =====================================================================================
# CHECKS
# =====================================================================================
rep("== Phoenix ABS 40-43 -- %s: printed SNAP LATCH (coupon v2, L24) replaces the shear pins; everything else v6 ==" % REV7)
rep("Frame z = %.1f - station; latch geometry = coupon v2 shifted by Zf %.1f (tube aft face on the fin-can shoulder)." % (BODY_LEN, Z_TUBE_AFT))
rep("")
for k, s in (('AftTube v7', at7), ('AftFinCanSlotted v7', fc7), ('AftFinCanSlotted v7 proxy', fc7_px)):
    rep("%s %s valid, %d solid(s)" % (ok(s.isValid() and len(s.Solids) == 1), k, len(s.Solids)))
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
