ItzXyers/Rocketry/(commit log)

2026-09-17 Initial commit: import Rocketry project as-is
    [(standalone) SampleRocketABS13_PART_B_top_body.stl, (standalone) SampleRocketABS13_PART_C_launchlug.stl, AftFinCan.stl, AvBay_AftBulkhead.obj, AvBay_AftBulkhead.stl, AvBay_BatteryCradle.obj, AvBay_BatteryCradle.stl, AvBay_DuctPlug.obj]
2026-09-24 Add T4 CO2 and T5 spring ejectors, v5 nosecone, T5v2 full assembly
    - Rename Ejection System T3 -> "Ejection System T3 (LEGACY)"
    - Ejection System T4: CO2 ejector model, STEP exports, print files
    - Ejection System T5: spring ejector v1/v2, airframe integration, print files
    - PhoenixABS40-43: T5v2 full assembly v1/v2 with mass/OpenRocket reports
    - Nosecone v5 Von Kármán with aero sweep, STL/STEP and print-ready file
    - Remove stray "PhoenixABS40-43 - Copy.zip"
    [Phoenix3D_d43_servo.FCStd, Phoenix3D_d43_servo.doorfix-severed.20260915.FCStd, Phoenix3D_d43_servo.doorscaled-stillblocked.20260915.FCStd, Phoenix3D_d43_servo.preFix.20260915.FCStd, Phoenix3D_d68.FCStd, Phoenix3D_d68m.FCStd, Phoenix3D_d78_servo.FCStd, Phoenix3D_d78_tommytimer.FCStd]
2026-09-30 Add consolidated electronics BOM
    Covers the flight computer core, CO2 burn-wire and servo deployment
    variants, and the LaunchControl ground station, and flags the open items
    found while compiling it (reed switch rating, coil current vs. battery,
    servo on the 5 V rail, unassigned servo pin).
    Claude-Session: https://claude.ai/code/session_01Kj6jkkh17abFz6AAmeJUKf
2026-10-01 Add D9 aft-deploy v1-v5, avbay sled v2-v4, nosecone v6, T5 ejector v3/v4
    Includes FreeCAD sources/generators, STEP/STL exports, build reports,
    OpenRocket files, and print-ready STLs. Updates DESIGN.md and print README.
    [PhoenixABS40-43_D9aft_v1.FCStd, PhoenixABS40-43_D9aft_v1_AftFinCan.step, PhoenixABS40-43_D9aft_v1_AftFinCan.stl, PhoenixABS40-43_D9aft_v1_AftTube.step, PhoenixABS40-43_D9aft_v1_AftTube.stl, PhoenixABS40-43_D9aft_v1_FwdTube.step, PhoenixABS40-43_D9aft_v1_FwdTube.stl, PhoenixABS40-43_D9aft_v1_PinCouponInner.step]
2026-10-07 Add D9 aft-deploy v6-v10, avbay sled v5-v8, snap-latch coupons, X1C plates
    - D9aft v6-v10 generators, FCStd, STEP, reports and design notes
    (v10: sled v8 + snap latch, shear pins dropped)
    - Avionics sled v5-v8 models and build reports
    - SnapLatchCoupon v1/v2 test pieces
    - Monte Carlo / OpenRocket checks for D9aft, v6 .ork
    - Print Files: new Aft Deploy D9 STLs, Bambu X1C plates,
    superseded Ready-to-Print sets moved to _archive
    Claude-Session: https://claude.ai/code/session_01VGqwQVwHe5zBU3v4dewjTC
    [PhoenixABS40-43_D9aft_v10.FCStd, PhoenixABS40-43_D9aft_v10_AftTube.step, PhoenixABS40-43_D9aft_v10_AftTube.stl, PhoenixABS40-43_D9aft_v10_EbayCap.step, PhoenixABS40-43_D9aft_v10_EbayCap.stl, PhoenixABS40-43_D9aft_v10_ElectronicsSled_v8.stl, PhoenixABS40-43_D9aft_v10_FwdTube.step, PhoenixABS40-43_D9aft_v10_FwdTube.stl]
2026-10-08 Add rev B e-bay schematic for Phoenix 40-43 (D9aft v10 + sled v8)
    New schematic page covering every part on the sled v8 e-bay: reed SW1
    gating a Q3 AO3401 high-side switch, S7V8F5 + C1, Nano ESP32, Qwiic star
    to BMP388/ADXL375, microSD on SPI, buzzer driver, SW2/R3 interlock on D7.
    Charger, GPS and deploy channels dropped. Lists six open items (reed
    power latch, buzzer active/passive, KY-021 pull-up vs R6, VIN margin,
    SW2 placement, D6 left unconnected). avionics_wiring.md now points to it.
    Claude-Session: https://claude.ai/code/session_01GB9yNJmkb8RdHwSBFjY4ko
2026-10-08 Switch e-bay power to AO3400A low-side, add battery voltage monitor
    Schematic rev C: Q3 becomes an AO3400A N-FET in the ground return
    (BATT- -> board GND) with the reed pulling its gate to BATT+, replacing
    the AO3401 P-FET. Adds an R11/R12 100k divider + C4 into A0; with the
    low-side switch it draws nothing while the bay is off. Open items grow
    to eight (KY-021 pins reversed for this circuit, BATT- isolation rule,
    battery-reading calibration).
    Firmware 0.2.0: new battery module (ADC1 read via analogReadMilliVolts,
    averaged + EMA, generic 1S LiPo state-of-charge curve in a header-only
    battery_soc.h with a native unit test). Battery voltage is logged as
    batt_v in every CSV row, reported on /s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
    [battery.cpp, battery.h, battery_soc.h, bench_chips_main.cpp, config.h, flight_state.cpp, logger.cpp, logger.h]
2026-10-08 Make SW2 a momentary push button, latched in firmware
    No latching switches on hand, so the Wi-Fi arm interlock (SW2, D7) is
    now a push button with the same 3V3 -> button -> D7 + R3 pulldown
    wiring. wireless.cpp turns it into a toggle: a press held 1-5 s
    (WIFI_BUTTON_HOLD_MIN_MS..MAX_MS) and then released turns the interlock
    on or off. Every boot starts off; a press already held at boot, a tap,
    or a hold past the max (a line stuck at 3V3) never counts. A second
    KY-021 reed wired the same way works as a magnet-operated button from
    outside the sealed bay.
    /status replaces arm_interlock_closed with wifi_interlock_enabled and
    interlock_button_pressed; /arm's refusal reason is now interlock_off.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
    [bench_chips_main.cpp, config.h, fc_client.py, main.cpp, wireless.cpp, wireless.h]
2026-10-08 Add resistor colour-band reference for the e-bay values
    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
2026-10-08 Schematic: draw resistors with their real 5-band colours, map to stock photos
    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
2026-10-08 Use stock capacitors: C1 470 uF 16 V, battery divider 10k/10k without C4
    R11/R12 drop to 10 kOhm (5 kOhm source, so the ADC needs no filter
    cap); C4 removed. C1 becomes the on-hand 470 uF 16 V electrolytic, with
    a new open item to check the can fits the sled v8 slot.
    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
2026-10-11 Schematic rev D: AO3401A P-FET high-side power switch
    Q3 moves back to the battery's positive side: BATT+ -> Q3 -> SW_BATT ->
    U2, R6 holds the gate at BATT+ and the reed pulls it to GND. Board GND
    is the battery's negative lead again, so the BATT- isolation rule goes
    away and the KY-021 wires with its normal pin labels. The R11/R12
    divider is tapped after Q3 and still draws nothing while off. Open item
    7 is now "buy the P-FET" (AO3401A, IRLML6401 or Si2301); rev C's
    AO3400A ground-side switch stays as the stand-in until then.
    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
2026-10-11 Schematic rev E: G75P04T for Q3, BC337-40 for Q1, R1 1k
    Q3 becomes the G75P04T TO-220 P-FET (same circuit; wire by pin name,
    G-D-S with the tab on the drain). New open-item text covers its gate
    drive below the characterized -4.5 V and that it doesn't fit sled v8's
    SOT-23 slot. Q1 becomes a BC337-40 NPN with R1 raised to 1 kOhm (330 Ohm
    from stock as a stand-in); R2 stays as the base pulldown. The KY-021 is
    wired by S and - only so its 10 kOhm stays out of parallel with R6.
    Item 2 notes the ~1 kOhm across BZ1 if a plain piezo is driven with a
    tone. BOM and config.h comment follow.
    Claude-Session: https://claude.ai/code/session_01GB9yNJm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
    [config.h]
2026-10-11 SW2 is a push button inside the bay; drop the second-reed option
    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
2026-10-14 Schematic: label SW1's KY-021 pins (S, -, + not connected)
    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
2026-10-14 Add avbay sled v9/v10 (no-support print) and X1C plates for sled v10
    Sled v9: solid Nano rails after a v8 snap-arm rail broke off the plate.
    Sled v10: reworked so it prints with no support (v9 spaghettified over
    the piezo, the reed module and under the I-beam). New overhang audit
    (avbay_overhang_audit.py): 1230 -> 389 mm2 of downward-facing area.
    - ADXL375 glued flat on the battery tray back, on an aft-edge ledge
    - BMP388 on the east side, 2x M2.5 into a new pier; use its aft Qwiic plug
    - microSD reader (26x23x4) on edge on the spine side
    - battery zip tie runs sideways through tray-wall windows
    - reed board slides in axially from the cap end into printed guides
    - Nano backing plate with an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
    [PhoenixABS40-43_ElectronicsSled_v10.stl, PhoenixABS40-43_ElectronicsSled_v8.stl, PhoenixABS40-43_ElectronicsSled_v9.stl, PhoenixABS40-43_avbay_ElectronicsSled_v10.step, PhoenixABS40-43_avbay_ElectronicsSled_v10.stl, PhoenixABS40-43_avbay_ElectronicsSled_v9.step, PhoenixABS40-43_avbay_ElectronicsSled_v9.stl, PhoenixABS40-43_avbay_sled_ASSEMBLY_v10.stl]
2026-10-15 Add D9-5 altitude/velocity vs time plot for PhoenixABS40-43 D9aft v6
    Extracts the stored OpenRocket flight data from the .ork and plots it.
    Claude-Session: https://claude.ai/code/session_01FiJzXADULUTvHJmPbCMdDF
2026-10-15 Schematic: BZ1 module wired by S and -, middle pin not connected
    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
2026-10-19 Flight computer: internal-flash log, drop SW1/SW2/SD and deploy channel
    The harness as soldered 2026-10-19 has no reed switch (SW1, Q3/R6), no
    Wi-Fi button (SW2/R3) and no microSD reader, and the burn wire is gone
    (Phoenix deploys on the motor ejection charge). Firmware 0.2.3:
    - Log to the Nano ESP32's internal FFat partition instead of SD: one
    FLIGHTnnn.CSV per boot, never formats on a failed mount, self-test fails
    below 5 MB free. 5 Hz on the pad/landed, full rate in flight, plus
    200 Hz accel-only rows during ascent.
    - Logs retrievable over USB serial (LOGS, DUMP n, DEL n, FORMAT YES) and
    Wi-Fi (GET /logs, /log?n=).
    - Wi-Fi AP comes up at boot (no SW2); still latches off after /ar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
    [battery.h, bench_buzzer_main.cpp, bench_chips_main.cpp, bench_wifi_main.cpp, buzzer.h, config.h, config.py, fc_client.py]
2026-10-21 PhoenixABS40-43: e-bay sled v11-v19, D9aft v11, new X1C print plates
    [PhoenixABS40-43_D9aft_v11.FCStd, PhoenixABS40-43_D9aft_v11_AftFinCanSlotted.step, PhoenixABS40-43_D9aft_v11_AftFinCanSlotted.stl, PhoenixABS40-43_D9aft_v11_AftTube.step, PhoenixABS40-43_D9aft_v11_AftTube.stl, PhoenixABS40-43_D9aft_v4_Fin.stl, PhoenixABS40-43_D9aft_v6_EbayCap.stl, PhoenixABS40-43_D9aft_v8_FwdTube.stl]
2026-10-29 PhoenixABS40-43: sled v20-v21, D9aft v12-v13 extension ring, launch pad v2
    - E-bay sled v20 (slack chamber) and v21 (card slots, J-hook ladders, TopKeeper)
    - D9aft v12/v13 screw-in extension ring (+16/+30 mm), OpenRocket files
    - Launch pad v2 with StopPost, BlastPlate v2
    - New X1C print plates 14-23 and make_bambu_projects v7-v10
    - OrStab.java tool
    [PhoenixABS40-43_BlastPlate_v2.step, PhoenixABS40-43_D9aft_v12.FCStd, PhoenixABS40-43_D9aft_v12_ExtensionRing.step, PhoenixABS40-43_D9aft_v12_ExtensionRing.stl, PhoenixABS40-43_D9aft_v13.FCStd, PhoenixABS40-43_D9aft_v13_ExtensionRing.step, PhoenixABS40-43_D9aft_v13_ExtensionRing.stl, PhoenixABS40-43_ElectronicsSled_v20.stl]
2026-11-13 Firmware: battfind_bench env to locate the battery-sense divider pin
    Scans every ADC-capable Nano ESP32 pin for a stiff, quiet ~half-cell
    voltage (internal pull-up/down barely moves a 5k divider, but swings a
    floating pin) and prints the PIN_BATT_SENSE line for config.h. WATCH mode
    shows which pin follows the battery being unplugged.
    Claude-Session: https://claude.ai/code/session_017u9KiwhjQEuFM6PcxyRp7Z
    [bench_battfind_main.cpp]
2026-11-13 battfind_bench: scan only A0-A7; clarify USB + battery can both be plugged in
    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
2026-11-13 Firmware 0.3.0: arm sounds + browser ground console
    Buzzer: ARM_CONFIRM (beep-beep-beeeep) hands over to ARMED_REMINDER
    (double chirp every ~4 s, silenced at BOOST); ARM_REJECTED (five fast
    blips) resumes whatever was looping before, so it never silences the
    self-test fail alarm. /arm chirps once on receipt before the blocking
    re-zero.
    Wireless: GET / now serves a self-contained console page (status,
    battery, arm checks + ARM button, per-log Download/Delete). The old
    identity JSON moved to /info. New GET /logs.json and
    POST /log/delete?n= (refuses this boot's file; ground states only).
    Bench tools gain ARM/ARMED/REJECT buzzer commands; checklists updated.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
    [bench_buzzer_main.cpp, bench_chips_main.cpp, buzzer.cpp, buzzer.h, config.h, flight_state.cpp, logger.cpp, logger.h]
2026-11-13 Single arm beep; battery sense on A7, sampled only with Wi-Fi off
    - ARM_CONFIRM is now a one-shot beep-beep-beeeep; the repeating
    ARMED_REMINDER chirp is gone. Landing still starts RECOVERY_BEACON.
    - PIN_BATT_SENSE moves to A7 (GPIO14, ADC2). ADC2 is shared with the
    Wi-Fi radio on the ESP32-S3, so battery.cpp takes a fresh reading
    right before the AP comes up, holds it while the AP is up, and
    re-seeds once the radio is latched off (arm / BOOST). /status gains
    batt_held and batt_age_ms; the console shows how old the reading is.
    - Schematic, BOM, wiring notes and bench tools updated to A7.
    Claude-Session: https://claude.ai/code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
2026-11-13 Firmware 0.3.1: launch threshold 2.0 g, BOOST backup timer, longer coast floor
    - LAUNCH_ACCEL_THRESHOLD_G 3.0 -> 2.0: the D9 sustains only ~3.0-3.4 g on
    Phoenix, inside the ADXL375 offset error
    - BOOST_MAX_TIME_MS (5 s): force BOOST -> COAST (COAST_TIMEOUT event) if
    accel never falls below the burnout threshold; exposed in /config
    - MIN_COAST_TIME_MS 2000 -> 3000 to exceed the D9 burn time
    Claude-Session: https://claude.ai/code/session_017u9KixiaXBr7o3qLZrTyLM
    [config.h, flight_state.cpp, wireless.cpp]
